mateusalgado/IFSC_ELP2/README.md

# IFSC – Eletrônica de Potência II (EPO II) – 2026-2

Aluno: Mateus Salgado Barboza Costa · Prof. Joabel Moia · Engenharia Eletrônica, IFSC Florianópolis.

| Pasta | Conteúdo | Entrega |
|---|---|---|
| `00_Disciplina/` | enunciados do projeto semestral e da Tarefa Extra (os slides das aulas e o plano de ensino ficam só na cópia local, fora do git) | — |
| `Tarefa_01_Calculo_Termico_Dissipador/` | Buck: perdas, cálculo térmico e escolha de dissipador (PSIM, SMath, Python) | `RELATORIO_MATEUS_SALGADO_TAREFA1.pdf` |
| `Tarefa_02_Projeto_Conversor_Estatico/` | Buck: metodologia da Aula 03, escolha de semicondutores e capacitor, perdas | `RELATORIO_MATEUS_SALGADO_TAREFA2.pdf` |
| `Tarefa_03_Projeto_Indutor_Alta_Frequencia/` | indutor toroidal de alta frequência (SMath, planilha Magnetics) | `RELATORIO_MATEUS_SALGADO_TAREFA3.pdf` |
| `Projeto_Flyback/` | **Projeto semestral (Tema II):** fonte flyback 12 V / 3 A, entrada universal, UC3845 — cálculos, simulação LTspice, esquemático e placa KiCad, BOM, relatório, apresentação, guia de montagem e protótipo (Possibilidade II). Revisão B vigente; revisão A completa em `revisoes/RevA_2026-10-19/` | `06_Relatorio/RELATORIO_MATEUS_SALGADO_PROJETO.pdf`, `07_Apresentacao/APRESENTACAO_MATEUS_SALGADO_PROJETO.pdf` |

Índice detalhado do projeto, resultados e comandos de regeneração: [`Projeto_Flyback/README.md`](Projeto_Flyback/README.md).

Os resultados brutos do LTspice (`.raw`, 11 GB) não ficam no repositório: estão em `C:\Users\mateu\ELP2_sim_runs` e são regenerados por `Projeto_Flyback/03_Simulacao/executa_b.py`.
