mateusalgado/IFSC_ELP2/Projeto_Flyback/06_Relatorio/tabelas/criterios.md

| Critério | Resultado | Situação |
|---|---|---|
| Vo em ±5 % (11,4–12,6 V) para 90–264 VAC e 10–100 % de carga [S] | 12,06 – 12,06 V | atende |
| Ondulação ≤ 120 mV p-p: de chaveamento e excursão total em ciclos da rede [S] | ≤ 4,8 mV / ≤ 8,5 mV | atende |
| Vds máx ≤ 520 V (80 % de 650 V) em regime, 264 VAC [S] | 482 V (Llk 2 %) / 497 V (Llk 3 %); sem grampo 854 V | atende |
| Vds máx em falha (curto) – margem específica: ≤ 600 V (92 % de 650 V, pulso) [S] | 560 V na aplicação, 423 V sustentado | atende |
| Ip ≤ limite do Rsense (2,6–2,9 A) em regime [S] | 2,06 A em 90 VAC | atende |
| Δ teoria × simulação ≤ 10 % nos esforços (critério estrito) [C×S] | 23 de 48 comparações fora de ±10 % — Is,pk: 5 pontos (10/100 % de carga), -24 a +10 %; Is,rms: 12 pontos (10/50/100 % de carga), -16 a -10 %; Vds: 6 pontos (10/50 % de carga), -21 a -11 %. I<sub>p</sub> dentro de 10 % em todos os pontos | atende com ressalva (hipóteses do cálculo: triângulo ideal no vale de Vbulk, grampo a 1,8·Vr) |
| Margem de fase ≥ 45° com pós-filtro LC e polo do opto no modelo [C]; degraus sem oscilação [S] | MF = 88° / 86° / 86° / 90° (fc 0,25–1,35 kHz); degraus: desvio ≤ 116 mV, dentro de ±1 %, retorno a ±0,5 % em ≤ 4,4 ms sem oscilação | atende |
| Partida a frio sem sobretensão [S] | Vo máx 12,06 / 12,06 V; VCC mín 8,30 V > 7,6 V | atende |
| Curto sustentado: desligamento por UVLO (hiccup) [C e S] | VCC mín no curto 7,60 V (C: UVLO em 151 ms a 220 V); I(D1) rms sustentado 13,1 A | atende |
| Rendimento em 220 V: meta 85 % / cálculo 83 % [S] | 85,2 % (90 V: 82,6 %) | atende a meta |
