mateusalgado/IFSC_ELP2/Projeto_Flyback/06_Relatorio/tabelas/perdas.md

| Vac | Vbulk mín C (V) | Vbulk mín S (V) | I in,rms C (A) | I in,rms S (A) | P MOSFET C (W) | P MOSFET S (W) | P diodo C (W) | P diodo S (W) | P snubber C (W) | P snubber S (W) | P ponte C (W) | P ponte S (W) | η C (%) | η S (%) |
|---|---|---|---|---|---|---|---|---|---|---|---|---|---|---|
| 90 | 104,1 | 103,9 | 0,89 | 0,81 | 0,98 | 0,48 | 1,78 | 1,72 | 2,02 | 1,54 | 0,67 | 0,63 | 81,9 | 82,6 |
| 127 | 161,9 | 163,0 | 0,70 | 0,63 | 0,98 | 0,50 | 1,78 | 1,72 | 2,02 | 1,47 | 0,45 | 0,42 | 83,0 | 84,7 |
| 220 | 299,1 | 298,8 | 0,48 | 0,43 | 1,15 | 0,76 | 1,78 | 1,72 | 2,02 | 1,33 | 0,24 | 0,24 | 83,0 | 85,2 |
| 264 | 362,7 | 361,9 | 0,43 | 0,39 | 1,15 | 0,95 | 1,78 | 1,72 | 2,02 | 1,27 | 0,20 | 0,20 | 82,7 | 84,6 |
