mateusalgado/IFSC_ELP2/Projeto_Flyback/06_Relatorio/tabelas/transitorios.md

| Caso (S) | Resultado |
|---|---|
| Partida a frio em 90 VAC, plena carga (C1 e C5 descarregados, fase da rede do cruzamento do UVLO) | pré-carga até 8,4 V em 7,34 s com V<sub>bulk</sub> = 126 V; VCC mínimo após o UVLO 8,30 V; V<sub>o</sub> ≥ 11,4 V em 5,3 ms; V<sub>o</sub> máx 12,06 V; I<sub>p</sub> máx 3,10 A; V<sub>ds</sub> máx 274 V |
| Partida a frio em 264 VAC, plena carga | pré-carga até 8,4 V em 1,05 s com V<sub>bulk</sub> = 371 V; VCC mínimo após o UVLO 8,32 V; V<sub>o</sub> ≥ 11,4 V em 4,3 ms; V<sub>o</sub> máx 12,06 V; I<sub>p</sub> máx 3,47 A; V<sub>ds</sub> máx 515 V |
| Degraus 50 → 100 % (80 ms) e 100 → 50 % (100 ms) em 90 VAC | subida: 12,06 → mín 11,95 V (-114 mV), não sai de ±1 %, volta a ±0,5 % em 4,4 ms; descida: máx 12,16 V (+115 mV), não sai de ±1 %, volta a ±0,5 % em 3,8 ms; V<sub>o</sub> na janela 80–120 ms: 11,95–12,16 V; I<sub>p</sub> máx 2,06 A |
| Degraus 50 → 100 % e 100 → 50 % em 264 VAC | subida: 12,06 → mín 11,95 V (-113 mV), não sai de ±1 %, volta a ±0,5 % em 4,4 ms; descida: máx 12,16 V (+116 mV), não sai de ±1 %, volta a ±0,5 % em 3,9 ms; V<sub>o</sub> na janela 80–120 ms: 11,95–12,16 V; I<sub>p</sub> máx 2,07 A |
| Degraus em 90 VAC com CTR = 0,5 (pior opto) | subida: 12,07 → mín 11,87 V (-199 mV), retorno a ±1 % em 4,1 ms (±0,5 % em 8,0 ms); descida: máx 12,24 V (+202 mV), retorno a ±1 % em 3,5 ms (±0,5 % em 8,0 ms); V<sub>o</sub> na janela 80–120 ms: 11,87–12,24 V; I<sub>p</sub> máx 2,06 A |
| Tolerância do barramento: C1 = 120 µF (−20 %) em 90 VAC/50 Hz, plena carga | V<sub>bulk</sub> mín 99,7 V; V<sub>o</sub> 12,06 V; I<sub>p</sub> máx 2,06 A; η 82,6 % |
| Sem grampo RCD, 264 VAC, plena carga | V<sub>ds</sub> máx 854 V; V<sub>rev</sub> D1 86 V; P snubber 0,00 W; I<sub>p</sub> 2,05 A |
| L<sub>lk</sub> = 3 % de L<sub>p</sub> (projeto 2 %), 264 VAC, plena carga | V<sub>ds</sub> máx 497 V; V<sub>rev</sub> D1 89 V; P snubber 1,64 W; I<sub>p</sub> 2,09 A |
