mateusalgado/IFSC_ELP2/Projeto_Flyback/revisoes/RevA_2026-10-19/06_Relatorio/tabelas/criterios.md

| Critério | Resultado | Situação |
|---|---|---|
| Vo em ±5 % (11,4–12,6 V) para 90–264 VAC e 10–100 % de carga | 12,07 – 12,08 V | atende |
| Ondulação de saída ≤ 120 mV p-p | ≤ 4,0 mV (após o pós-filtro LC) | atende |
| Vds máx ≤ 80 % de 650 V (520 V) em 264 VAC | 482 V (Llk 2 %) / 496 V (Llk 3 %) ; sem snubber 828 V | atende (snubber obrigatório) |
| Ip ≤ limite do Rsense (2,7–3,0 A) | 2,07 A em 90 VAC | atende |
| Δ teoria × simulação < 10 % nos esforços | Ip −3,5 %, Is,pk +5,7 %, Is,rms −10,3 %, Vds −5 a −6 % | atende (Is,rms no limite: forma de onda em MCD com patamar de grampo) |
| Margem de fase ≥ 45° (degrau de carga sem oscilação) | MF = 99° (teoria); degraus 50↔100 % sem oscilação, ΔVo < 15 mV | atende |
| Partida sem sobretensão em 90 e 264 VAC | Vo máx 12,06 / 12,06 V | atende |
| Curto-circuito limitado pelo Rsense | Ip 4,28 A transitório, hiccup; Is,rms 17,5 A no diodo (limitação a documentar) | atende com ressalva |
| Rendimento ≥ 85 % (meta) / 82 % (hipótese de cálculo) | sim.: 83,3 % (90 V) a 85,5 % (220 V); teoria 81,9–83,0 % | atende a hipótese; meta de 85 % só em 127–264 V |
