mateusalgado/IFSC_ELP2/Projeto_Flyback/revisoes/RevA_2026-10-19/06_Relatorio/tabelas/perdas.md

| Vac | Vbulk mín teoria (V) | Vbulk mín sim (V) | I in,rms teoria (A) | I in,rms sim (A) | P MOSFET teoria (W) | P MOSFET sim (W) | P diodo teoria (W) | P diodo sim (W) | P snubber teoria (W) | P snubber sim (W) | P ponte teoria (W) | P ponte sim (W) | η teoria (%) | η sim (%) |
|---|---|---|---|---|---|---|---|---|---|---|---|---|---|---|
| 90 | 94,6 | 95,6 | 0,86 | 0,80 | 1,04 | 0,38 | 1,78 | 1,72 | 2,01 | 1,49 | 0,69 | 0,65 | 81,9 | 83,3 |
| 127 | 155,2 | 158,7 | 0,68 | 0,63 | 1,04 | 0,44 | 1,78 | 1,72 | 2,01 | 1,43 | 0,45 | 0,43 | 82,9 | 85,2 |
| 220 | 295,4 | 296,6 | 0,47 | 0,44 | 1,15 | 0,72 | 1,78 | 1,72 | 2,01 | 1,29 | 0,24 | 0,24 | 83,0 | 85,5 |
| 264 | 359,6 | 360,3 | 0,42 | 0,39 | 1,15 | 0,92 | 1,78 | 1,72 | 2,01 | 1,24 | 0,20 | 0,20 | 82,7 | 84,8 |
