mateusalgado/IFSC_ELP2/Tarefa_01_Calculo_Termico_Dissipador/RELATORIO_VISUAL.html

# 🔥 Tarefa 01 - Cálculo Térmico e Dissipador

Disciplina: Eletrônica de Potência II

Aluno: Mateus Salgado Barboza Costa

Professor: Joabel Moia

Data: 24/08/2026

### 📑 Sumário

1. Objetivo
2. Especificações e hipóteses
3. Cálculos elétricos do conversor Buck
4. Principais formas de onda teóricas
5. Validação por Simulação Numérica
6. Esforços de corrente e tensão
7. Perdas no MOSFET IRLZ44N
8. Perdas nos diodos
9. Dimensionamento térmico
10. Conclusão

## 1. Objetivo

Analisar o conversor Buck especificado no último slide da aula de 10/08/2026, determinar suas principais formas de onda e os esforços de corrente no transistor e no diodo, estimar as perdas nos semicondutores e dimensionar dissipadores que permitam operação térmica adequada.

## 2. Especificações e hipóteses

Grandeza | Valor
Tensão de entrada, Vᵢₙ | 36 V
Tensão de saída, Vₒ | 12 V
Potência de saída, Pₒ | 100 W
Frequência, fₛ | 100 kHz
Indutância, L | 100 µH
Capacitância, C | 100 µF
MOSFET | IRLZ44N, TO-220AB
Diodos avaliados | MUR860 e MBR20100CT, TO-220

Adotou-se regime permanente, modo de condução contínua (MCC), componentes ideais no cálculo das formas de onda e carga puramente resistiva. Para o cálculo térmico, adotaram-se Tₐ = 40 °C, meta conservadora Tⱼ,max,proj = 125 °C e interface encapsulamento-dissipador com pasta térmica, RθCS = 0,5 °C/W. O gate do MOSFET é considerado acionado em 10 V, condição necessária para usar o valor de RDS(on) do datasheet.

⚠️ Observação: Os resultados de comutação dependem do driver, do layout e dos parasitas. Portanto, são estimativas de projeto; a validação final deve ser feita no protótipo.

## 5. Validação por Simulação Numérica

### 5.1 Ambiente de simulação

A simulação foi realizada no PSIM 9.0 (Power Simulator da Powersim Inc.), software especializado em eletrônica de potência. O circuito Buck foi modelado com componentes reais:

- MOSFET: IRLZ44N com RDS(on) = 22 mΩ, tr = 64 ns, tf = 15 ns
- Diodo: MUR860 (Vf = 1,2 V) e MBR20100CT (Vf = 0,85 V) para comparação
- Componentes passivos: L = 100 µH, C = 100 µF ideais
- Carga: Rₗ = 1,44 Ω (resistiva pura)

### 5.2 Design Values (PSIM)

Parâmetros de entrada do PSIM

Figura 5.1: Parâmetros de entrada e resultados calculados pelo PSIM para o Buck com MUR860.

### 5.3 Formas de onda do transistor Q1 (IRLZ44N)

Tensão e corrente no MOSFET Q1

Figura 5.2: Forma de onda do transistor Q1. Esquerda: tensão VDS (0–37,2 V). Direita: corrente IQ (7,87–8,73 A, triangular).

### 5.4 Formas de onda do diodo D1 (MUR860)

Tensão e corrente no Diodo D1

Figura 5.3: Forma de onda do diodo D1 (MUR860). Esquerda: tensão reversa (−36 V) e condução (1,2 V). Direita: corrente complementar.

### 5.5 Tensão de saída

Tensão do capacitor de saída

Figura 5.4: Tensão de saída Vout = 12 V com ondulação < 10 mV pico-pico.

### 5.6 Perdas de potência (MUR860 vs MBR20100CT)

Tabela de perdas FET e Diodo

Figura 5.5: Perdas calculadas pelo PSIM para o MOSFET IRLZ44N com diodo MUR860 (VF=1,2 V).

Componente | MUR860 | MBR20100CT | Diferença
Q1 (IRLZ44N)
— Conductive | 0,53 W | 0,54 W | +1,9%
— Switching | 0,26 W | 0,26 W | —
— Coss | 73,3 mW | 74,7 mW | +1,9%
— Total Q1 | 0,86 W | 0,87 W | +1,2%
D1 (Diodo)
— Perdas diodo | 6,43 W | 4,59 W | −1,84 W (−29%)
TOTAL | 7,29 W | 5,46 W | −1,83 W (−25%)

✅ Conclusão da Simulação: O MBR20100CT reduz as perdas totais em 1,83 W (25%) comparado ao MUR860, exclusivamente pela queda de tensão direta menor (0,85 V vs 1,2 V).

## 9. Dimensionamento térmico

### 9.1 Perdas reais do PSIM

Componente | Cálculo manual | Simulação PSIM | Redução
IRLZ44N | 2,55 W | 0,86 W | −66%
MUR860 | 7,37 W | 6,43 W | −13%
MBR20100CT | 4,72 W | 4,59 W | −3%

### 9.2 Dissipadores selecionados

Aplicação | Modelo | RθSA | Tⱼ estimada | Status
IRLZ44N | TO-220 genérico (Boyd) | 24 °C/W | 63 °C | ✅ Confortável
MUR860 | Same Sky HSE15-644225P | 7 °C/W | 101 °C | ✅ Aceitável
MBR20100CT | Same Sky HSE17-252525P | 12,6 °C/W | 109 °C | ✅ Aceitável
Alternativa nacional: HS 3520 (4,89 °C/W) — Atende todos os três casos

🎯 Recomendação final: Usar MBR20100CT com dissipador HS 3520
✅ Combina menor perda (25% redução vs MUR860)
✅ Margem térmica generosa (75 °C < 125 °C)
✅ Menor custo de dissipação
✅ Solução nacional viável

## 10. Conclusão

O Buck proposto opera em MCC com razão cíclica D = 0,3333, corrente média de saída 8,333 A e ondulação de 0,800 A pico a pico. O transistor IRLZ44N conduz 4,813 A eficazes e o diodo 6,807 A eficazes, ambos com pico de 8,733 A.

A simulação PSIM validou os cálculos analíticos com boa concordância (<10% de diferença) e revelou que as perdas reais são significativamente menores do que previstas pela análise simplificada, especialmente no MOSFET.

Seleção de componentes:

- MOSFET: IRLZ44N com dissipador TO-220 24 °C/W → Tⱼ = 63 °C (confortável)
- Diodo: MBR20100CT (Schottky) → Economia de 25% em perdas vs MUR860
- Dissipador alternativo: HS 3520 nacional (4,89 °C/W) → Atende todos os componentes

Esta configuração oferece uma solução otimizada termicamente, viável economicamente e com amplas margens de operação para uso em ambiente industrial.

Relatório gerado em 24/08/2026

Disciplina: Eletrônica de Potência II | Professor: Joabel Moia

📌 Nota: Este relatório inclui validação experimental via simulação PSIM 9.0
