mateusalgado/IFSC_ELP2/00_Disciplina/Aula_02_Perdas_Dissipadores.pdf

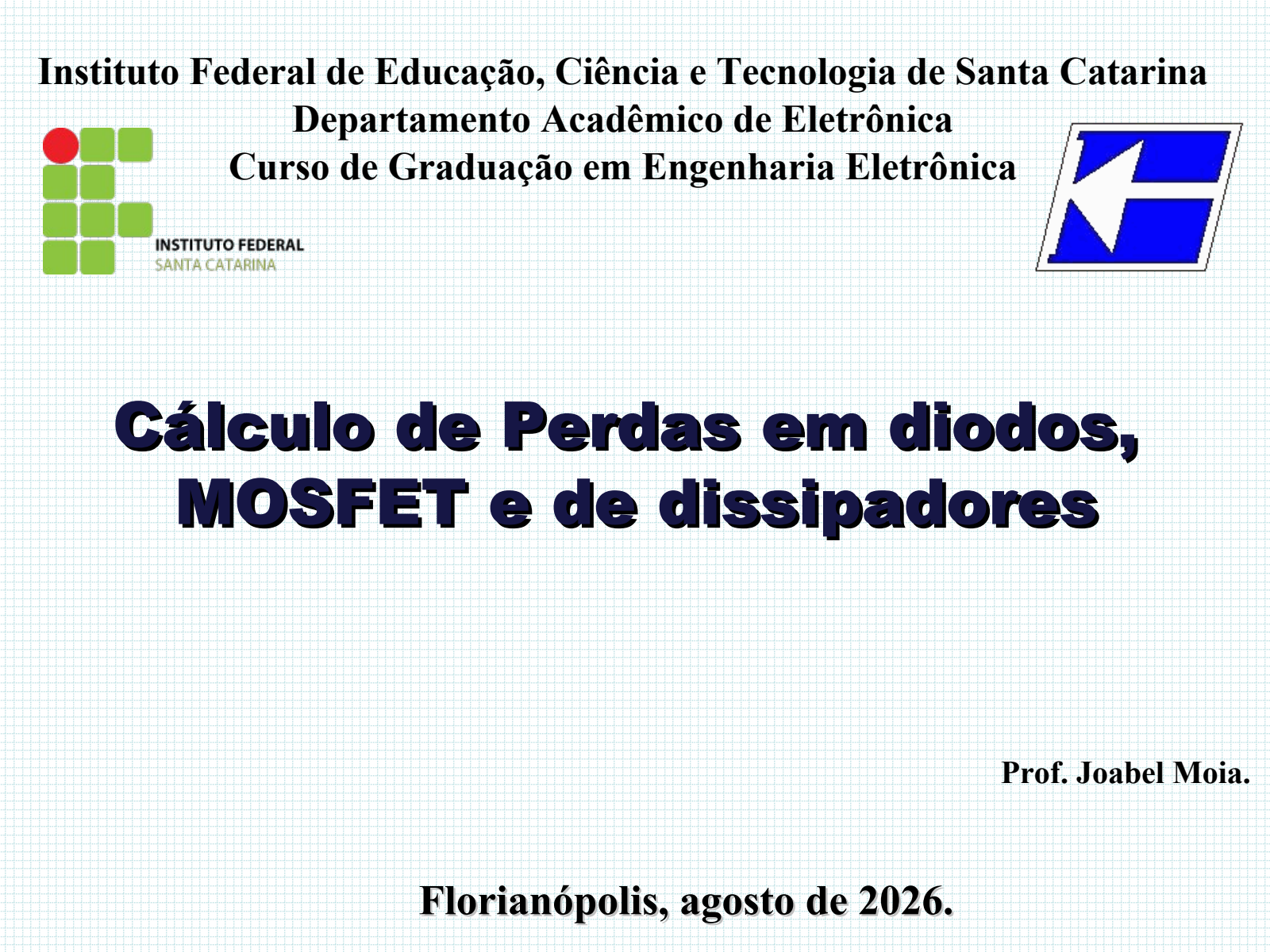
[picture p69: page 1]

Cálculo de Perdas em diodos,

# MOSFET e de dissipadores

### Instituto Federal de Educação, Ciência e Tecnologia de Santa Catarina Departamento Acadêmico de Eletrônica Curso de Graduação em Engenharia Eletrônica

Florianópolis, agosto de 2026.

Prof. Joabel Moia.

## Bibliografia para esta aula

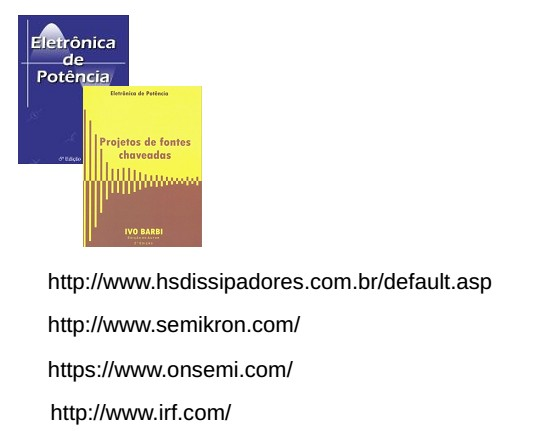
[picture p70: figure]

# Diodo ideal e real

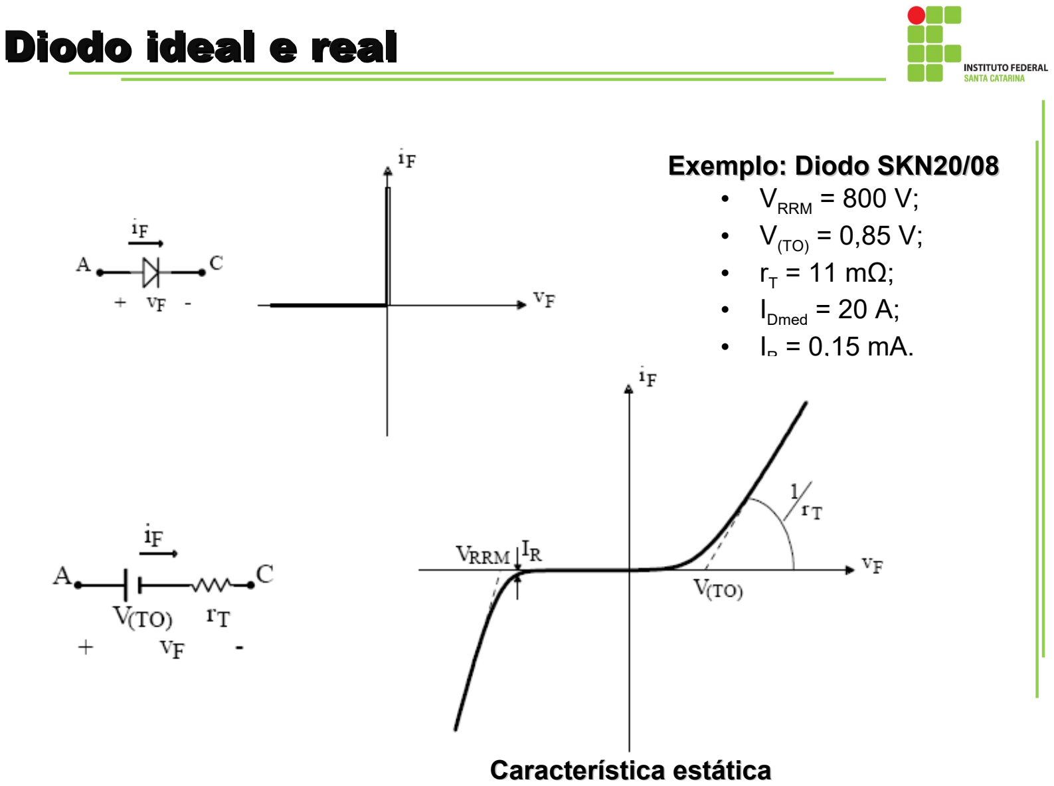
[picture p71: page 3]

Exemplo: Diodo SKN20/08
- VRRM = 800 V;
- V(TO) = 0,85 V;
- rT

= 11 mΩ;
- IDmed = 20 A;
- IR

= 0,15 mA.

Característica estática

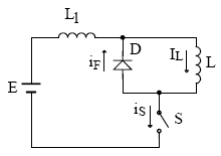
[picture p72: figure]
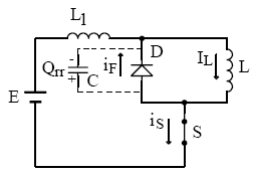
[picture p73: figure]
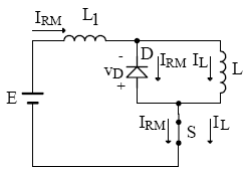
[picture p74: figure]

Primeira etapa de comutação | Segunda etapa de comutação

Circuito para estudo da comutação

Bloqueio

# Diodo real - comutação

Bloqueio

# Diodo real - comutação

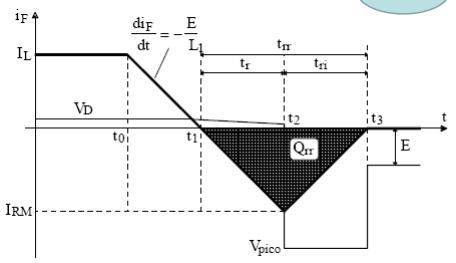
[picture p75: figure]

1

F

di | E
dt | L

= -

No bloqueio do diodo (comutação crítica):

Derivada da corrente depende da indutância

3 rr

rr
F

Q
t
di
dt
æ | | | ö
ç | ÷ ≅
ç | ÷ ç | ÷ è | ø

4
3

F
RM | rr
di I | Q
dt
æ | | ö
≅ ç | ÷ è | ø

Tempo de recuperação reversa

Corrente máxima devido a recuperação reversa

Bloqueio

# Diodo real - comutação

Classificação das perdas:
1.Condução;

2.Comutação:
- Entrada em condução;
- Bloqueio.
2 P V | I | r I = | · | + · ( | ) TO | Dmed | T | Def
P | V | V I t f 1
= | - | · · 0,5( FP | F | o | rf )

### P Q E f 2

= · ·
rr

# Perdas nos diodos

P | V | V I t f 1

# Perdas nos diodos

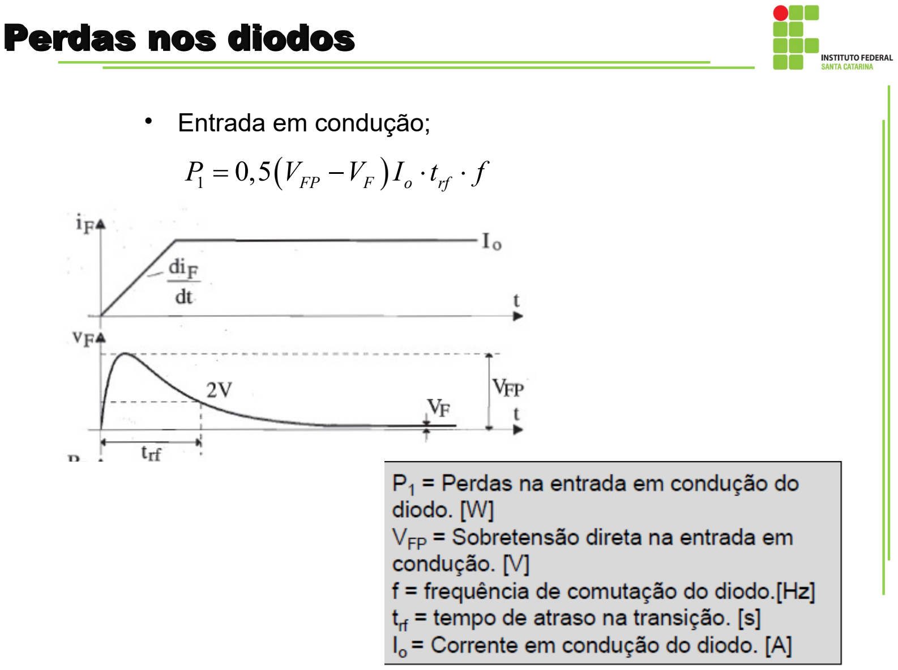
[picture p76: page 8]

- Entrada em condução;
= | - | · · 0,5( FP | F | o | rf )

# Diodo real - comutação

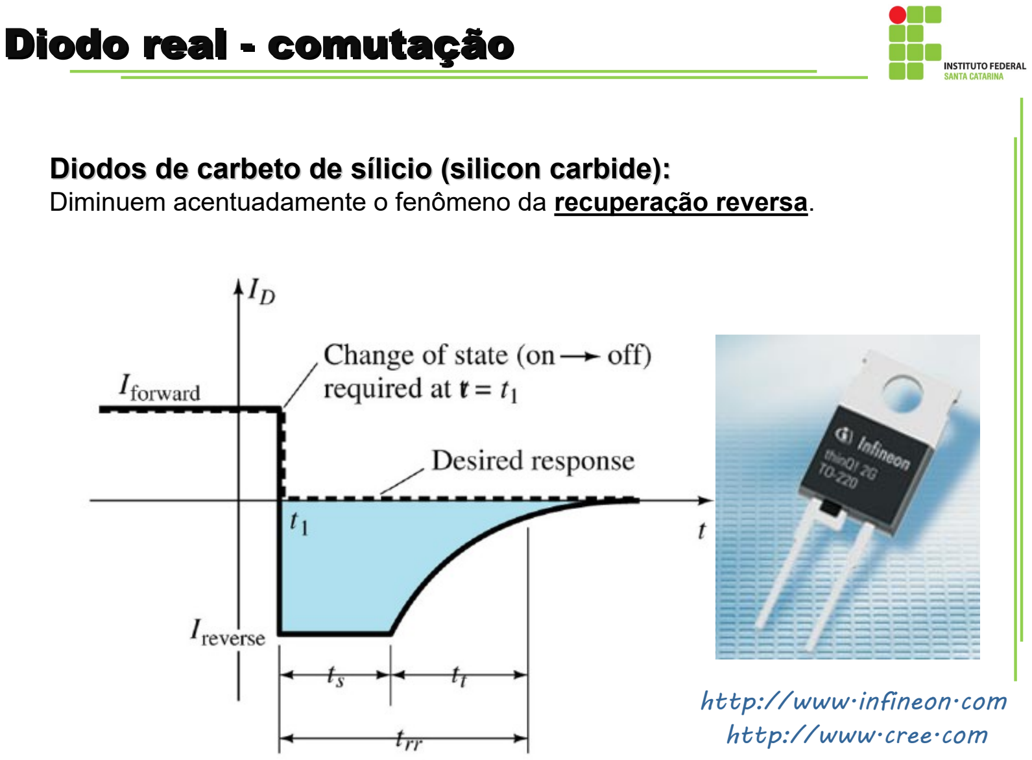
[picture p77: page 9]

Diodos de carbeto de sílicio (silicon carbide):
Diminuem acentuadamente o fenômeno da recuperação reversa.

### http://www.infineon.com http://www.cree.com

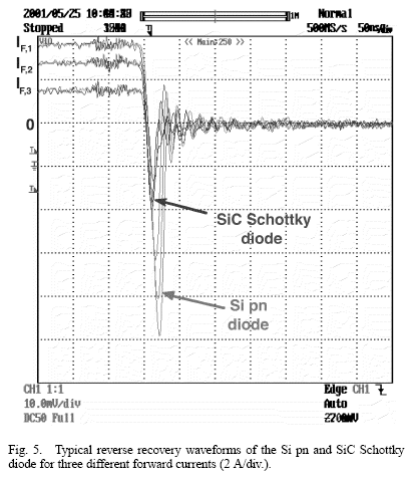
[picture p78: figure]

### http://powerelec.ece.utk.edu/pubs/pels_letters_SiC_june_2003.pdf

# Diodo real - comutação

# Diodo real - comutação

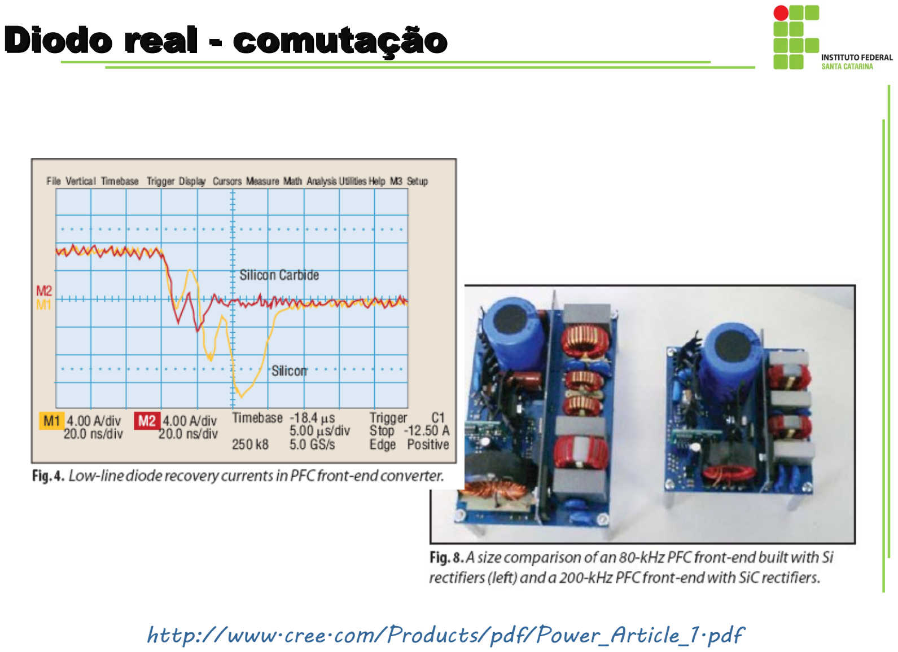
[picture p79: page 11]

### http://www.cree.com/Products/pdf/Power_Article_1.pdf

# Diodo real - comutação

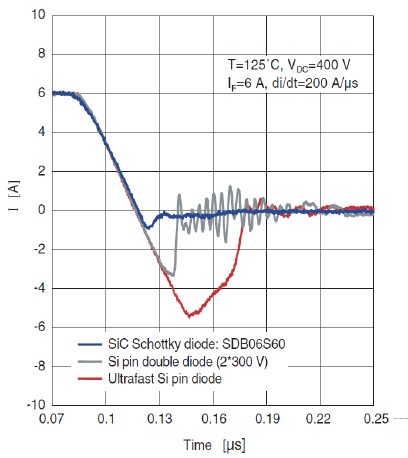
[picture p80: figure]

# Diodos

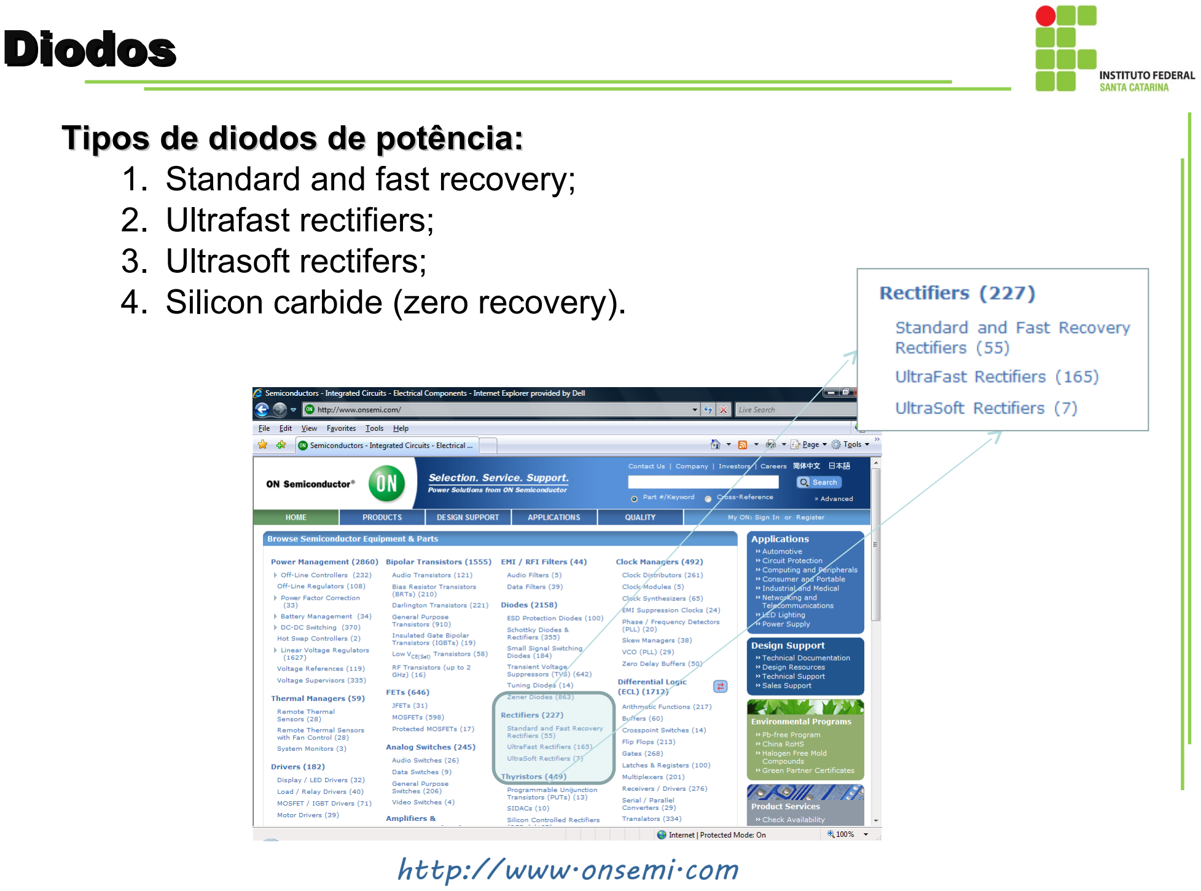
[picture p81: page 13]

Tipos de diodos de potência:
1. Standard and fast recovery;
2. Ultrafast rectifiers;
3. Ultrasoft rectifers;
4. Silicon carbide (zero recovery).

### http://www.onsemi.com

Tipos de diodos de potência:
1. Standard and fast recovery;
2. Ultrafast rectifiers;
3. Ultrasoft rectifers;
4. Silicon carbide (zero recovery).

# Diodos

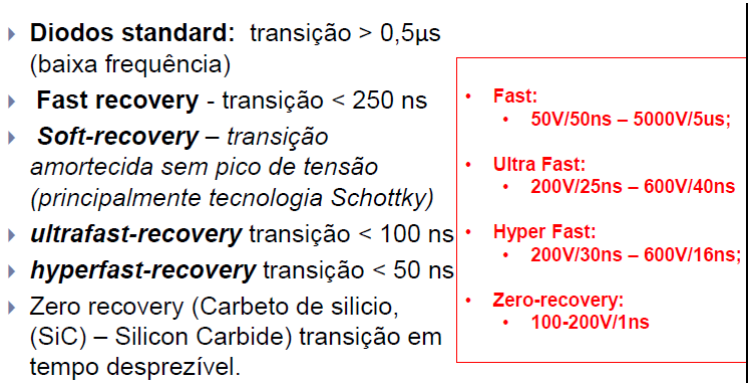
[picture p82: figure]

Perdas Potais do diodo: Perdas por condução + Perda por Comutação:

Devido as perdas na entrada em condução serem muito baixas, são desconsideradas. Assim, tem-se:

Perdas totais do diodo:

### 2 P Q E f 2

= | · ·
rr | P V | I | r I = | · | + · ( | ) TO | Dmed | T | Def

# Perdas nos diodos

+

Alguns diodos por ter baixo tempo de recuperação reversa, são des-consideras as perdas por comutação, caso do diodo Schottky e SiC

# MOSFET de potência

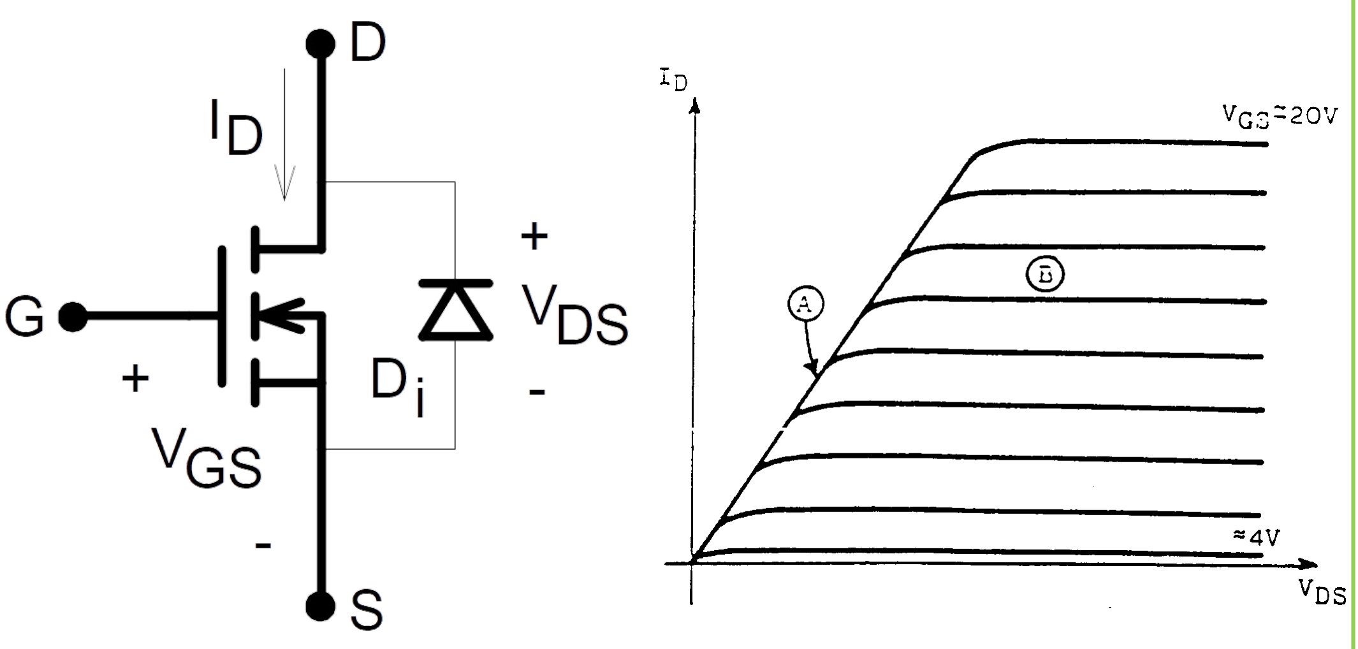
[picture p83: figure]

# MOSFET de potência

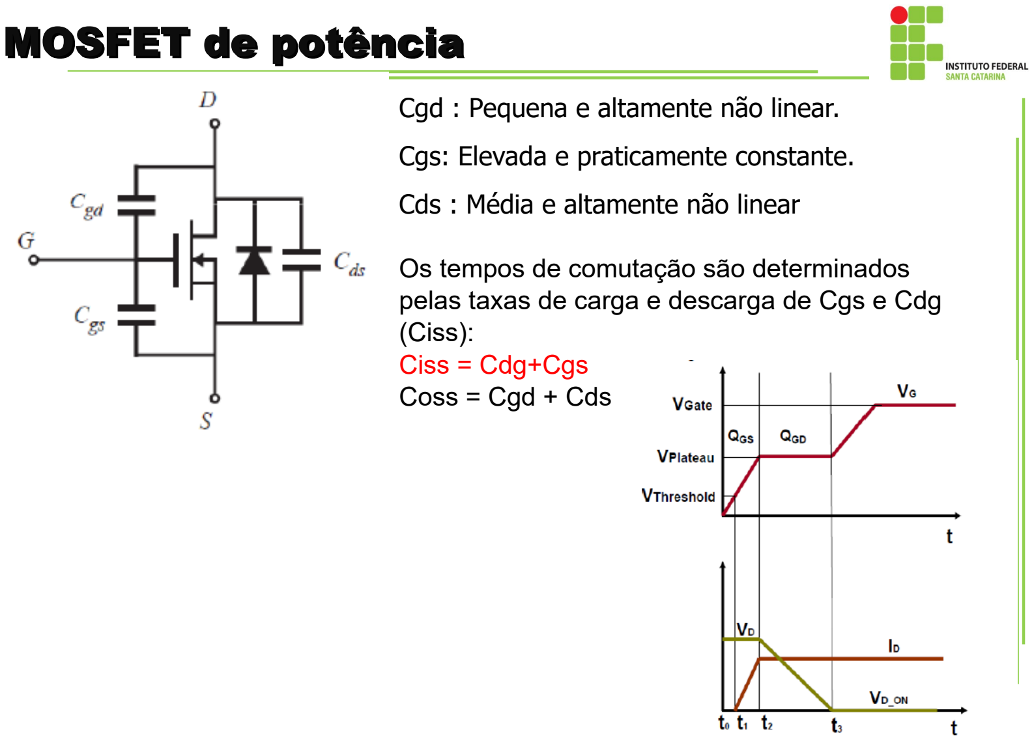
[picture p84: page 17]

Cgd : Pequena e altamente não linear. Cgs: Elevada e praticamente constante.
Cds : Média e altamente não linear

Os tempos de comutação são determinados pelas taxas de carga e descarga de Cgs e Cdg (Ciss):
Ciss = Cdg+Cgs
Coss = Cgd + Cds

Classificação das perdas:
1. Condução;
1. Comutação:
- Entrada em condução e bloqueio;
- Onde:
2 | 2
( ) | ( ) | ( ) | ( ) _

on
cond | ds on | d on | ds on | d on rms

t
P | r | i | r | i
T
= | · | · | = | ·
( | ) ( ) | ( | ) 2
com | r | f | d on | ds off

f
P | t t | i | v = | + | · | ·
f | on
r | off
t | t
t | t

≅
≅

# MOSFET de potência

# MOSFET de potência

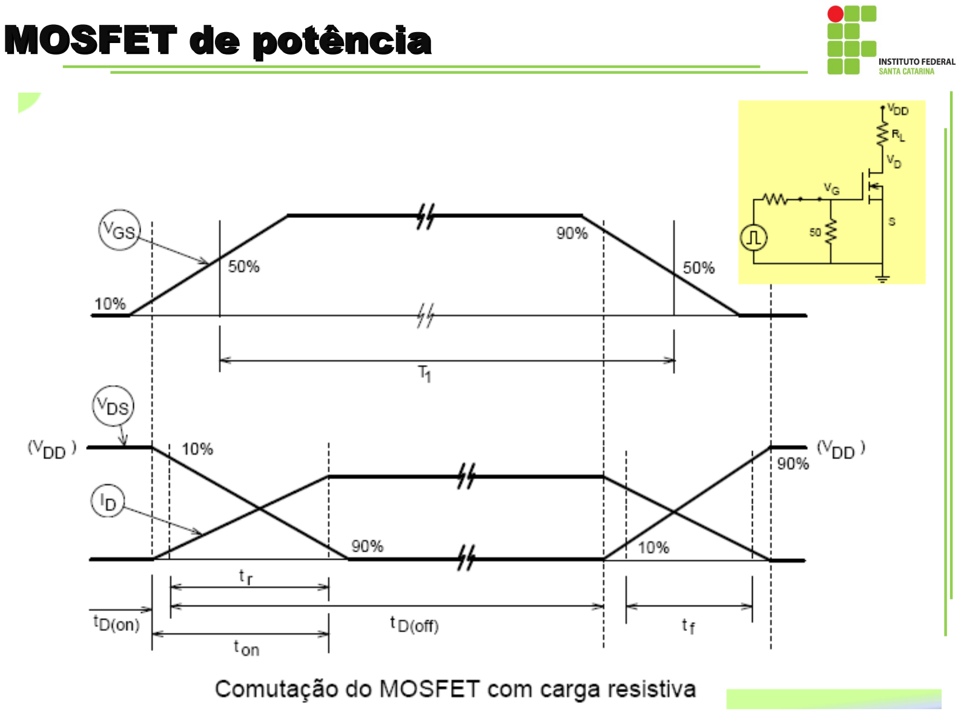
[picture p85: page 19]

## Perdas em MOSFET

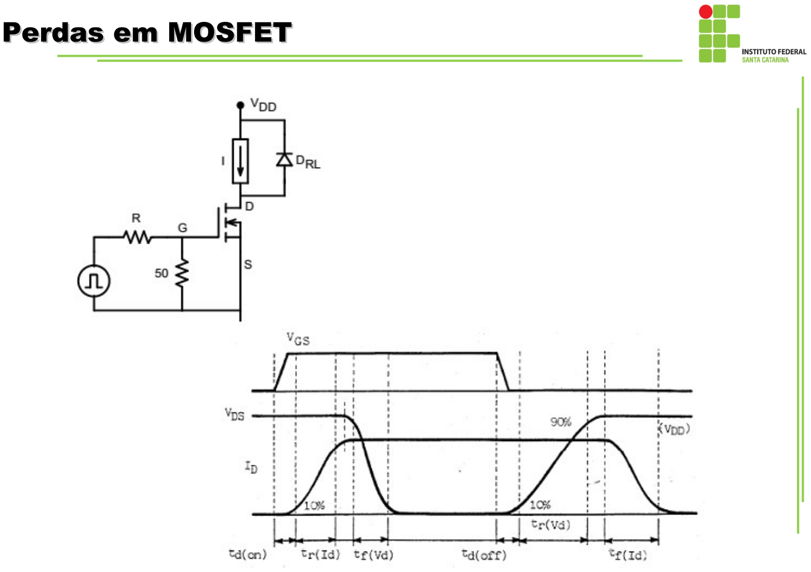
[picture p86: page 20]

## Perdas em MOSFET

## Transistor Mosfet / IGBT – Características dinâmicas Carga indutiva

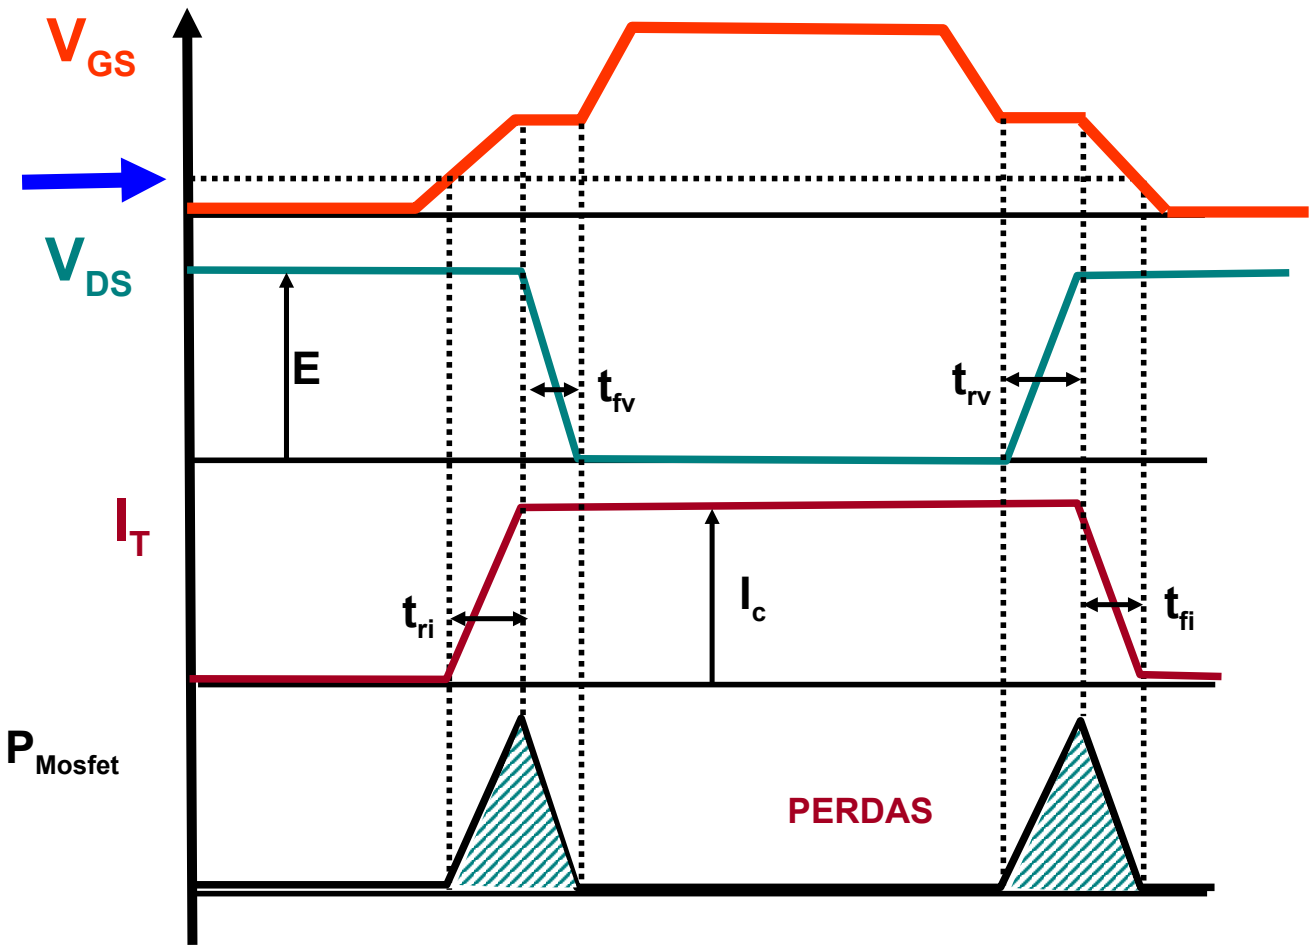
[picture p87: figure]
PERDAS; VDS; VGS; PMosfet; tri

VGS(th)

## Perdas em IGBT – Caso Real

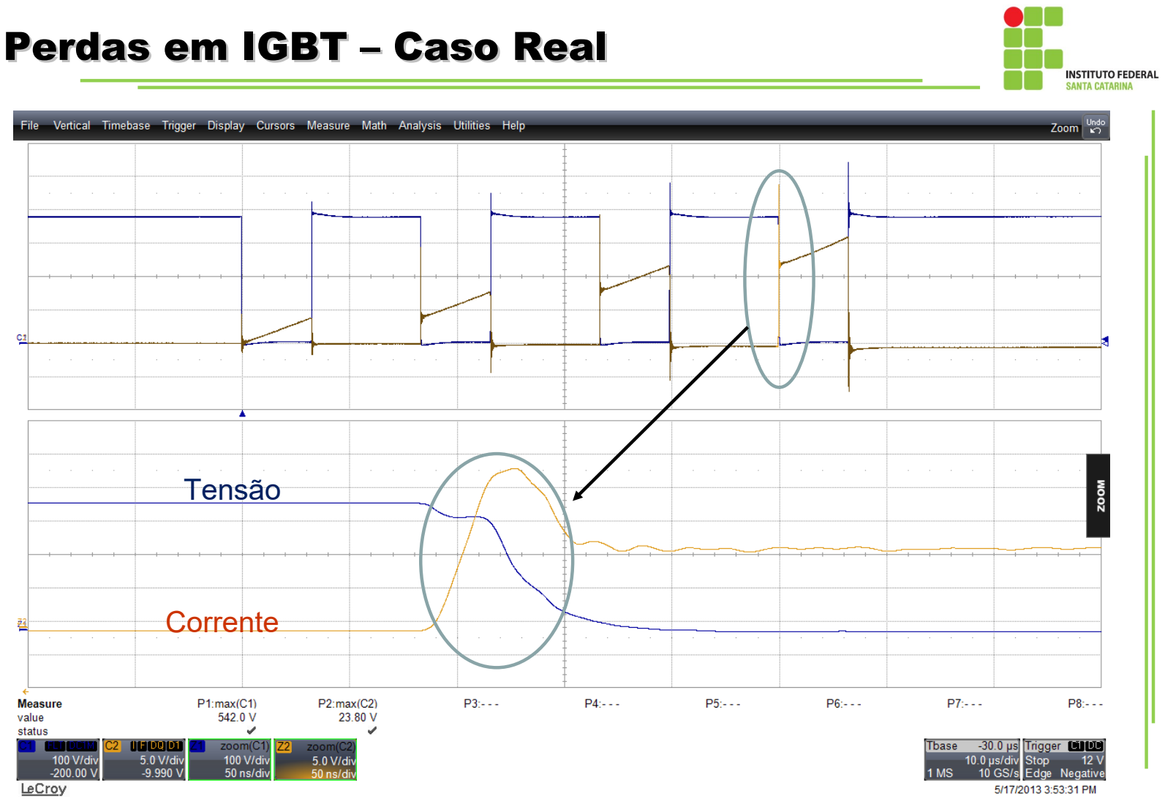
[picture p88: page 22]

Tensão

Corrente

## Perdas em MOSFET

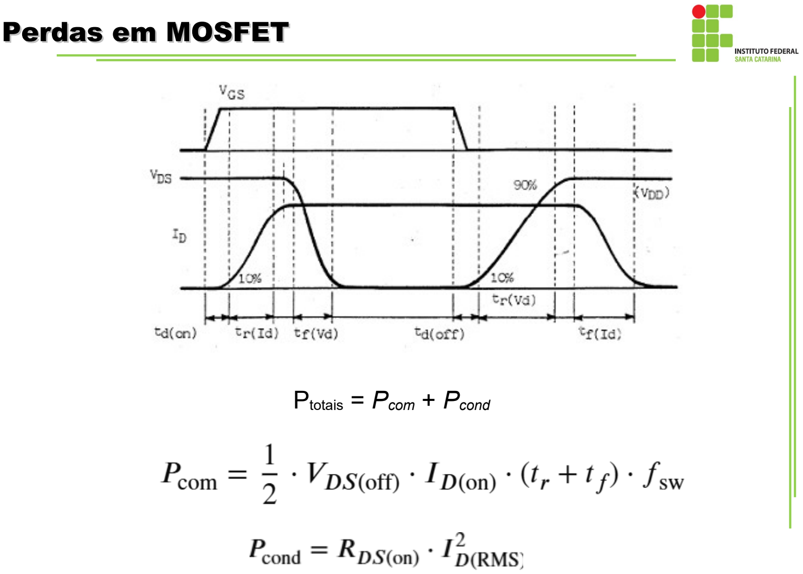
[picture p89: page 23]

Ptotais = Pcom + Pcond

## Perdas em MOSFET

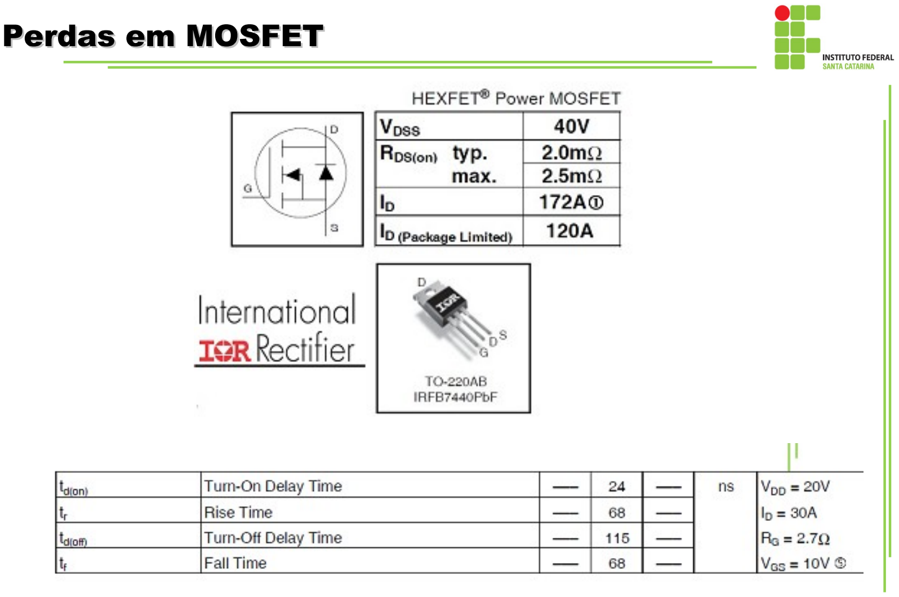
[picture p90: page 24]

## Perdas em MOSFET

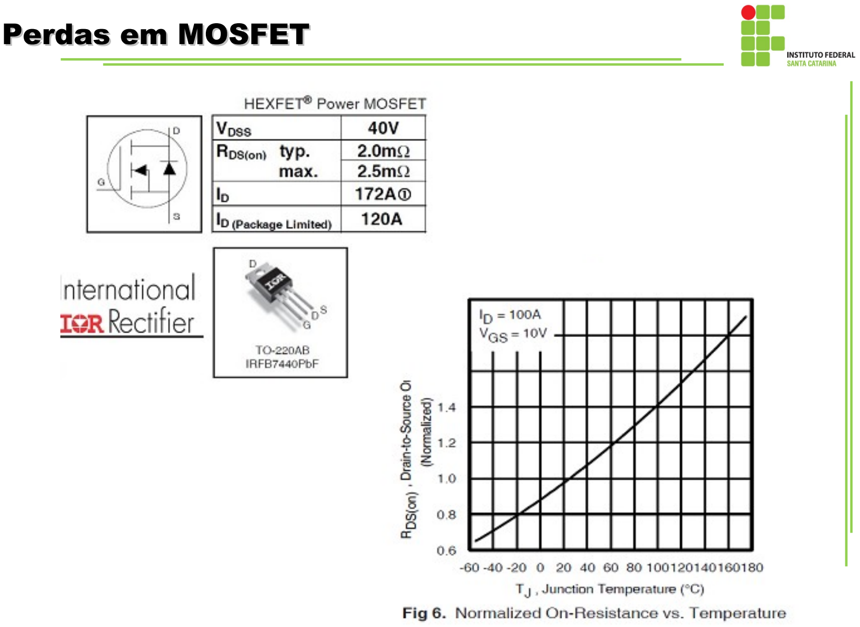
[picture p91: page 25]

## Cálculo Térmico

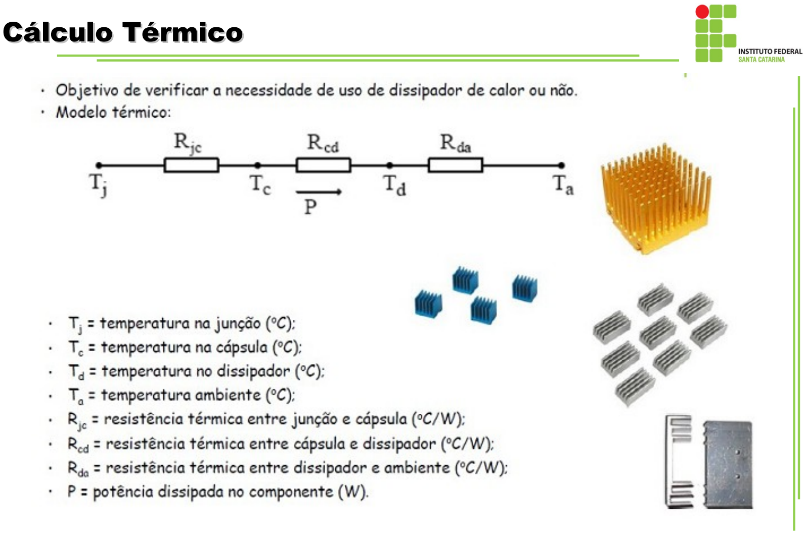
[picture p92: page 26]

## Cálculo Térmico

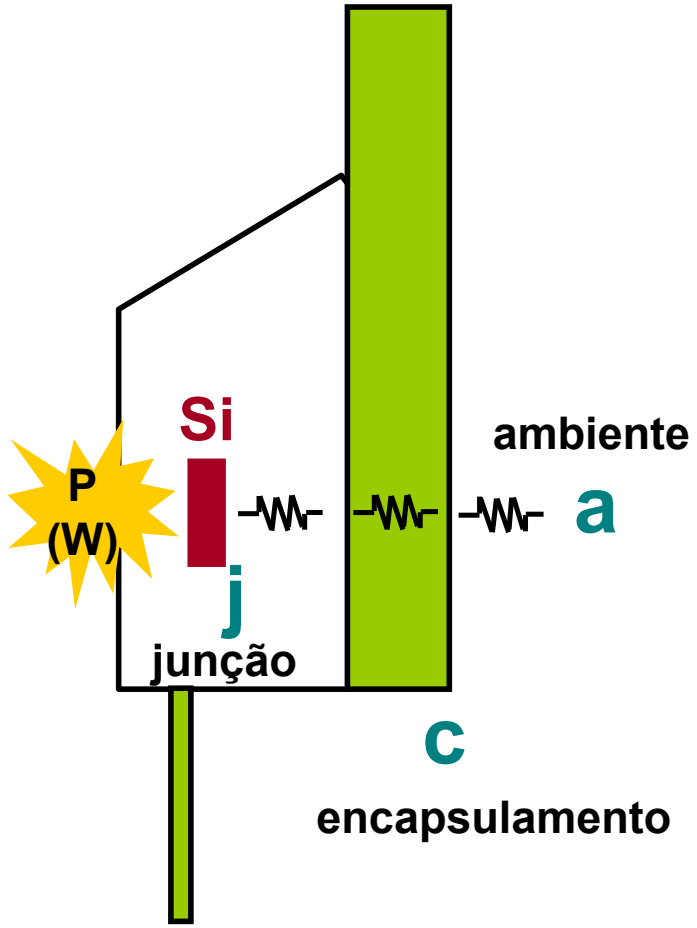
[picture p93: figure]
ambiente; junção; encapsulamento
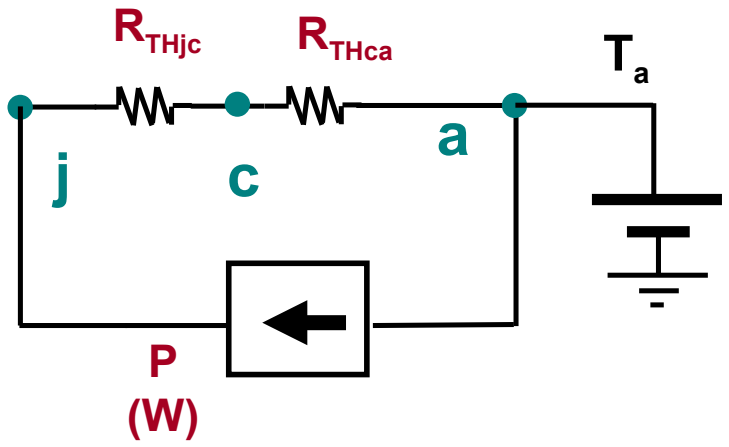
[picture p94: figure]
RTHjc; RTHca

Tensões = Temperaturas
Corrente = Perdas (W)

## Dissipação de calor

Ta

: Temperatura ambiente

## Cálculo Térmico

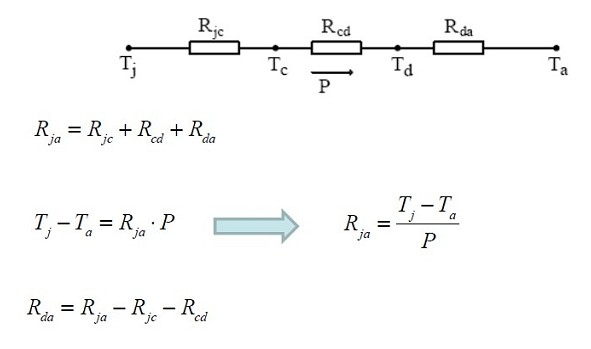
[picture p95: figure]

## Cálculo Térmico

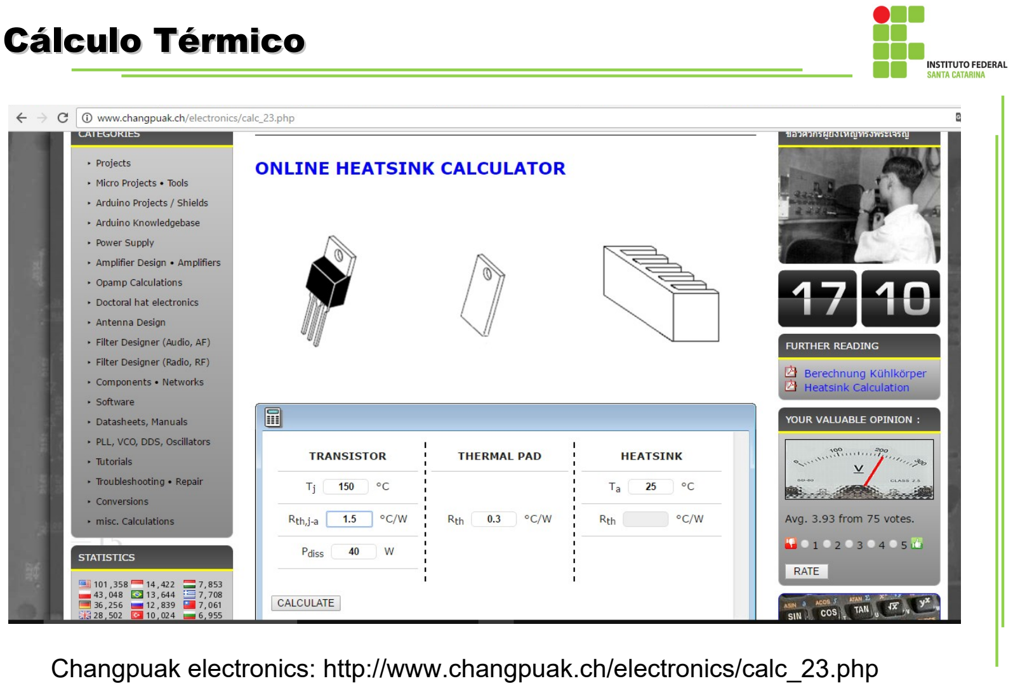
[picture p96: page 29]

Changpuak electronics: http://www.changpuak.ch/electronics/calc_23.php

## Cálculo Térmico

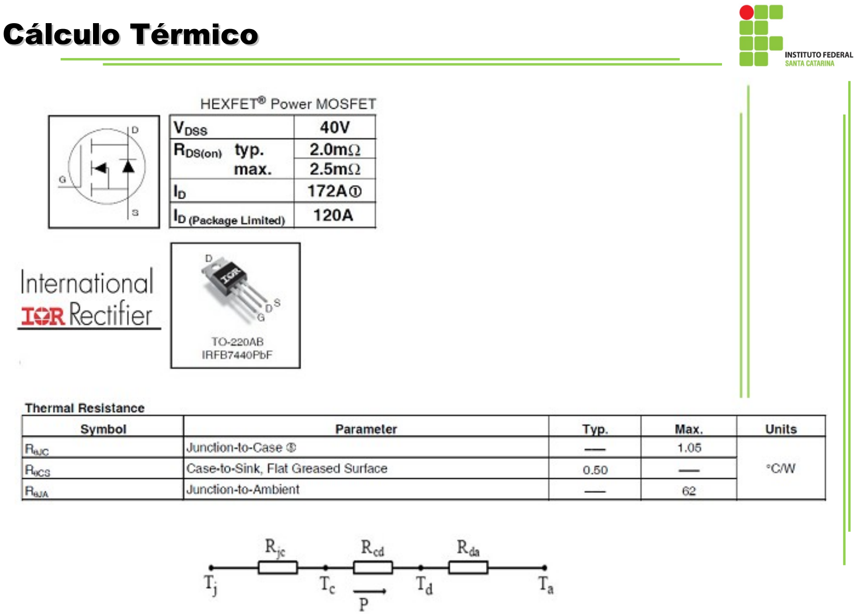
[picture p97: page 30]

## Cálculo Térmico

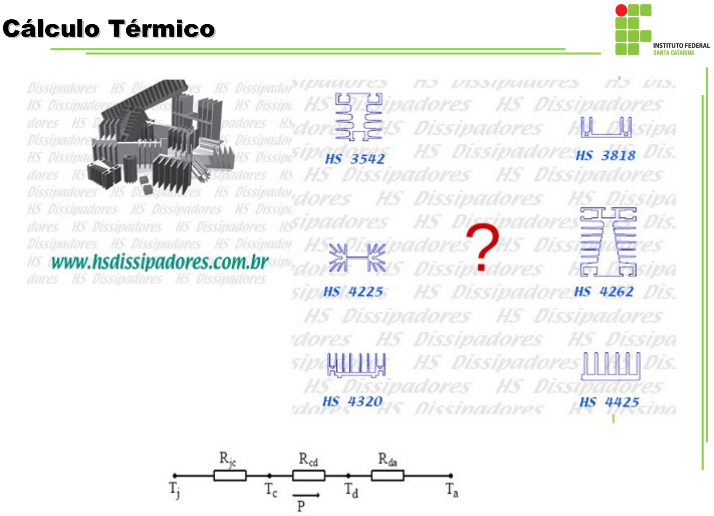
[picture p98: page 31]

## Cálculo Térmico

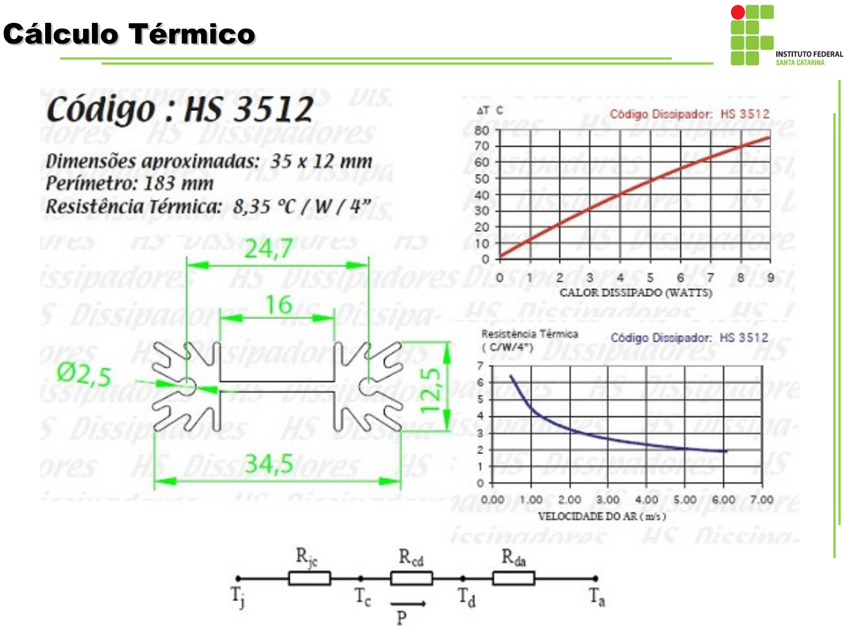
[picture p99: page 32]

## Cálculo Térmico

Para melhorar a capacidade de evacuação de calor é possível utilizar ventilação forçada. Isto permite reduzir a resistência térmica.

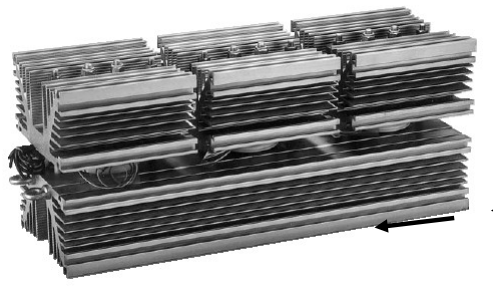
[picture p100: figure]

Atenção a direção do fluxo de ar

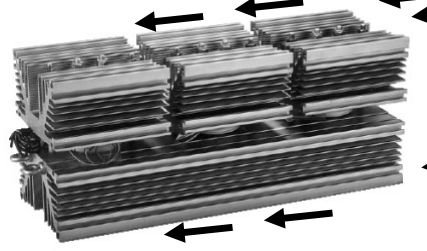
[picture p101: figure]

CORRETO

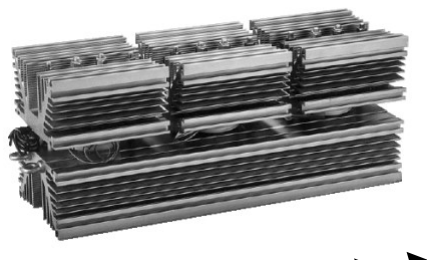
[picture p102: figure]

INCORRECTO

## Fatores que afetam a Rth

## Cálculo Térmico

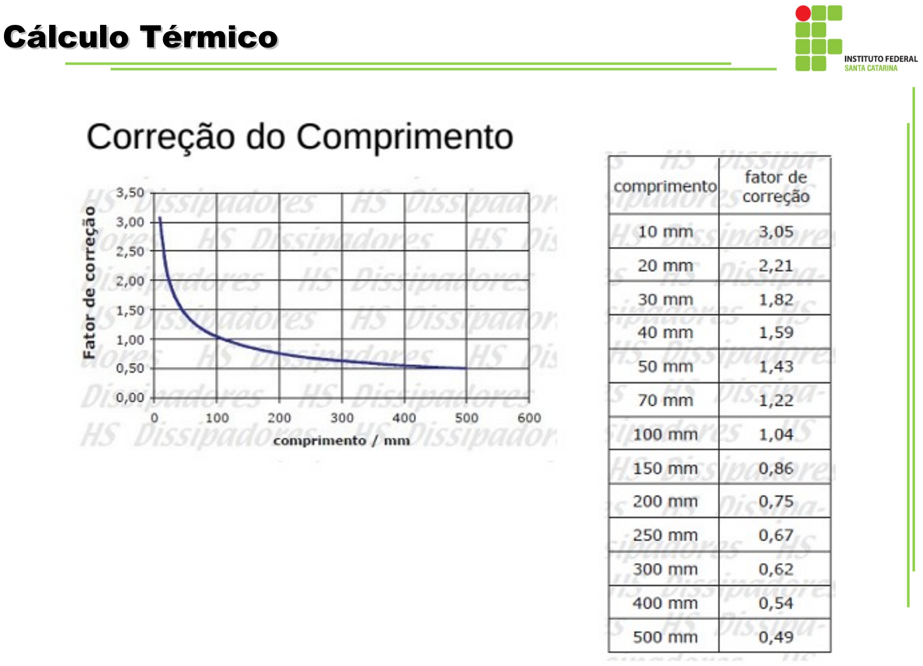
[picture p103: page 34]

## Cálculo Térmico

Nos semicondutores, a parte metálica costuma ser o catodo ou o dreno (coletor) de um transistor MosFet (IGBT).
Se o semicondutor é montado diretamente sobre o radiador, o mesmo se encontra conectado ao mesmo potencial do dispositivo.

400 V

400 V

Isolante elétrico, mas condutor térmico

400 V

## Montagem do dispositivo sobre o radiador

## Cálculo Térmico

Um parafuso metálico é um conexão elétrica e acaba com o isolamento.
Utilizam-se arruelas de plástico para evitar o contato elétrico.

## Montagem do dispositivo sobre o radiador

## Cálculo Térmico

A RTH fornecida pelo fabricante é válida para radiador montado na posição vertical. Na posição horizontal a evacuação do calor fica comprometida. Na posição vertical ocorre o “efeito chaminé” no qual o próprio calor gerado pelo aquecimento do radiador cria uma corrente de ar ascendente que melhora a refrigeração.

## Montagem do radiador

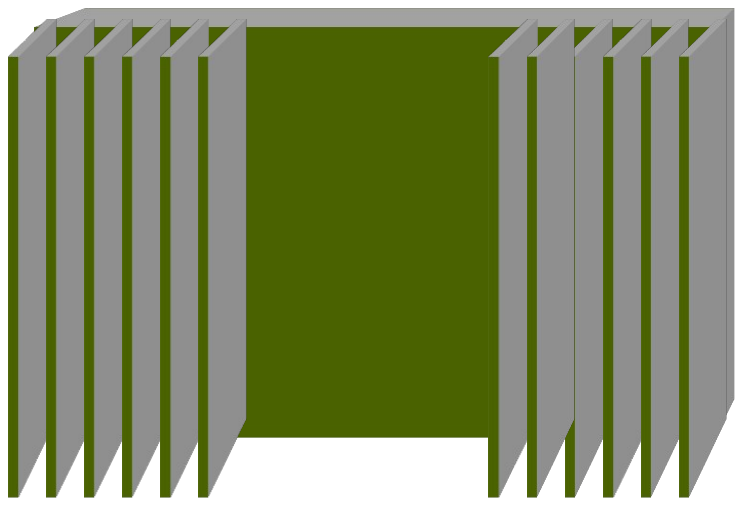
[picture p104: figure]
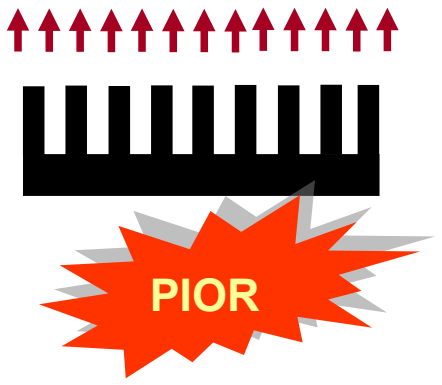
[picture p105: figure]
PIOR

MELHOR

## Cálculo Térmico

## Dimensionamento estático de radiadores

### 1. Podem ser colocados vários dispositivos no mesmo dissipador

2. Centralizar o dispositivo semicondutor no dissipador.

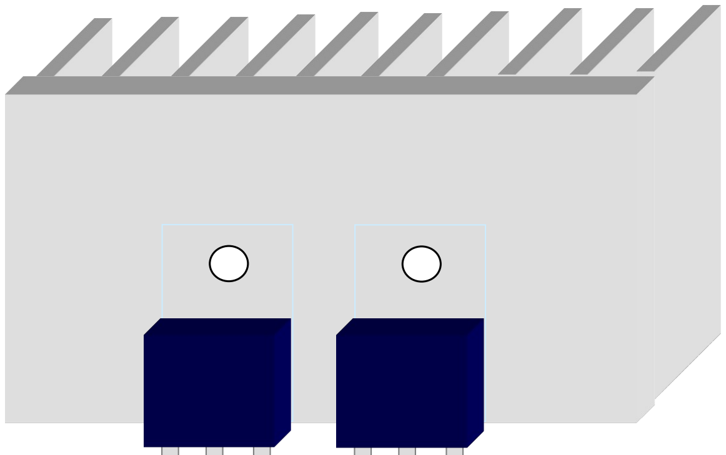
[picture p106: figure]
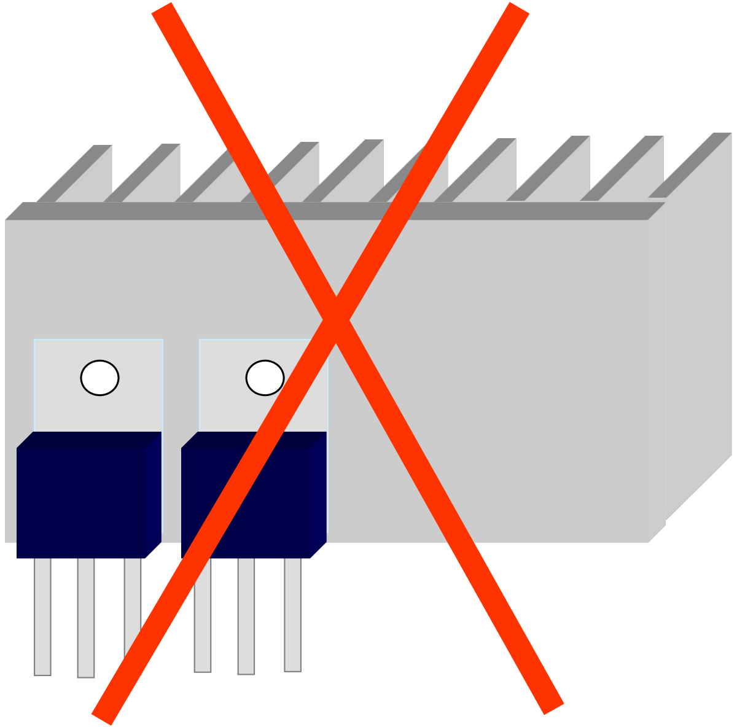
[picture p107: figure]

## Exemplo Dissipação Calor Conversores

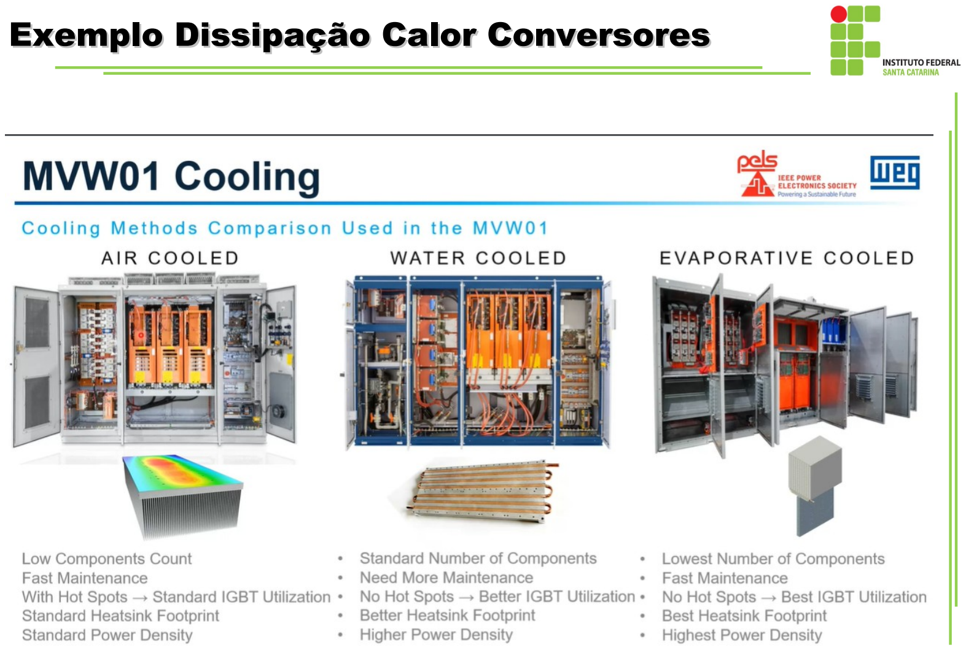
[picture p108: page 39]

## Exemplo Dissipação Calor Conversores

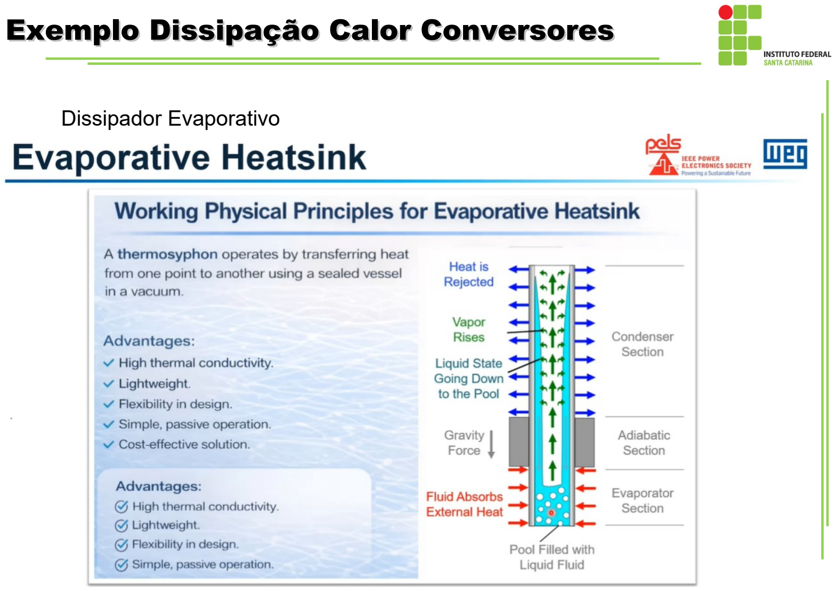
[picture p109: page 40]

Dissipador Evaporativo

## Exemplo Dissipação Calor Conversores

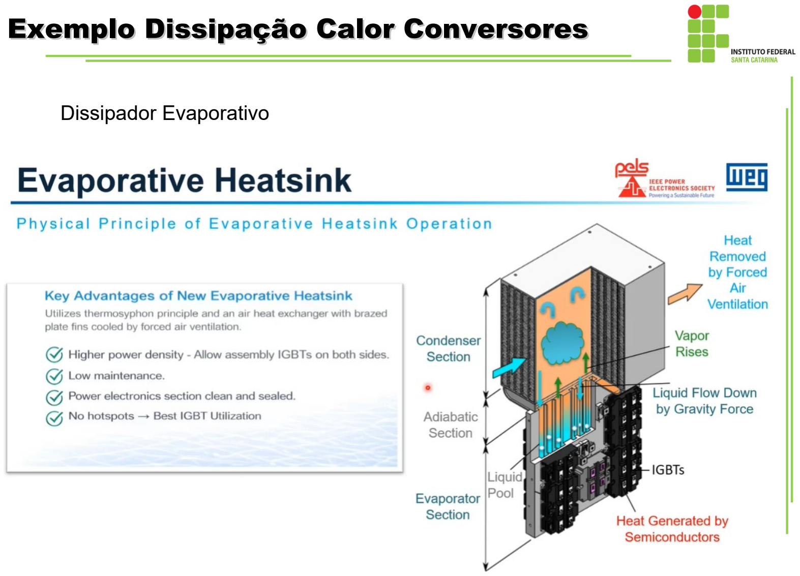
[picture p110: page 41]

Dissipador Evaporativo

## Exemplo Cálculo Térmico

Conversor Boost CC-CC modo de condução Contínua (MCC):

a

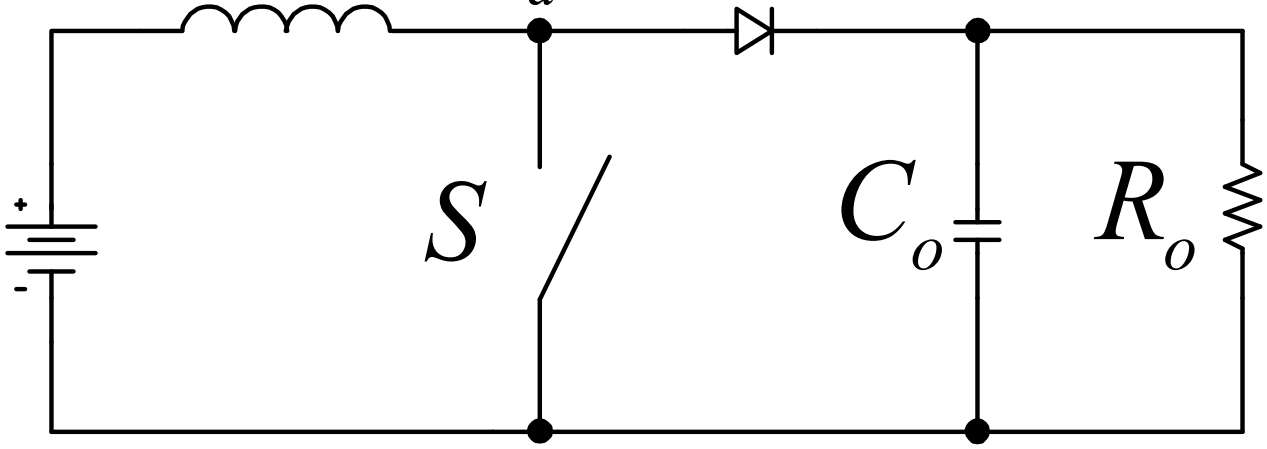
[picture p111: figure]

b

+

Vi

Li

## o Vo

D

Especificação:
- Tensão de Entrada: 25 V;
- Tensão de Saída: 50 V;
- Potência de Saída: 100 W;
- Frequência de Comutação: 20 kHz;
- Indutância de Entrada (Li

): 800 uH;

## Exemplo Cálculo Térmico

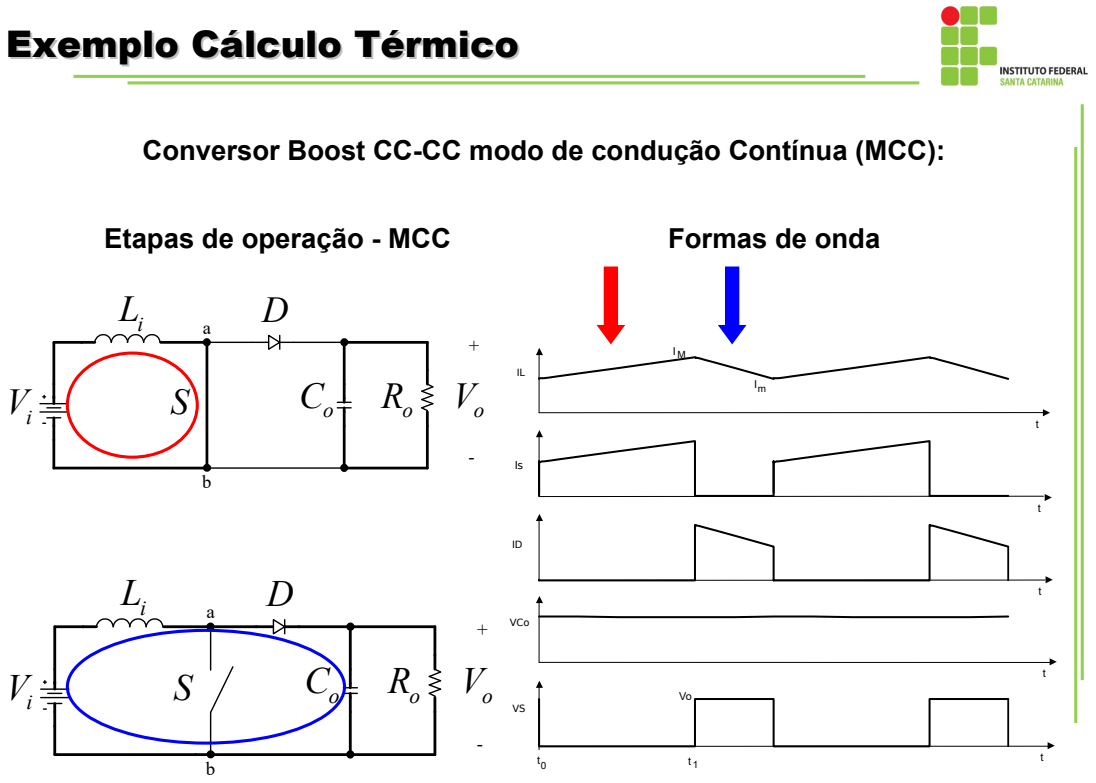
[picture p112: page 43]
Etapas de operação - MCC; Formas de onda; VCo

Conversor Boost CC-CC modo de condução Contínua (MCC):

## Exemplo Cálculo Térmico

Conversor Boost CC-CC modo de condução Contínua (MCC):
Análise das grandezas envolvidas | Tensão média na saída
1 | ( | )
s

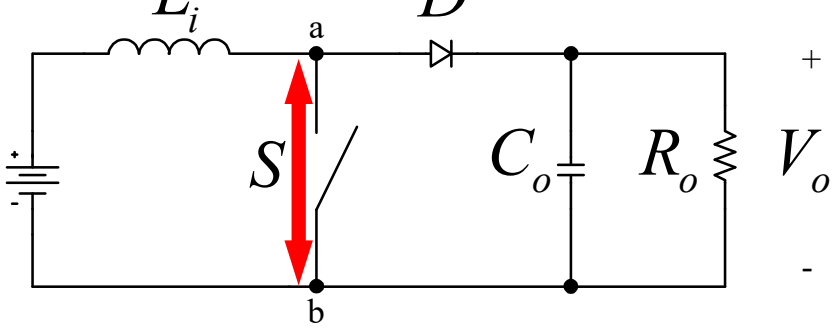
[picture p113: figure]

s

T
s | s
ab | o | o
s | s D T

### T D T

V | | | | | V dt V
T | T ·
- ·
= | · = ò
V | V | D ab | o = | - (1 | )

Vab

Vo

D Ts

- Ts

Vi

Li
D
V | V ab | i =

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
Análise das grandezas envolvidas

Corrente no Indutor

1

in
L

V
i T
L
Δ = | in
L
| V D
i
| L f

·
Δ =
·

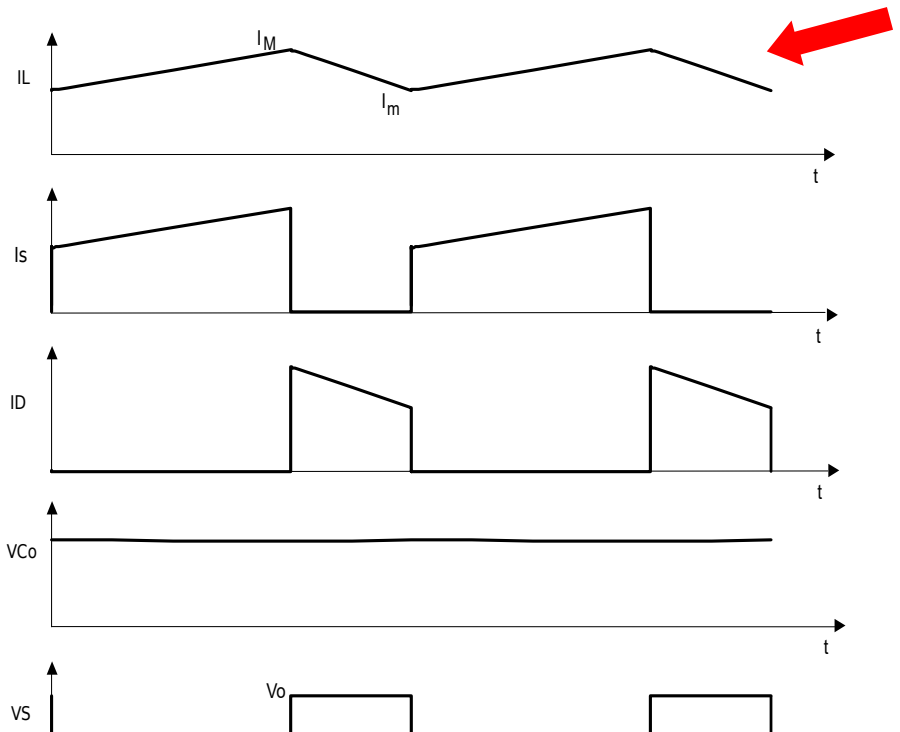
[picture p114: figure]
VCo

t
t | t 0 | 1
( | )
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
R | D
= | ·

## Conversor CC-CC elevador - Boost

Valor Médio da Corrente no Indutor

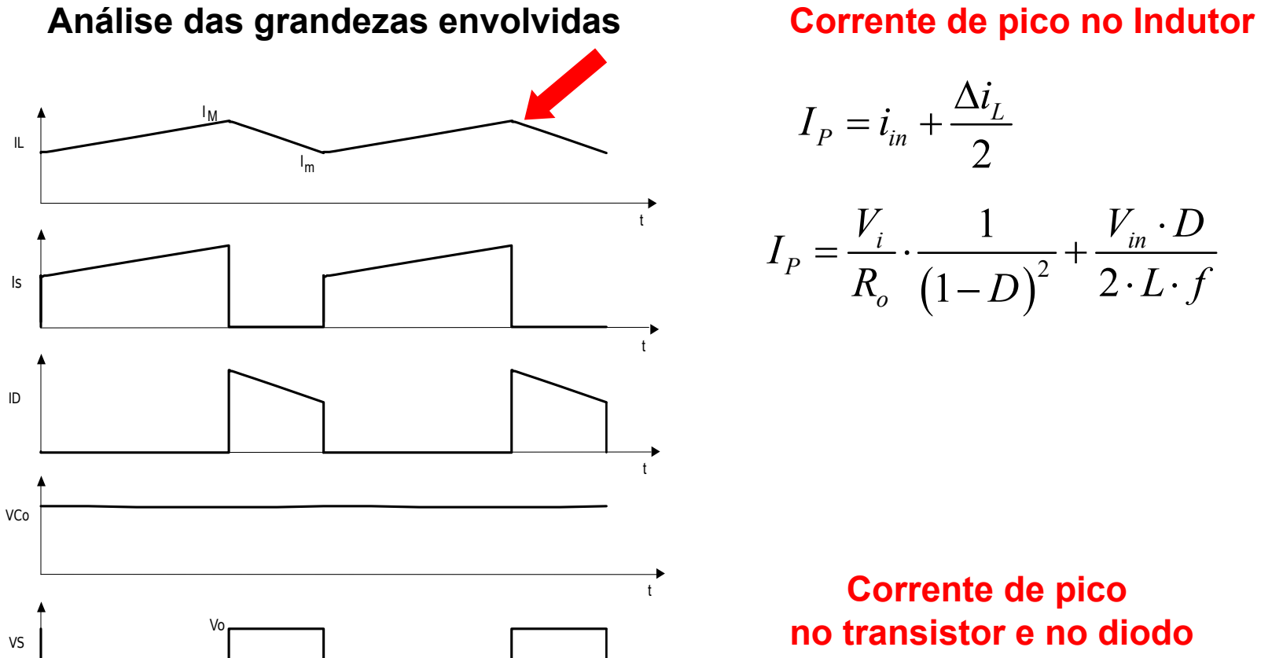
[picture p115: figure]
VCo; Análise das grandezas envolvidas; Corrente de pico no Indutor; Corrente de pico no transistor e no diodo

t
t | t 0 | 1
TP | DP | P

### I = I = I

## Conversor CC-CC elevador - Boost

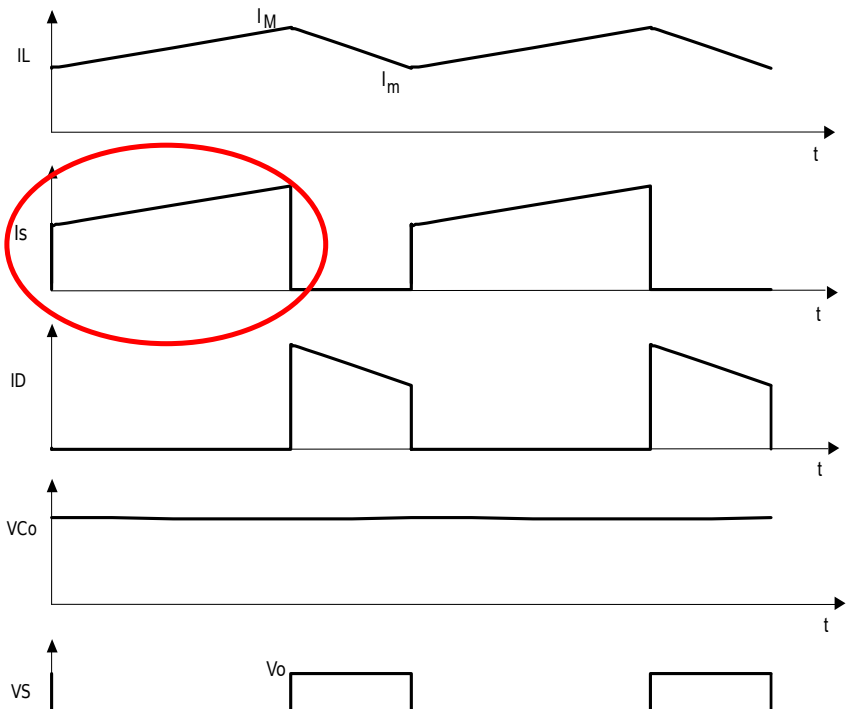
[picture p116: figure]
VCo

t
t | t 0 | 1
Análise das grandezas envolvidas | Correntes no transistor

0

1 D T
Tmd | L I | i dt
T

·
= ò

Corrente média

2
0

1 D T
Tef | L I | i dt
T

·
= ò

Corrente eficaz

Tmd | L I | D I = ·
Tef | L I | D I = | ·

## Conversor CC-CC elevador - Boost

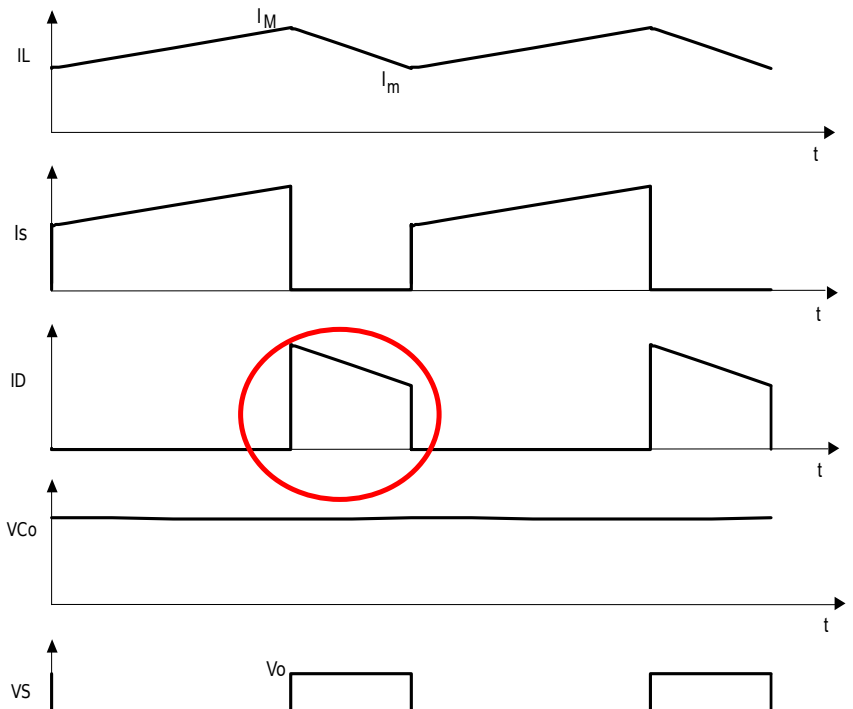
[picture p117: figure]
VCo

t
t | t 0 | 1
Análise das grandezas envolvidas | Correntes no diodo

1 T

Dmd | L D T
I | i dt
T ·

= ò

Corrente média

1 2
T
Def | L D T
I | i dt
T ·

= ò

Corrente eficaz

I | D I Dmd | L = - · (1 | )
1 Def | L I | D I = - ·

## Conversor CC-CC elevador - Boost

Δ = | in

·

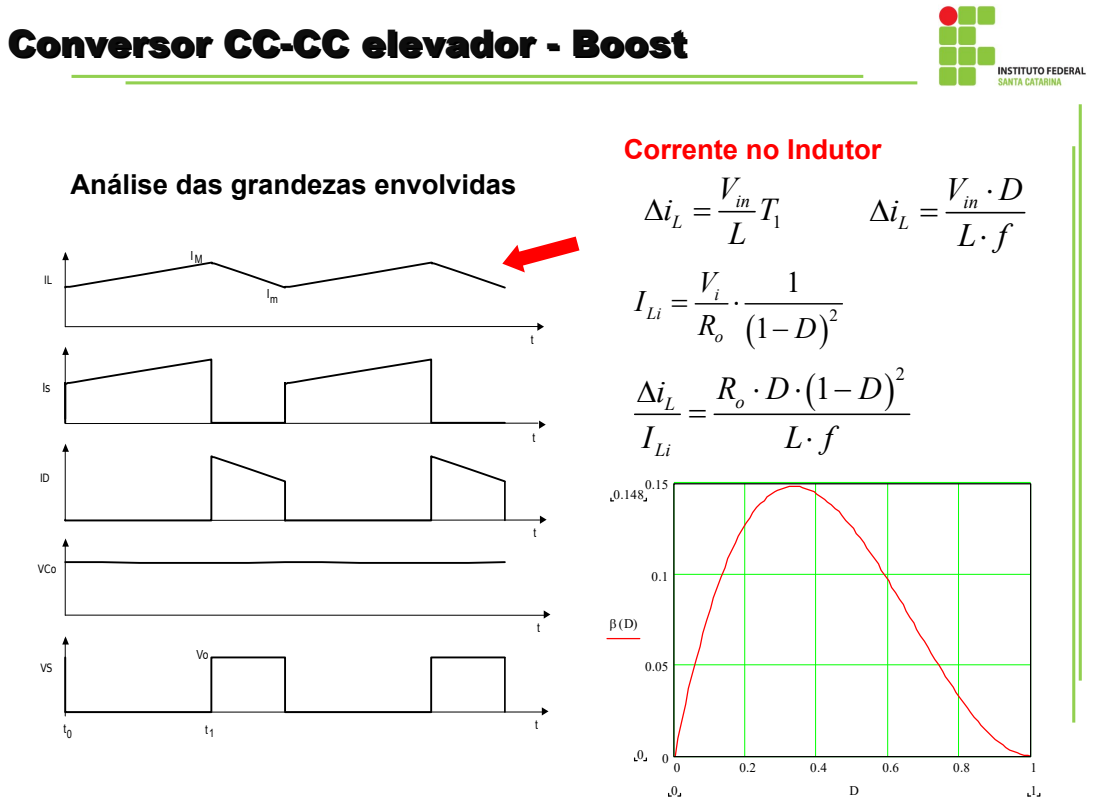
[picture p118: page 49]
Corrente no Indutor; VCo

Conversor CC-CC elevador - Boost

Análise das grandezas envolvidas

Principais formas de onda (circuito simulado):

## Conversor CC-CC elevador - Boost

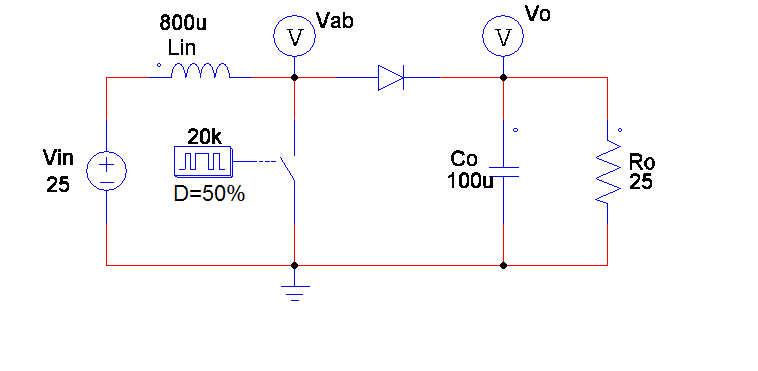
[picture p119: figure]

Principais formas de onda (transitório de partida):

## Conversor CC-CC elevador - Boost

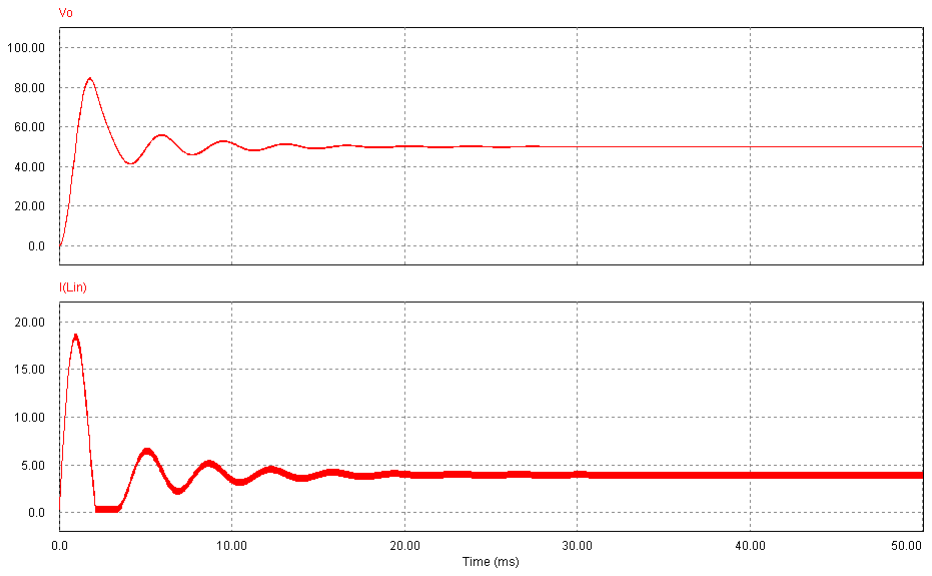
[picture p120: figure]

Principais formas de onda (regime permanente):

## Conversor CC-CC elevador - Boost

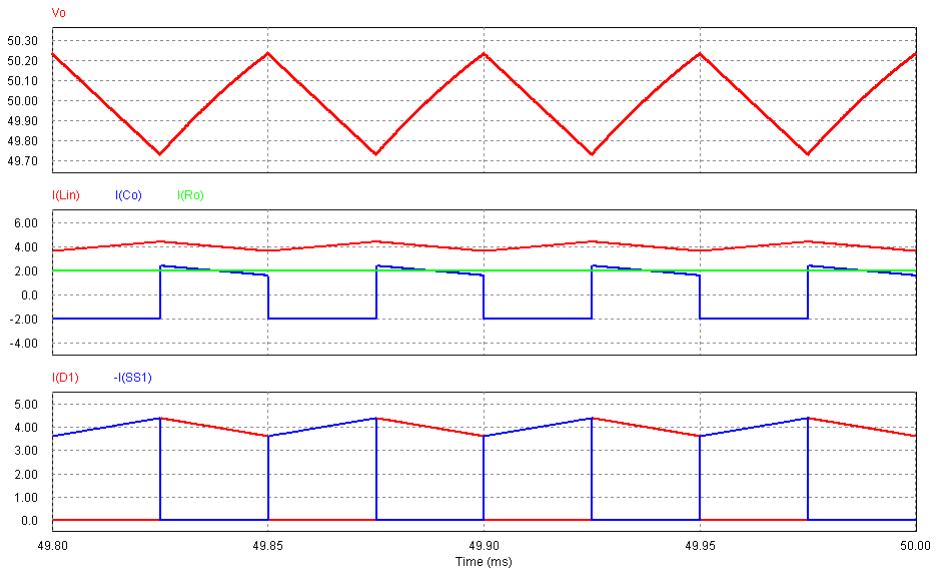
[picture p121: figure]

Razão Cíclica:

## Cálculos Preliminares

25 1 | 1 | 0,5
50

in

o

V
D
V
= - | = - | =

Valor Médio e Eficaz da Corrente do Transistor:

S_med

S_ef

I | I | 0,5 4 2A
I | I | 0,5.4 2,82A
| L

L

D
D
= · = | · =
= | · = | =

Valor Médio da Corrente no Indutor:

L_MED in
in
P 100 I | = I = | = | =4A
V | 25

## Cálculos Preliminares

Tensão no Transistor bloqueado:
V | V 50V DS(OFF) | o = | =

Corrente de Pico no Transistor em Condução:

DS(ON) | L_MAX | L_MED
0,78 I | =I | =I | 4 | 4,39 A
2 | 2
ΔiL + | = + | =

Ondulação da Corrente do Indutor:

6 | 3
25 0,5 | 0,78A
800 10 20 10

in
iL

V D
L f | -
- ·
Δ = | = | =
- | · | · ·

## Escolha do Transistor

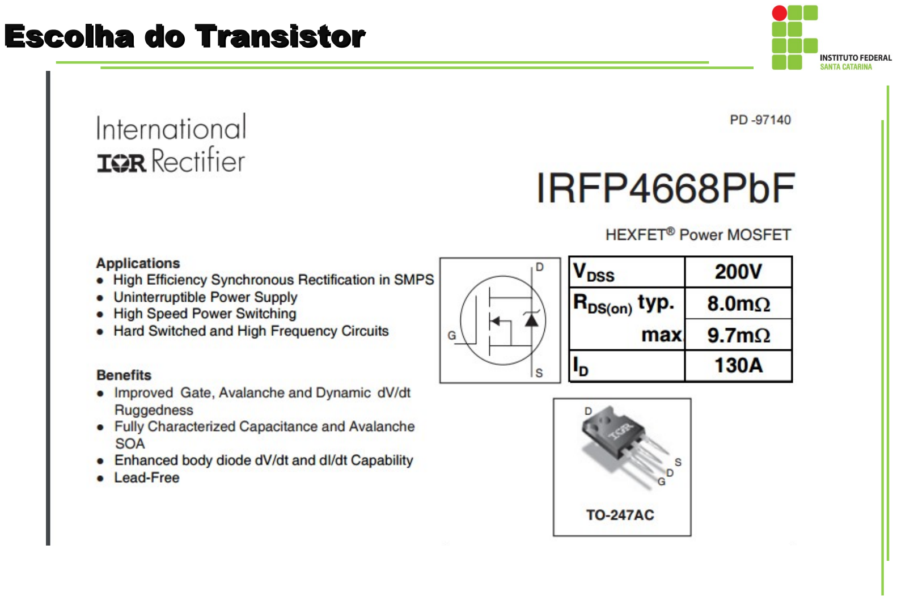
[picture p122: page 55]

## Escolha do Transistor

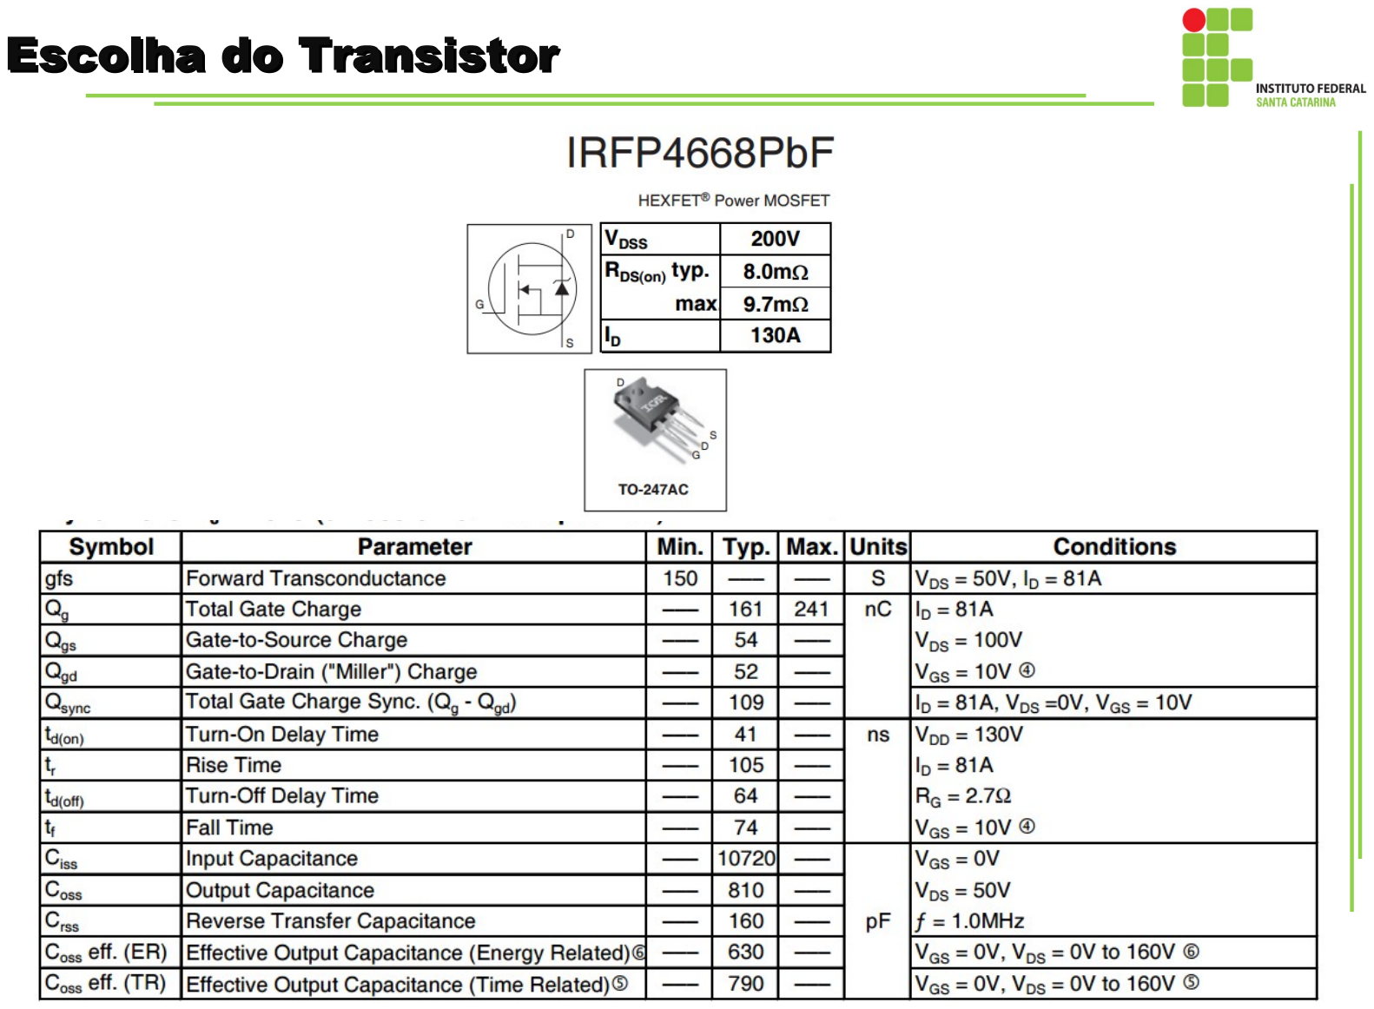
[picture p123: page 56]

## Cálculos de Perdas

DS(ON)

r

f

DS(OFF)

## R 9,7 m (max) t 105ns

t | 74ns
V | 50 V
= | Ω
=
=
=

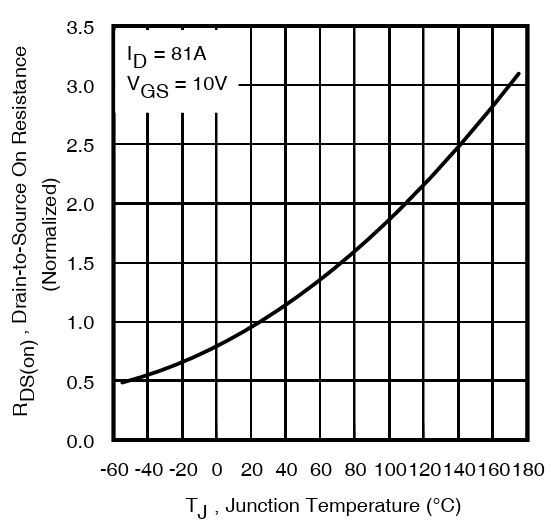
[picture p124: figure]

2 | 2 P | R | I | 2,25 0,0097 2,82 | 0,174W cond | DS(ON) | S_ef = | · | = | · | · | =

## Parâmetros Elétricos do Transistor Escolhido:

25°C

## Perdas por Condução:

## Rds(on) Fator de Multiplicação: 2,25 para 125°C

## Cálculos de Perdas

com | r | f | DS(ON) | DS(OFF) ( | )

3
9 | 9
P | t + t I | V
2
| 20 10 (105 10 | 74 10 ).4,39 50 0,39 W
2

f

= | · | · | =

·
= | · | + · | · =

## Perdas por Comutação:

## Perdas Totais do Transistor:

P = P | P | 0,174 0,39 0,564 W cond | com + | = | + | =

## Cálculo Térmico

P 0,564 W
50

# (max) 125

0,29

0,24

# 40 (sem dissipador)

# ? (dissipador)

o
a
o
j
o
jc

o
cd cs

o
ja

da

T | C
T | C
R | C
W
R | R | C
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
## Cálculo Térmico:

## Cálculo Térmico

R | R | R | R ja | jc | cd | da = | + | +

## Resistência Térmica:

## Resistência Máxima Junção-Ambiente:

125 50 133
P | 0,564
o j | a
ja

T T
R | C
W
= | = | =
40 | (sem dissipador)

o
ja R | C W
=

## Cálculo Térmico

com | r | f | DS(ON) | DS(OFF) ( | )

3
9 | 9
P | t + t I | V
2
| 200 10 (105 10 | 74 10 ).4,39 50 3,92 W
2

f

= | · | · | =

·
= | · | + · | · =

## Perdas por Comutação:

## Perdas Totais do Transistor:

P = P | P | 0,174 3,92 4,094 W cond | com + | = | + | =

Aumento da frequência de Comutação para 200 kHz:

## Cálculo Térmico

R | R | R | R ja | jc | cd | da = | + | +

## Resistência Térmica:

## Resistência Térmica Máxima Junção Ambiente:

125 50 18,3
P | 4,094
o j | a
ja

T T
R | C
W
= | = | =

18,3 0,29 0,24 17,77

da | ja | jc | cd
o
da
R | R | R | R
R | C
W
= | - | -
= | - | - | =

## Cálculo da Resistência Térmica do Dissipador:

## Cálculo Térmico

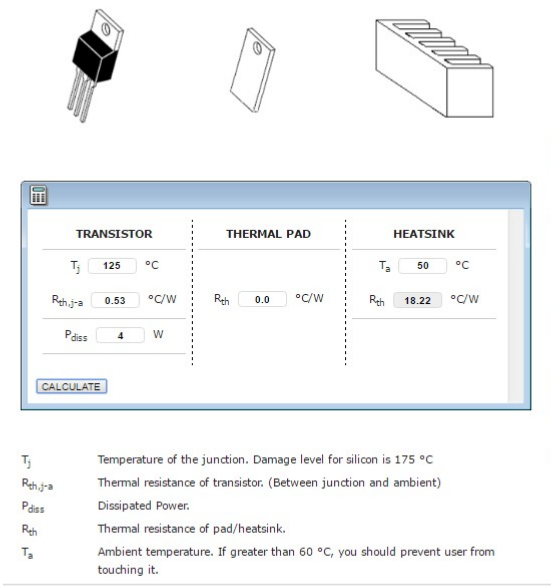
[picture p125: figure]

## Cálculo Térmico

## Cálculo Térmico

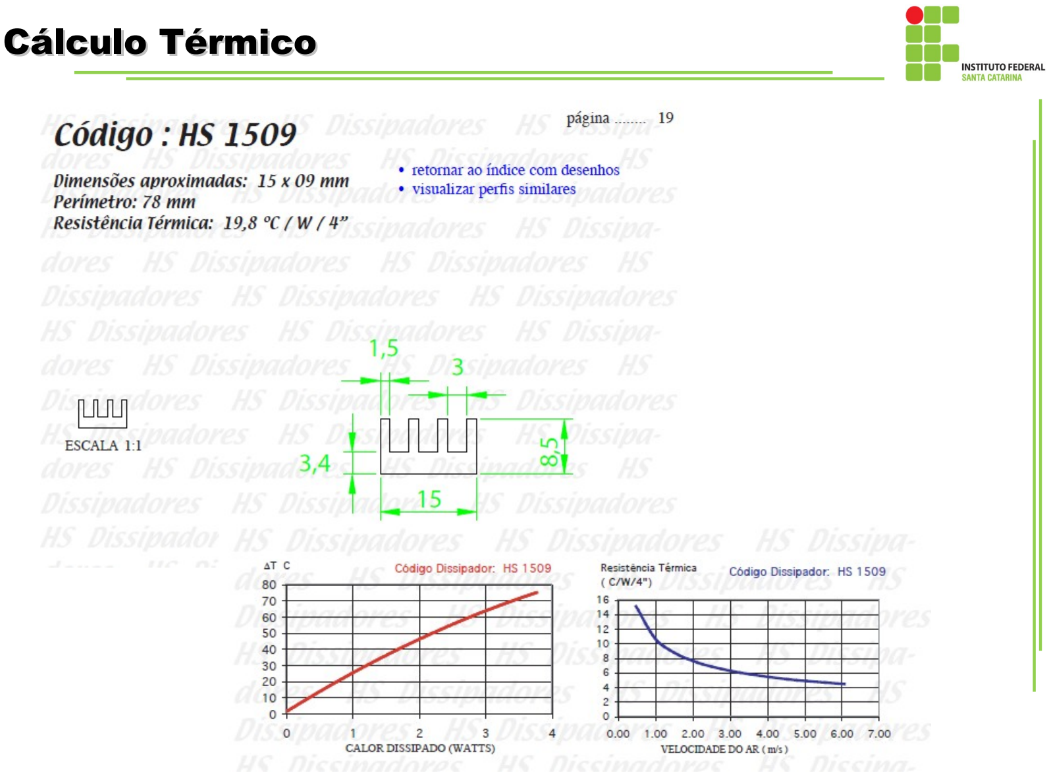
[picture p126: page 65]

## Cálculo Térmico

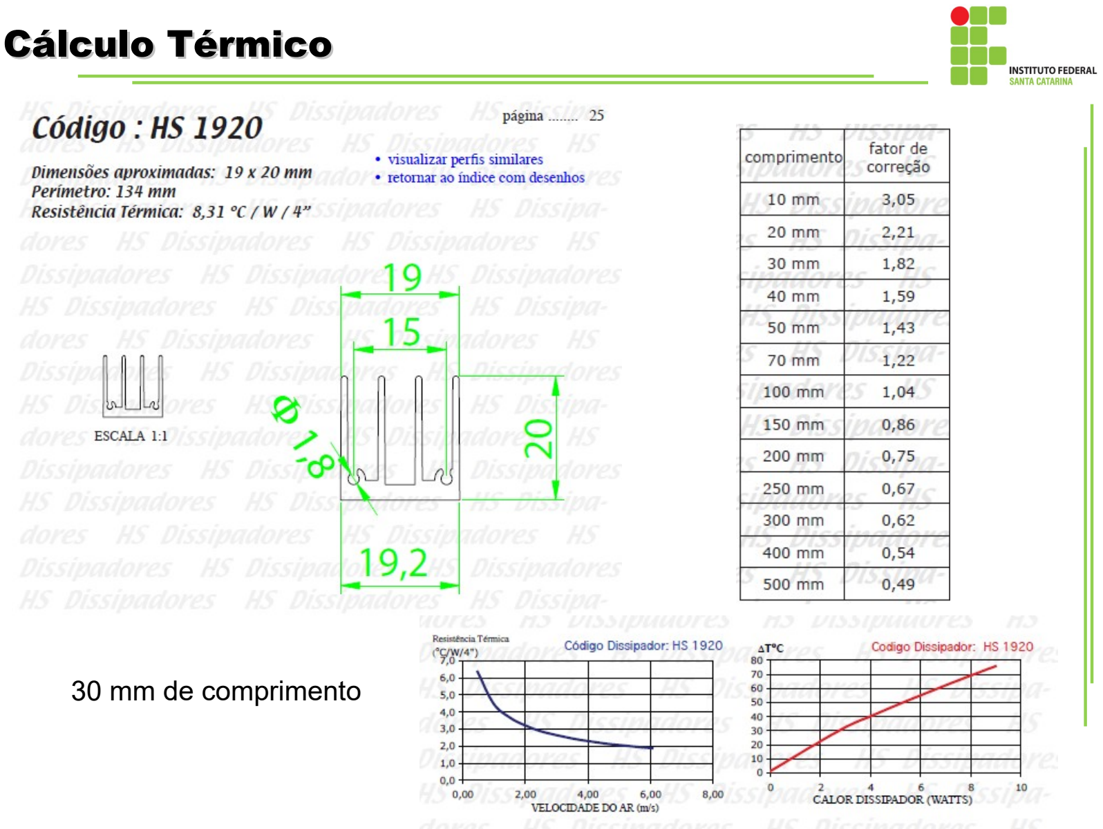
[picture p127: page 66]

30 mm de comprimento

## Dissipadores

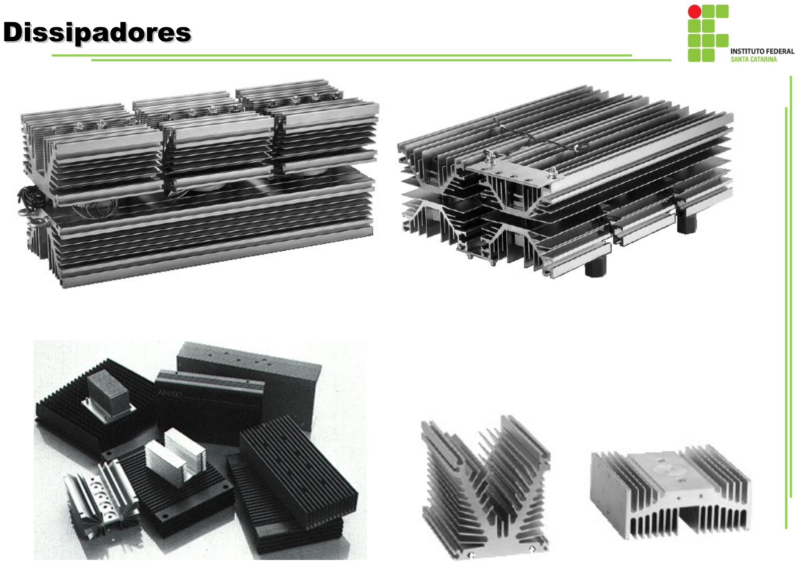
[picture p128: page 67]

## Dissipadores

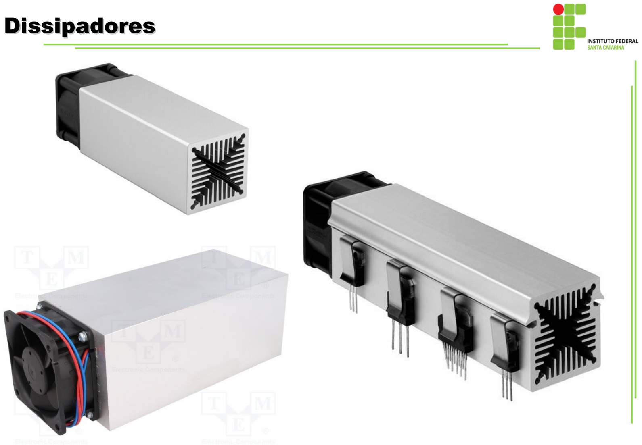
[picture p129: page 68]

## Dissipadores

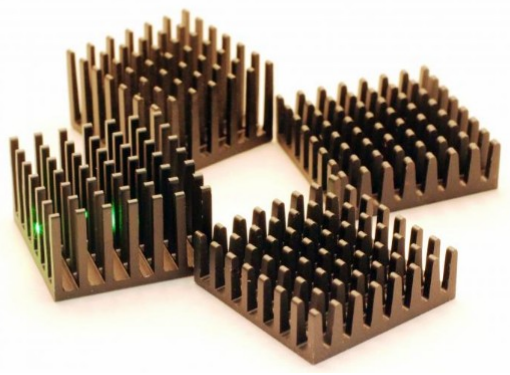
[picture p130: figure]

## Novos Modelos: Pin Fin Heat Sinks Baixa resistência térmica: 2,5 graus/W

## Simulação de Perdas no PSIM

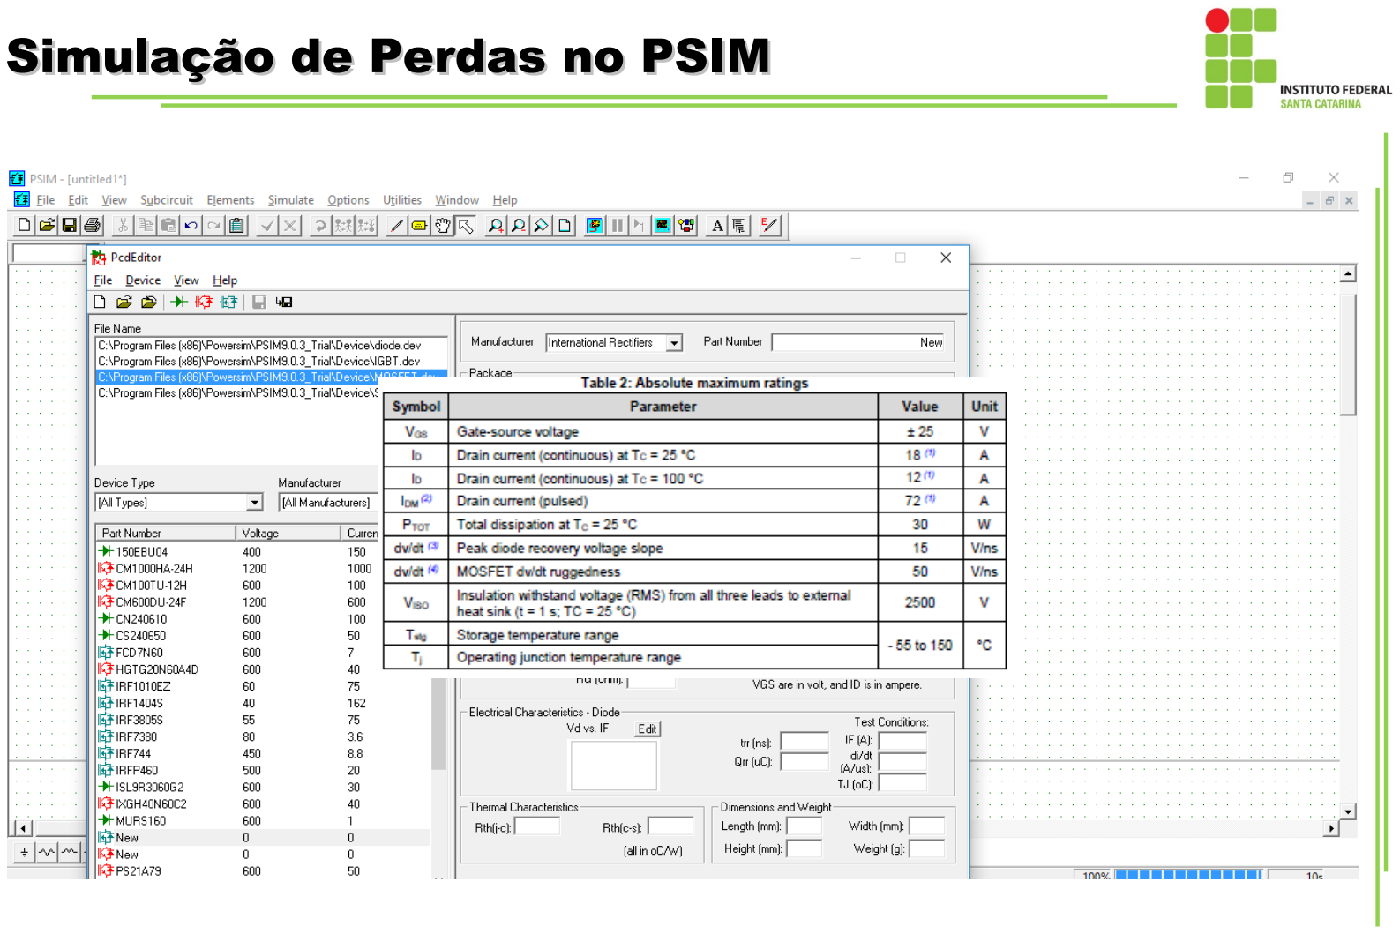
[picture p131: page 70]

## Cálculo Térmico

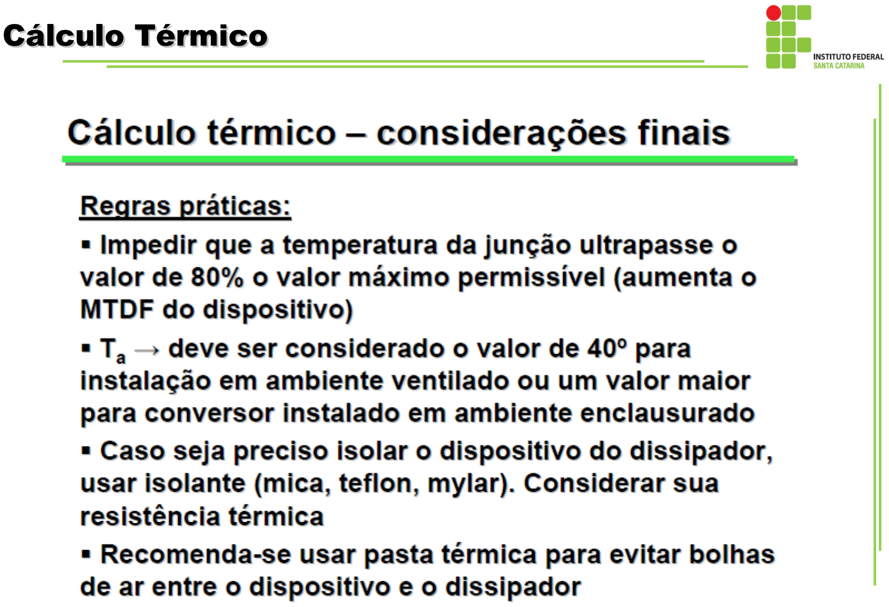
[picture p132: page 71]

## Tarefa 1 para entregar

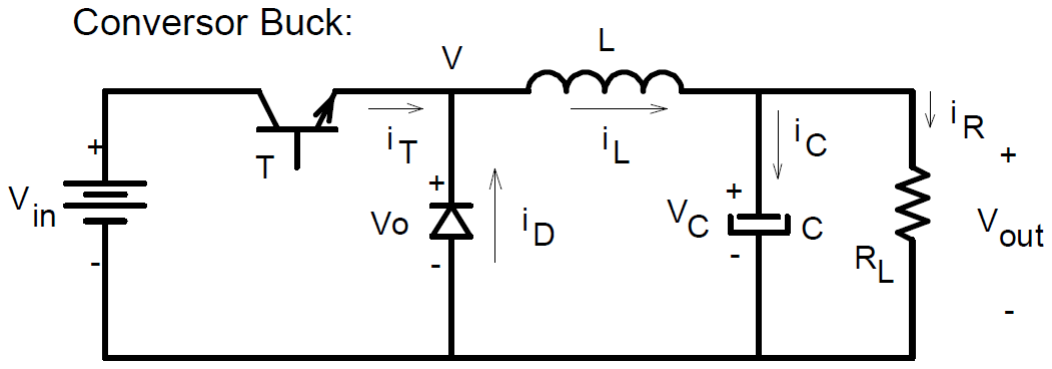
[picture p133: figure]

Especificação:
Tensão de Entrada: 36 V
Tensão de Saída: 12 V
Freq. de comutação: 100 kHz; Indutância L: 100 uH
Capacitância C: 100 uF;
Potência: 100 W;
Transistor: IRLZ44N (TO-220AB) Diodo: MUR860 e MBR20100 (TO-220)

Apresentar:
- Principais Formas de Ondas Teóricas;
- Resultados de Simulação;
- Esforços de Corrente no Transistor
(T) e no Diodo (D);
- Obter o dissipador para que
o transistor e o diodo funcionem de maneira adequada no conversor Buck. Obs: HS Dissipadores e um outro fabricante de dissipadores.
