mateusalgado/IFSC_ELP2/00_Disciplina/Aula_03_Metodologia_Projeto.pdf

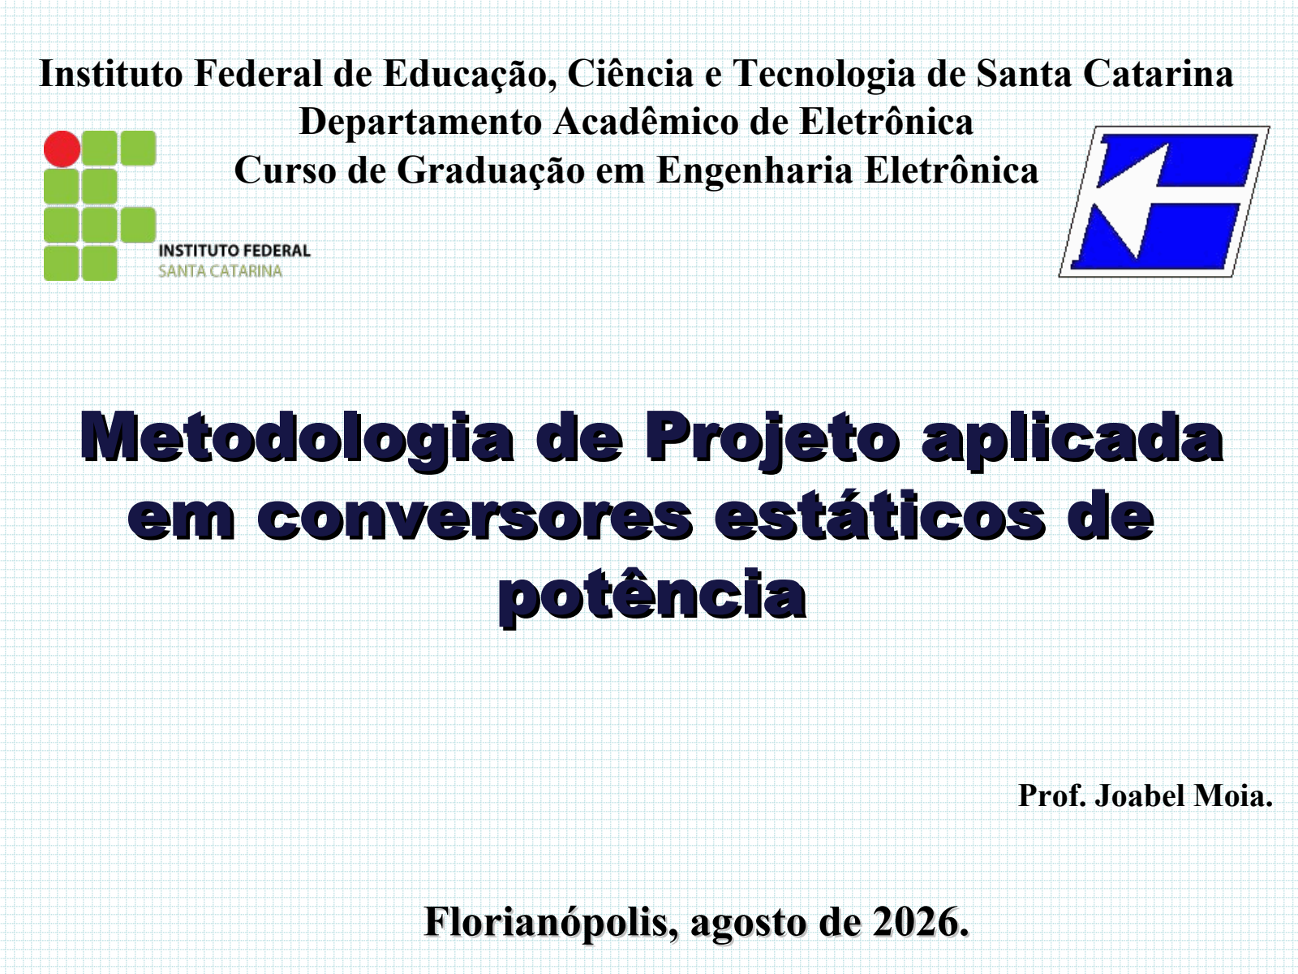
[picture p134: page 1]

Florianópolis, agosto de 2026.

Prof. Joabel Moia.

# Metodologia de Projeto aplicada em conversores estáticos de potência

Instituto Federal de Educação, Ciência e Tecnologia de Santa Catarina Departamento Acadêmico de Eletrônica Curso de Graduação em Engenharia Eletrônica

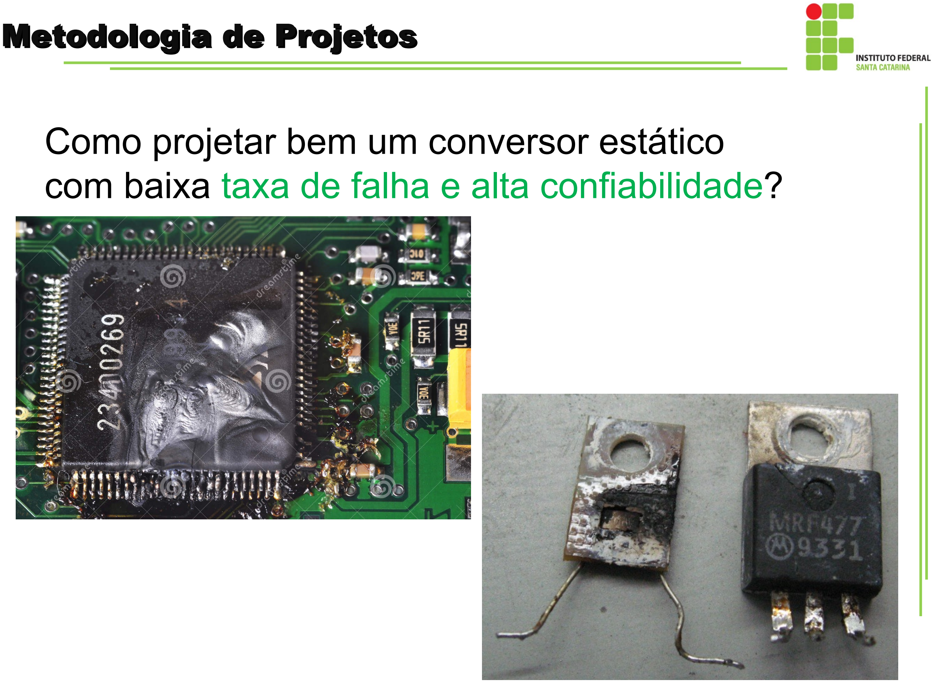
[picture p135: page 2]

Como projetar bem um conversor estático com baixa taxa de falha e alta confiabilidade?

### Metodologia de Projetos

Percentual de Falhas por componentes em conversores de potência

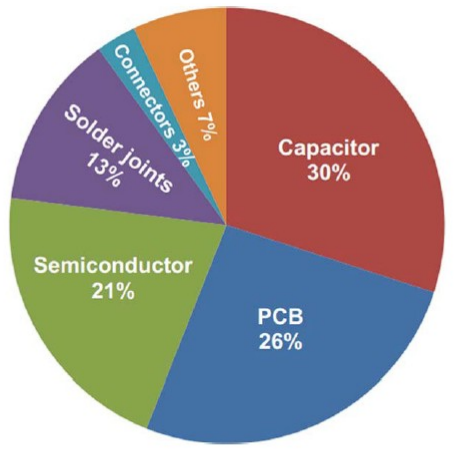
[picture p136: figure]

Fonte: QIAO, W.; LU, D. A survey on wind turbine condition monitoring and fault diagnosis — Part I

Pontos Importantes que devem ser observados no Projeto Conversores Estáticos de Potência:

### Metodologia de Projetos: Conversores Estáticos

- Considerar a Potência Máxima de Saída para o projeto;
- Analisar as condições de entrada:
- Variação de Tensão e de Corrente
- Analisar as questões térmicas e calcular dissipador(es) apropriados:
- Analisar o melhor lugar para deixar o dissipador para não afetar outros componentes do circuito;
- Considerar que o conversor vai estar em um gabinete e em algumas vezes acondicionado em um lugar com temperatura alta;
- Faixa de temperatura de operação;

Pontos Importantes que devem ser observados no Projeto Conversores Estáticos de Potência:

### Metodologia de Projetos: Conversores Estáticos

- Sempre fazer o projeto no pior caso:
- Variação de tensão, frequência, potência e etc;
- Qualidade dos Componentes:
- Adquirir componentes de fabricantes confiáveis;
- Desenhar o layout da Placa de Circuito Impresso de maneira adequada:
- Levar também em consideração a Interferência Eletromagnética (EMI);
- Requisitos de isolamento entre entrada e saída
- Realizar testes adequados para a validação do conversor;

Pré-Escolha dos Semicondutores:

### Metodologia de Projetos: Conversores Estáticos

- A pré-escolha é feita com base no valor médio de corrente, corrente de pico e tensão máxima de bloqueio;
- Em seguida, com um número opções de modelos de semicondutores reduzidos, verifica-se as características Estáticas (RDS_ON, VF

, VCE, RD

, etc);

- Verifica-se também as características dinâmicas do semi-condutor (tr

, tf

) e de recuperação reversa (Qrr, trr), ou energia envolvidas nas comutações (datasheet) ;

- Por fim, realiza-se o cálculo térmico para escolher um dissipador, caso necessário, e analisar a viabilidade técnica do projeto, do ponto de vista de tamanho, peso, volume e etc;

Pré-Escolha dos Semicondutores:

### Metodologia de Projetos: Conversores Estáticos

- O cálculo de perdas podem ser validados por simulação numérica, pois pode apresentar modelos mais completos;
- Se for necessário, podem ser utilizados semicondutores em paralelo ou série, porém deve se tomar cuidado. Normalmente, prefere-se utilizar outras soluções por meio de topologias (circuitos elétricos);
- Alguns fabricantes de semicondutores oferecem a opção de livre de chumbo (Lead Free);
- A escolha do semicondutores (BJT, MOSFET, IGBT, etc) deve ser realizado em função do parâmetros elétricos, custo facilidade de aquisição e etc;

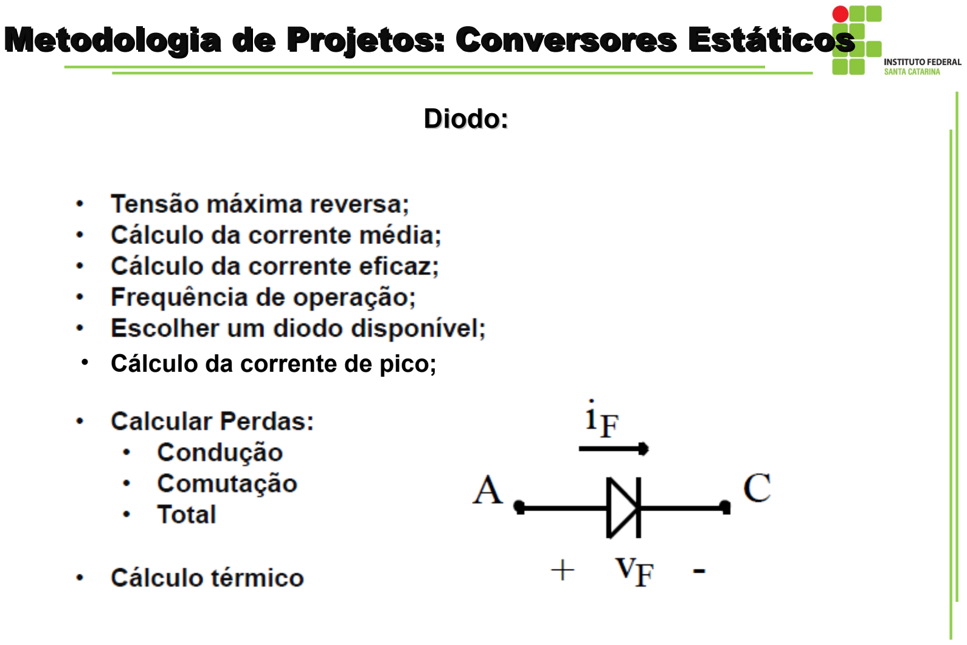
[picture p137: page 8]

Diodo:

### Metodologia de Projetos: Conversores Estáticos

- Cálculo da corrente de pico;

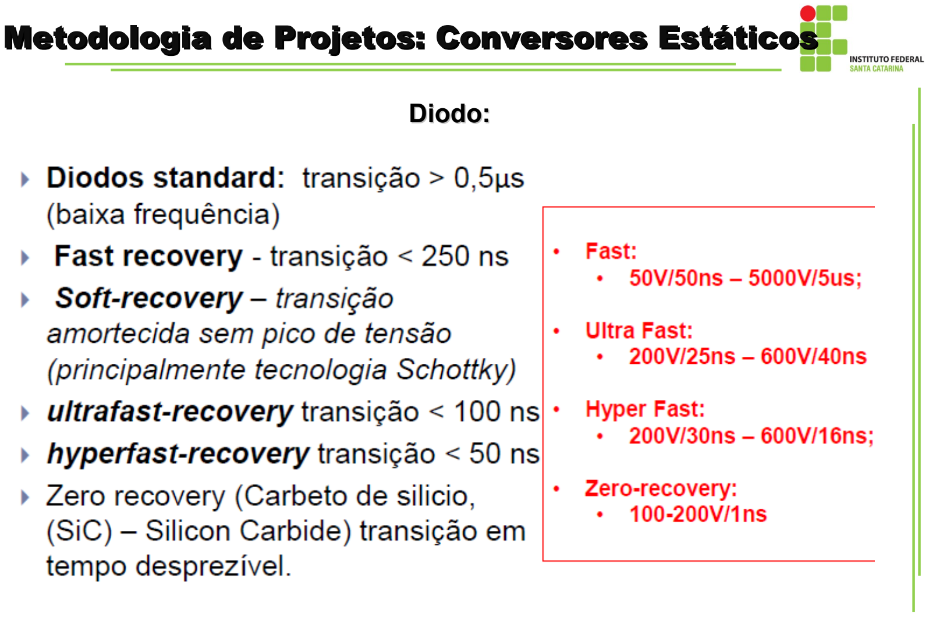
[picture p138: page 9]

Diodo:

### Metodologia de Projetos: Conversores Estáticos

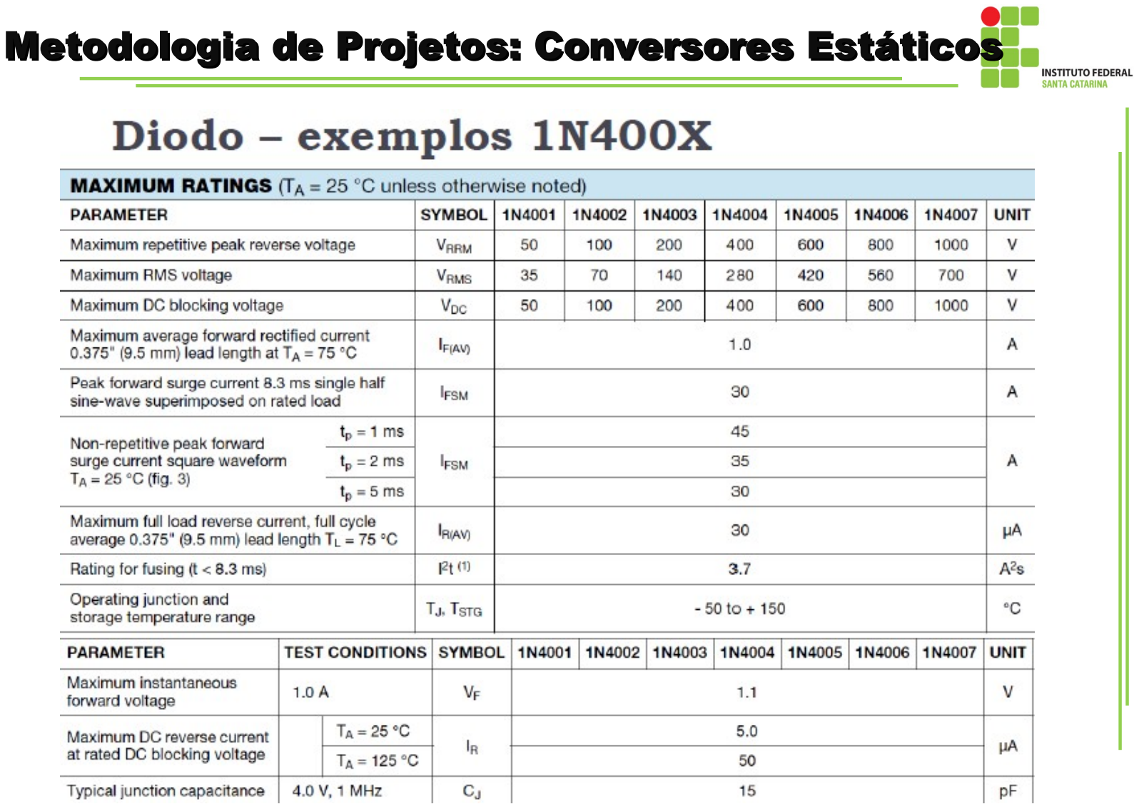
[picture p139: page 10]

### Metodologia de Projetos: Conversores Estáticos

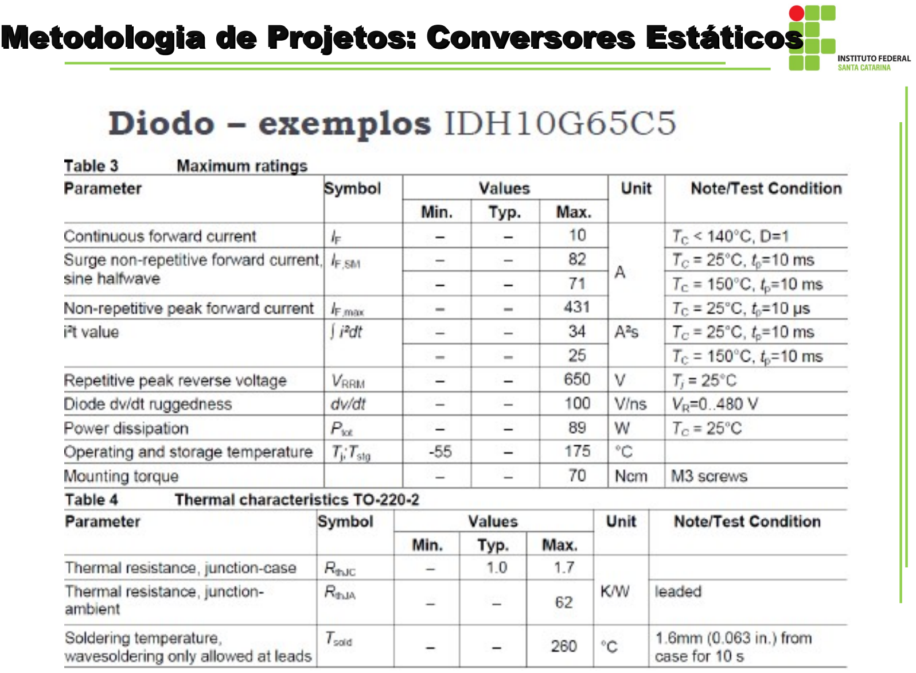
[picture p140: page 11]

### Metodologia de Projetos: Conversores Estáticos

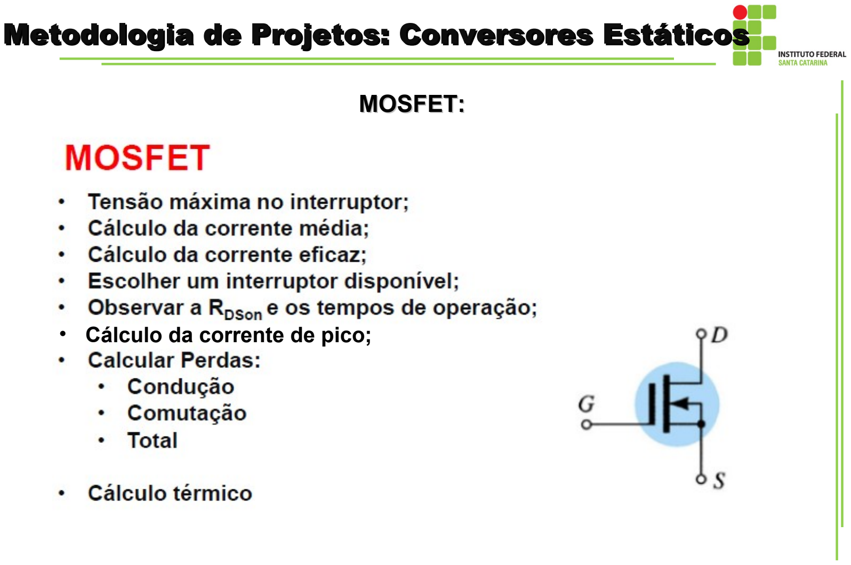
[picture p141: page 12]

MOSFET:

### Metodologia de Projetos: Conversores Estáticos

- Cálculo da corrente de pico;

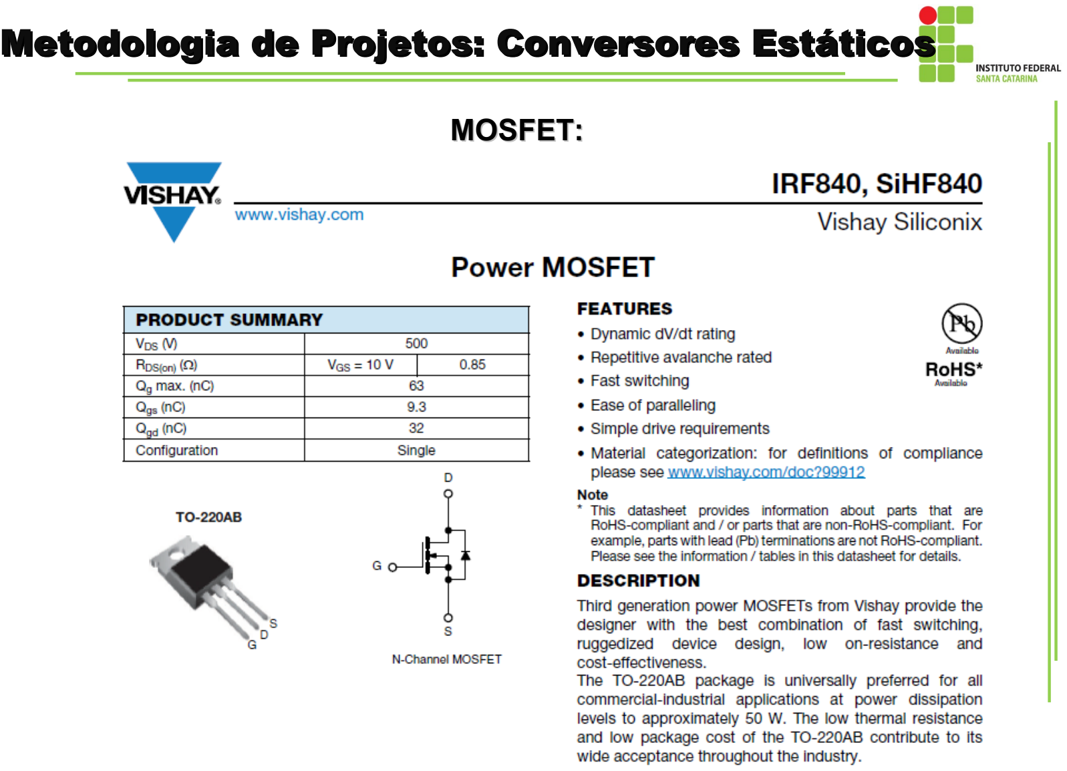
[picture p142: page 13]

MOSFET:

### Metodologia de Projetos: Conversores Estáticos

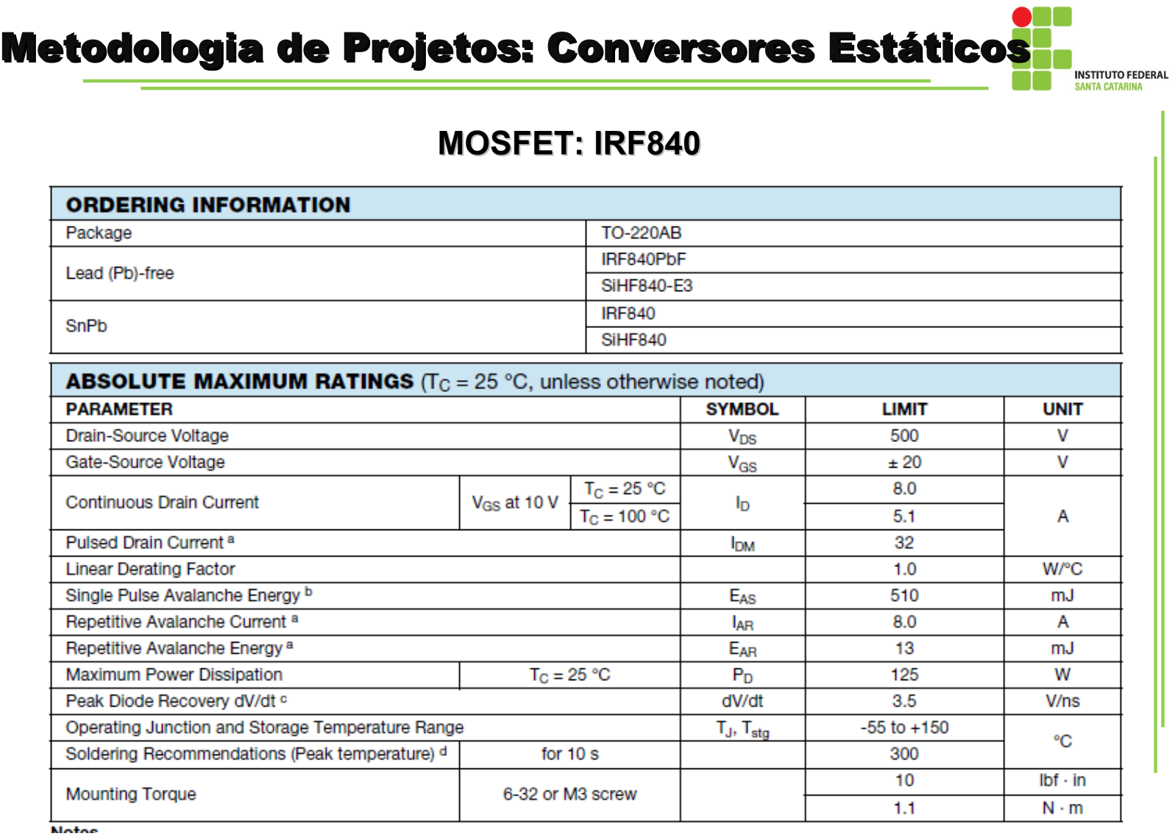
[picture p143: page 14]

MOSFET: IRF840

### Metodologia de Projetos: Conversores Estáticos

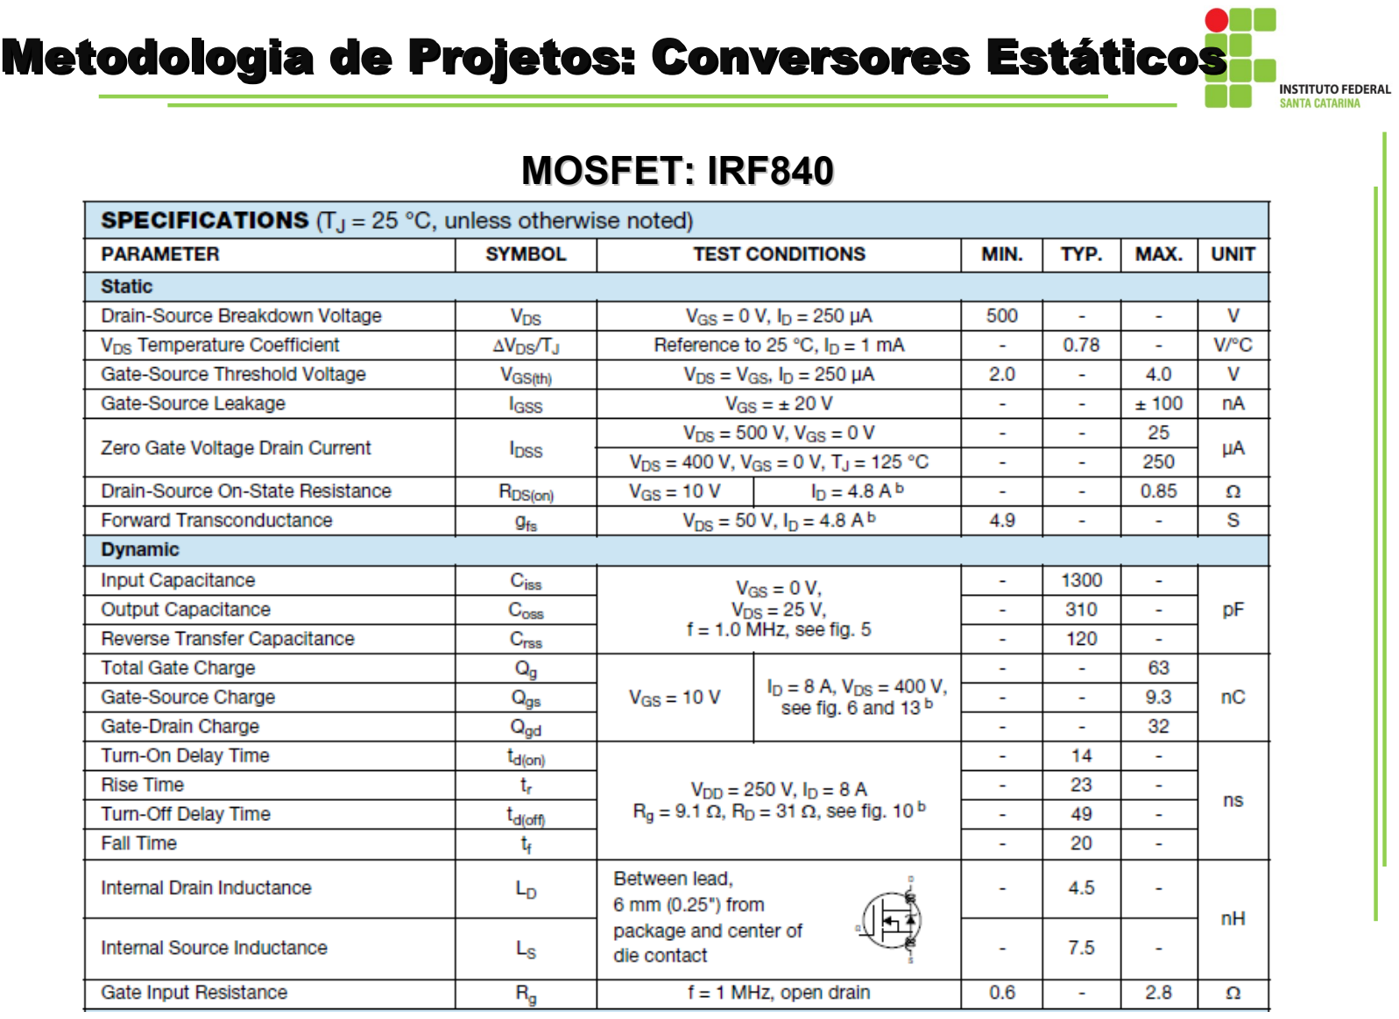
[picture p144: page 15]

MOSFET: IRF840

### Metodologia de Projetos: Conversores Estáticos

MOSFET: IRF840

### Metodologia de Projetos: Conversores Estáticos

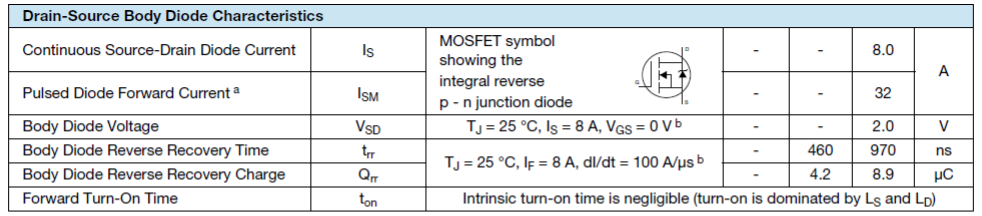
[picture p145: figure]

MOSFET: IRF840

### Metodologia de Projetos: Conversores Estáticos

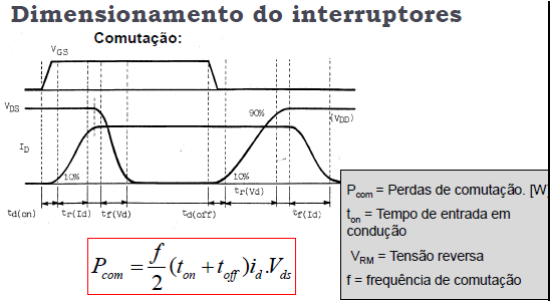
[picture p146: figure]

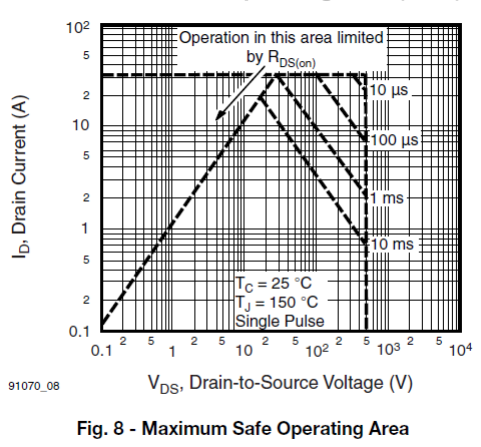
[picture p147: figure]

MOSFET: Safe Operating Area (SOA)

### Metodologia de Projetos: Conversores Estáticos

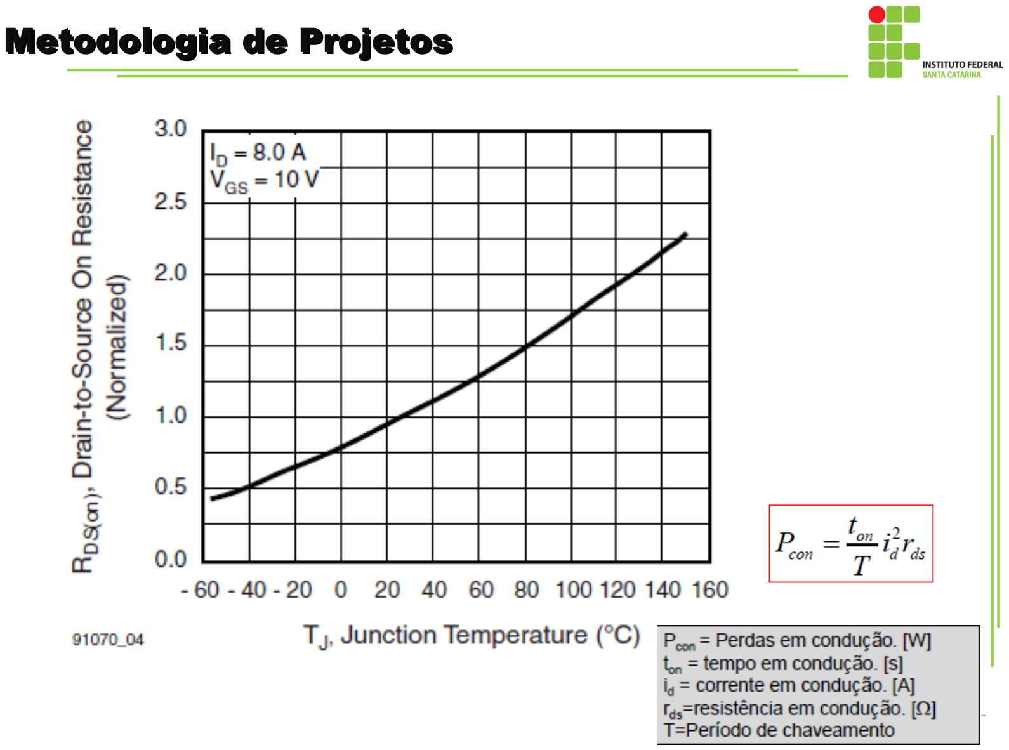
[picture p148: page 19]

MOSFET:

MOSFET:

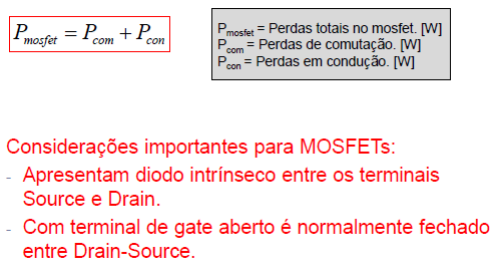
[picture p149: figure]

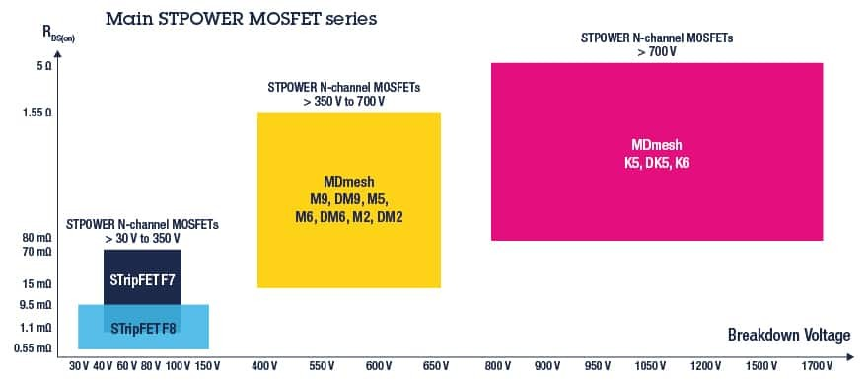
[picture p150: figure]

Fonte: http://www.st.com/content/st_com/en/products/power-transistors/power-mosfets.html

MOSFET:

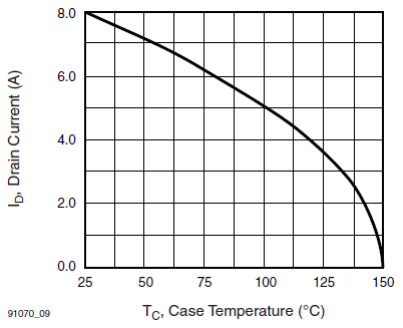
[picture p151: figure]
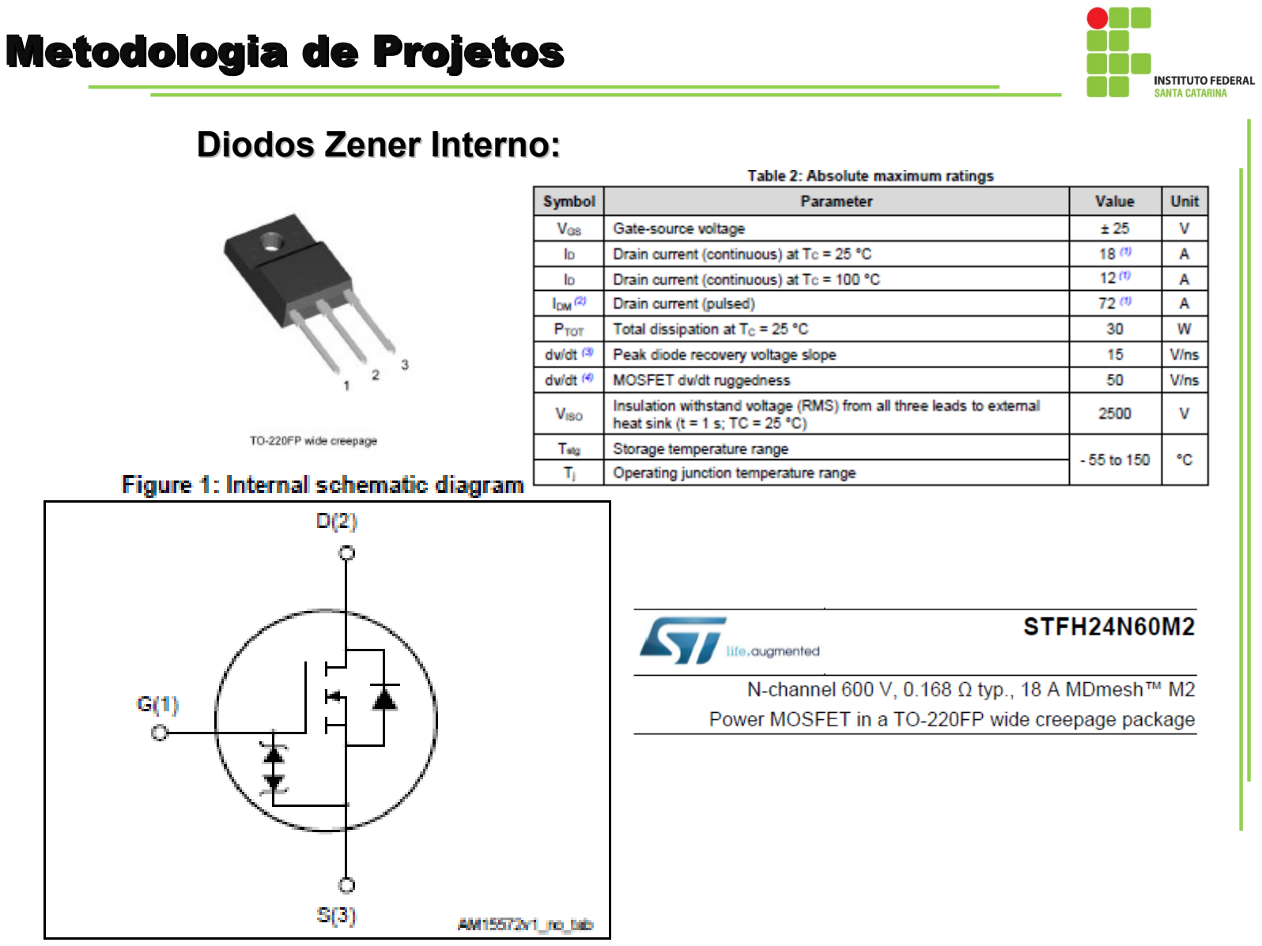
[picture p152: page 23]

Diodos Zener Interno:

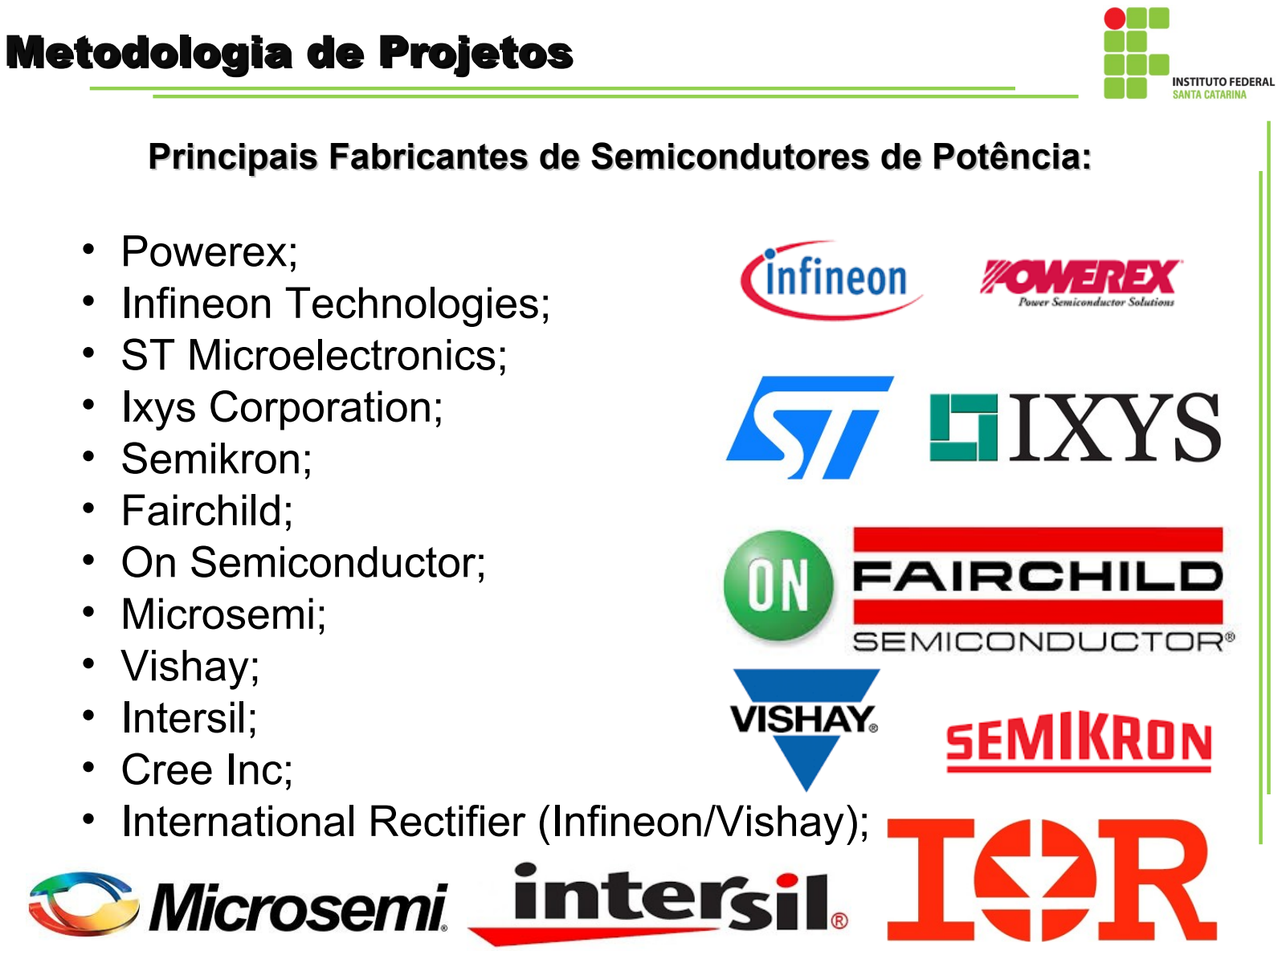
[picture p153: page 24]

Principais Fabricantes de Semicondutores de Potência:

- Powerex;
- Infineon Technologies;
- ST Microelectronics;
- Ixys Corporation;
- Semikron;
- Fairchild;
- On Semiconductor;
- Microsemi;
- Vishay;
- Intersil;
- Cree Inc;
- International Rectifier (Infineon/Vishay);

Principais Fabricantes de Semicondutores no Brasil:
- HT Micron (São Leopoldo/RS):
- Iot Devices;
- Memórias: DRAM, eMCP, eMMC
- Ceitec/MCTI (Porto Alegre/RS):
- Produtos RFID;
- Eletrônica de Potência: SiC;
- Unitec (Ribeirão das Neves/MG):
- IoT devices;
- Smart Parking Systems;
- Wearable Electronics;

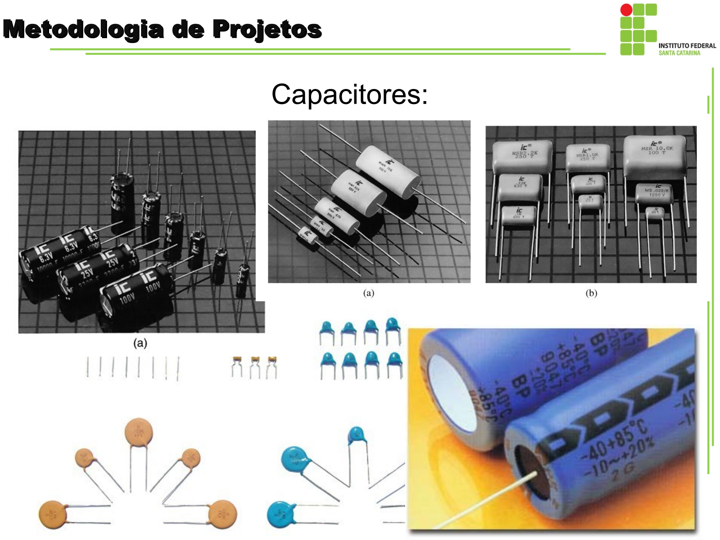
[picture p154: page 26]

Capacitores:

C | RSE | LSE

Modelo equivalente do capacitor

Onde:
- C = Capacitância;
- RSE = Resistência série equivalente;
- LSE = Indutância série equivalente.

2 P RSE I = · ef

Perdas devido à RSE:

Capacitores:

Curva de Impedância do Capacitor: (Z x Frequência):

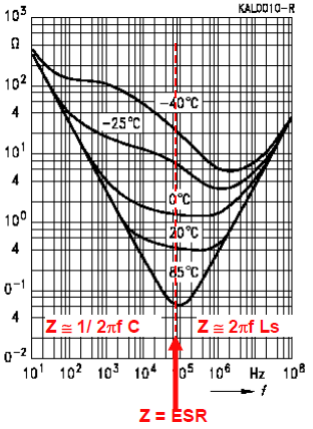
[picture p155: figure]

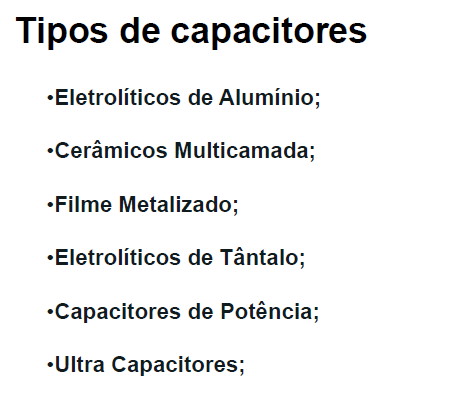
[picture p156: figure]

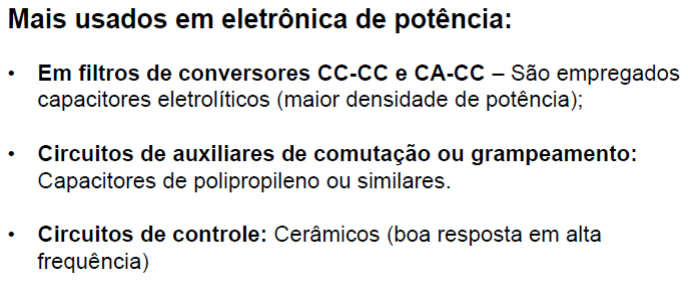
[picture p157: figure]

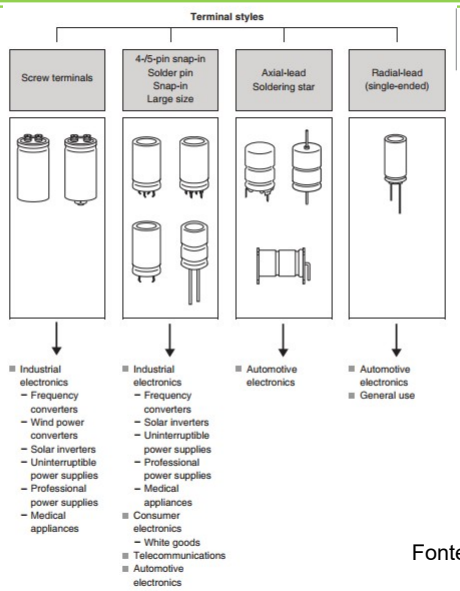
[picture p158: figure]

Fonte: EPCOS

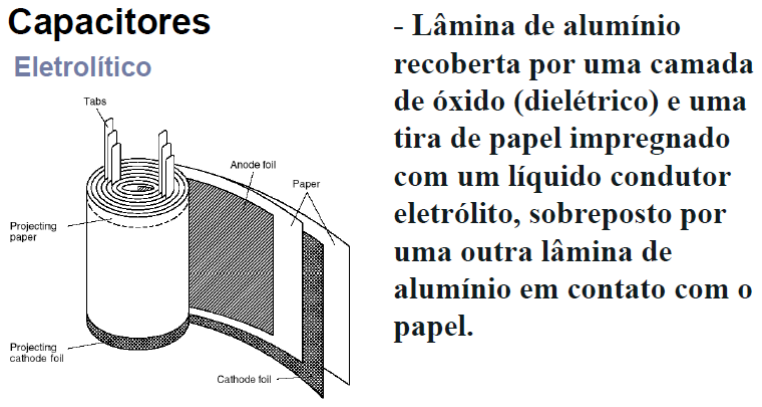
[picture p159: figure]
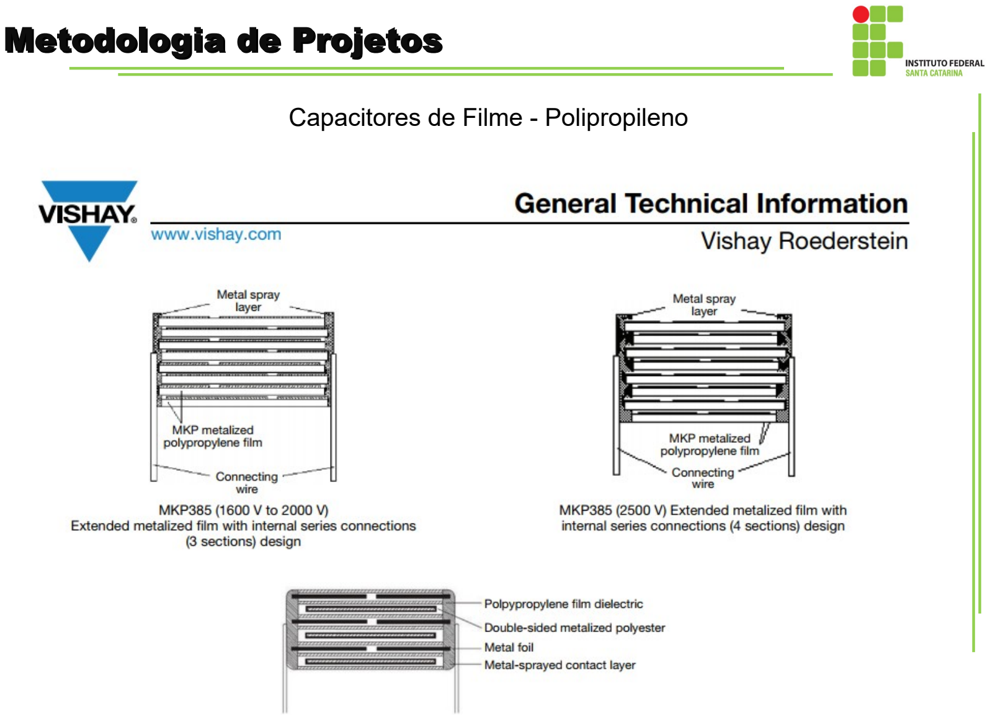
[picture p160: page 33]

Capacitores de Filme - Polipropileno

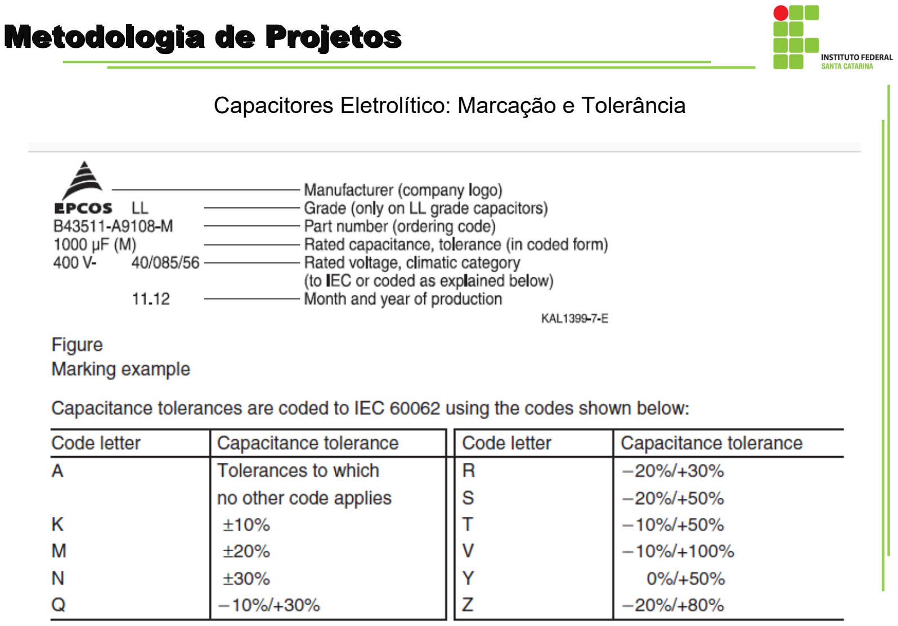
[picture p161: page 34]

Capacitores Eletrolítico: Marcação e Tolerância

Capacitores Eletrolíticos: Variação da RSE com a frequência

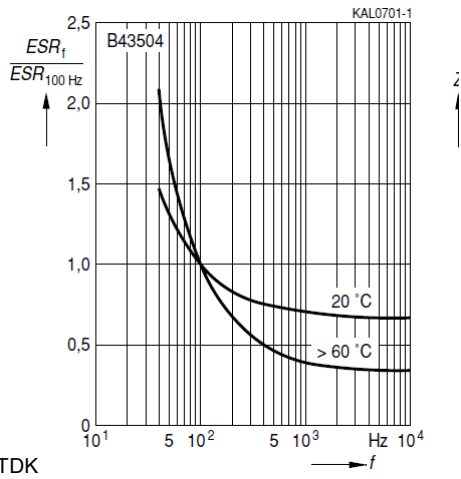
[picture p162: figure]

B34504 EPCOS/TDK

Capacitores Eletrolíticos: Dados

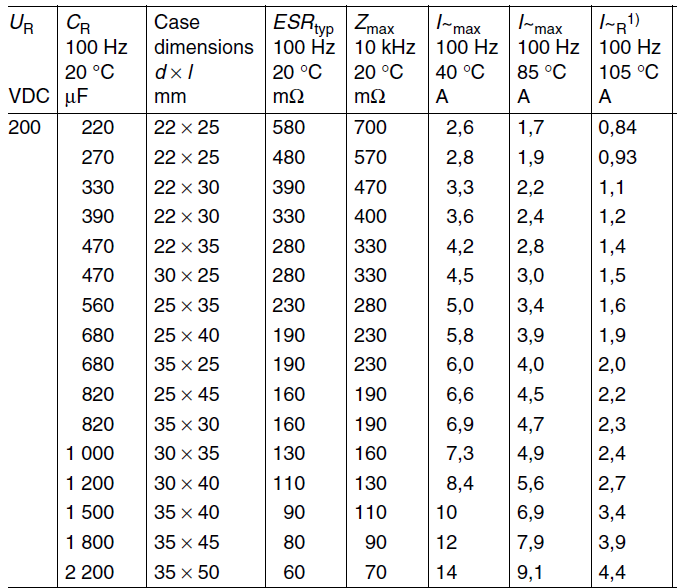
[picture p163: figure]

B34504 EPCOS/TDK

Capacitores Eletrolíticos: Dados

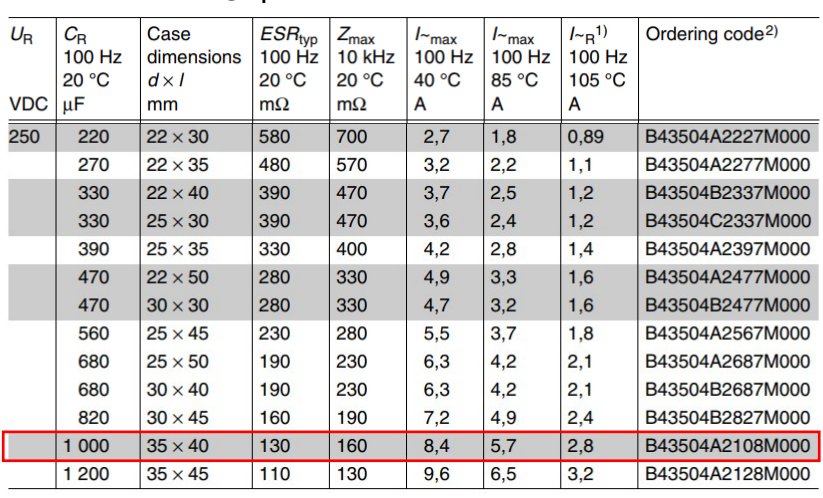
[picture p164: figure]

B34504 EPCOS/TDK

Capacitores Eletrolíticos: Variação da corrente com a frequência

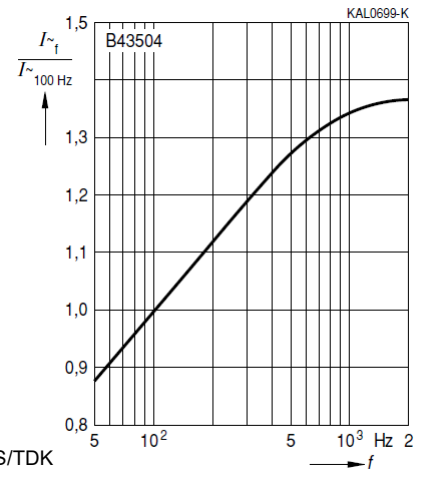
[picture p165: figure]

B34504 EPCOS/TDK

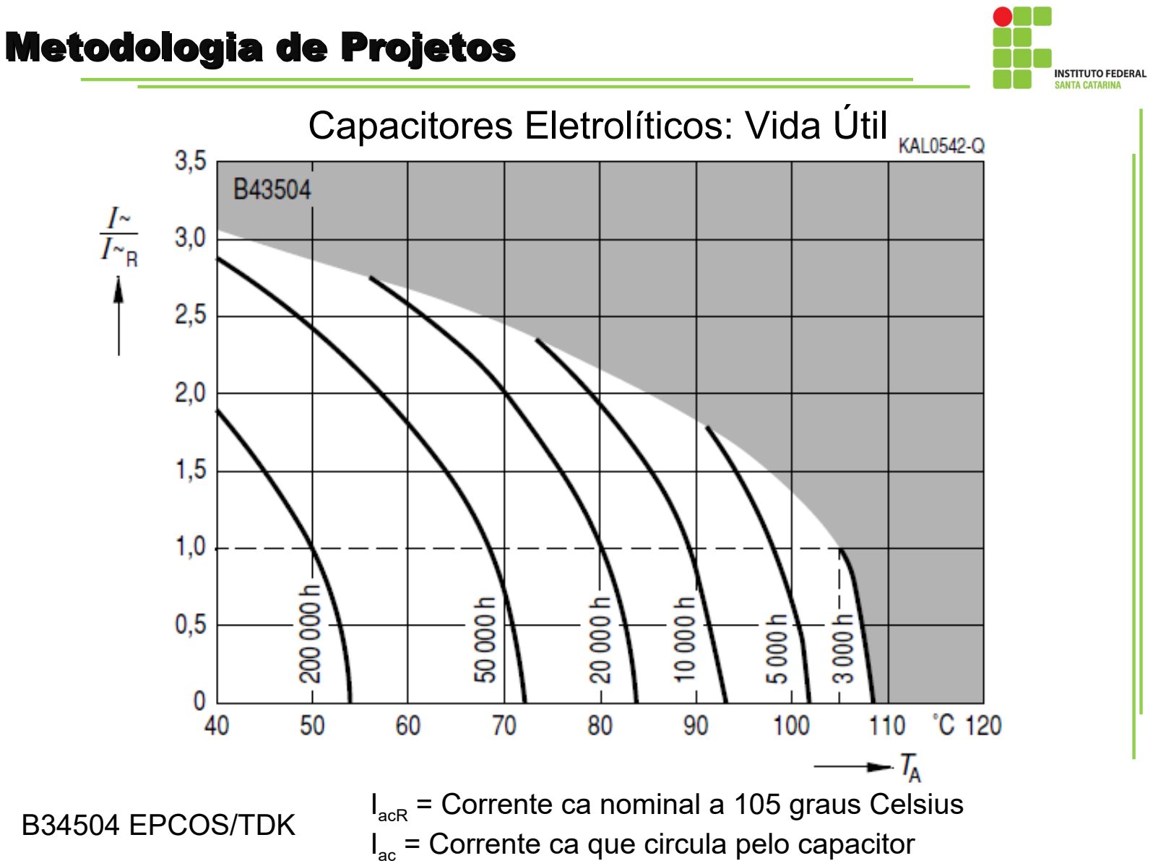
[picture p166: page 39]

Capacitores Eletrolíticos: Vida Útil

B34504 EPCOS/TDK

I

acR = Corrente ca nominal a 105 graus Celsius I

ac = Corrente ca que circula pelo capacitor

Capacitores Eletrolíticos: Vida Útil

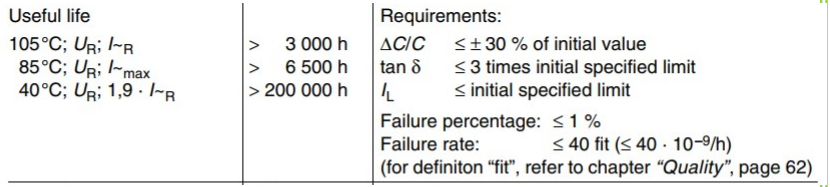
[picture p167: figure]

B34504 EPCOS/TDK

I

acR = Corrente ca nominal a 105 graus Celsius I

ac = Corrente ca que circula pelo capacitor UR

= tensão nominal

Capacitores Eletrolíticos: Vida Útil

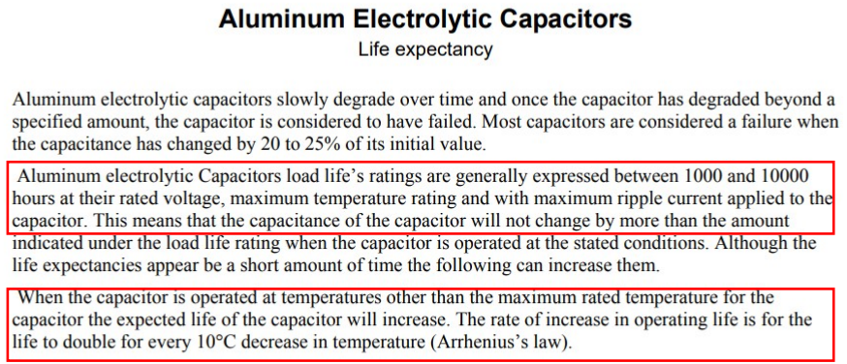
[picture p168: figure]

Fonte: Illinois Capacitor, Inc.

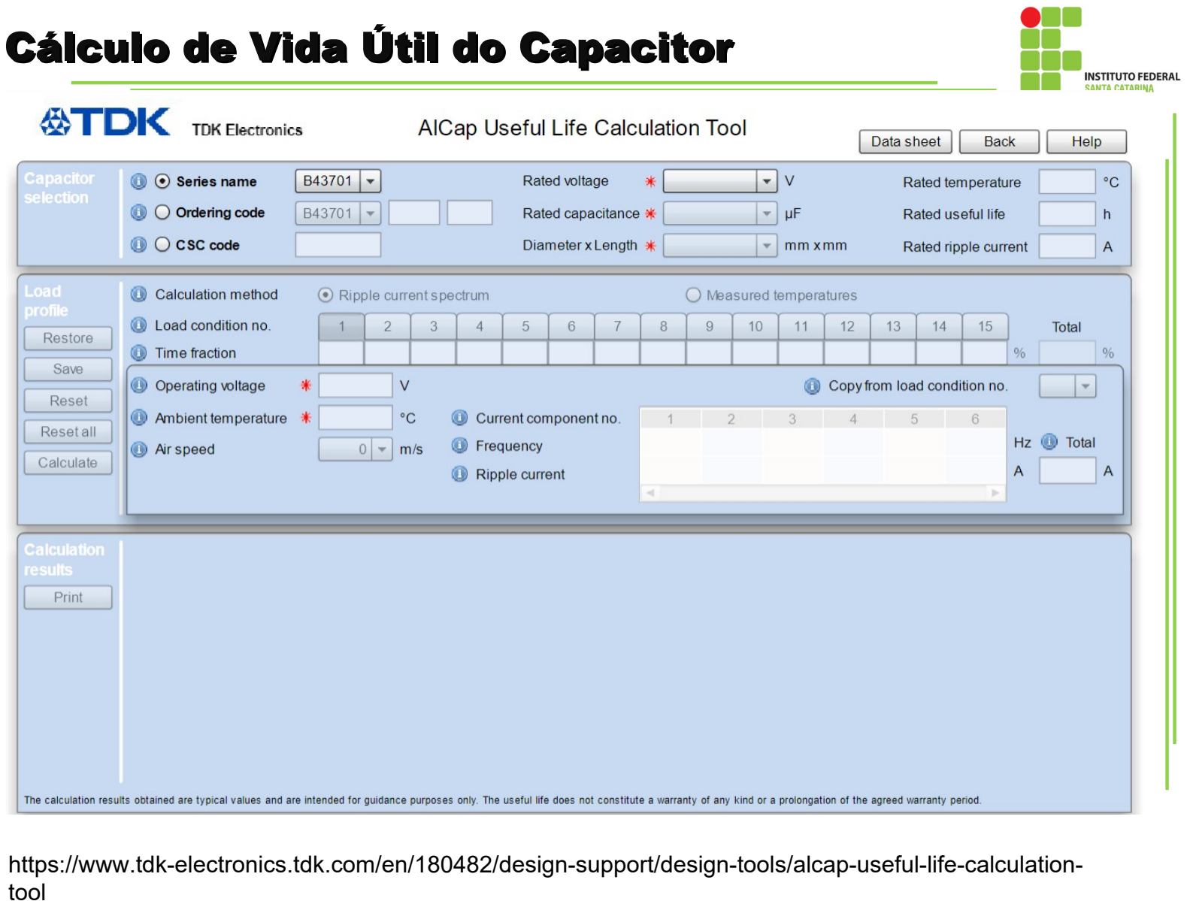
[picture p169: page 42]

### Cálculo de Vida Útil do Capacitor

https://www.tdk-electronics.tdk.com/en/180482/design-support/design-tools/alcap-useful-life-calculation-tool

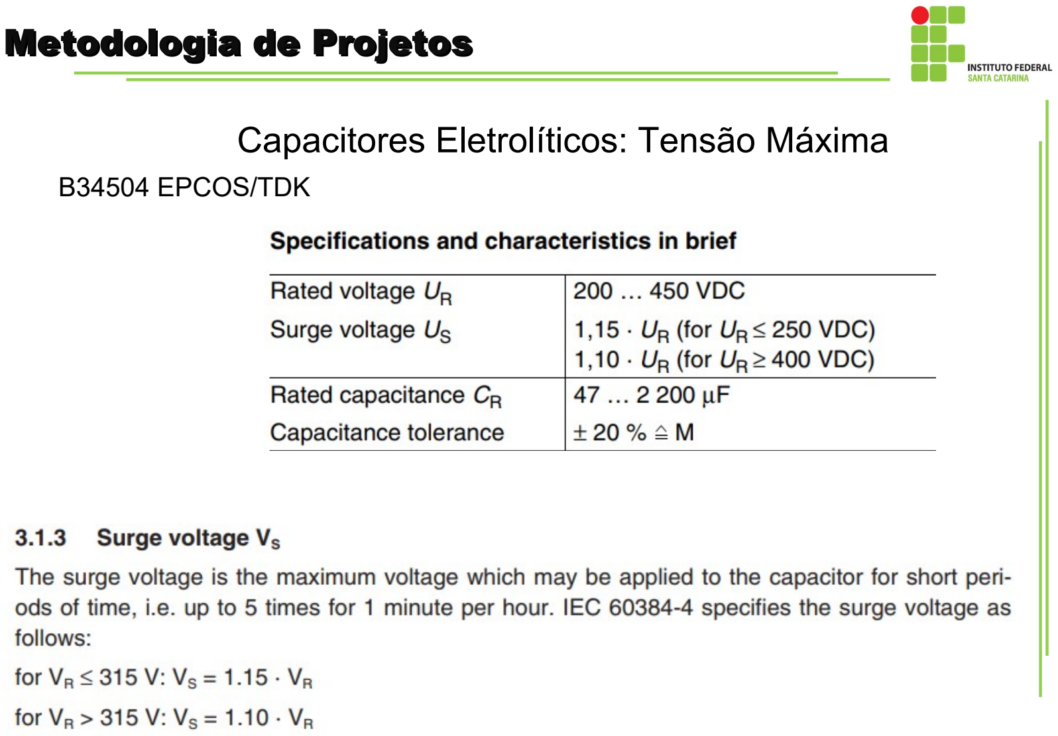
[picture p170: page 43]

Capacitores Eletrolíticos: Tensão Máxima

B34504 EPCOS/TDK

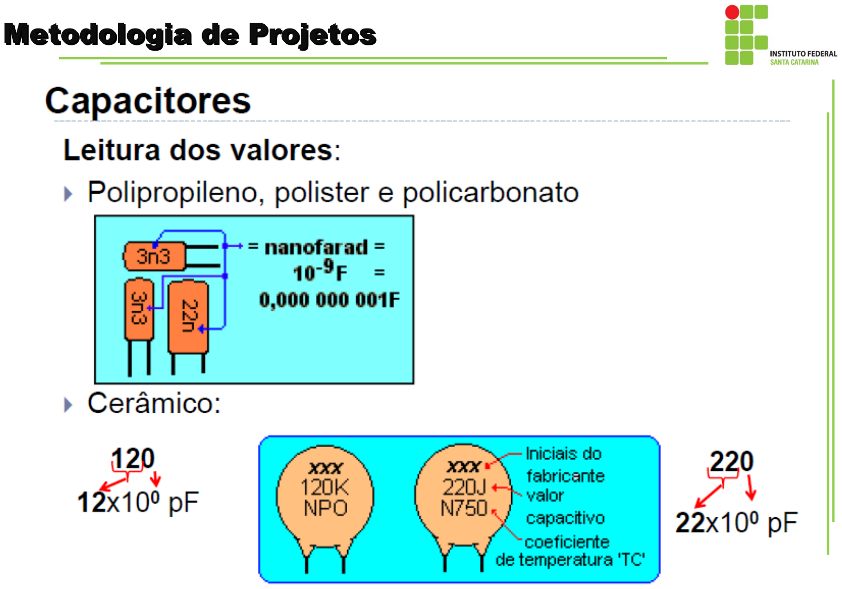
[picture p171: page 44]
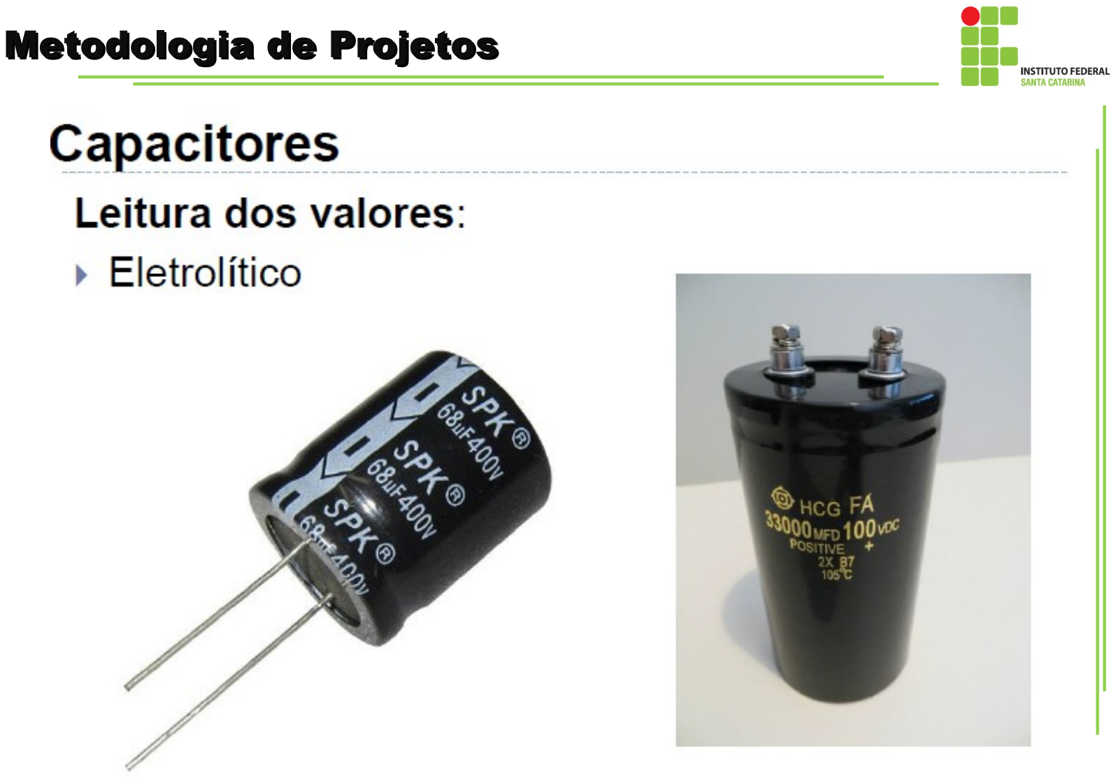
[picture p172: page 45]

Comparativo Capacitor Filme x Eletrolítico:

- Capacitores de Filme apresentam menor resistência série equivalente (Redução de Perdas);
- Capacitores de Filme suportam tensão maiores (até 1.600 Vdc);
- Capacitores de Filme apresentam maior vida útil:
- Capacitores eletrolíticos têm vida útil típica de 6,5 kh com operação nominal
- Capacitores de filme têm vida útil típica de 100 kh com operação nominal
- Capacitores de Filme suportam alta ondulações de corrente;
- Capacitores de Filme apresentam baixa capacitância por unidade;
- Capacitores de Filme apresentam alto volume (farad x volume);
- Capacitores de Filme apresentam custo relativo maior por farad;

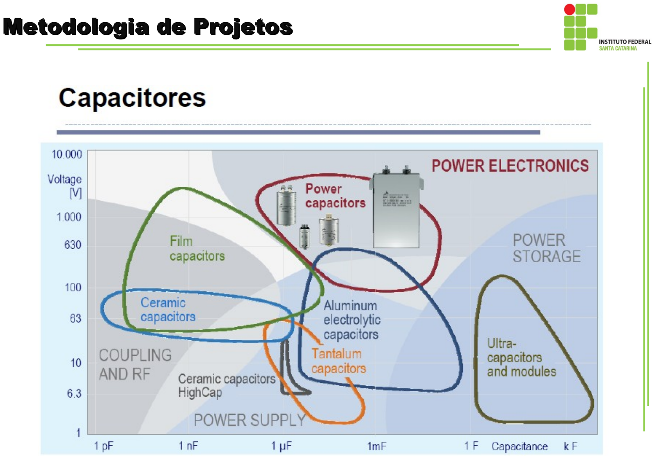
[picture p173: page 47]

Principais Fabricantes:
- EPCOS/TDK;

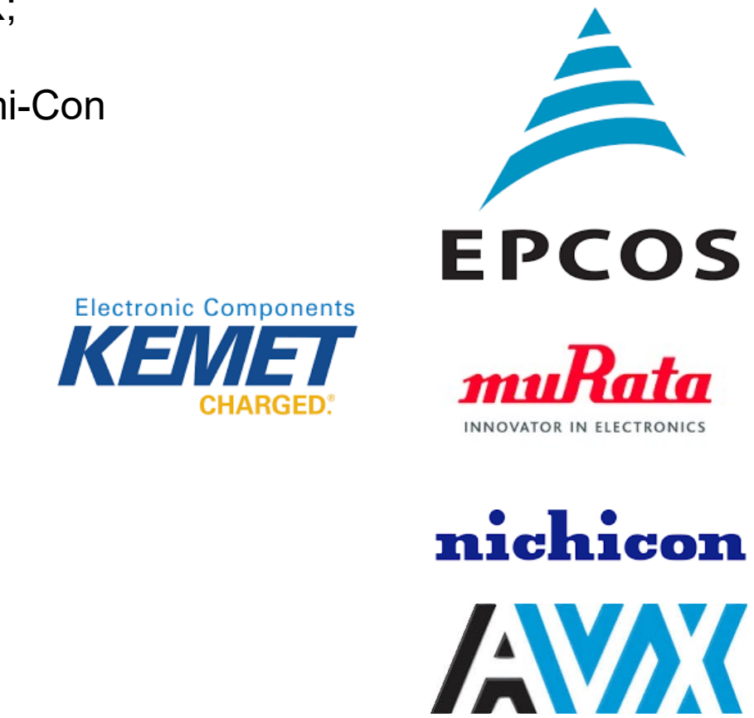
[picture p174: figure]

- United Chemi-Con
- Vishay;
- Nichicon;
- Kemet;
- Avx Corp;
- Murata;
- Panasonic;

Dimensionamento de Capacitor:

- Valor da Capacitância mínima para o projeto (∆Vc

e ∆Ic

);

- Tensão Máxima;
- Corrente Eficaz Máxima;
- Faixa de Temperatura (temperatura máxima);
- Perdas (observar a RSE corrente nas frequência);
- Custo, volume, espaço na PCI;

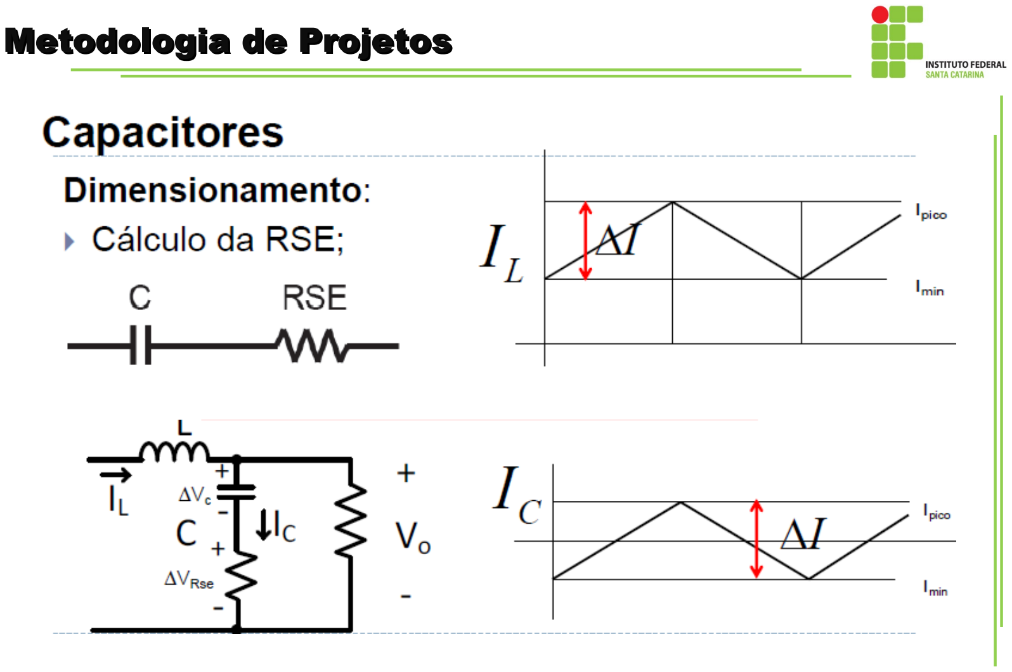
[picture p175: page 50]
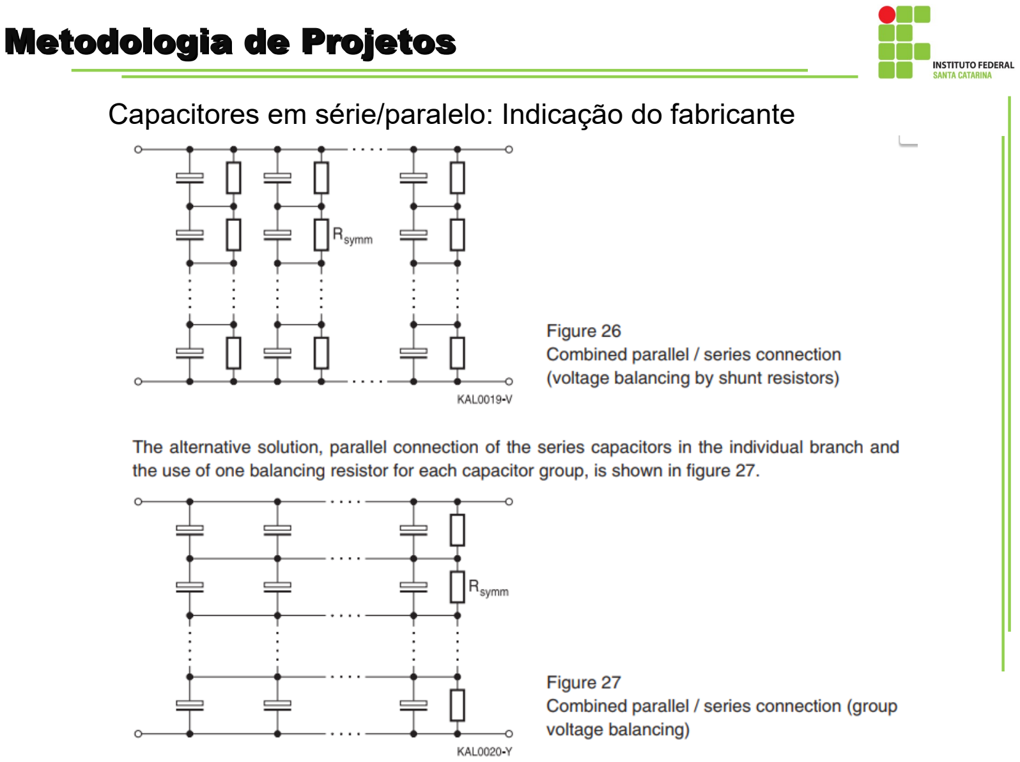
[picture p176: page 51]

Capacitores em série/paralelo: Indicação do fabricante

- Desenvolvimento completo do esquemático;

### - Projeto do Conversor/Produto:

- Escolha dos semicondutores:
- Diodos;
- Transistores;
- Projeto Térmico: Dissipadores, ventiladores e etc;
- Projeto dos Magnéticos;
- Projeto do circuito passivos: resistores, capacitores e etc;
- Projeto dos filtros de EMI;
- Proteções (corrente de in rush, surtos, sobrecorrente, sobretensão e etc);
- Circuitos auxiliares (sensores, driver e etc);
- Circuitos integrados dedicados, microcontrolador, DSP e etc;
- Desenvolvimento do Gabinete e ferramentas;
- Desenvolvimento da PCI:
- Protótipos;
- DFM;
- Inserção (PTH, SMD, misto);
- Montagem;
- Testes de produção
- Testes os protótipos;

### Metodologia de Projetos – Resumo

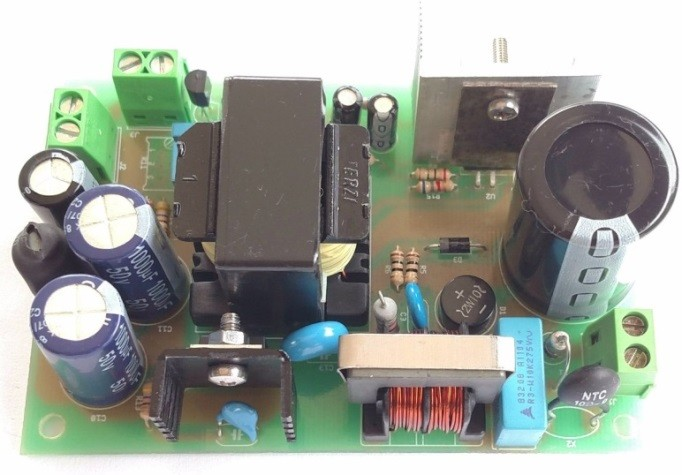
[picture p177: figure]
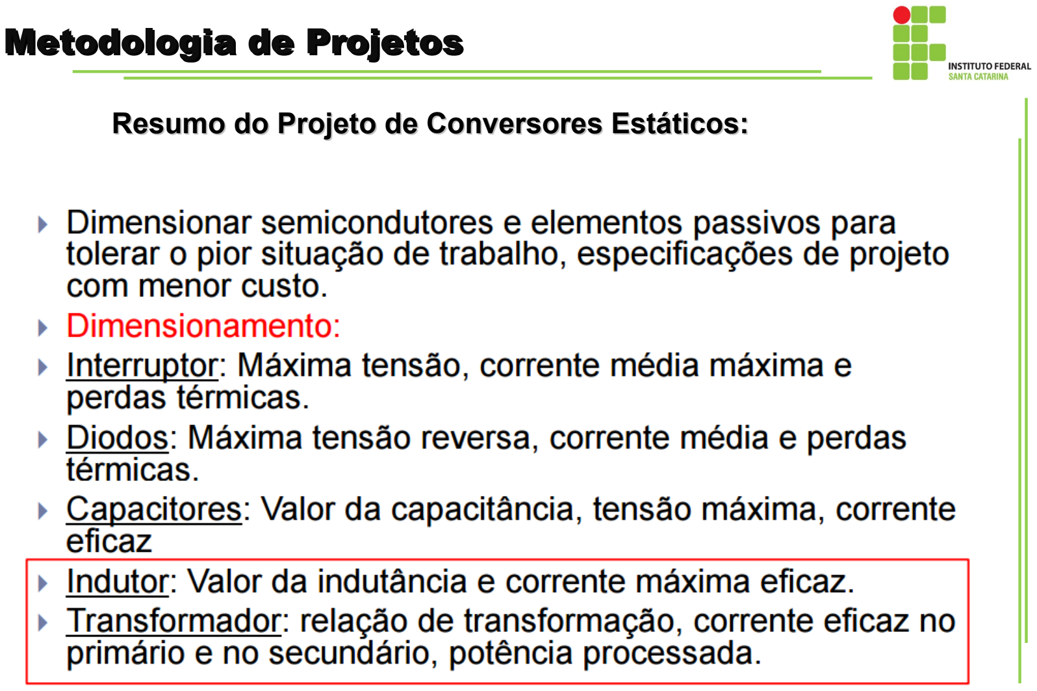
[picture p178: page 53]

Resumo do Projeto de Conversores Estáticos:

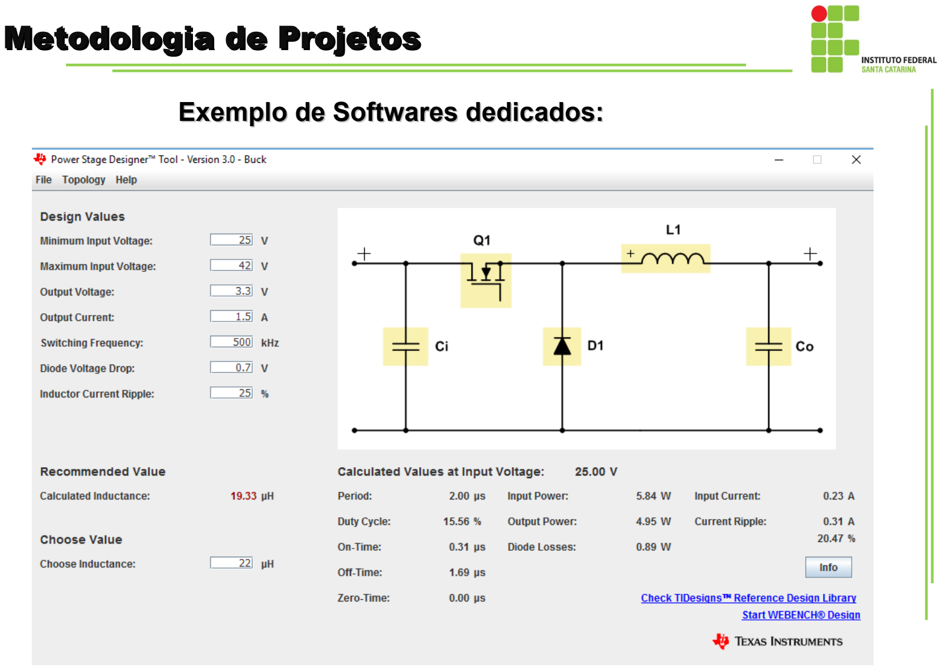
[picture p179: page 54]

Exemplo de Softwares dedicados:

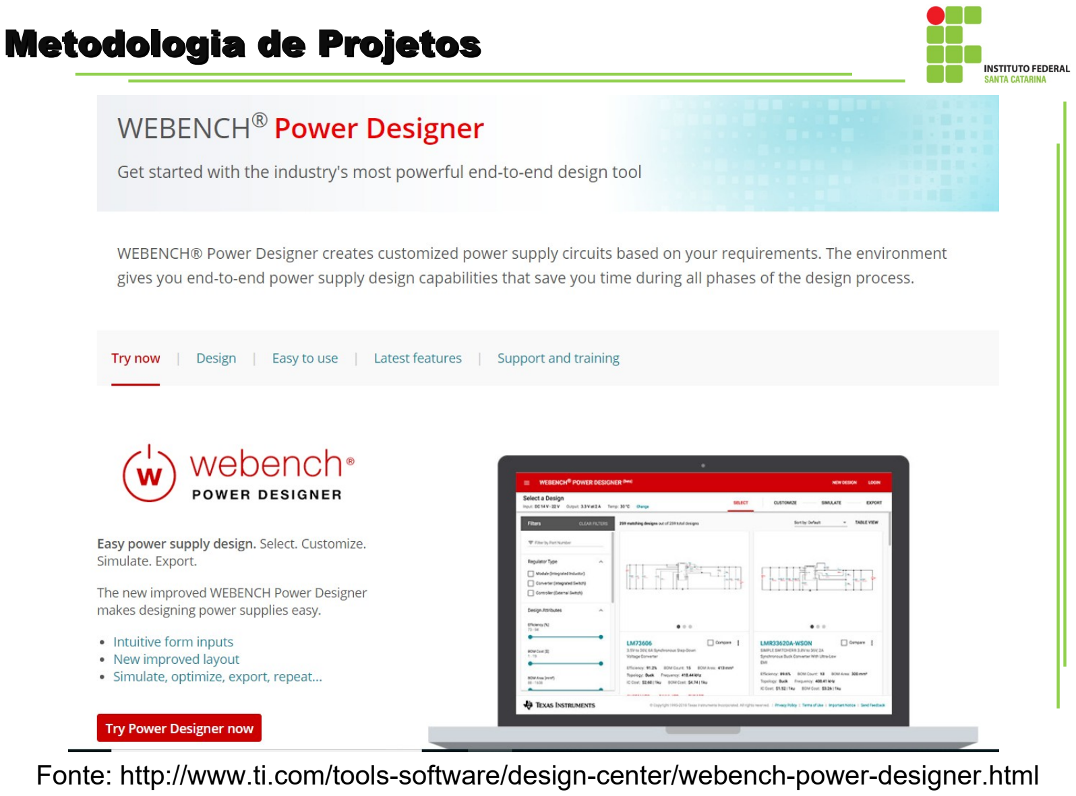
[picture p180: page 55]

Fonte: http://www.ti.com/tools-software/design-center/webench-power-designer.html

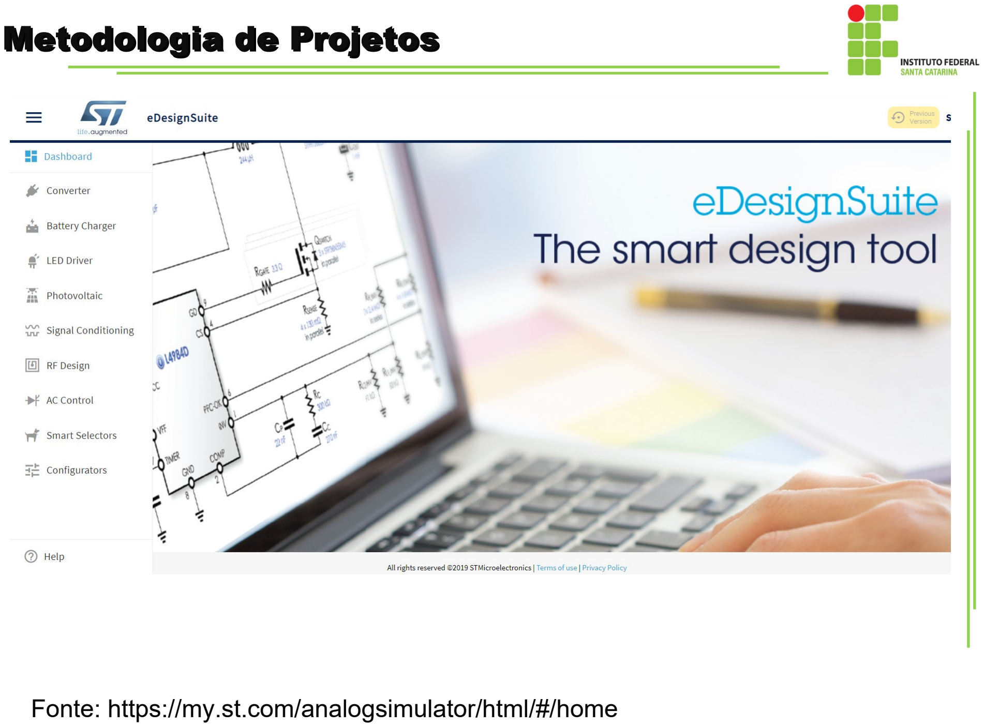
[picture p181: page 56]

Fonte: https://my.st.com/analogsimulator/html/#/home

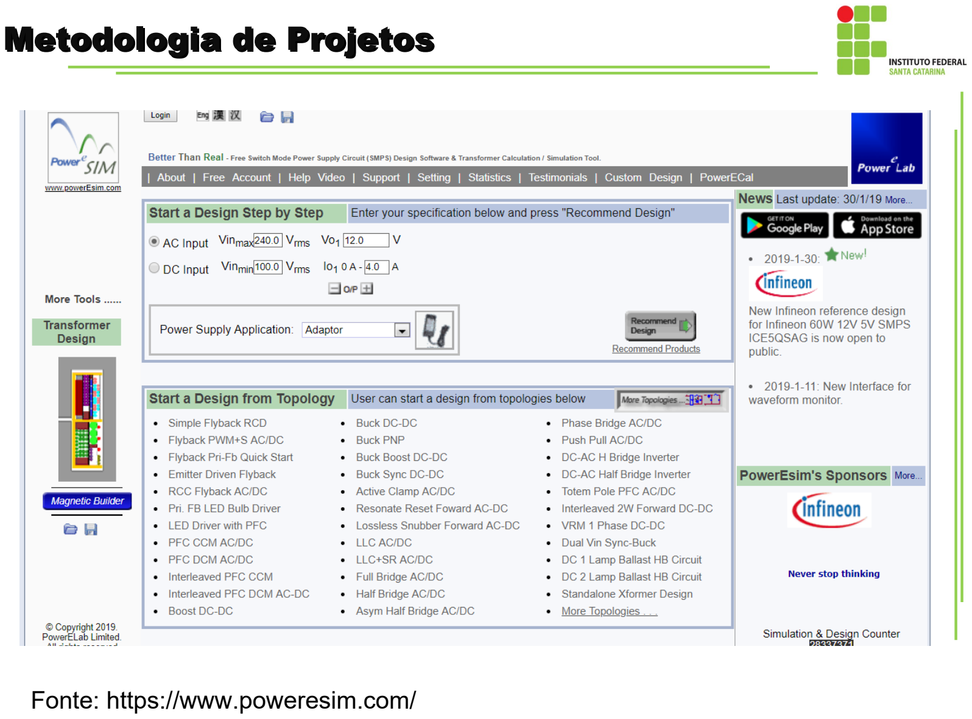
[picture p182: page 57]

Fonte: https://www.poweresim.com/

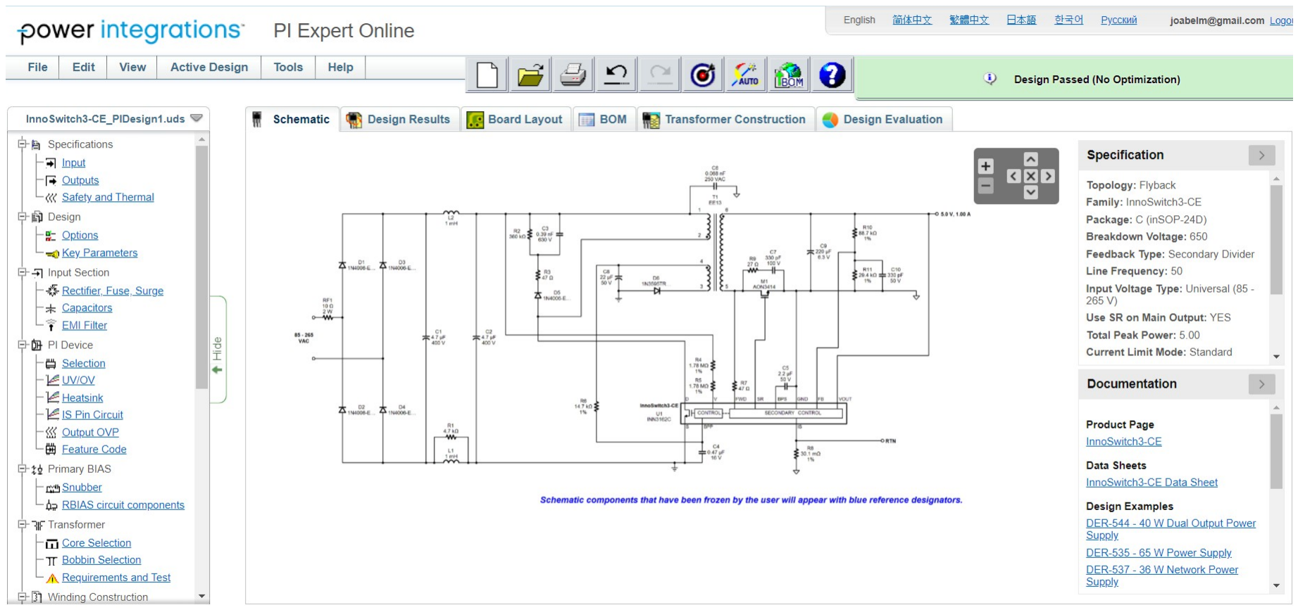
[picture p183: figure]

PI Expert Online – Power Integrations

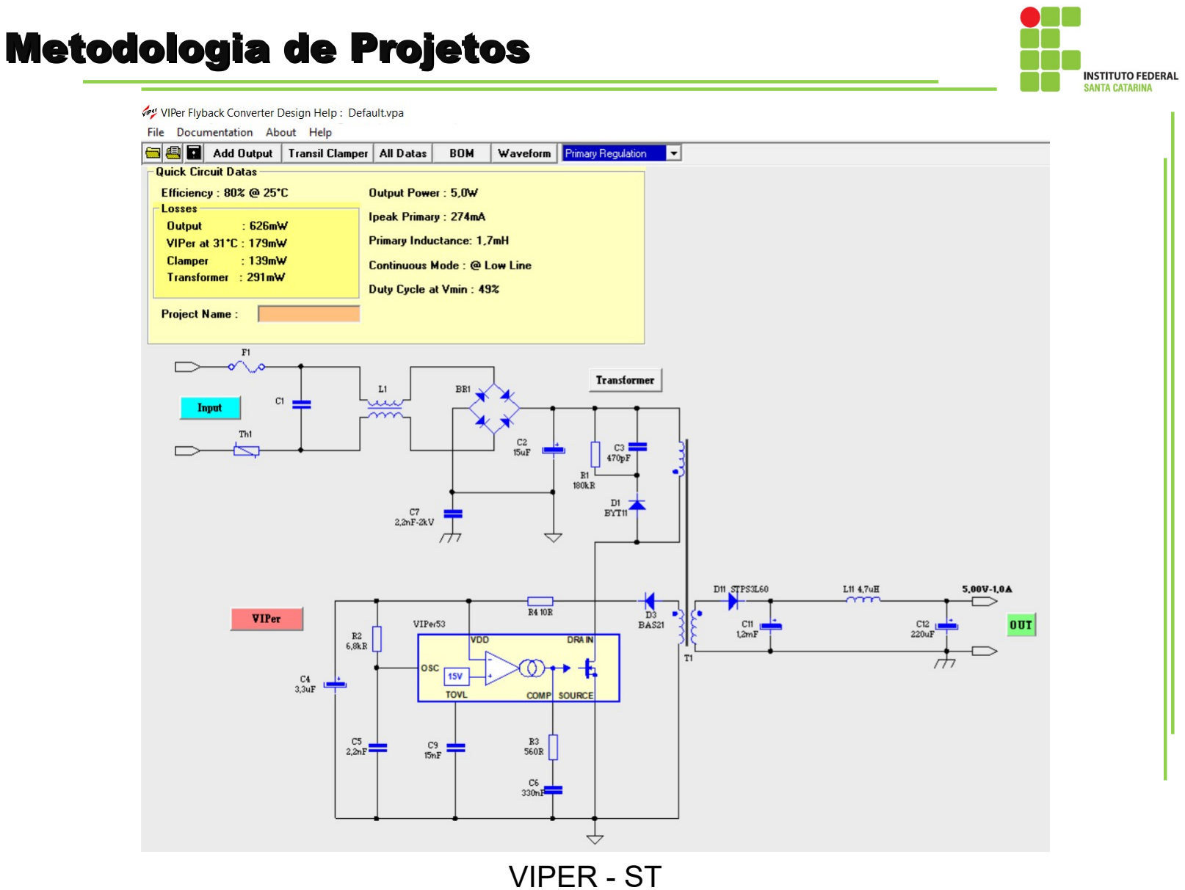
[picture p184: page 59]

VIPER - ST

Application Notes/ Reference Design:

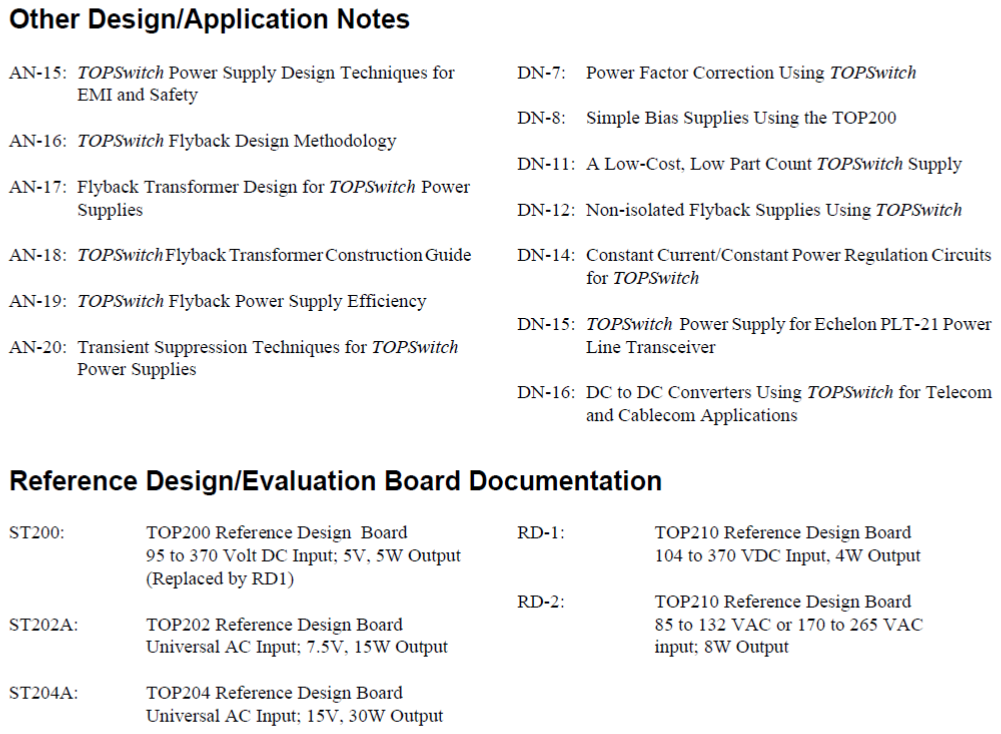
[picture p185: figure]

### Exemplo Projeto

Conversor Boost CC-CC modo de condução Contínua (MCC):

Vi

Li
D

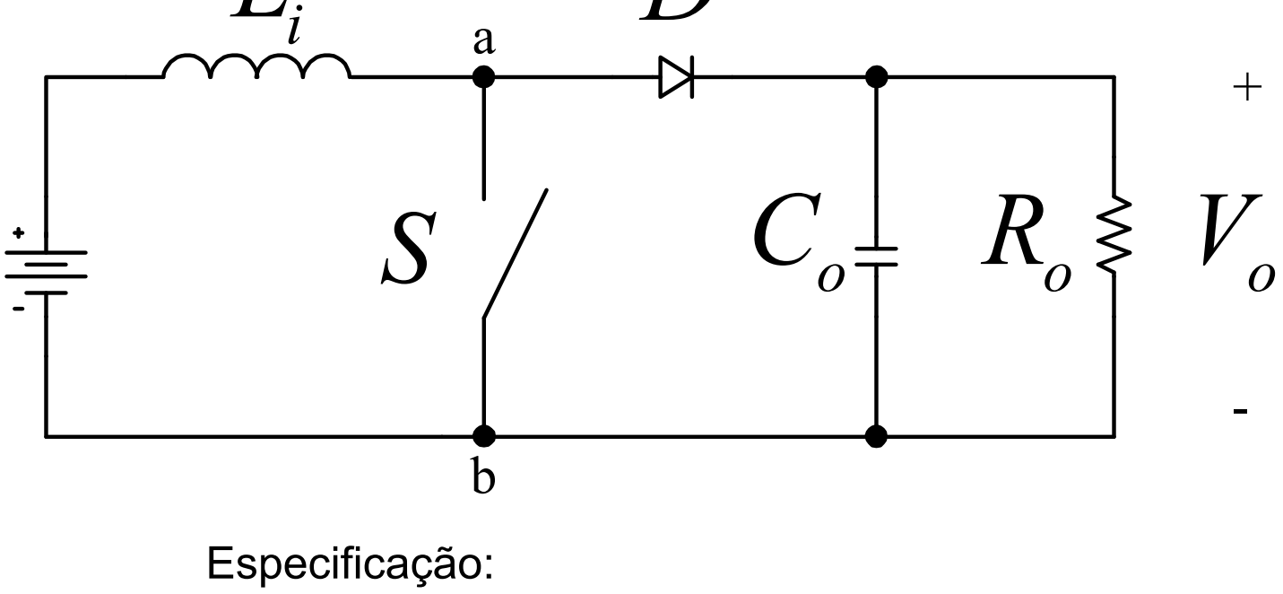
[picture p186: figure]
Especificação:

- Tensão de Entrada: 25 V;
- Tensão de Saída: 50 V;
- Potência de Saída: 100 W;
- Frequência de Comutação: 20 kHz;
- Indutância de Entrada (Li

): 800 uH;

Razão Cíclica:

### Cálculos Preliminares

25 1 | 1 | 0,5
50

in

o

V
D
V
= - | = - | =

Valor Médio e Eficaz da Corrente do Transistor:

S_med

S_ef

I | I | 0,5 4 2A
I | I | 0,5.4 2,82A
| L

L

D
D
= · = | · =
= | · = | =

Valor Médio da Corrente no Indutor:

L_MED in
in
P 100 I | = I = | = | =4A
V | 25

### Cálculos Preliminares

Tensão no Transistor bloqueado:
V | V 50V DS(OFF) | o = | =

Corrente de Pico no Transistor em Condução:

DS(ON) | L_MAX | L_MED
0,78 I | =I | =I | 4 | 4,39 A
2 | 2
ΔiL + | = + | =

Ondulação da Corrente do Indutor:

6 | 3
25 0,5 | 0,78A
800 10 20 10

in
iL

V D
L f | -
- ·
Δ = | = | =
- | · | · ·

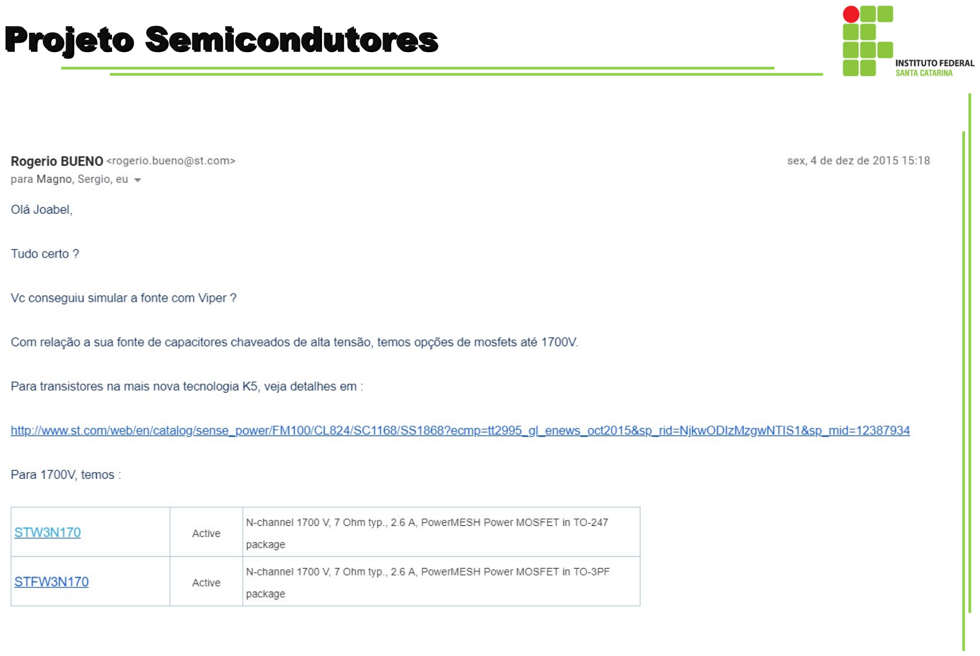
[picture p187: page 64]

### Projeto Semicondutores

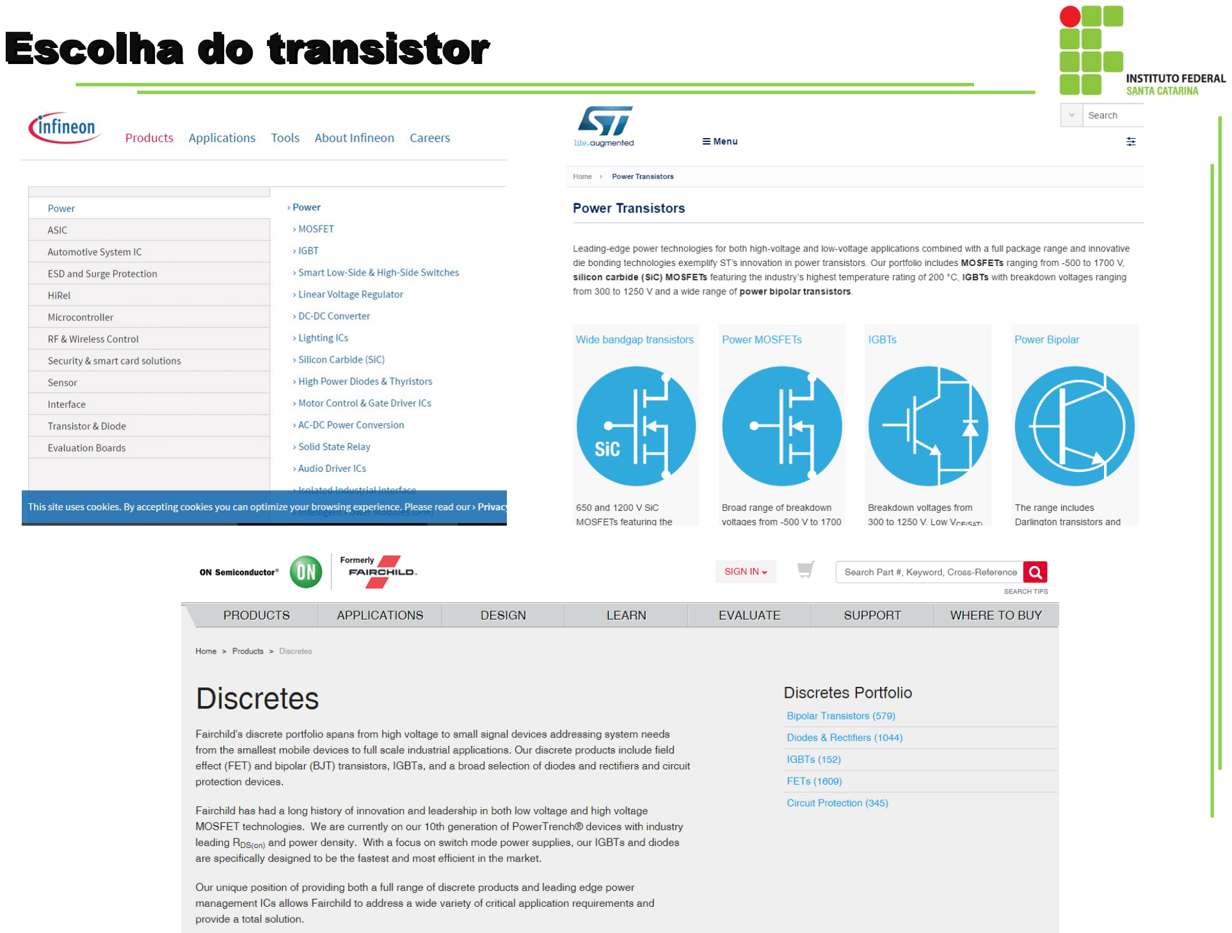
[picture p188: page 65]

### Escolha do transistor

Análise das grandezas envolvidas | Tensão no capacitor
C | out i | I ≅

Co
out

V
I Co
t

Δ
= ·
Δ

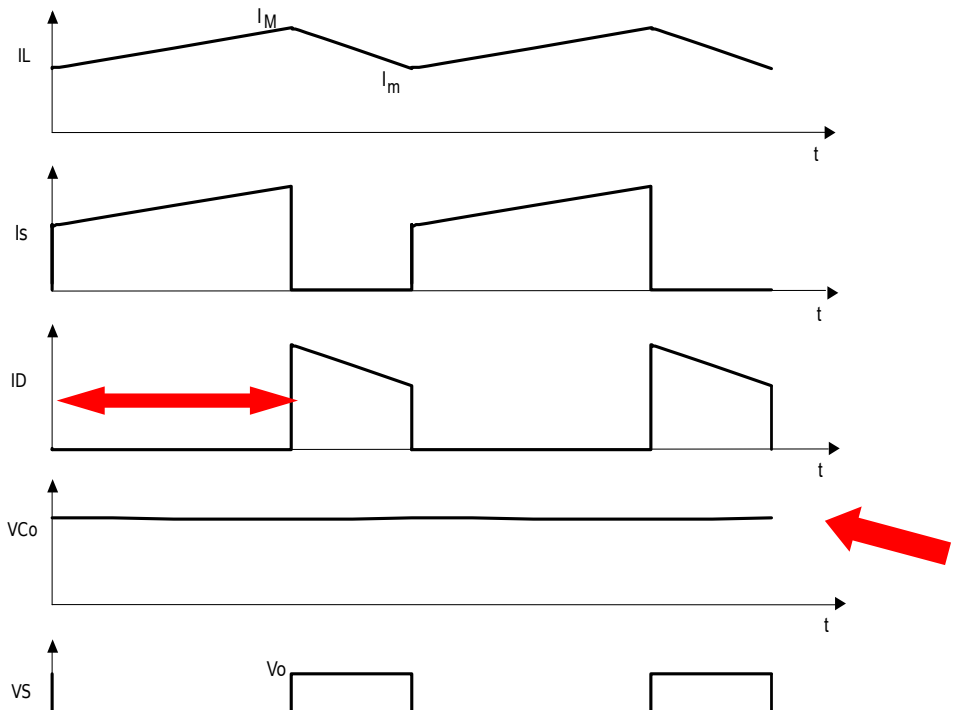
[picture p189: figure]
VCo

t
t | t 0 | 1

p/ primeira etapa

out | out
Co
I | t I | D V
Co | Co f
- Δ | · Δ | = | =
·

### Conversor CC-CC elevador - Boost

o | o | i
Co
o | o
I | V V V
C f | V
Δ | = | ·
·

Análise das grandezas envolvidas | Tensão no capacitor Efeito da RSE
RSE | D | Co CA
V | RSE i | RSE i = | · | = | ·
2 | 2
RSE | D | Co CAef
P | RSE i | RSE i = | · | = | ·

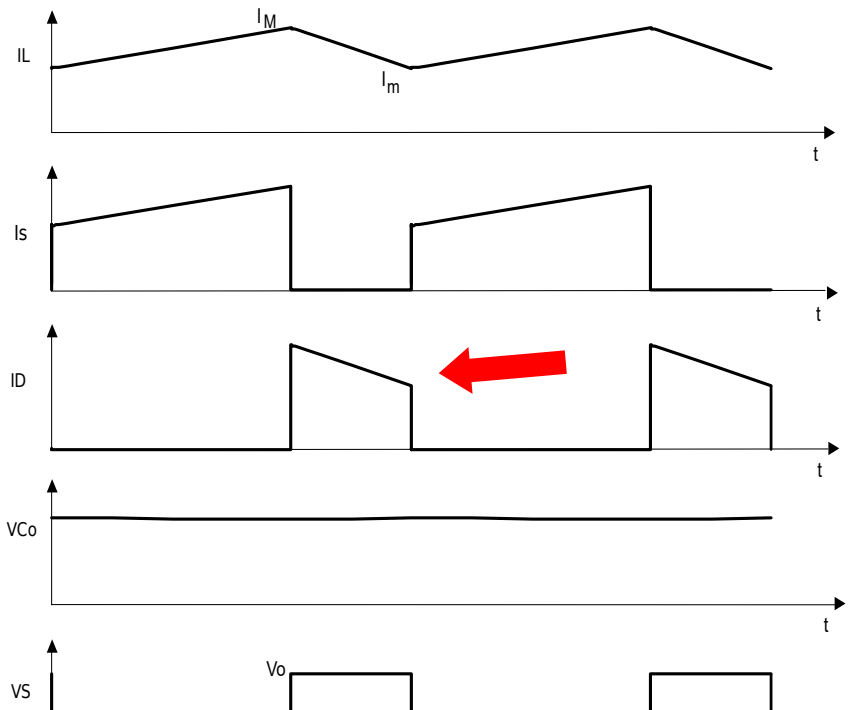
[picture p190: figure]
VCo

t
t | t 0 | 1

### Conversor CC-CC elevador - Boost

### Cálculos Preliminares

Cálculo do capacitor mínimo:

2 | 50 25 20
2,5 20 | 50
o | o | i
o
Co | o
I | V V C | F
V f | V | k

µ

= | · | = | · | =
Δ | · | · | ·
ΔV | 0,05 V 0,05 50 2,5 V Co | o
= | · = | · =
o | o | i
Co
o | o
I | V V V
C f | V
Δ | = | ·
·
o | o | i
o
Co | o
I | V V C
V f | V -
= | ·
Δ ·
V | V 50V Co | o
= | =
0,5 2 | 2A
1 | 1 0,5 Co | o

D
I I
D
= · | = · | =

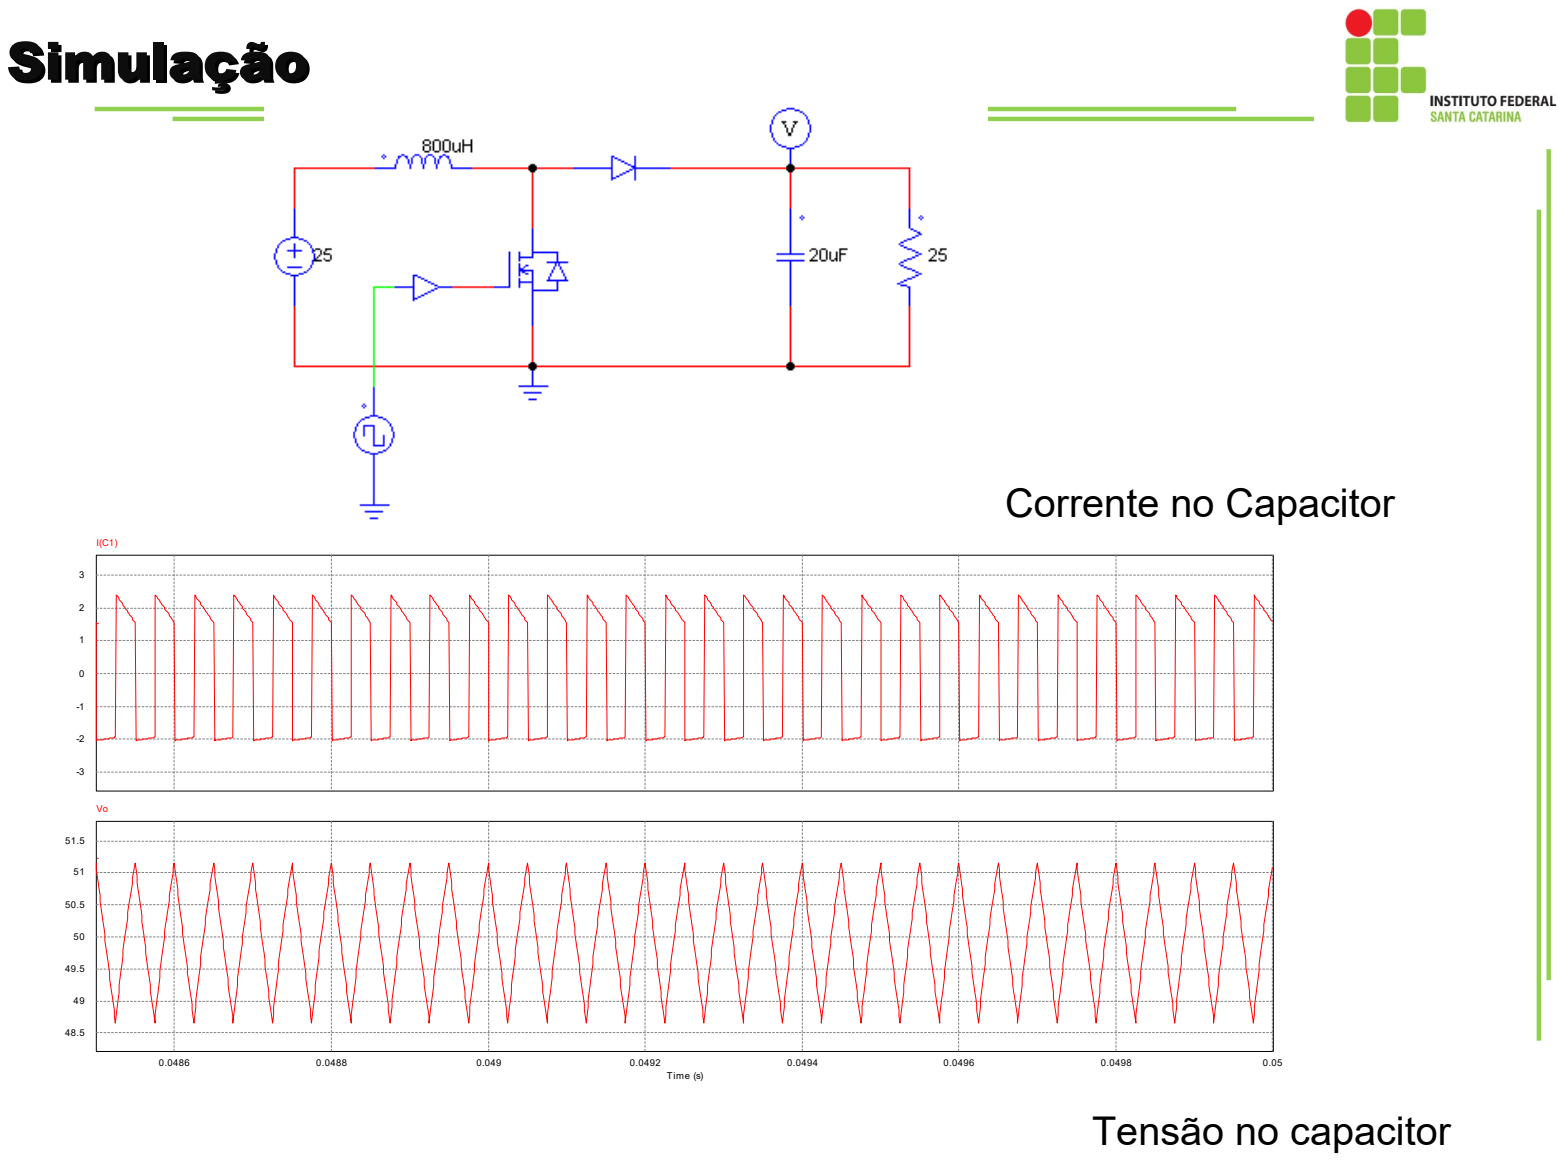
[picture p191: page 69]
Simulação; Time (s)

Corrente no Capacitor

Tensão no capacitor

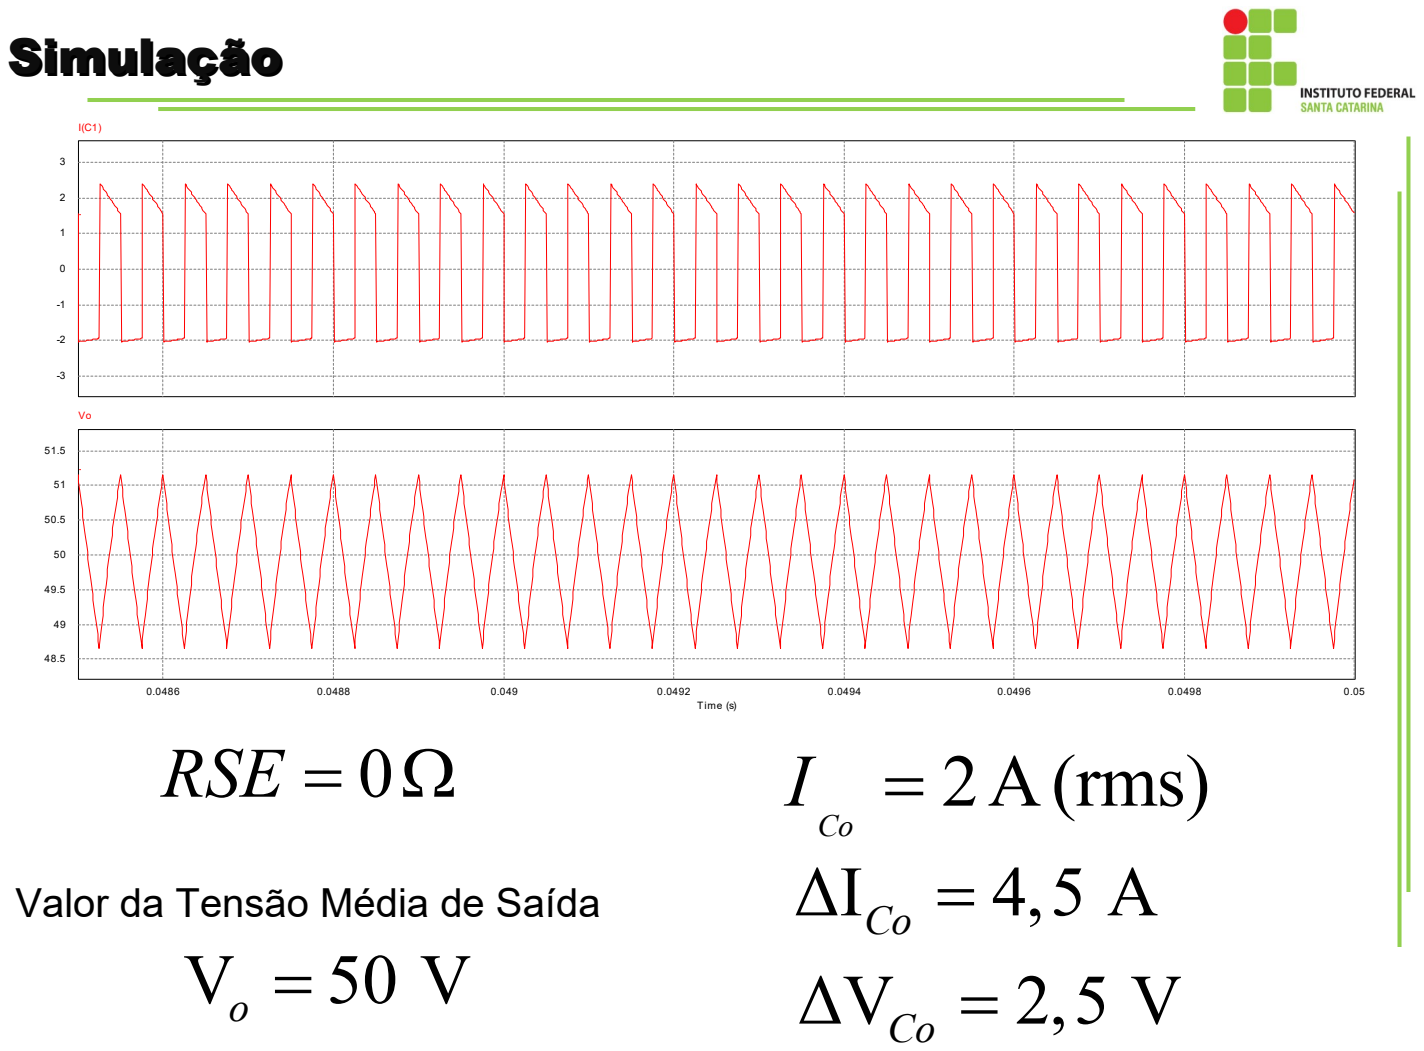
[picture p192: page 70]
Simulação; 2A (rms); Time (s); RSE = Ω0

Valor da Tensão Média de Saída

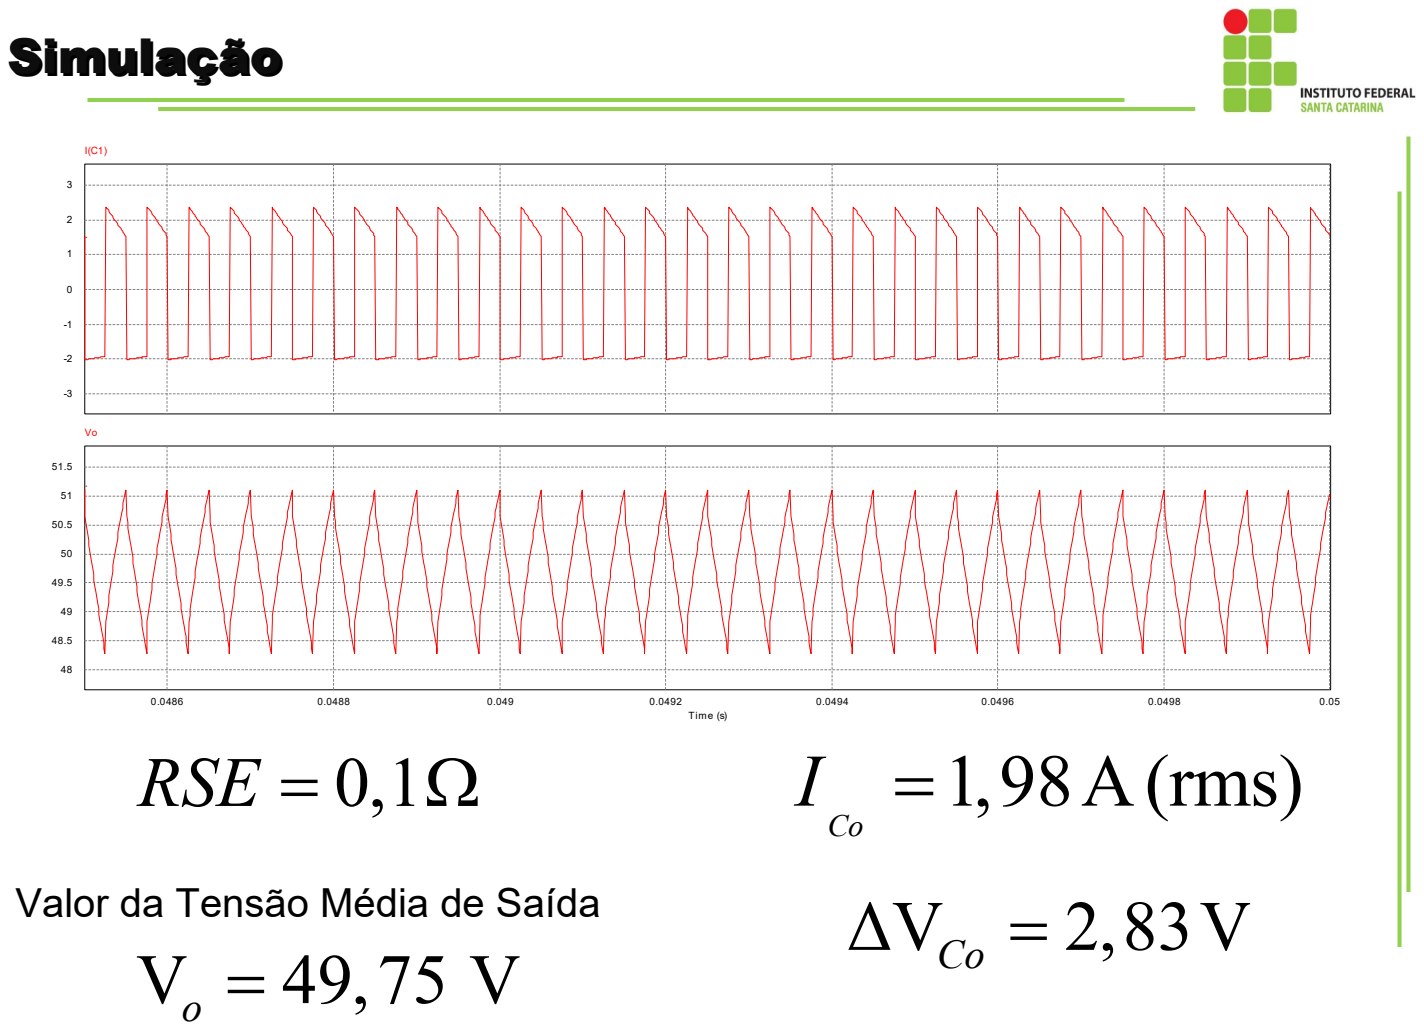
[picture p193: page 71]
Simulação; 1,98A (rms); RSE =; Time (s)

Valor da Tensão Média de Saída

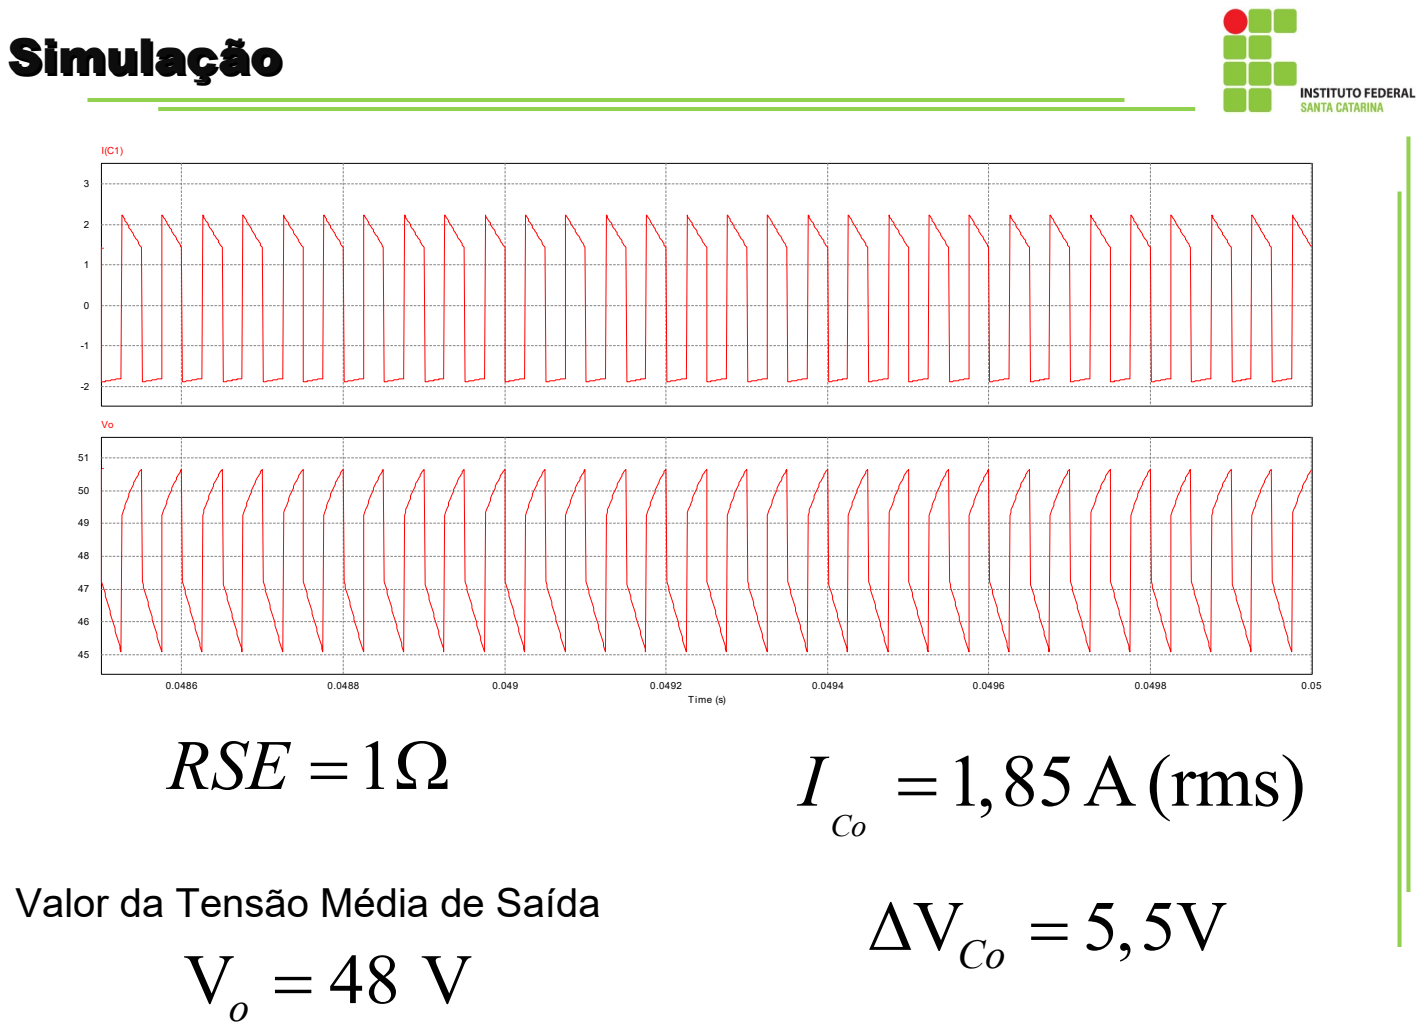
[picture p194: page 72]
Simulação; 1,85A (rms); RSE = Ω1; Time (s)

Valor da Tensão Média de Saída

### Escolha do Capacitor

## 2A (rms)

Co

I = | 20 C | F o
= µ V | 50V Co
= | f | kHz = 20
ΔV | Δ RSE | Co
= | · RSE I

max

0,2 ΔV | 0,50 0,125
Δ | 4

Co

Co

RSE
I

·
= | = | = | Ω

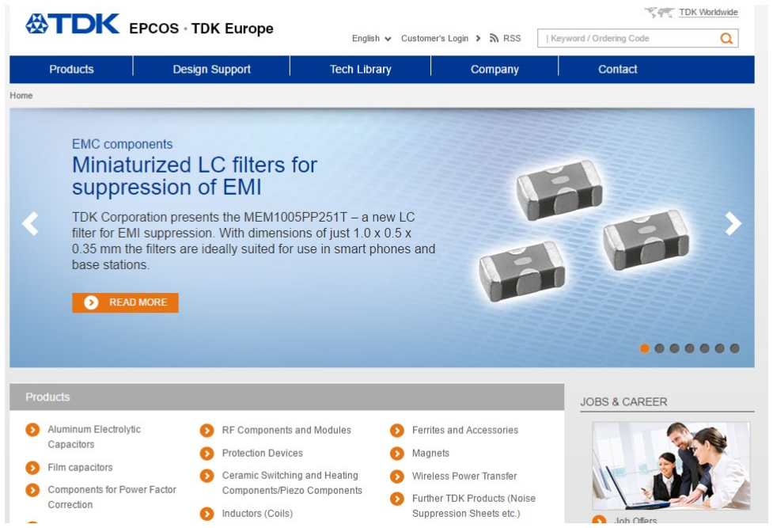
[picture p195: figure]
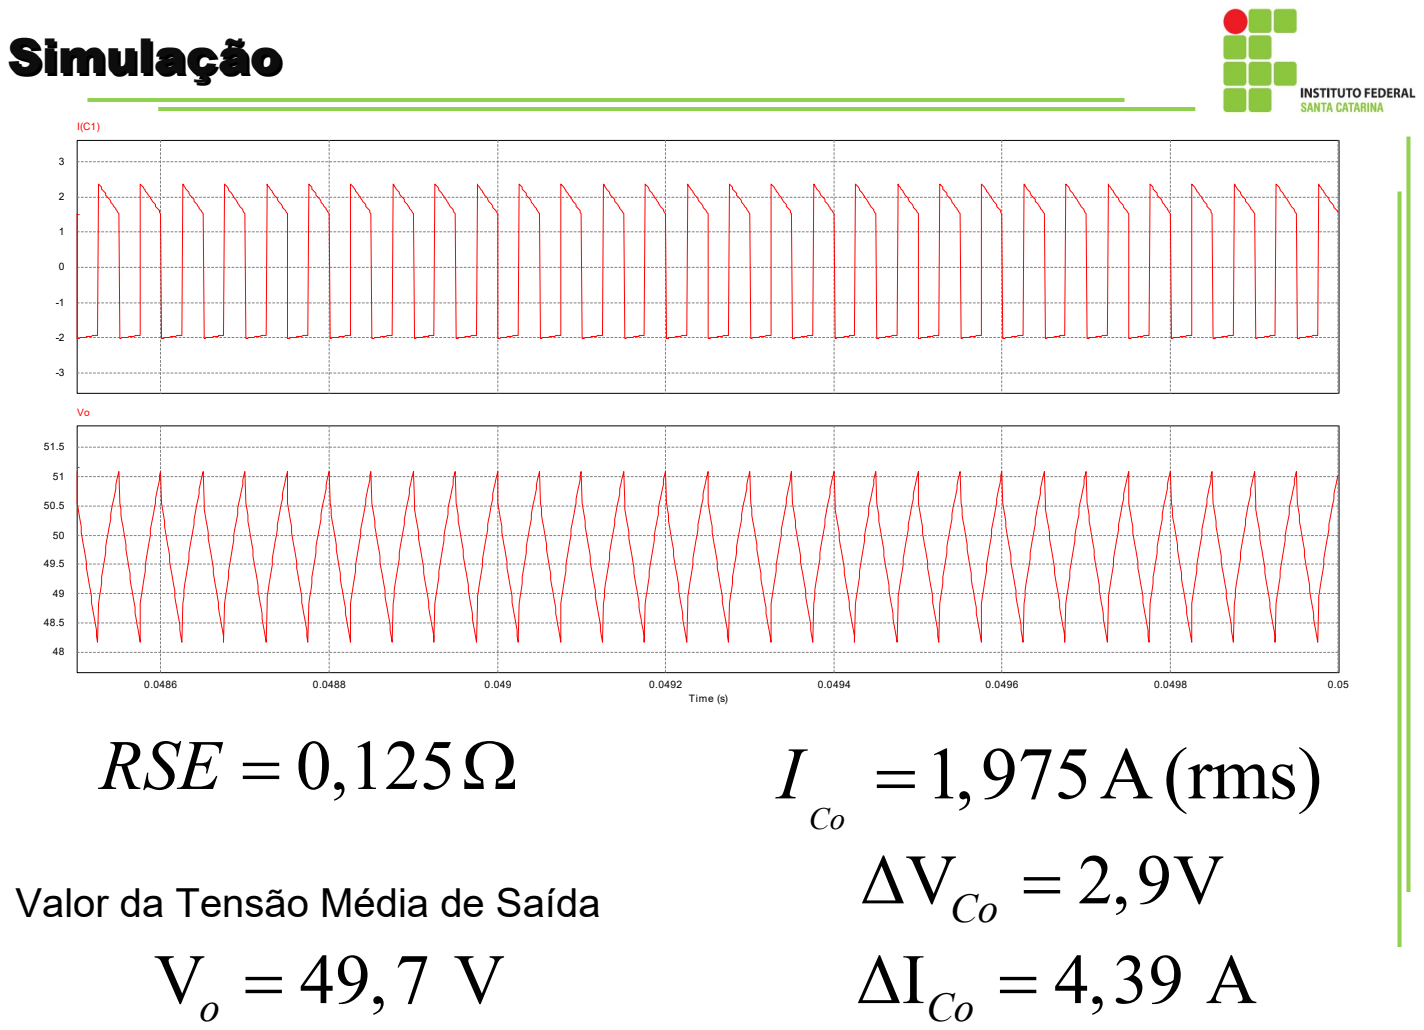
[picture p196: page 74]
Simulação; 1,975A (rms); RSE =; Time (s)

Valor da Tensão Média de Saída

### Tarefa 2


Especificação:
Tensão de Entrada: 36 V
Tensão de Saída: 12 V
Frequência de comutação: 50 kHz; Indutância L: 100 uH
Potência: 100 W;

Especificar:
- Diodo, transistor e capacitor
- Calcular Perdas no transistor
- Especificar os dissipadores, se necessário
