mateusalgado/IFSC_ELP2/00_Disciplina/Aula_04B_Projeto_Indutores_HF.pdf

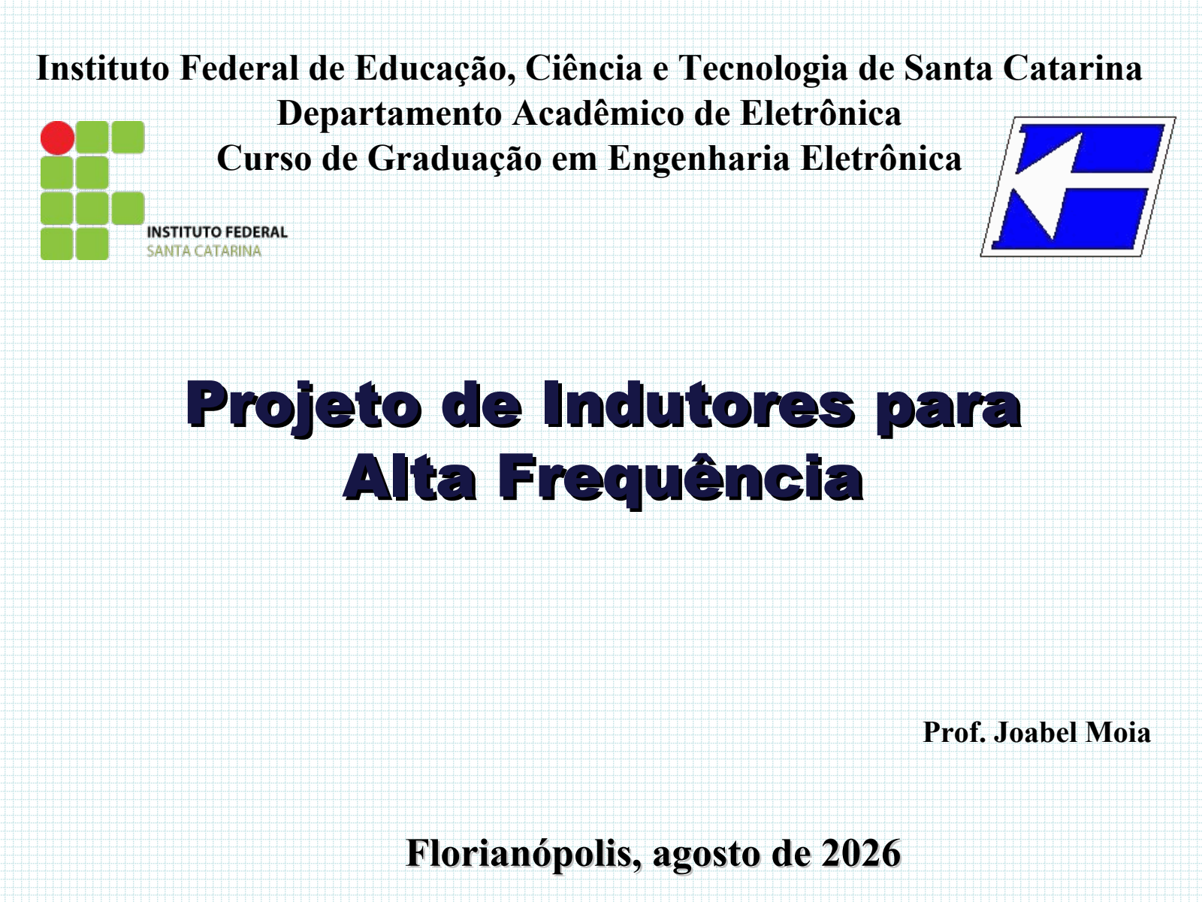
[picture p197: page 1]

# Projeto de Indutores para Alta Frequência

### Instituto Federal de Educação, Ciência e Tecnologia de Santa Catarina Departamento Acadêmico de Eletrônica Curso de Graduação em Engenharia Eletrônica

## Florianópolis, agosto de 2026

Prof. Joabel Moia

## Bibliografia para esta aula

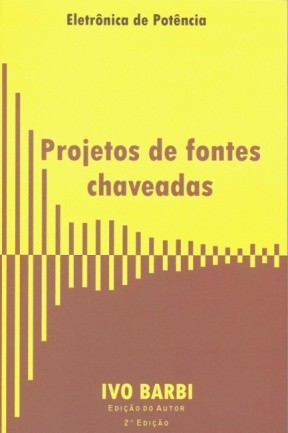
[picture p198: figure]

Introdução comparativa:
1. Conversor Buck;
2. Projeto de indutor com núcleo de ferrite.

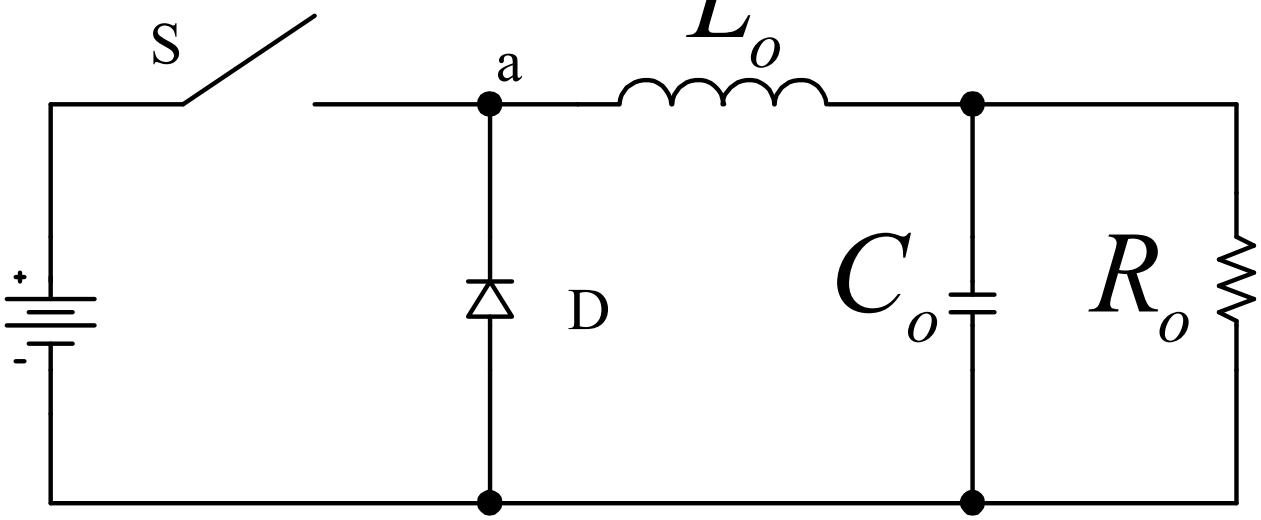
[picture p199: figure]

b

+

Vi

L

## o Vo

## Conversor Buck

Primeira etapa de funcionamento:
- Interruptor conduzindo;
- Diodo bloqueado;
- Energia sendo armazenada no indutor.

+

Vi

L

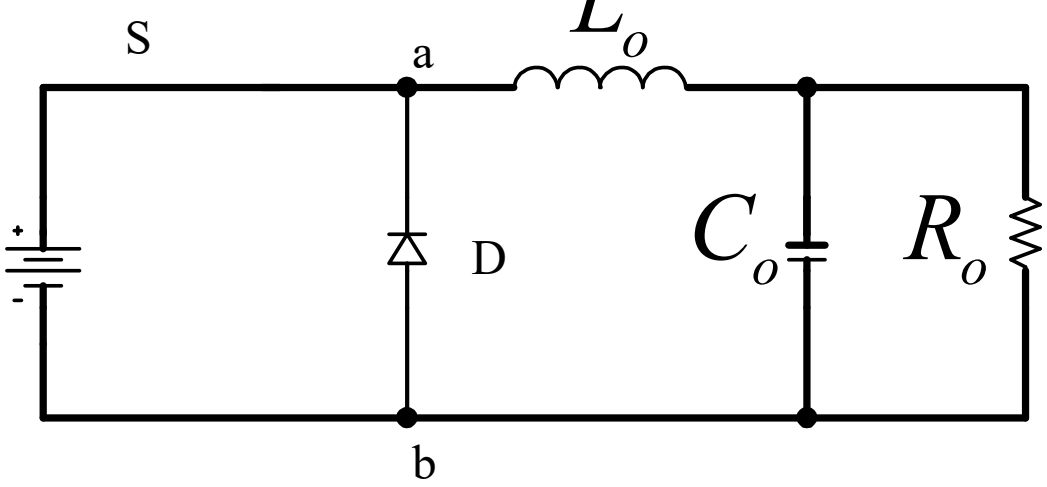
[picture p200: figure]

### o Vo

## Conversor Buck

Segunda etapa de funcionamento:
- Interruptor bloqueado;
- Diodo conduzindo;
- Energia armazenada no indutor sendo transferida para saída.

+

Vi

L

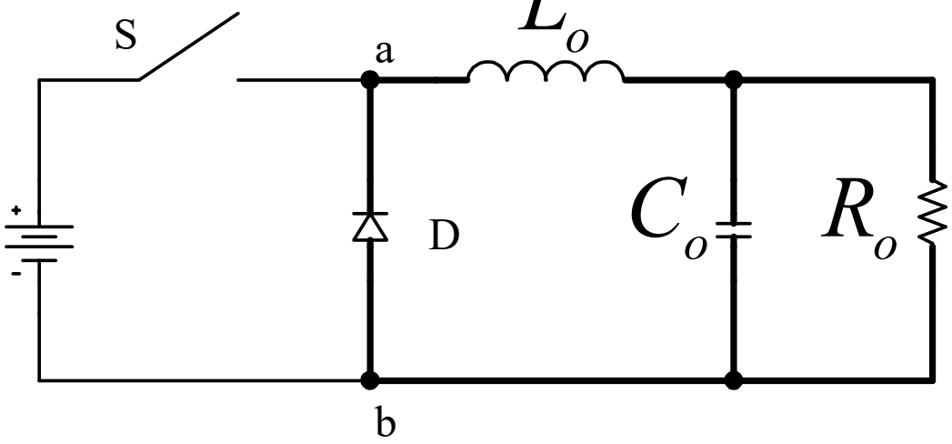
[picture p201: figure]

### o Vo

## Conversor Buck

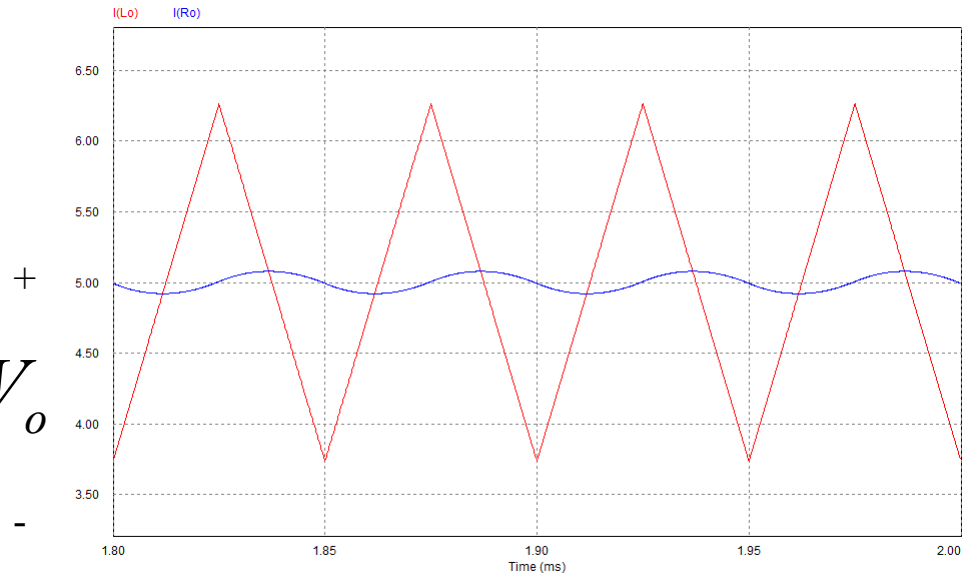
[picture p202: figure]

Ondulação de corrente em Lo

:

Vi

L

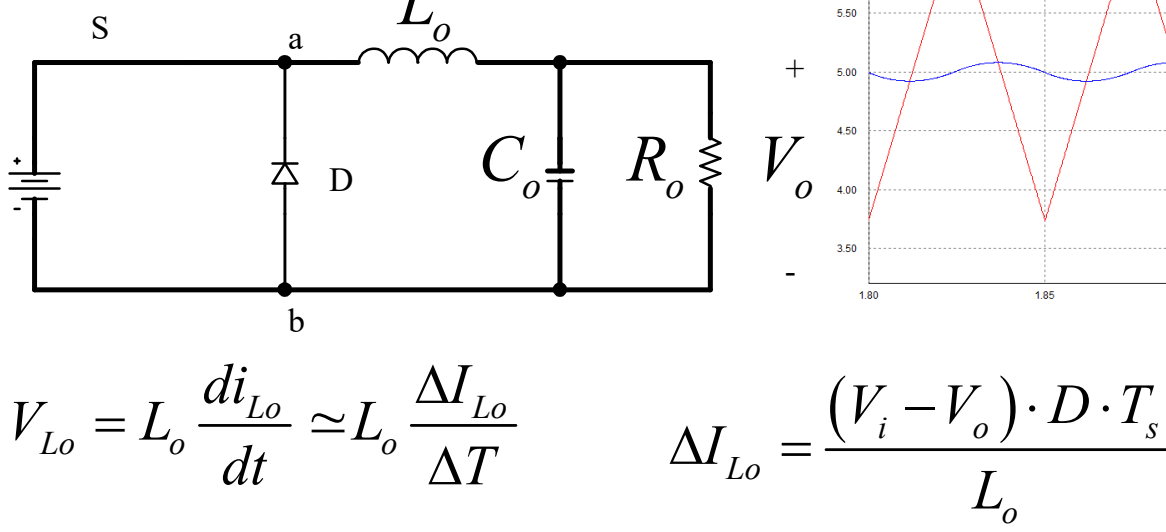
[picture p203: figure]

Lo
Lo
o

### V T I

L

- Δ Δ =
( | )
(1 | )
i | i | i
Lo
o | s | o | s
V D V D | V
I | D | D
L F | L F
- · ·
Δ = | = | · -
| · ·
_ max | 4

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
## Conversor Buck

## Projeto de indutores

O projeto de um indutor depende:
- Da frequência de operação;
- Da corrente no mesmo;
- Do regime de trabalho;
- Do material utilizado para o núcleo;
- Entre outros....

## Projeto de indutores com núcleo de ferrite

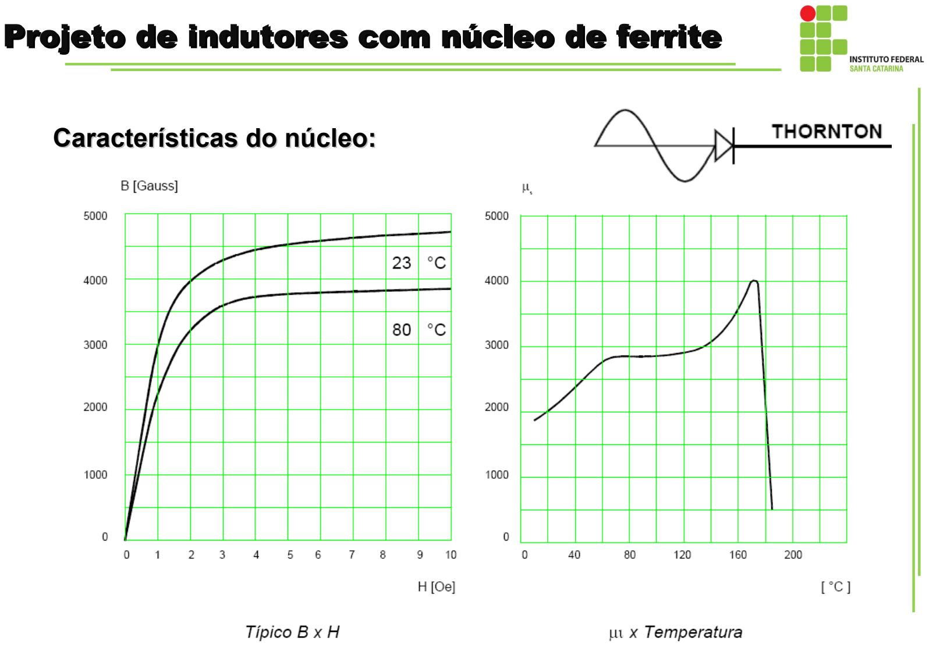
[picture p204: page 8]

Características do núcleo:

Montagem do núcleo (com entreferro):

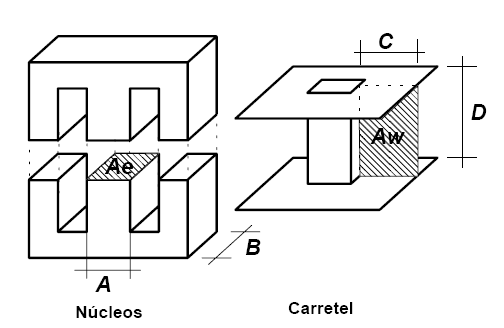
[picture p205: figure]

1) Exemplo: Dados de entrada:

Loef

Lo

2

100 | Indutância do indutor;
20 | Freqüência de operação;
10 | Corrente de pico;
I =6 | Corrente eficaz;

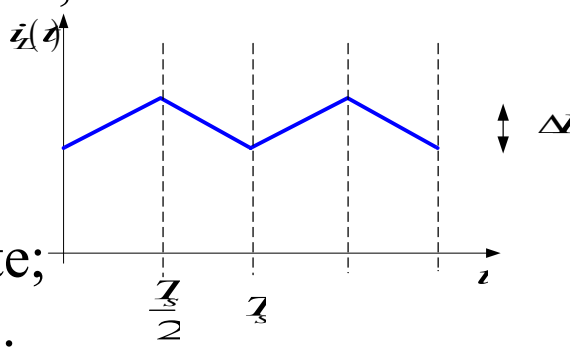
[picture p206: figure]

I =1 | Ondulação de corrente;
k=0,7 | Fator de enrolamento;
J=450 / | Densidade de corrente;
B=0

o

s

Lop

L | H
F | kHz
I | A
| A
| A
| A cm

=
=
=

Δ

µ

7
o
,35 | | Densidade de fluxo máximo;
=4 10 | / / | Permeabilidade no vácuo.

T

## Wb A m -

µ π ·

2) Escolha do núcleo:
1
0,35 0,035
10

Lo

Lop

I
B B | T
I

Δ
Δ = | = | =
4 | 6 | 4
4
10 | 100 10 10 6 10 | 0,544
| 0,7 0,35 450
L I | I o | Lop | Loef AeAw | cm

## k B J

- | · | · | · | · · ·
= | = | =
- · | · | ·
Núcleo | Ae (cm² ) | Aw (cm² ) | le (cm) | lt (cm) | ve(cm³ ) | AeAw (cm⁴ )
E-20 | 0,312 | 0,26 | 4,28 | 3,8 | 1,34 | 0,08
E-30/7 | 0,60 | 0,80 | 6,7 | 5,6 | 4,00 | 0,48
E-30/14 | 1,20 | 0,85 | 6,7 | 6,7 | 8,00 | 1,02
E-42/15 | 1,81 | 1,57 | 9,7 | 8,7 | 17,10 | 2,84
E-42/20 | 2,40 | 1,57 | 9,7 | 10,5 | 23,30 | 3,77
E-55 | 3,54 | 2,50 | 1,2 | 11,6 | 42,50 | 8,85

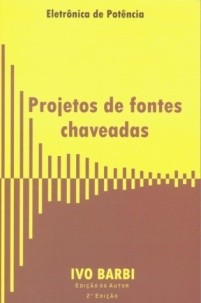
[picture p207: figure]

3) Cálculo do número de espiras:
4 | 6 | 4 10 | 100 10 10 10 | 24espiras
0,35 1,20

o Lop

e

L I
N
B A

- | · | · | · ·
= | = | =
- ·
4) Cálculo do entreferro:
2 | 2 | 2 | 7 | 2

6

10 | 24 4 10 1,20 10 | 0,087
| 100 10
o | e

o

N | A lg | cm
L
µ | π

- · · | · · | · | ·
= | = | =
·

5) Perdas no núcleo:

5

10

4 10
4 10

H

E

K
K

= ·
= ·
( | )
2,4 | 2 P | B | K F K F | V nucleo | H | s | E | s | e = Δ | · | · + | · | ·
( | )
2,4 | 5 | 10 | 2 0,035 | 4 10 20000 4 10 | 20000 8 Pnucleo
- | - = | · · | · | + · | · | ·
2,46 P | mW nucleo =

6) Profundidade de penetração:
7,5 | 7,5 | 0,053
20000 s

cm
F
Δ = | = | =
2 | 2 0,053 0,106 Dfio | cm max
= · Δ = · | =

Não poderá ser utilizado condutor com diâmetro maior que 0,106 cm. Portanto, podem ser utilizados condutores mais finos que o fio 18 AWG. Escolheu-se o condutor 22 AWG.

2
22 | 0,003255 A | cm cu

=

22 ρ = | Ω 0,000530 / cm

7) Escolha da seção dos condutores:
6 | 2
0,013
450

Loef I
S | cm
J
= | = | =

22

0,013 | 4 | 5

## 0,003255 fios

cu

S
N | fios | fios
A
= | = | = | → Maior que a área do fio 22 AWG.
8) Cálculo da resistência do fio:
22 | 0,000530 24 | 6,7 0,017
5

fio
fios
R | N | lt
N

ρ
= · | · = · | · | = | Ω

9) Perdas no cobre:
2 | 2 0,017 6 | 0,614 P | R I | W cobre | fio | Loef = | · | = | · =
10) Perdas totais:
2,46 | 0,614 0,616 P | P | P | m | W totais | nucleo | cobre = | + | = | + | =
11) Elevação de temperatura:
( | ) | ( )
0,37 | 0,37 23 | 23 1,02 | 22,832 / o Rt | AeAw | C W - | -
= · | = · | =
22,832 0,616 14,066 o Δ = · | = | · | = T Rt P | C total

12) Cálculo do fator de ocupação:
22 | 24 5 0,004013 | 2
0,688
0,7 | 0,7

fios
neces
N N | S
Aw | cm
- | · | · ·
= | = | =

0,688 0,809
0,85

neces
ocup

## Aw K

Aw

= | = | =

## Projeto de indutores

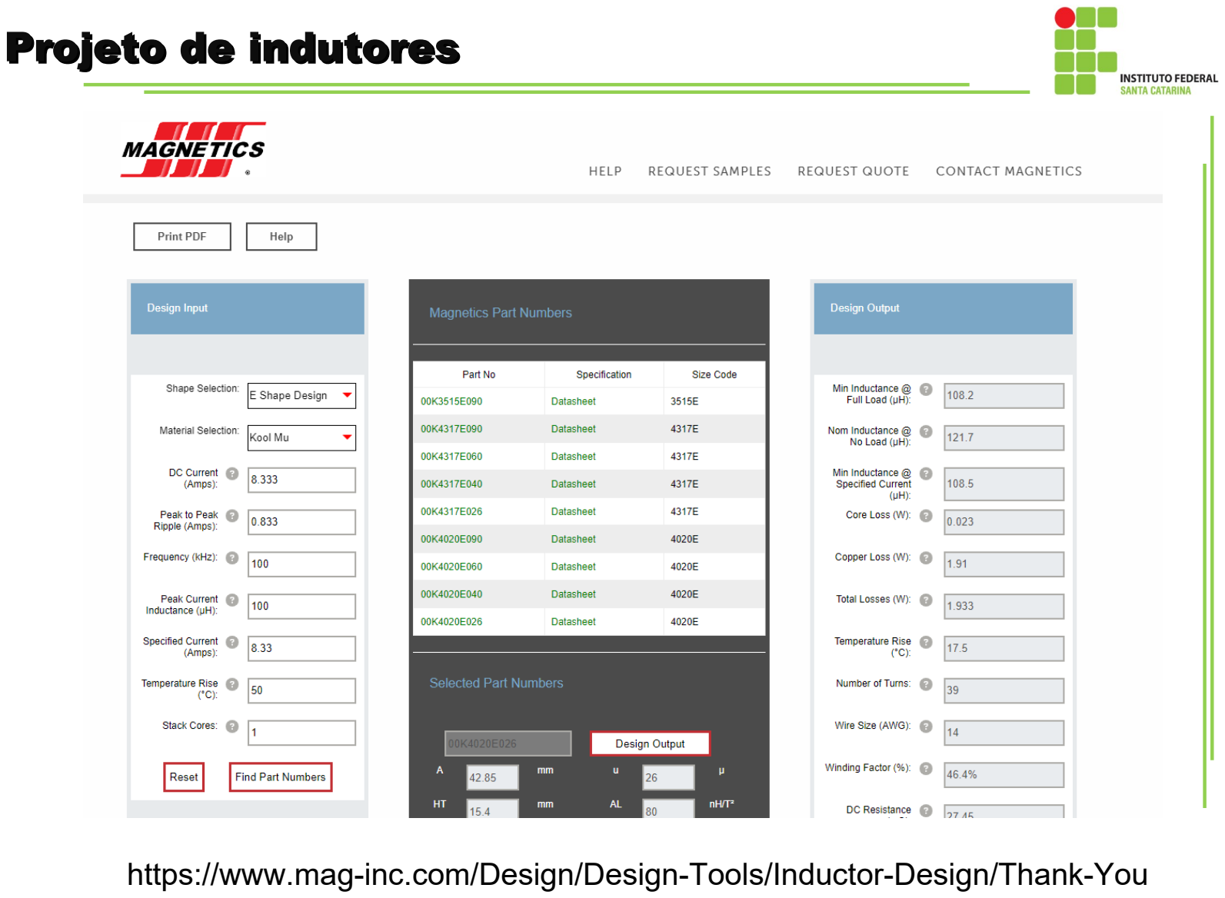
[picture p208: page 18]

https://www.mag-inc.com/Design/Design-Tools/Inductor-Design/Thank-You

## Projeto de indutores

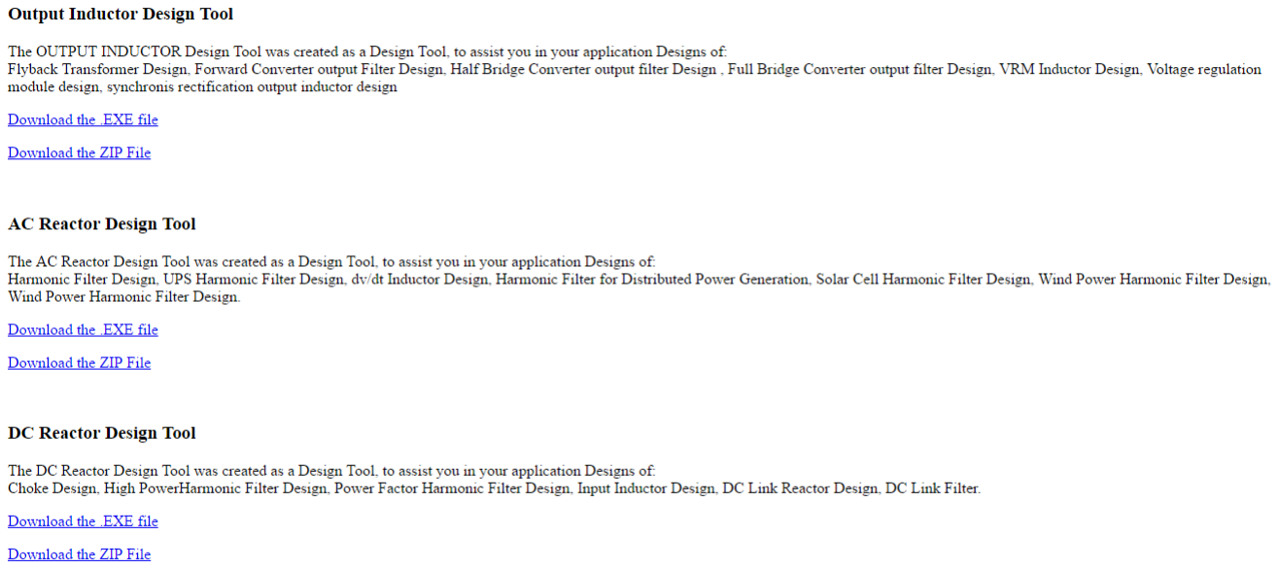
[picture p209: figure]

http://hitachimetals.metglas.com/

## Projeto de indutores

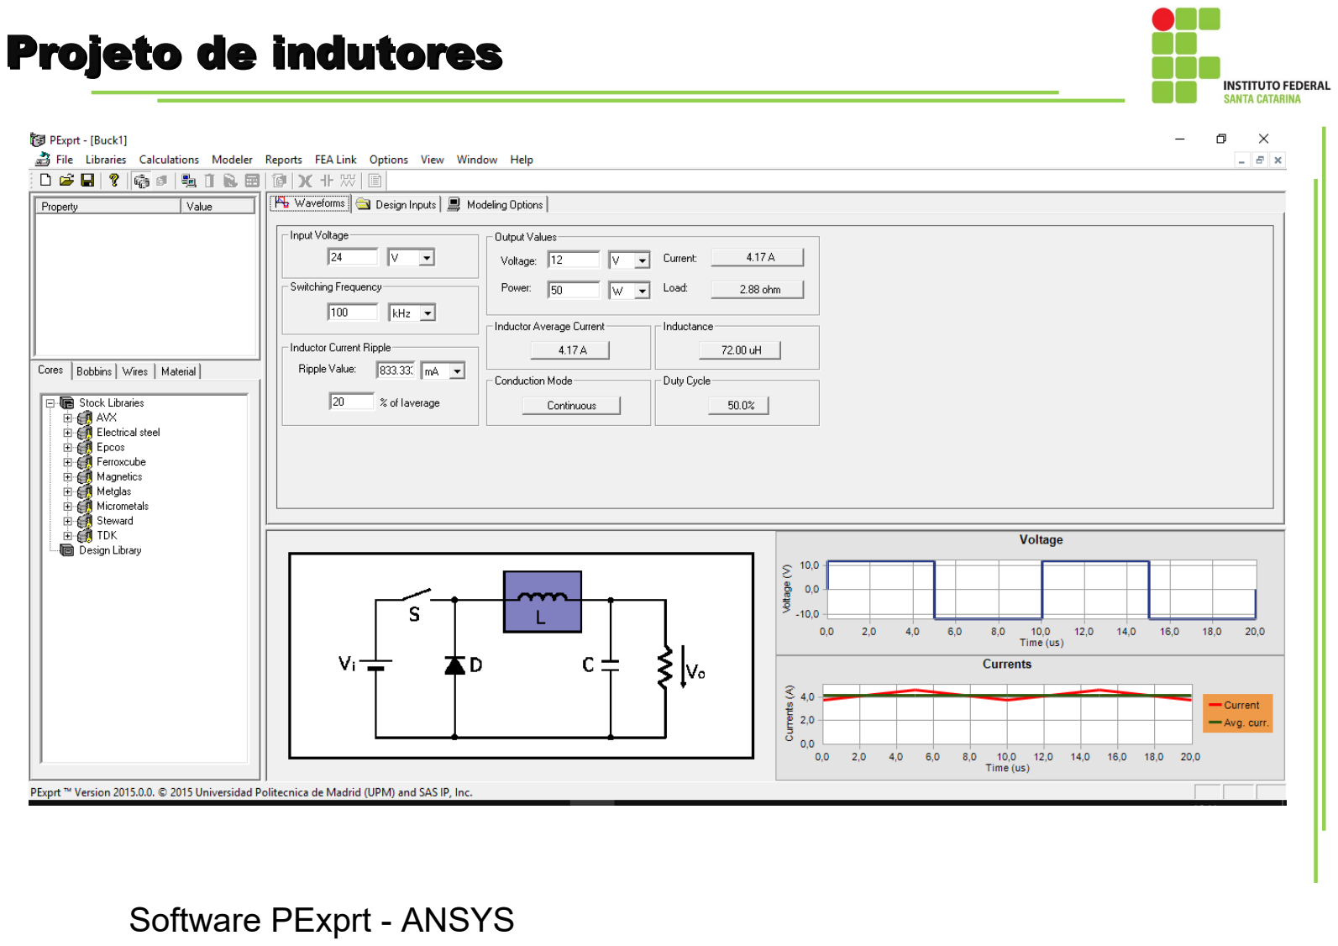
[picture p210: page 20]

Software PExprt - ANSYS

## Projetos de Elementos Magnéticos:

21

Especificações

- Indutância
- Corrente média
- Frequência de operação
- Máxima elevação de
temperatura
- Temperatura ambiente
- Fator de utilização da janela

Seleção do núcleo

- Material do núcleo
- Máxima densidade de campo magnético
- Produto de área do núcleo Enrolamentos
- Número de voltas
- Densidade de corrente
- Seleção dos condutores

Perdas

- Perdas no cobre
- Perdas nos enrolamentos se necessário

## Passos para projetar elementos magnéticos em alta frequência:

- Calcular os esforços de corrente e tensão em tal elemento;
- Calcular a variação do fluxo magnético;
- Definir qual material e fabricante será empregado;

## - Calcular o tamanho do núcleo mínimo:

- Definir um núcleo comercial;
- Calcular o número de espiras;

## - Calcular a área de seção transversal (bitola) do fio: - Calcular a quantidade de fio em paralelo, devido

ao efeito pelicular;
- Calcular a possibilidade de execução;
- Calcular as perdas magnéticas e do fio;
- Calcular a elevação de temperatura;

## Projetos de Elementos Magnéticos:

## Tarefa 3

## Conversor Buck:

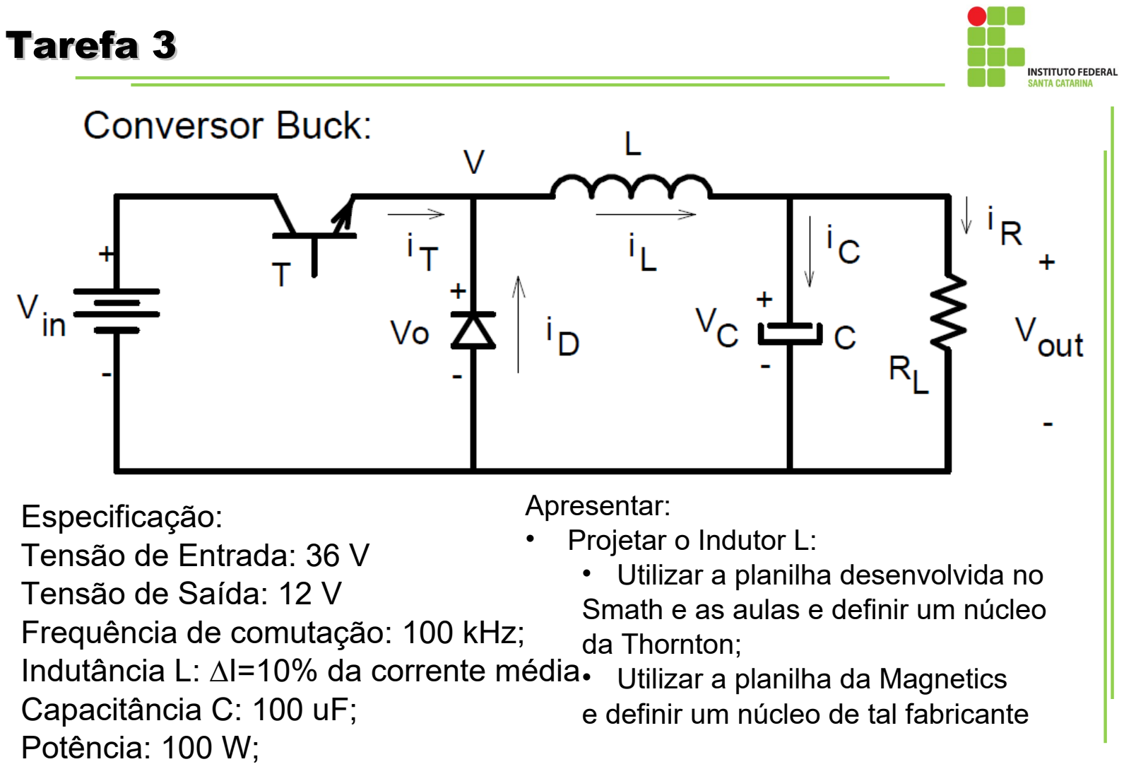
[picture p211: page 23]

Especificação:
Tensão de Entrada: 36 V
Tensão de Saída: 12 V
Frequência de comutação: 100 kHz; Indutância L: ∆I=10% da corrente média Capacitância C: 100 uF;
Potência: 100 W;

Apresentar:
- Projetar o Indutor L:
- Utilizar a planilha desenvolvida no Smath e as aulas e definir um núcleo da Thornton;
- Utilizar a planilha da Magnetics
e definir um núcleo de tal fabricante
