mateusalgado/IFSC_ELP2/Projeto_Flyback/revisoes/RevA_2026-10-19/07_Apresentacao/slides.pdf

# Fonte chaveada flyback 12 V / 3 A com entrada universal e controle por UC3845

Projeto Semestral – Tema II · Eletrônica de Potência II (2026-2)
Mateus Salgado Barboza Costa · Prof. Joabel Moia · IFSC – Engenharia Eletrônica Apresentação: 21/12/2026

## 1. Produto, requisitos e aplicações

Fonte de mesa CA-CC de 36 W (12 V / 3 A): roteadores, CFTV, fitas de LED, automação
Entrada universal 90–264 VAC, 50/60 Hz (validação em 127 e 220 V)
Saída 12 V ± 5 %, ondulação ≤ 120 mV, η meta 85 % (hipótese de cálculo 82 %)
Exigências do Tema II: ponte + filtro capacitivo, flyback com UC3845, proteções de surto, filtro de EMI, snubber, malha fechada
Entregas: teoria, simulação, esquemático, projeto físico, BOM/custo, layout, guia de montagem (Possibilidade I, pronta para a II)
Bloco | Escolha
Proteções | Fusível T2A, NTC 10 Ω, varistor S14K275
EMI | X2 220 nF + choke MC 10 mH + X2 100 nF, Y1 2,2 nF
Retificador | GBU4J + 100 µF/400 V
Flyback | STP13N65M2, E-30/7 (42:7:9), 65 kHz, MCD
Snubber | RCD 9,1 kΩ / 22 nF / UF4007
Saída | STPS20H100CT, 3 × 1000 µF ZLH + LC 3,3 µH/470 µF
Controle | UC3845 modo corrente de pico, TL431 + PC817
Fonte flyback 12 V / 3 A – UC3845 | 2 / 14

## 2. Metodologia (Aulas 02 a 08)

Entrada: simulação numérica do retificador com capacitor → Vbulk,mín = 94,6 V (90 V), I

in,rms = 0,86 A, FP 0,6 (Aula 06) Flyback em MCD na pior condição (Aula 04C, Barbi): Ip = 2Po

/(ηVb,mínDmáx

) = 2,16 A, Lp = 290 µH, Vr = 71 V → n = 6 Transformador: AeAw ≥ 0,45 cm⁴ → E-30/7 Thornton; lg

, Np

, Ns

, fios por efeito pelicular, perdas, ΔT, Kocup Capacitores: seis critérios da Aula 03 (Cmín

, RSE, Irms

, tensão, temperatura, custo) Semicondutores: pré-escolha por tensão/corrente (Aula 03), perdas e dissipadores (Aula 02, mesmo método das Tarefas 1 e 2) UC3845: RT/CT, Rsense, partida, auxiliar, driver, compensador tipo 2 com TL431 (Aula 05); snubber e proteções (Aula 07) Simulação LTspice em lote (20 casos) → comparação com a teoria → ajustes → esquemático e layout KiCad 10 (Aula 08, IPC-2221)
Tudo por scripts (Python, kicad-cli, pcbnew): qualquer parâmetro propaga até a placa

## 3. Transformador e esforços

Núcleo | AeAw | lg | Np
/Ns/Naux | P (W) | ΔT | Kocup
E-30/7 | 0,48 | 0,45 mm | 42 / 7 / 9 | 0,96 | 29 °C 0,46
E-30/14 1,02 | 0,23 mm | 21 / 3 / 4 | 1,42 | 32 °C 0,22
E-42/15 2,84 | 0,15 mm | 14 / 2 / 3 | 2,79 | 44 °C 0,08

Lp = 294 µH, B = 0,25 T, fio 1×23 AWG (prim.), 5×23 AWG (sec.)
Ip = 2,14 A; Is,pk = 12,9 A; Is,rms = 5,45 A; Ic,rms = 4,54 A Vds máx = 507 V (264 V, grampo 1,8·Vr

) → MOSFET 650 V (78
%)
Vrev diodo = 74 V → Schottky 100 V

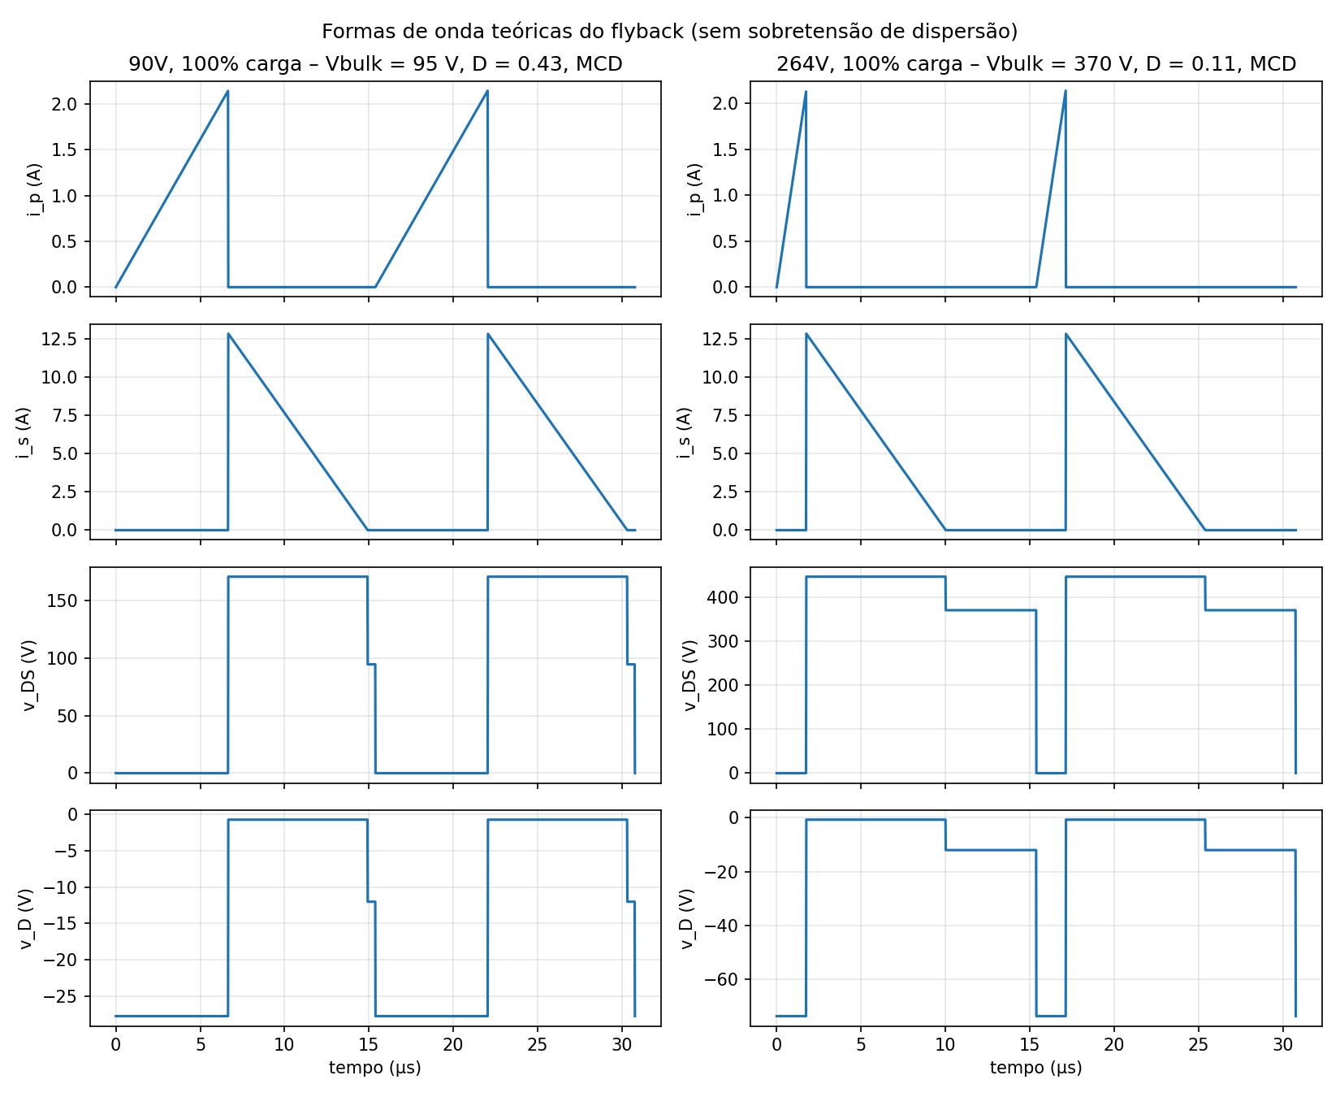
[picture p223: figure]

Formas de onda teóricas em 90 e 264 VAC, plena carga

## 4. Semicondutores, perdas e dissipadores

MOSFET 650 V | P 90 V | P 264 V | RθJC | Tj
IPA65R400CE | 1,14 W | 1,38 W | 4,0 | 79 °C
STP13N65M2 | 1,04 W | 1,15 W | 1,14 | 69 °C
FCPF190N65S3 | 0,83 W | 1,40 W | 3,5 | 79 °C

Diodo de saída STPS20H100CT (2 × 10 A em paralelo): 1,78 W, Tj ≈ 84 °C com clip de 24 °C/W
Ponte GBU4J 0,69 W sem dissipador (Tj 54 °C)
Driver = saída totem-pole do UC3845 (±1 A), Rg 10 Ω + 1N4148 + 10 kΩ
Orçamento: 7,4–8,0 W → η = 81,9–83,0 % (hipótese 82 % ✔)

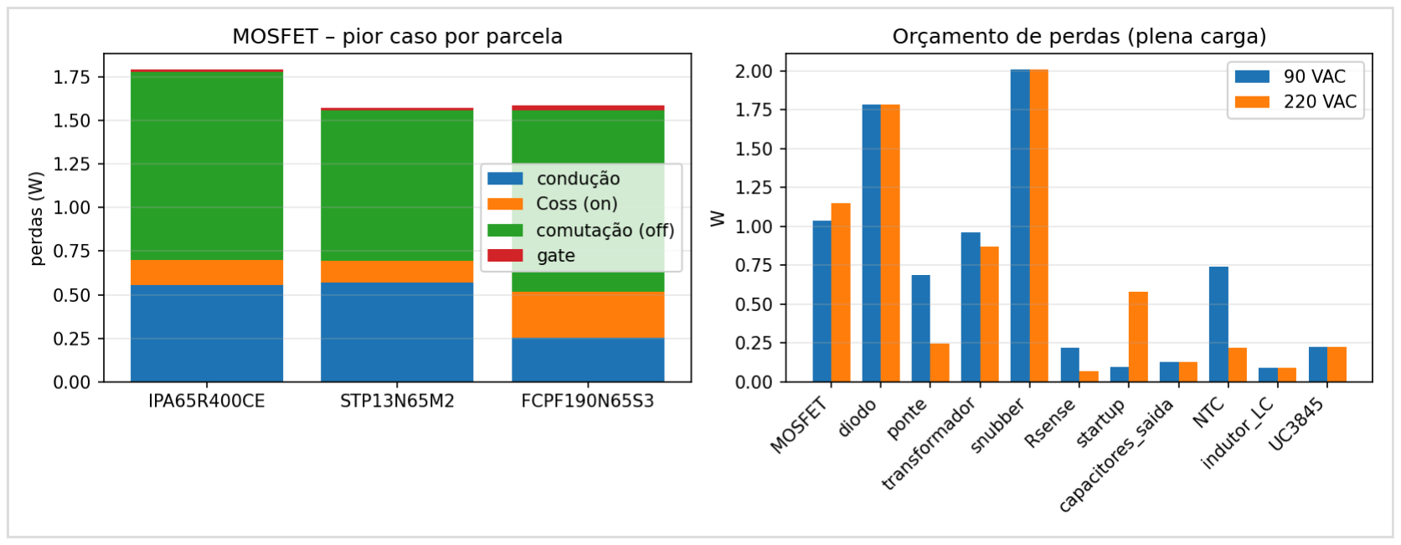
[picture p224: figure]

Distribuição de perdas em plena carga

## 5. Componentes do UC3845 e malha de controle

RT = 6,04 kΩ, CT = 2,2 nF → fsw = 64,7 kHz (D ≤ 50 %)
Rsense = 0,33 Ω (2 × 0,68 Ω/1 W): limite 2,7–3,0 A; filtro 1
kΩ/220 pF
Partida 2 × 82 kΩ/1 W, CVCC 220 µF; auxiliar 15 V (9 esp., UF4004)
Realimentação: TL431 (Ra 9,53 k / Rb 2,49 k), PC817, pull-up 4,7 kΩ no COMP
Compensador tipo 2: Rz = 47,5 kΩ, Cz = 150 nF → fc = 1,5 kHz, MF = 99° (≥ 91° em 10 % de carga; CTR 0,5–1,6) Snubber RCD: 9,1 kΩ (2 × 18,2 kΩ/2 W), 22 nF/630 V, UF4007; P = 2,0 W (Llk 2 %)
EMI: fDM 43 kHz (51 dB em 150 kHz), fCM 24 kHz (26 dB)

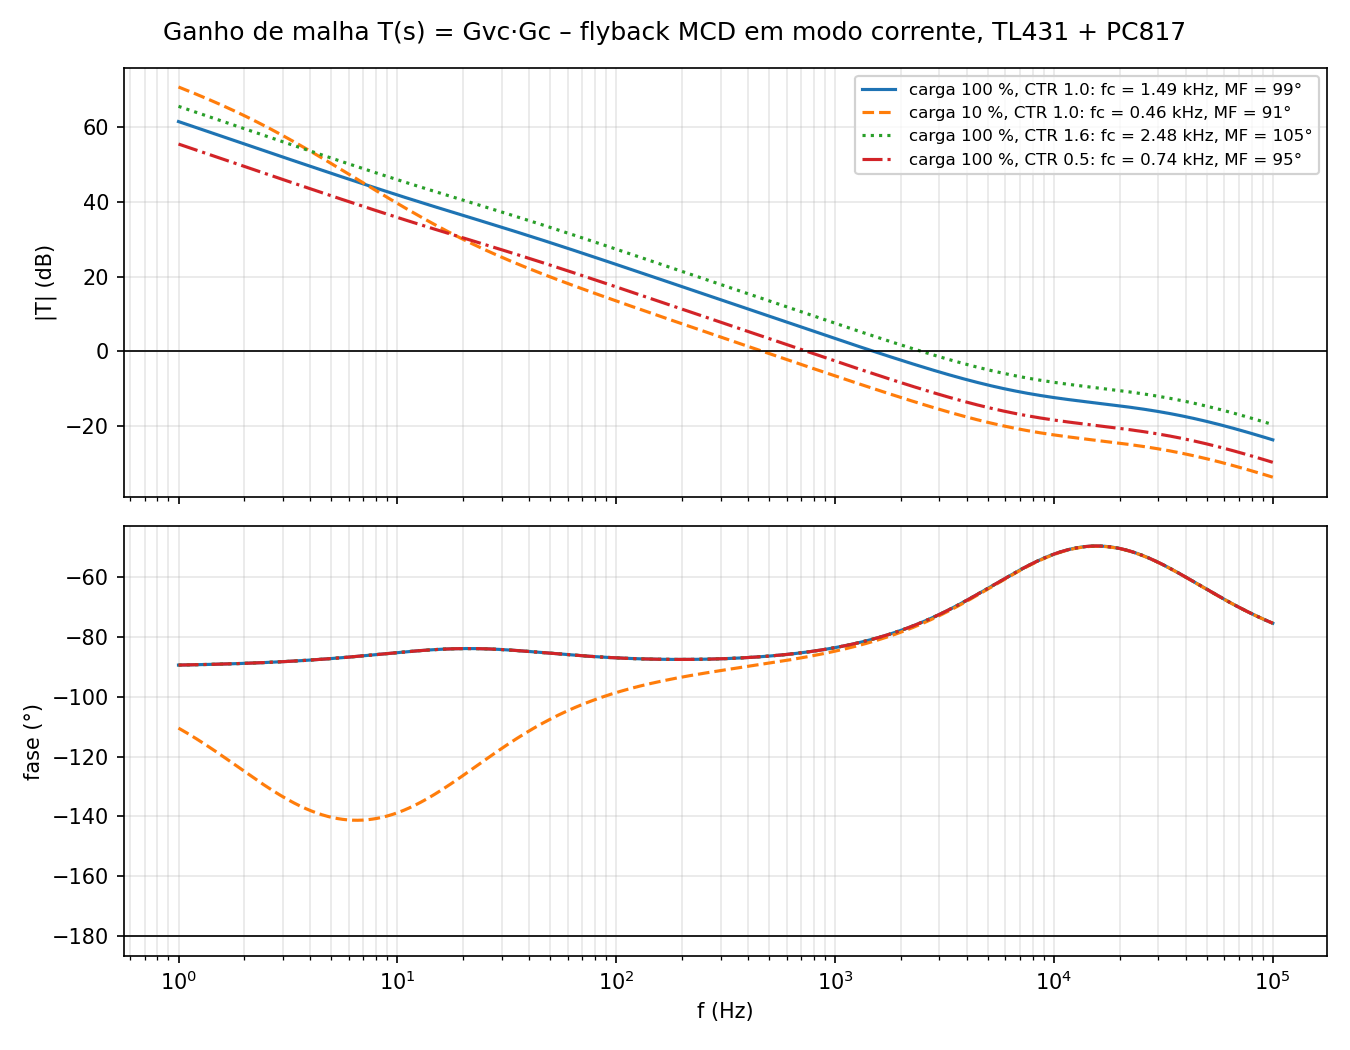
[picture p225: figure]

Bode da malha aberta

## 6. Simulação LTspice – regime permanente

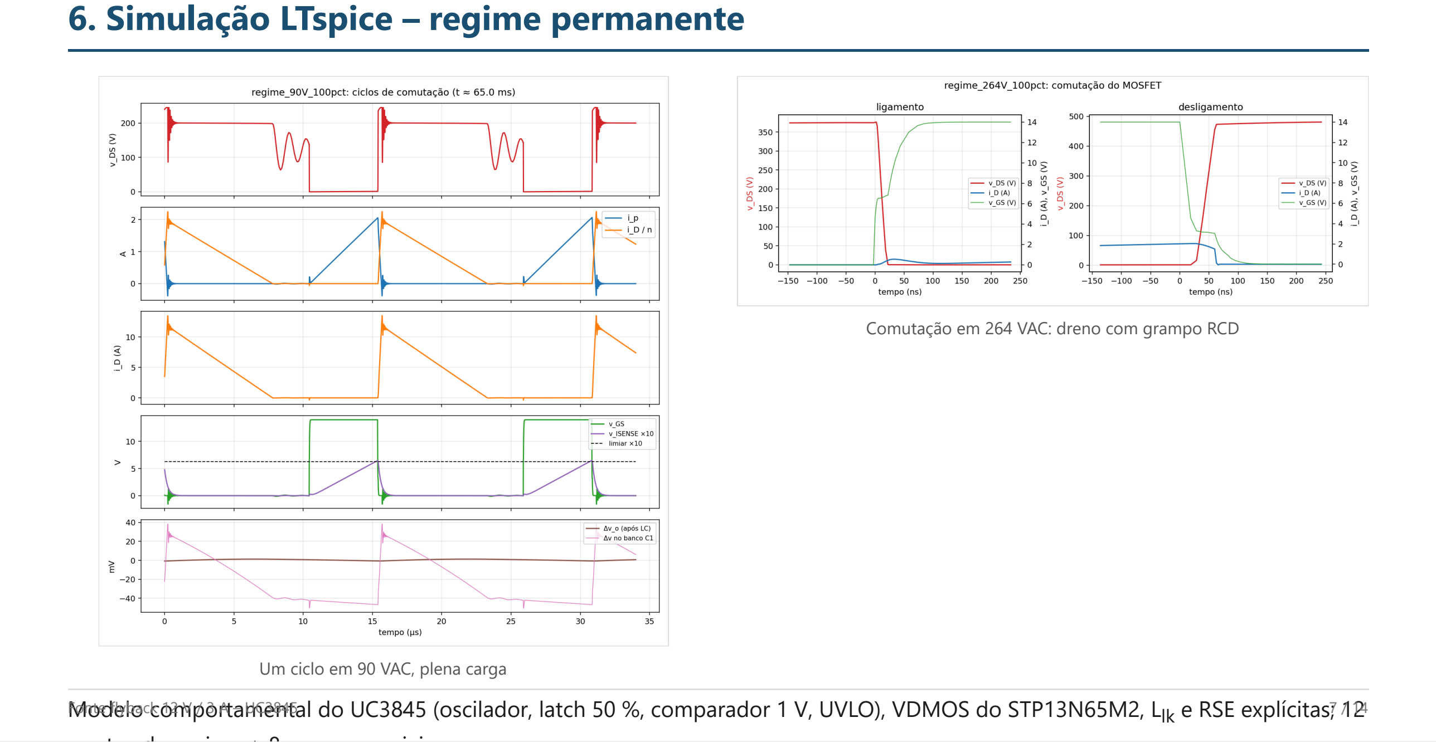
[picture p226: page 7]

Um ciclo em 90 VAC, plena carga

Comutação em 264 VAC: dreno com grampo RCD

Modelo comportamental do UC3845 (oscilador, latch 50 %, comparador 1 V, UVLO), VDMOS do STP13N65M2, Llk e RSE explícitas; 12
t d | i | + 8 | i i

## 7. Teoria × simulação

Vac

(100 %) Vo

(V) Ip
| | teo / sim (A) | Is,pk
| | | teo / sim (A) | Is,rms
| | | | teo / sim (A) | Vds
| | | | | teo / sim (V) | η teo / sim (%)
90 | 12,07 | 2,14 / 2,07 (−3,6 %) | 12,9 / 13,6 (+5,7 %) | 5,45 / 4,89 (−10 %) | 261 / 246 (−6 %) | 81,9 / 83,3
127 | 12,08 | 2,14 / 2,07 | 12,9 / 13,5 | 5,45 / 4,88 | 314 / 296 | 82,9 / 85,2
220 | 12,08 | 2,14 / 2,07 | 12,9 / 13,4 | 5,45 / 4,88 | 445 / 422 | 83,0 / 85,5
264 | 12,08 | 2,14 / 2,07 | 12,9 / 13,3 | 5,45 / 4,88 | 507 / 482 (−5 %) | 82,7 / 84,8
Regulação de linha e carga < 0,1 %; ondulação 1–4 mV após o pós-filtro LC (meta 120 mV)
Esforços dentro de 10 % (Is,rms no limite: teoria no vale de Vbulk

); Vds 5 % abaixo (grampo real 1,6–1,7·Vr

)
Ajustes feitos no ciclo: Dmáx 0,45 → 0,43; grampo 1,5 → 1,8·Vr

; η 0,85 → 0,82; Ns equilibrando margens de 650 V e 100 V; modelo do MOSFET com Cgd

| | /Coss

reais

## 8. Casos especiais: partida, degrau, snubber, curto

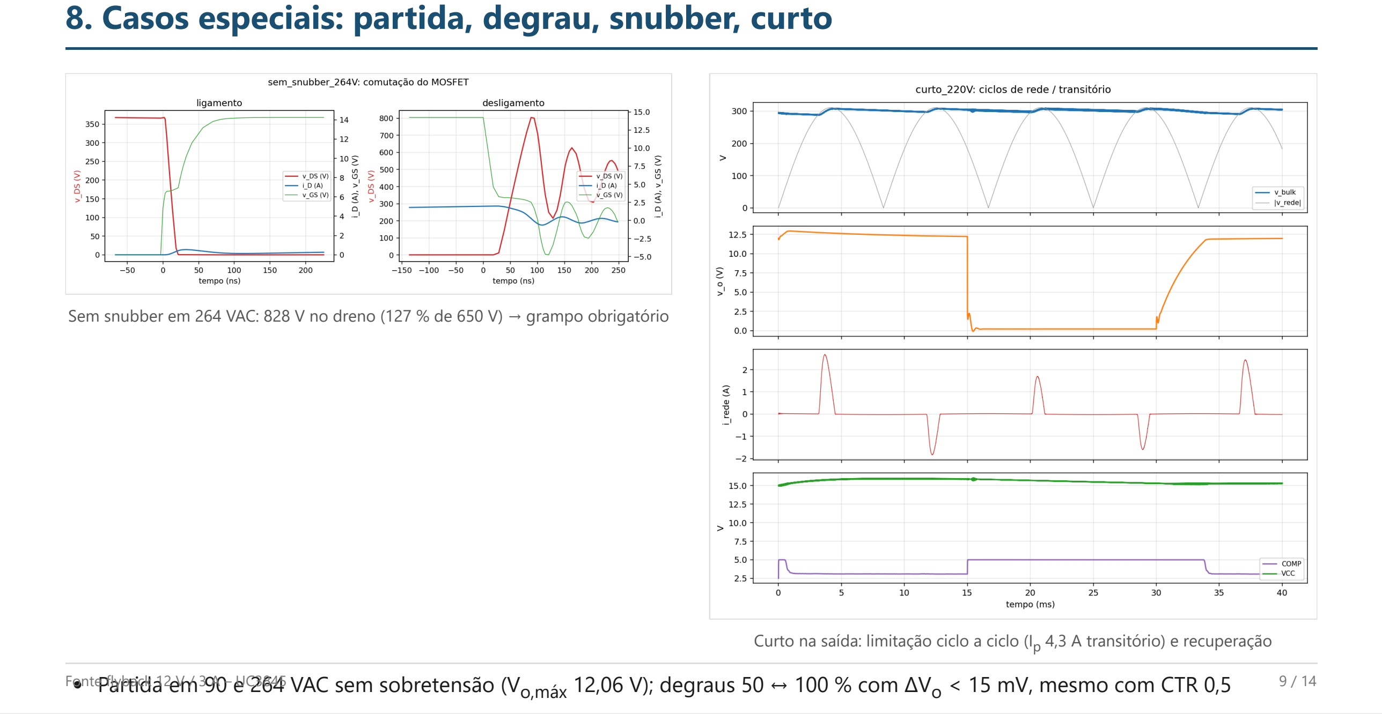
[picture p227: page 9]

Sem snubber em 264 VAC: 828 V no dreno (127 % de 650 V) → grampo obrigatório

Curto na saída: limitação ciclo a ciclo (Ip 4,3 A transitório) e recuperação
Partida em 90 e 264 VAC sem sobretensão (Vo,máx 12,06 V); degraus 50 ↔ 100 % com ΔVo < 15 mV, mesmo com CTR 0,5

## 9. Esquemático (KiCad 10, ERC 0 erros)

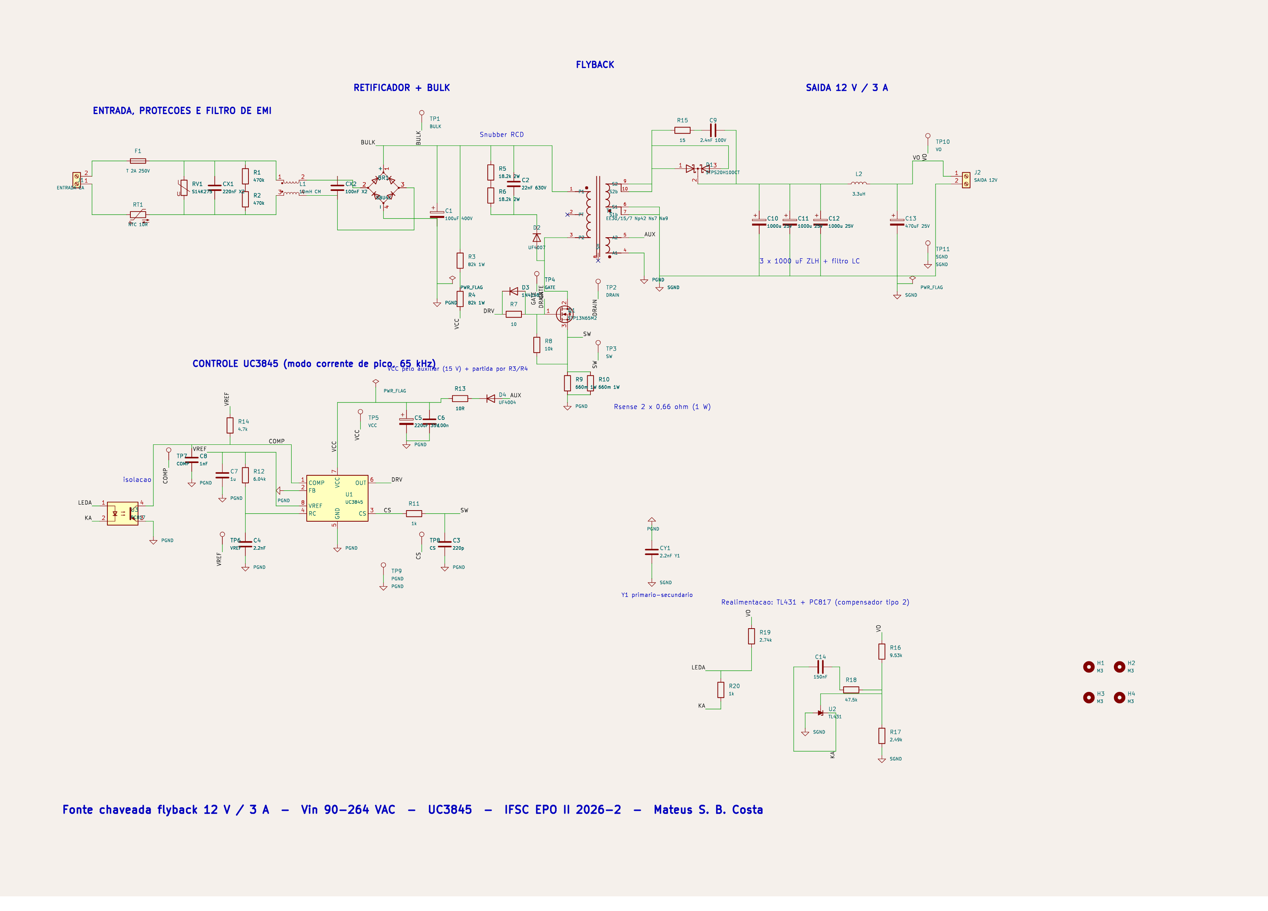
[picture p228: figure]

## 10. Layout da PCI – regras da Aula 08 e IPC-2221

140 × 90 mm, 2 camadas, FR-4 1,6 mm, todos PTH; fluxo
linear rede → saída
Classes HV / SEC / SEC_PWR: isolamento ≥ 1,0 mm (HV), ≥ 6 mm primário–secundário + fendas sob T1 e opto; trilhas 1,0 / 1,5 / 2,0 mm por corrente
Sem cantos de 90°: 222 chanfros a 45° gerados pelo roteador
Terra de potência e ilha de terra de sinal (UC3845) unidos num único ponto no Rsense

; 100 nF a 4,3 mm do VCC
Plano de terra nas duas regiões; 11 pontos de teste;
dissipadores clip; furos M3
DRC: 0 erros, 0 não conectados, paridade com o

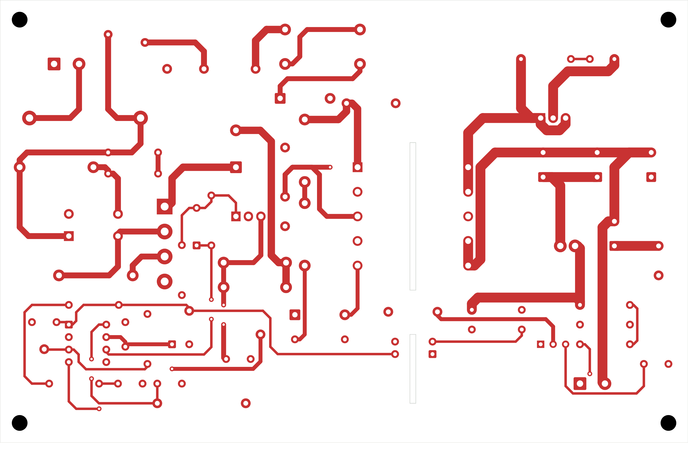
[picture p229: figure]

esquemático OK; Gerbers + furação prontos | Face superior

## 11. Placa – render 3D

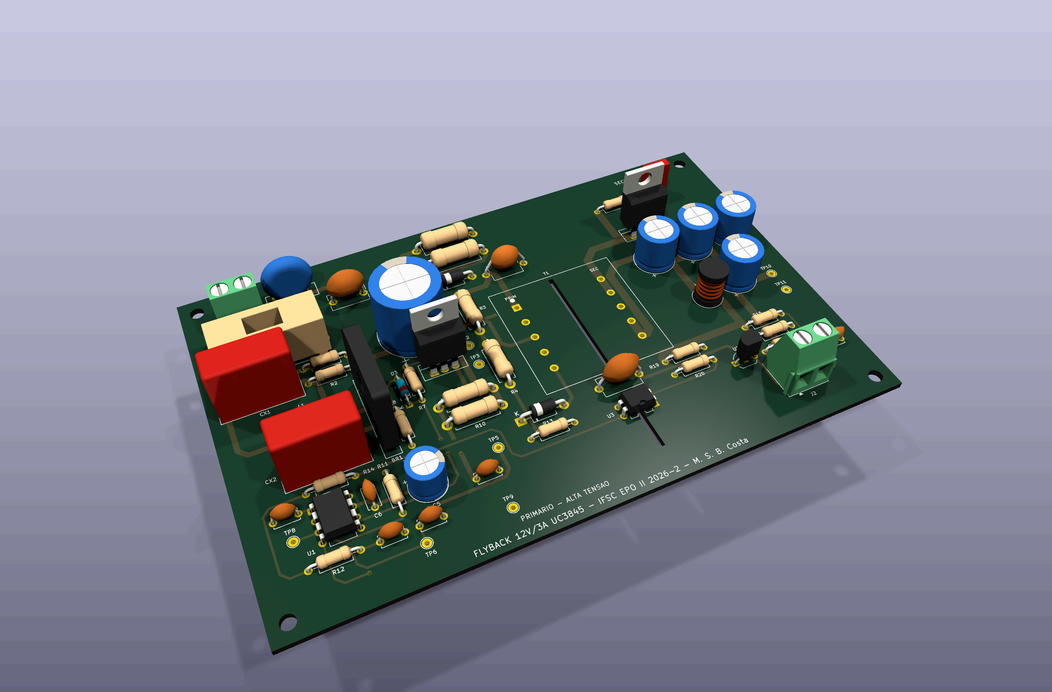
[picture p230: figure]

## 12. Lista de materiais e custo

Bloco

US$ (1
un.)

US$ (100
un.)

%

PCI (lote de 5 / 100) | 9,60 | 1,90 | 24
Secundário | 5,05 | 3,14 | 13
Filtro EMI | 4,51 | 2,97 | 11
Transformador | 4,50 | 3,00 | 11
Potência primária | 3,30 | 2,21 | 8
Demais (entrada, bulk, controle, realim., snubber, mecânica) | 12,82 | 7,41 | 32
Total por fonte | 39,78 (R$ 219) | 20,63 (R$ 113) | 100

57 itens com part number, fabricante e código Mouser/Digi-Key (BOM.xlsx)
Preços de referência out/2026; câmbio R$ 5,50
STP13N65M2 em falta em alguns distribuidores → substitutos STF13N65M2 / IPA65R400CE listados Alternativas nacionais (Thornton, lojas BR) no guia de montagem
Guia de montagem: enrolamento do trafo, montagem por blocos, ensaios com critério de aceite

## 13. Conclusões

Projeto completo do Tema II: teoria → simulação → ajustes → esquemático → layout verificado → BOM/custo → guia de montagem
Simulação confirma a teoria (esforços dentro de 10 %), Vo = 12,07–12,08 V, ondulação de mV, Vds ≤ 76 % de 650 V, partida e degraus estáveis, η = 83–85,5 %
Snubber indispensável (828 V sem grampo); limitação do UC3845 em curto documentada
Layout segue a Aula 08: 45°, terras separados com ponto único, isolação 6 mm, IPC-2221, DFM, pontos de teste; DRC zero erros Custo US$ 39,78 (1 un.) / US$ 20,63 (100 un.), PCI incluída
Próximos passos: OCP no secundário, modo burst em carga leve, medir Llk do trafo real, montar o protótipo com o roteiro

Obrigado. Arquivos: PROJETO/ (scripts, LTspice, KiCad, Gerbers, BOM, relatório)
