mateusalgado/IFSC_ELP2/00_Disciplina/Aula_04C_Projeto_Transformadores_HF.pdf

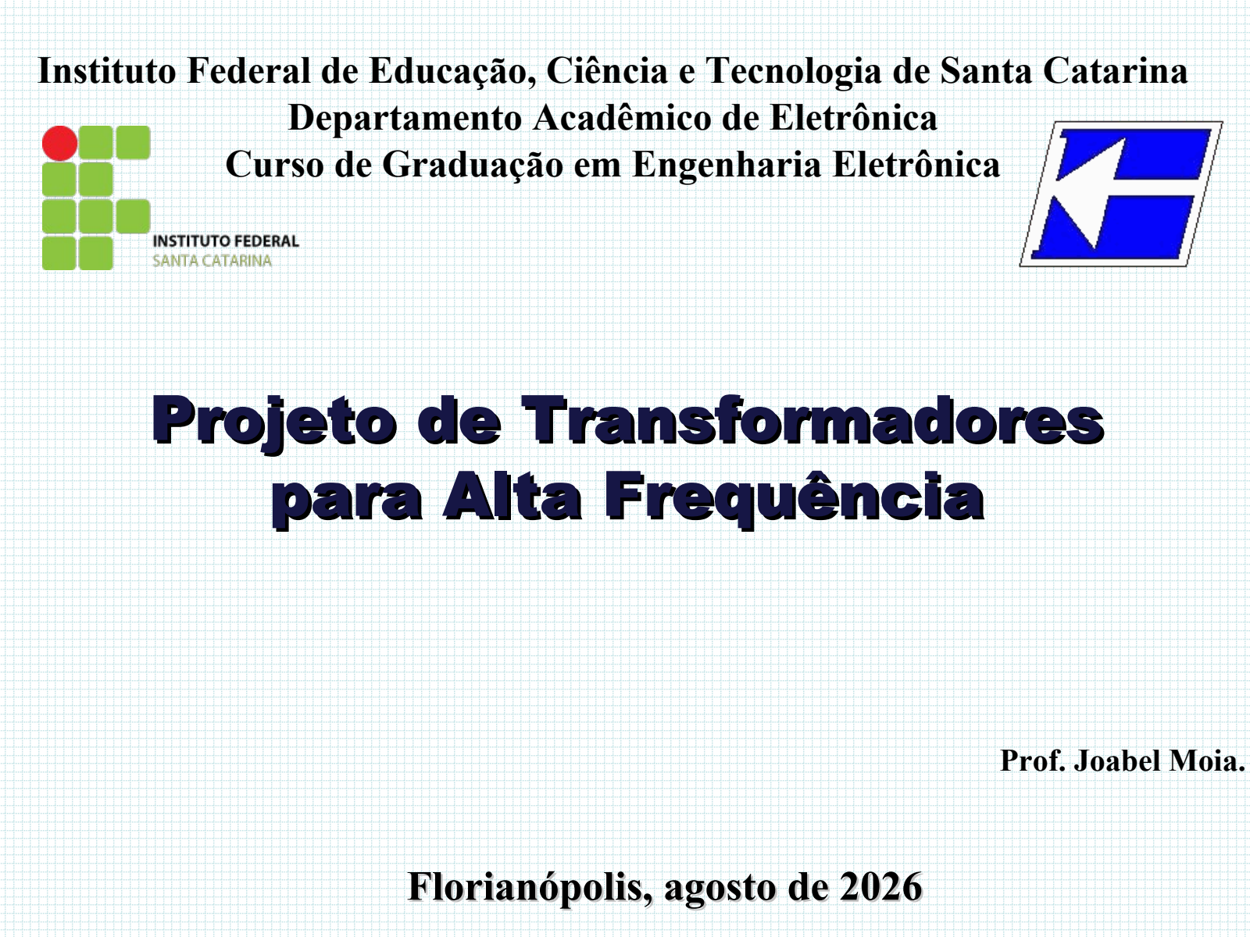
[picture p231: page 1]

# Projeto de Transformadores para Alta Frequência

Instituto Federal de Educação, Ciência e Tecnologia de Santa Catarina Departamento Acadêmico de Eletrônica Curso de Graduação em Engenharia Eletrônica

Florianópolis, agosto de 2026

Prof. Joabel Moia.

### Bibliografia para esta aula


Introdução comparativa
1. Conversor Forward;
2. Projeto do transformador do conversor Forward;
3. Conversor Flyback;
4. Projeto do transformador do conversor Flyback.

### Conversor Forward

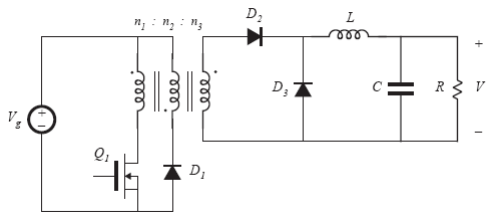
[picture p232: figure]

### Conversor Duplo Forward

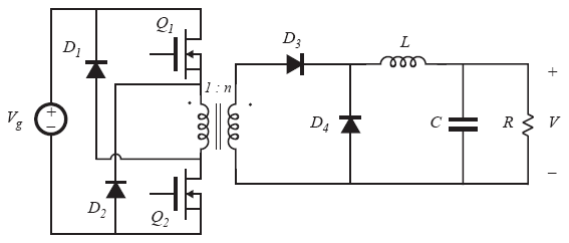
[picture p233: figure]

Montagem do núcleo (com entreferro):

### Projeto do transformador – Conversor Forward


1) Dados de entrada:

min
2
20 | Freqüência de operação;
120 | Potência na saída;
12 | Tensão na saída;
311 20% | Tensão na entrada;
249 | Tensão mínima na entrada;
J=450 / | Densidade de corrente;

s

out

out

in

in

F | kHz
P | W
V | V
V | V
V | V
| A cm

=
=
=
= ±
=

### Projeto do transformador – Conversor Forward

F

max

o

B=0,3 | | Densidade de fluxo máximo;
kp=0,5 | | Fator de ocupação do primário;
kw=0,4 | Fator de ocupação do secudário;
=75% | Rendimento da estrutura;
V =1 | | Queda de tensão dos diodos;
D | 0,4 | Razão cíclica máxima;
=4

T

V

η

µ π

=

7

10 | / / | Permeabilidade no vácuo. Wb A m -
·
1) Dados de entrada:

### Projeto do transformador – Conversor Forward

2) Escolha do núcleo:
4 | 4 2 | 10 | 2 120 10 | 4
5,9
0,4 0,5 450 20 0,3 0,75

out

w | p | s

P
AeAw | cm
k k J F | B | k
- | · | · | ·
= | = | =
- · · · Δ · | · | · | · | · | · η
Núcleo | Ae (cm² ) | Aw (cm² ) | le (cm) | lt (cm) | ve(cm³ ) | AeAw (cm⁴ )
E-20 | 0,312 | 0,26 | 4,28 | 3,8 | 1,34 | 0,08
E-30/7 | 0,60 | 0,80 | 6,7 | 5,6 | 4,00 | 0,48
E-30/14 | 1,20 | 0,85 | 6,7 | 6,7 | 8,00 | 1,02
E-42/15 | 1,81 | 1,57 | 9,7 | 8,7 | 17,10 | 2,84
E-42/20 | 2,40 | 1,57 | 9,7 | 10,5 | 23,30 | 3,77
E-55 | 3,54 | 2,50 | 1,2 | 11,6 | 42,50 | 8,85

### Projeto do transformador – Conversor Forward


3) Cálculo do número de espiras:

min
4
249 | 59espiras
2 | 2 3,54 10 0,3 20

in

e | s

V
Np
A | B F | k -
= | = | =
- · Δ · | · | · | · | ·

max

min | max
12 1 0,4 1,1 | 1,1 | 0,137
249 0,4

out F

in

Ns | V | V D
n
Np | V | D
+ · | + ·
= = · | = · | =
- ·
Ns n Np = · | = | · = 0,137 59 8espiras
Nt Np = | = 59espiras

### Projeto do transformador – Conversor Forward

4) Perdas no núcleo:

5

10

4 10
4 10

H

E

K
K

= ·
= ·
( | )
2,4 | 2 P | B | K F K F | V nucleo | H | s | E | s | e = Δ | · | · + | · | ·
( | )
2,4 | 5 | 10 | 2 0,3 | 4 10 20000 4 10 | 20000 42,5 Pnucleo
- | - = | · · | · | + · | · | ·
2,26 P | W nucleo =

### Projeto do transformador – Conversor Forward

5) Profundidade de penetração:
7,5 | 7,5 | 0,053
20000 s

cm
F
Δ = | = | =
2 | 2 0,053 0,106 Dfio | cm max
= · Δ = · | =

Não poderá ser utilizado condutor com diâmetro maior que 0,106 cm. Portanto, podem ser utilizados condutores mais finos que o fio 18 AWG. Escolheu-se o condutor 22 AWG.

2
22 | 0,003255 A | cm cu

=

22 ρ = | Ω 0,000530 / cm

2

22 S | cm = 0,004013

### Projeto do transformador – Conversor Forward

7) Escolha da seção dos condutores (secundário):
7,1 | 2
0,016
450

sef
s

I
S | cm
J
= | = | =

_
22

0,016 5fios
0,003255

s
fios s
cu

S
N
A
= | = | =

Maior que a área do fio 22 AWG.

10 7,1
2 2

out
sef

I
I | A = | = | =

### Projeto do transformador – Conversor Forward

7) Escolha da seção dos condutores (primário):
1,93 | 2
0,0043
450

pef
p

I
S | cm
J
= | = | =

_
22

0,0043 2fios
0,003255

p
fios p
cu

S
N
A
= | = | =

Maior que a área do fio 22 AWG.

min

4 | 4 120 1,93
| 249

out
pef
i

P
I | A
V
- ·
= | = | =

### Projeto do transformador – Conversor Forward

7) Escolha da seção dos condutores (terciário):
0,4 | 2
0,00086
450

tef
t

I
S | cm
J
= | = | =

_
22

0,00086 0,26 1fio
0,003255

t
fios t
cu

S
N
A
= | = | = | = Menor que a área do fio 22 AWG.
0,2 | 0,2 1,93 0,4 tef | pef I | I | A = | · | = | · | =

### Projeto do transformador – Conversor Forward

8) Cálculo da resistência do fio:

22

_

0,000530 59 | 11,6 0,18
2

fiop
fios p
R | Np | lt
N
= | · | · = · | · | = | Ω ρ

22

_

0,000530 8 | 11,6 0,0098
5

fios
fios s
R | Ns | lt
N
= | · | · = · | · | = | Ω ρ

22

_

0,000530 59 | 11,6 0,36
1

fiot
fios t
R | Nt | lt
N
= · | · = · | · | = | Ω ρ

### Projeto do transformador – Conversor Forward

9) Perdas no cobre:
2 | 2 | 2 P | R | I | R | I | R | I cobre | fiop | pef | fios | sef | fiot | tef = | · | + | · | + | ·
2 | 2 | 2 0,18 1,93 0,0098 7,1 0,36 0,38 1,22 P | W cobre = | · | + | · | + | · | =
10) Perdas totais:
2,26 1,22 3,48 P | P | P | W totais | nucleo | cobre = | + | = | + | =
11) Elevação de temperatura:
( | ) | ( )
0,37 | 0,37 23 | 23 8,85 | 10,26 | / o Rt | AeAw | C W - | -
= · | = · | =
10,26 3,48 35,7 o Δ = · | = | · | = T Rt P | C total

### Projeto do transformador – Conversor Forward

12) Cálculo do fator de ocupação:
( | _ | _ | _ | 22 )

0,7

fios s | fios s | fios t
neces
Np N | Ns N | Nt N | S
Aw
- | + | · | + · | ·
=

1,244 0,5
2,5

neces
ocup

Aw K
Aw
= | = | =
(59 2 8 5 59 1 0,004013 ) | 2
1,244
| | 0,7
Aw | cm neces
- + · + · ·
= | =

### Projeto do transformador – Conversor Forward

### Conversor Flyback

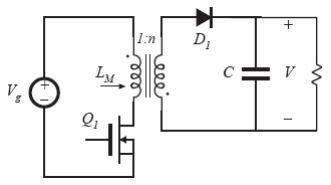
[picture p234: figure]

### Projeto do transformador – Conversor Flyback

1) Dados de entrada:

min
2
20 | Freqüência de operação;
120 | Potência na saída;
12 | Tensão na saída;
311 20% | Tensão na entrada;
249 | Tensão mínima na entrada;
J=450 / | Densidade de corrente;

s

out

out

in

in

F | kHz
P | W
V | V
V | V
V | V
| A cm

=
=
=
= ±
=

1) Dados de entrada:
2) Cálculo da corrente de pico no primário:
min | max
2 | 2 120 | 3,213
| 0,75 249 0,4

out
p
in

P
I | A
V | D
- ·
= | = | =
η · | · | · | ·

F

max

o

B=0,3 | | Densidade de fluxo máximo;
kp=0,3 | | Fator de ocupação do primário;
kw=0,4 | Fator de ocupação do primário;
=75% | Rendimento da estrutura;
V =1 | | Queda de tensão dos diodos;
D | 0,4 | Razão cíclica máxima;
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
10 | / / | Permeabilidade no vácuo. Wb A m -

### Projeto do transformador – Conversor Flyback

3) Escolha do núcleo:
4 | 4 1,1 | 10 | 1,1 120 10 | 4
4,0
0,4 0,3 450 20 0,3

out

w | p | s

P
AeAw | cm
k k J F | B | k
- | · | · | ·
= | = | =
- · · · Δ | · | · | · | ·
Núcleo | Ae (cm² ) | Aw (cm² ) | le (cm) | lt (cm) | ve(cm³ ) | AeAw (cm⁴ )
E-20 | 0,312 | 0,26 | 4,28 | 3,8 | 1,34 | 0,08
E-30/7 | 0,60 | 0,80 | 6,7 | 5,6 | 4,00 | 0,48
E-30/14 | 1,20 | 0,85 | 6,7 | 6,7 | 8,00 | 1,02
E-42/15 | 1,81 | 1,57 | 9,7 | 8,7 | 17,10 | 2,84
E-42/20 | 2,40 | 1,57 | 9,7 | 10,5 | 23,30 | 3,77
E-55 | 3,54 | 2,50 | 1,2 | 11,6 | 42,50 | 8,85

### Projeto do transformador – Conversor Flyback

4) Cálculo do entreferro:

7

2 | 2 | 4
2 | 2 4 10 8 | 0,631
| 0,3 3,54 10

o

e

W | m
mm
B A

- · Δ | · · | ·
= | = | =
Δ · | · | ·
µ | π
δ
| 120 | 8
| 0,75 20

out

s

P
W | mJ
F | k
Δ = | = | =
η · | ·
0,631 lg | 0,316
2 | 1

mm
= = | = | mm

δ

### Projeto do transformador – Conversor Flyback

5) Cálculo do número de espiras:

3

7

0,3 0,631 10 | 47espiras
4 10 3,213 o | p

B
Np
I

Δ · | · | ·
= | = | =
- | · | ·

δ
µ π

max

min | max
1 | 12 1 1 0,4 0,078
249 | 0,4
out | D

in

Ns | V | V | D
n
Np | V | D
+ | - | + | -
= = | · | = | · | =
Ns n Np = · | = | · ≅ 0,078 47 4espiras

### Projeto do transformador – Conversor Flyback

6) Perdas no núcleo:

5

10

4 10
4 10

H

E

K
K

= ·
= ·
( | )
2,4 | 2 P | B | K F K F | V nucleo | H | s | E | s | e = Δ | · | · + | · | ·
( | )
2,4 | 5 | 10 | 2 0,3 | 4 10 20000 4 10 | 20000 42,5 Pnucleo
- | - = | · · | · | + · | · | ·
2,26 P | W nucleo =

### Projeto do transformador – Conversor Flyback

7) Profundidade de penetração:
7,5 | 7,5 | 0,053
20000 s

cm
F
Δ = | = | =
2 | 2 0,053 0,106 Dfio | cm max
= · Δ = · | =

Não poderá ser utilizado condutor com diâmetro maior que 0,106 cm. Portanto, podem ser utilizados condutores mais finos que o fio 18 AWG. Escolheu-se o condutor 22 AWG.

2
22 | 0,003255 A | cm cu

=

22 ρ = | Ω 0,000530 / cm

### Projeto do transformador – Conversor Flyback

8) Escolha da seção dos condutores (primário):
1,173 | 2
0,0026
450

pef
p

I
S | cm
J
= | = | = | Pode ser usado o fio 23 AWG.
max | max 3,213 | 1,173
3 | 3 pef | p
D | D I | I | A = · | = | · | =

### Projeto do transformador – Conversor Flyback

9) Escolha da seção dos condutores (secundário):
16,9 | 2
0,037
450

sef
s

I
S | cm
J
= | = | =

_
22

0,037 12fios
0,003255

s
fios s
cu

S
N
A
= | = | =

Maior que a área do fio 22 AWG.

max 1 | 1 0,4 37.75 | 16,9
3 | 3 sef | s

D

I | I | A - | -
= · | = | · | =

2

47 3,213 37,75
4

p
s p

N
I I | A
N
= · | = | · | =

### Projeto do transformador – Conversor Flyback

10) Cálculo da resistência do fio:

23

_

0,000668 47 | 11,6 0,36
1

fiop
fios p
R | Np | lt
N
= | · | · = · | · | = | Ω ρ

22

_

0,000530 4 | 11,6 0,00205

12 fios
fios s
R | Ns | lt
N
= | · | · = · | · | = | Ω ρ

### Projeto do transformador – Conversor Flyback

11) Perdas no cobre:
2 | 2 P | R | I | R | I cobre | fiop | pef | fios | sef = | · | + | ·
2 | 2 0,36 1,173 0,00205 16,9 1,08 P | W cobre = | · | + | · | =
12) Perdas totais:
2,26 1,08 3,34 P | P | P | W totais | nucleo | cobre = | + | = | + | =
13) Elevação de temperatura:
( | ) | ( )
0,37 | 0,37 23 | 23 8,85 | 10,26 | / o Rt | AeAw | C W - | -
= · | = · | =
10,26 3,34 34,28 o Δ = · | = | · | = T Rt P | C total

### Projeto do transformador – Conversor Flyback

14) Cálculo do fator de ocupação:
_ | 23 | _ | 22
0,7
fios s | fios s
neces
Np N | S | Ns N | S
Aw
- | · | + | · | ·
=

0,49 0,2
2,5

neces
ocup

Aw K
Aw
= | = | =
47 1 0,003221 4 12 0,004013 | 2
0,49
0,7
Aw | cm neces
- · | + · ·
= | =

### Projeto do transformador – Conversor Flyback

### Transformador Planar

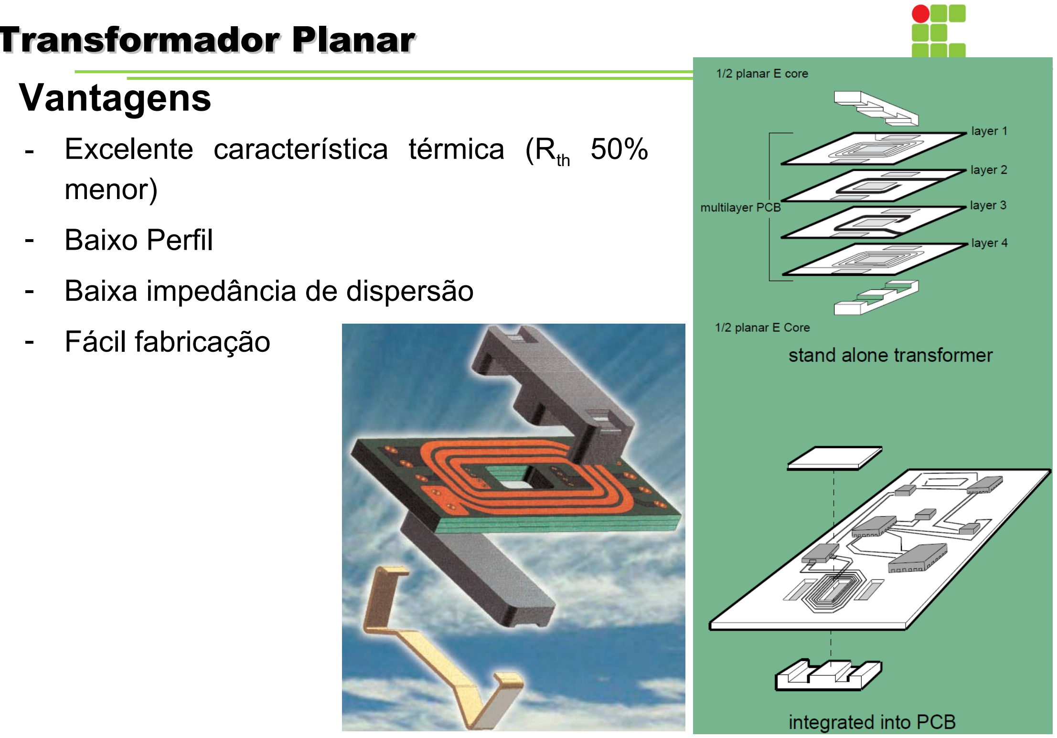
[picture p235: page 31]

Vantagens
- Excelente característica térmica (Rth 50% menor)
- Baixo Perfil
- Baixa impedância de dispersão
- Fácil fabricação

### Transformador Planar

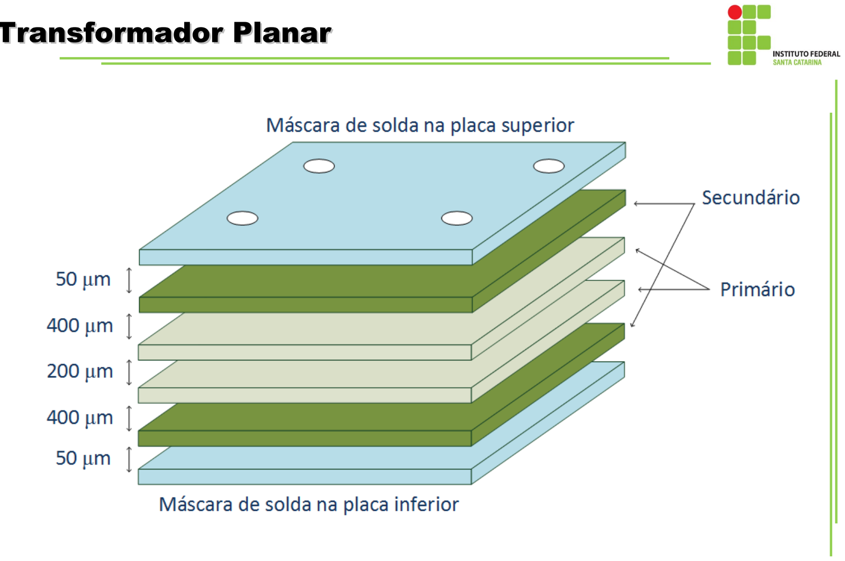
[picture p236: page 32]

### Transformador Planar

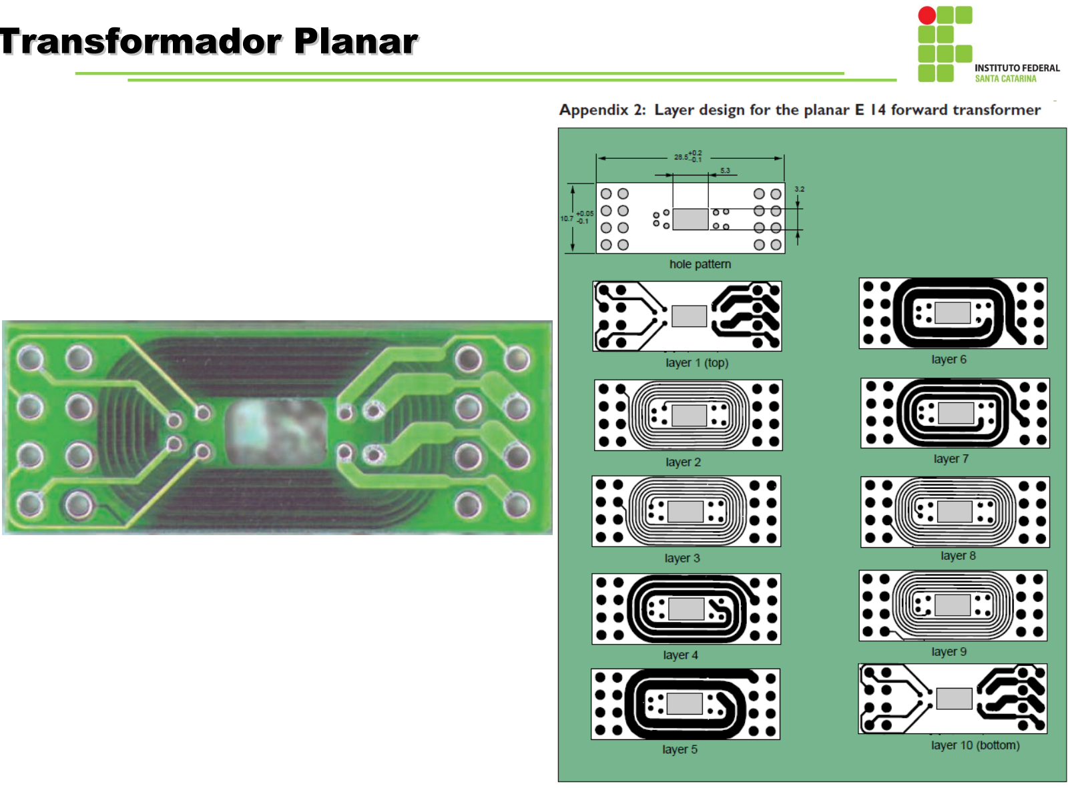
[picture p237: page 33]

### Transformador Planar

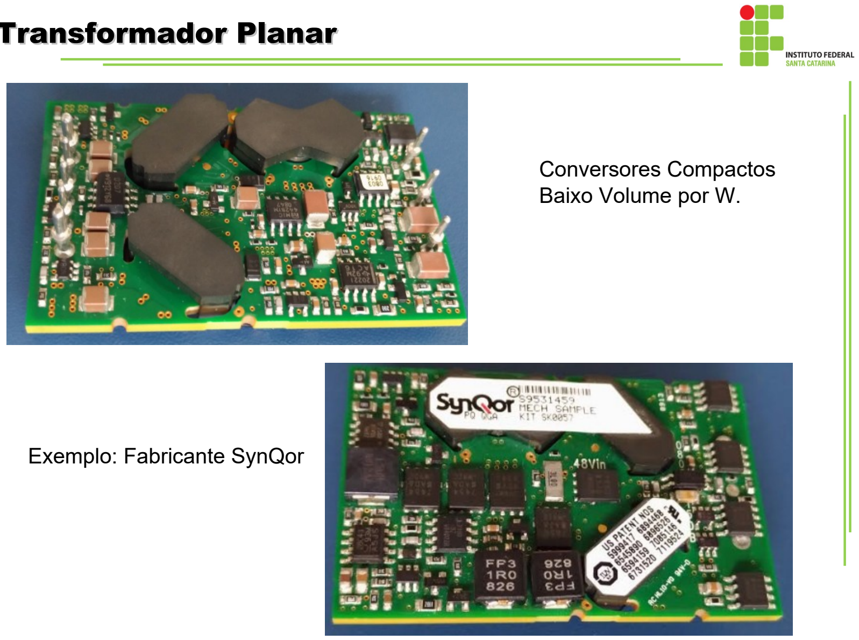
[picture p238: page 34]

Conversores Compactos
Baixo Volume por W.

Exemplo: Fabricante SynQor

### Transformador Planar

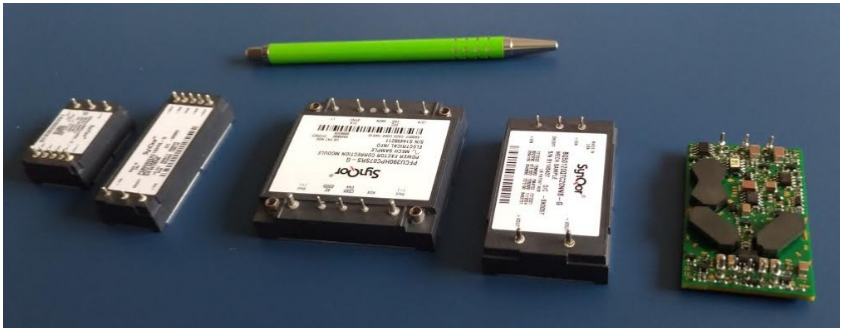
[picture p239: figure]

Conversores Compactos
Baixo Volume por W.

Exemplo: Conversores Fabricante SynQor

### Transformador Planar

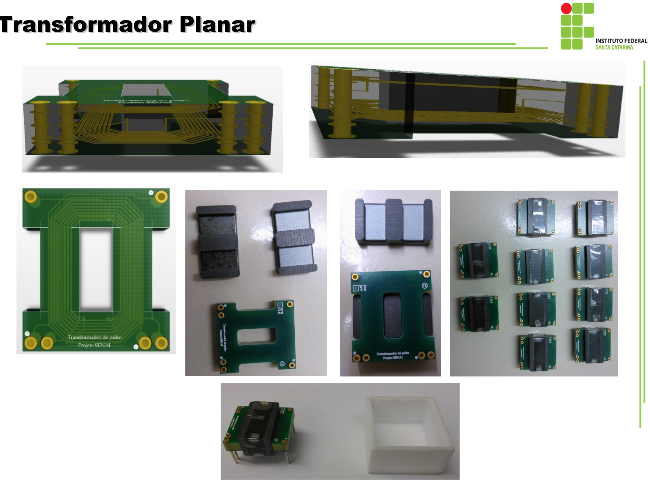
[picture p240: page 36]

### Transformador com Isolação

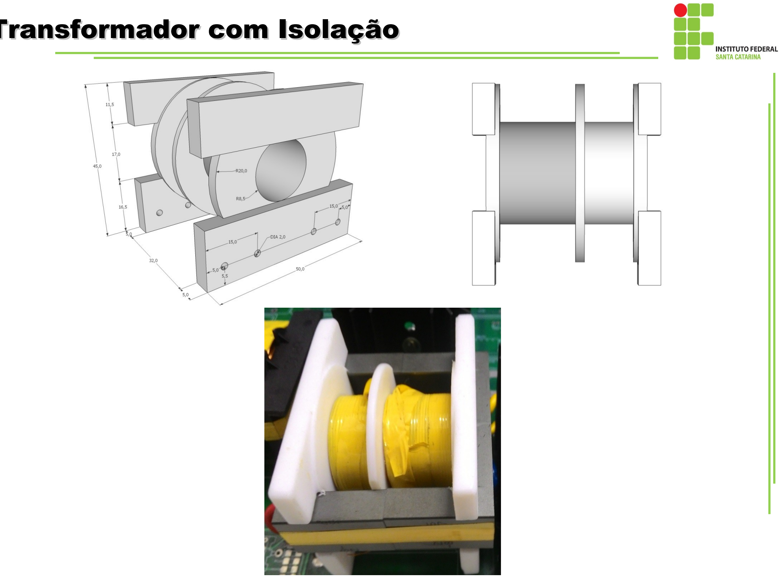
[picture p241: page 37]

### Transformador com Isolação

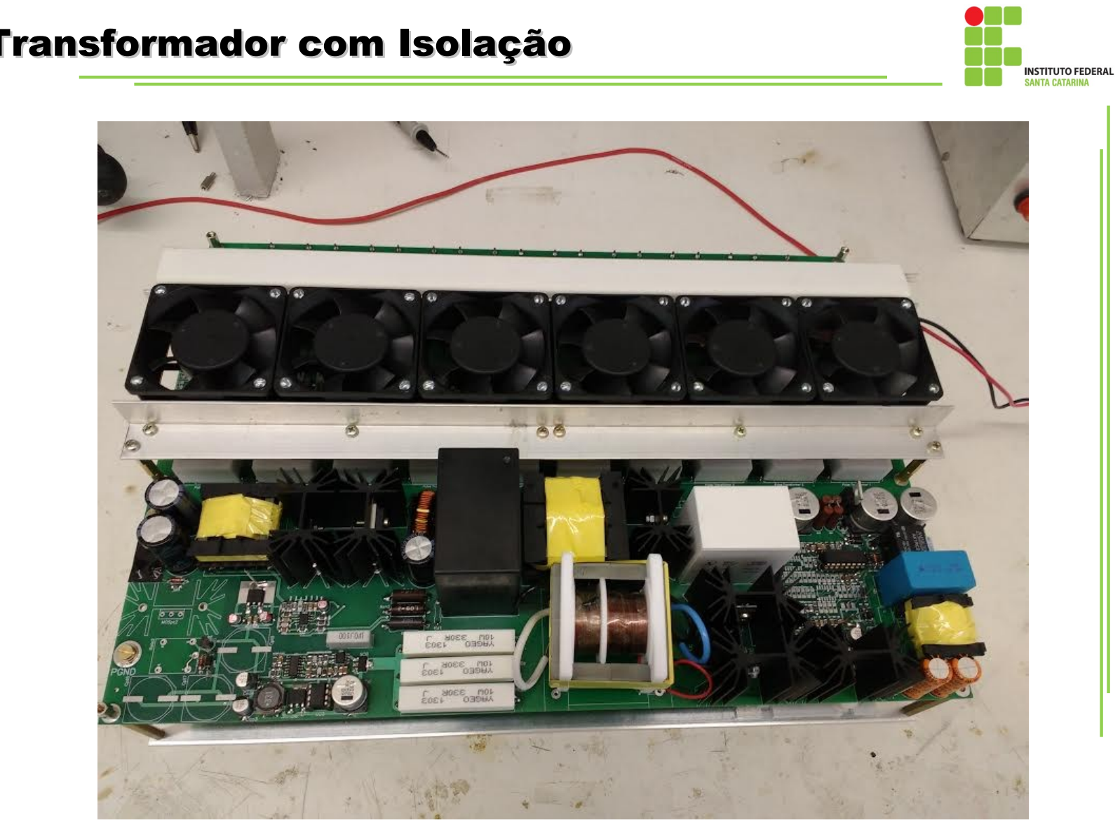
[picture p242: page 38]

### Tarefa 3


Conversor Buck:

Especificação:
Tensão de Entrada: 36 V
Tensão de Saída: 12 V
Frequência de comutação: 100 kHz; Indutância L: ∆I=10% da corrente média Capacitância C: 100 uF;
Potência: 100 W;

Apresentar:
- Projetar o Indutor L:
- Utilizar a planilha desenvolvida no Smath e as aulas e definir um núcleo da Thornton;
- Utilizar a planilha da Magnetics
e definir um núcleo de tal fabricante
