mateusalgado/IFSC_ELP2/Projeto_Flyback/03_Simulacao/analise/bulk_min_90V_rede.png

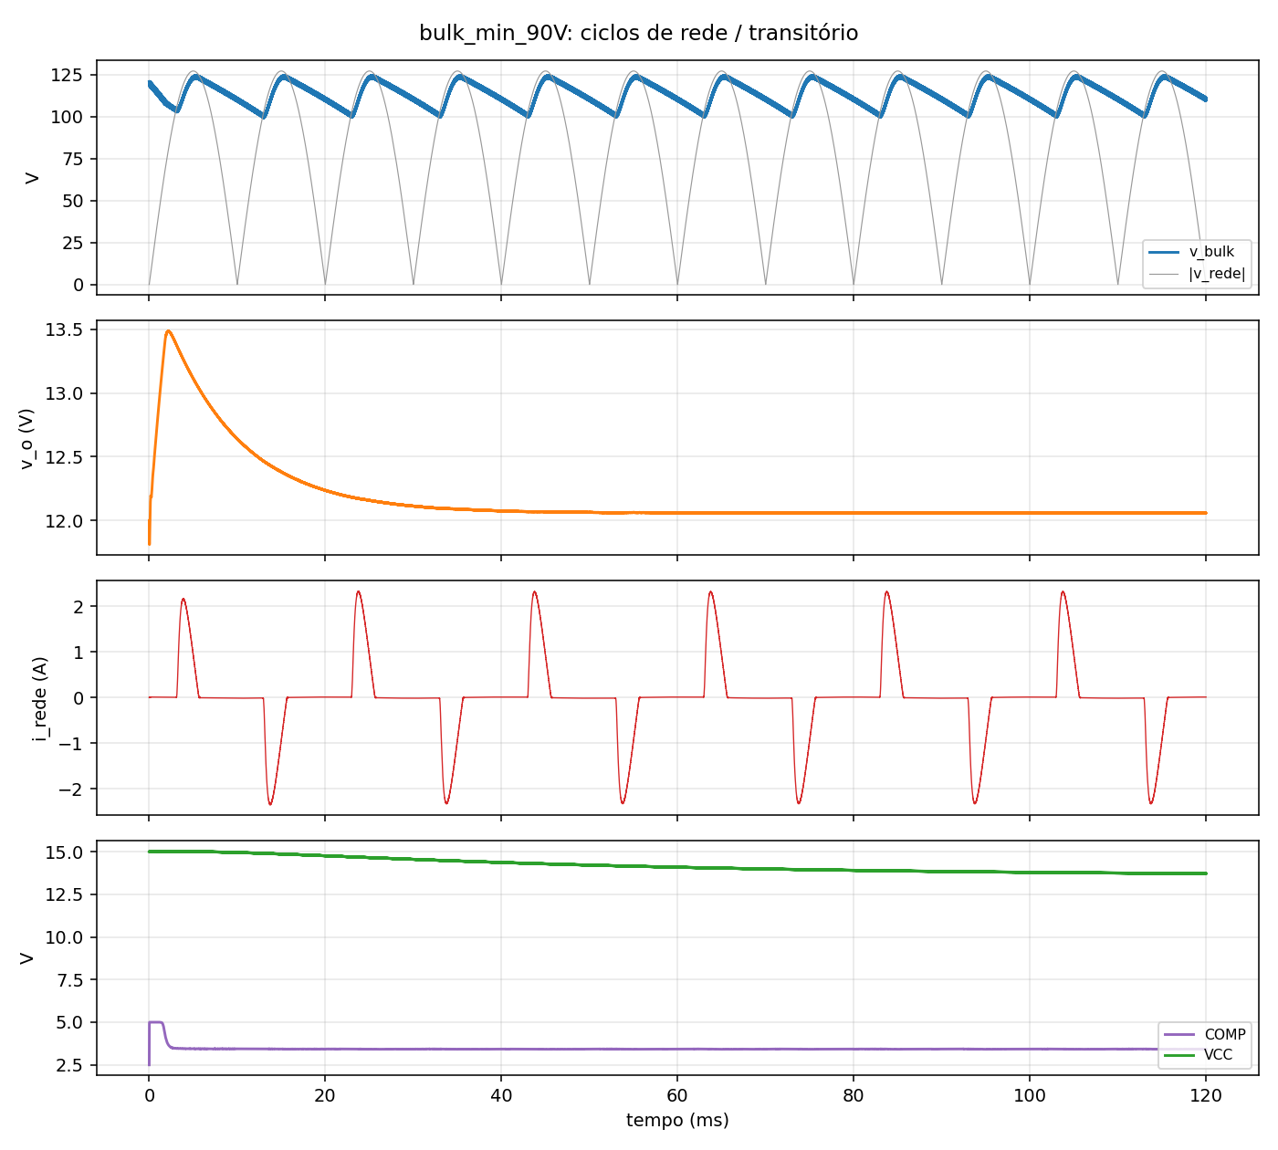
Projeto_Flyback/03_Simulacao/analise/bulk_min_90V_rede.png
