mateusalgado/IFSC_ELP2/Projeto_Flyback/03_Simulacao/analise/ctr05_90V_ciclo.png

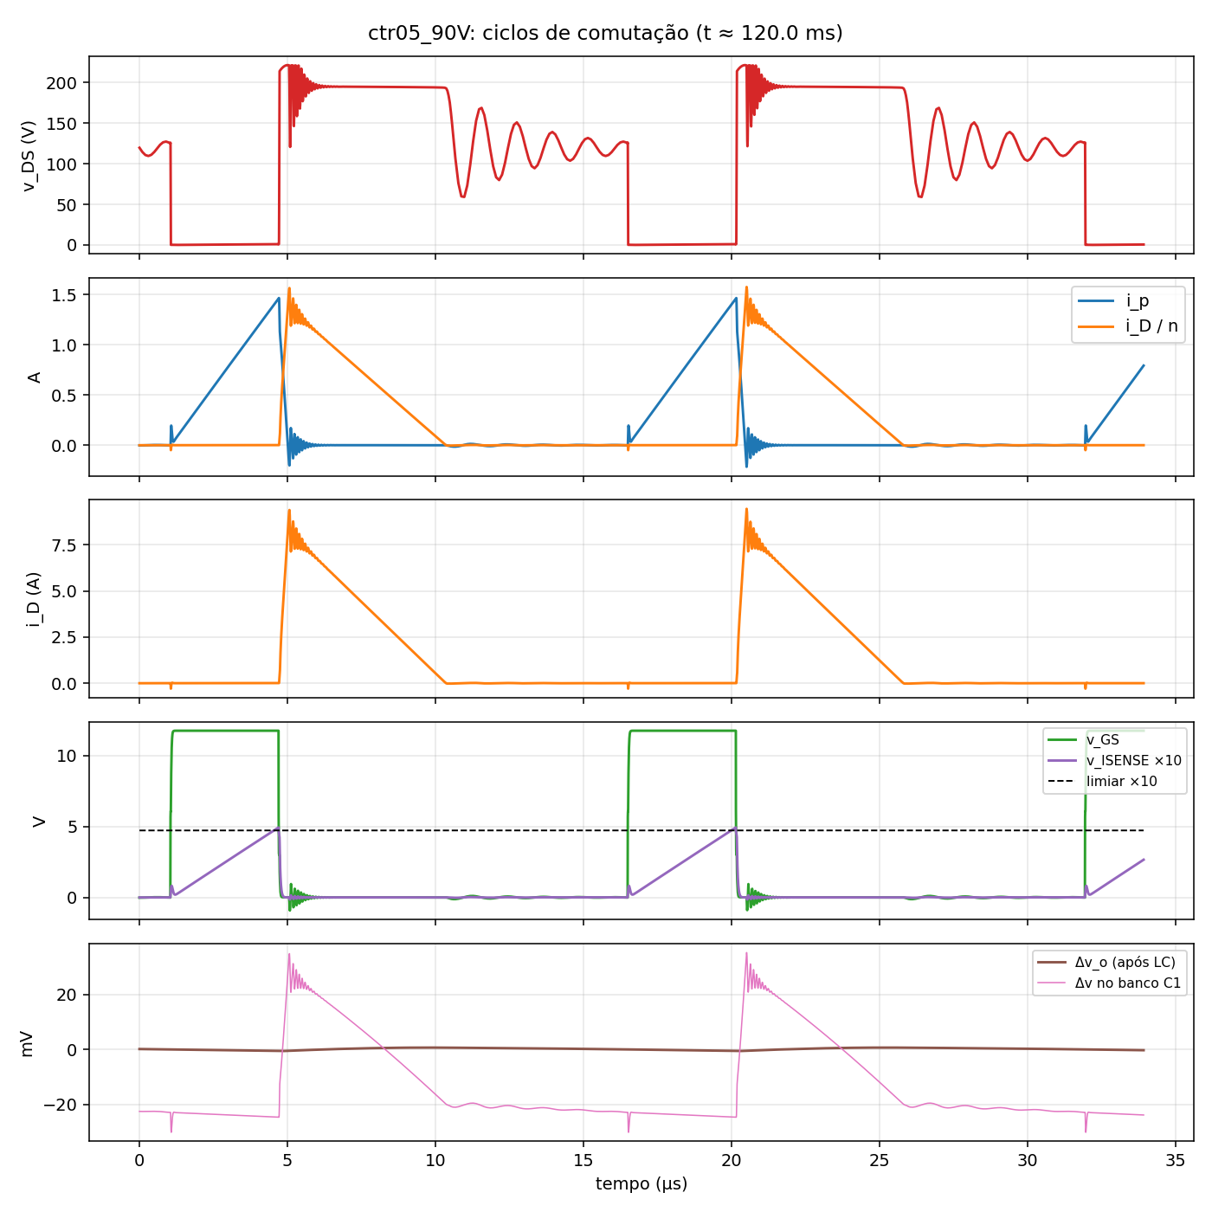
Projeto_Flyback/03_Simulacao/analise/ctr05_90V_ciclo.png
