mateusalgado/IFSC_ELP2/Projeto_Flyback/03_Simulacao/analise/curto_220V_B0_janelas.png

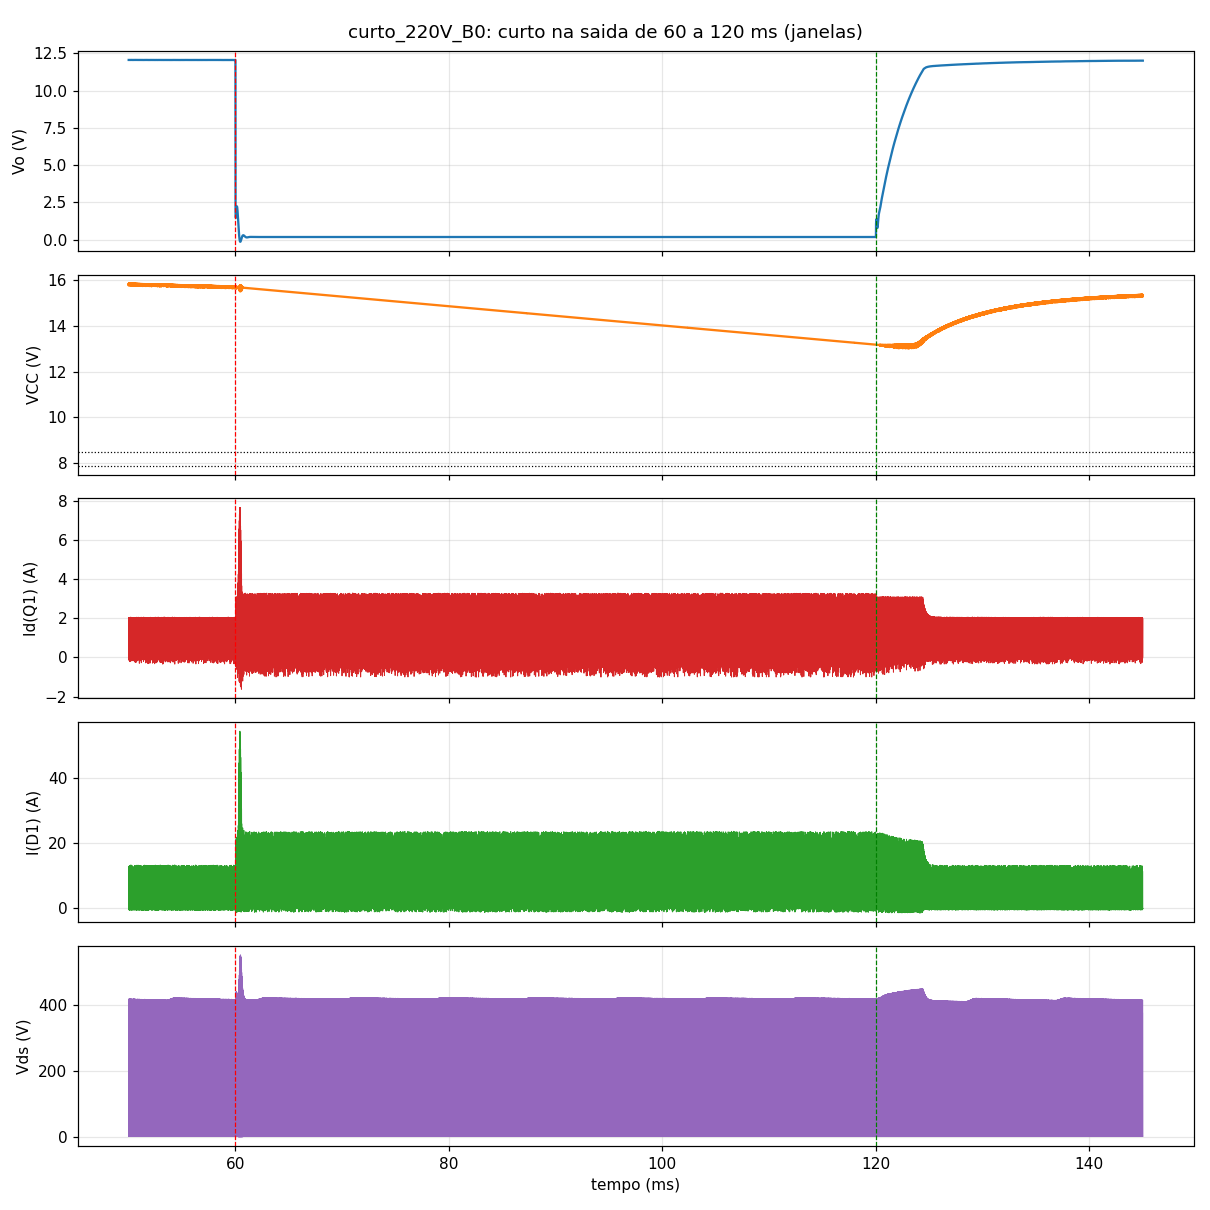
Projeto_Flyback/03_Simulacao/analise/curto_220V_B0_janelas.png
