mateusalgado/IFSC_ELP2/Projeto_Flyback/03_Simulacao/analise/degrau_264V_rede.png

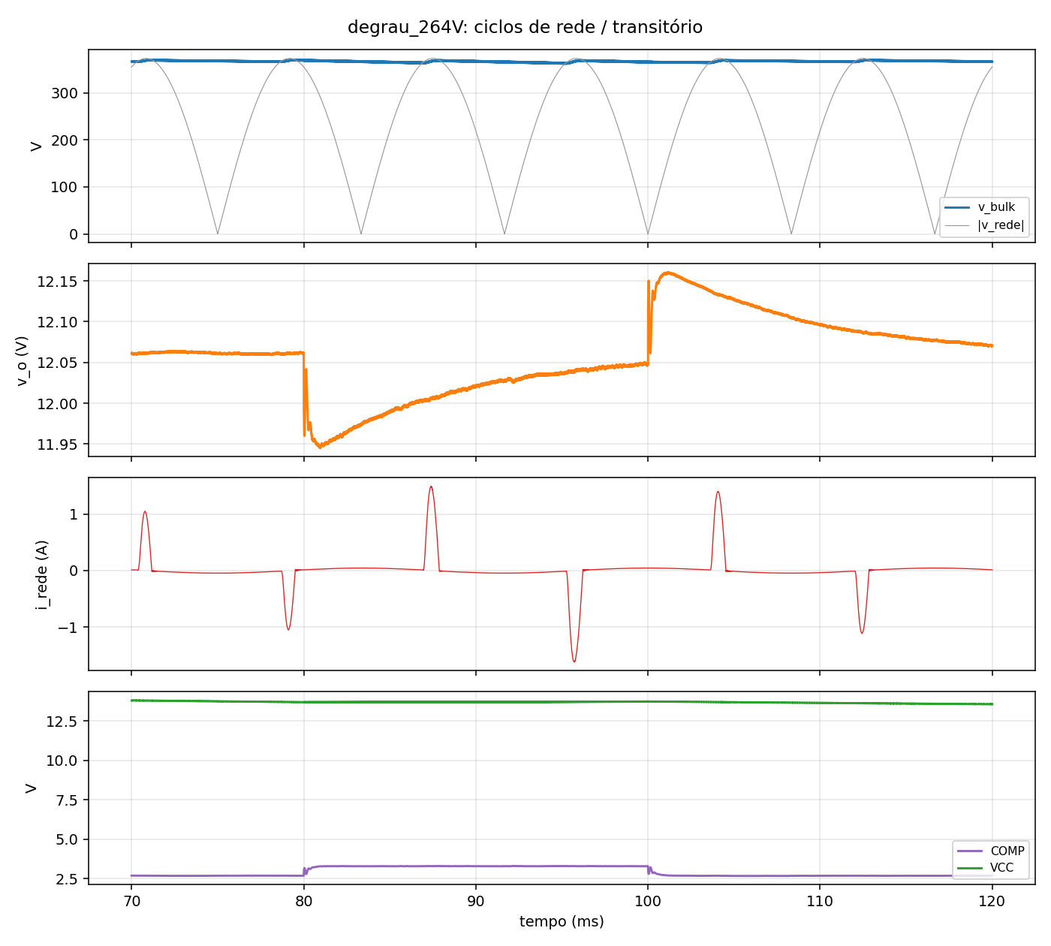
Projeto_Flyback/03_Simulacao/analise/degrau_264V_rede.png
