mateusalgado/IFSC_ELP2/Projeto_Flyback/03_Simulacao/analise/llk3pct_264V_rede.png

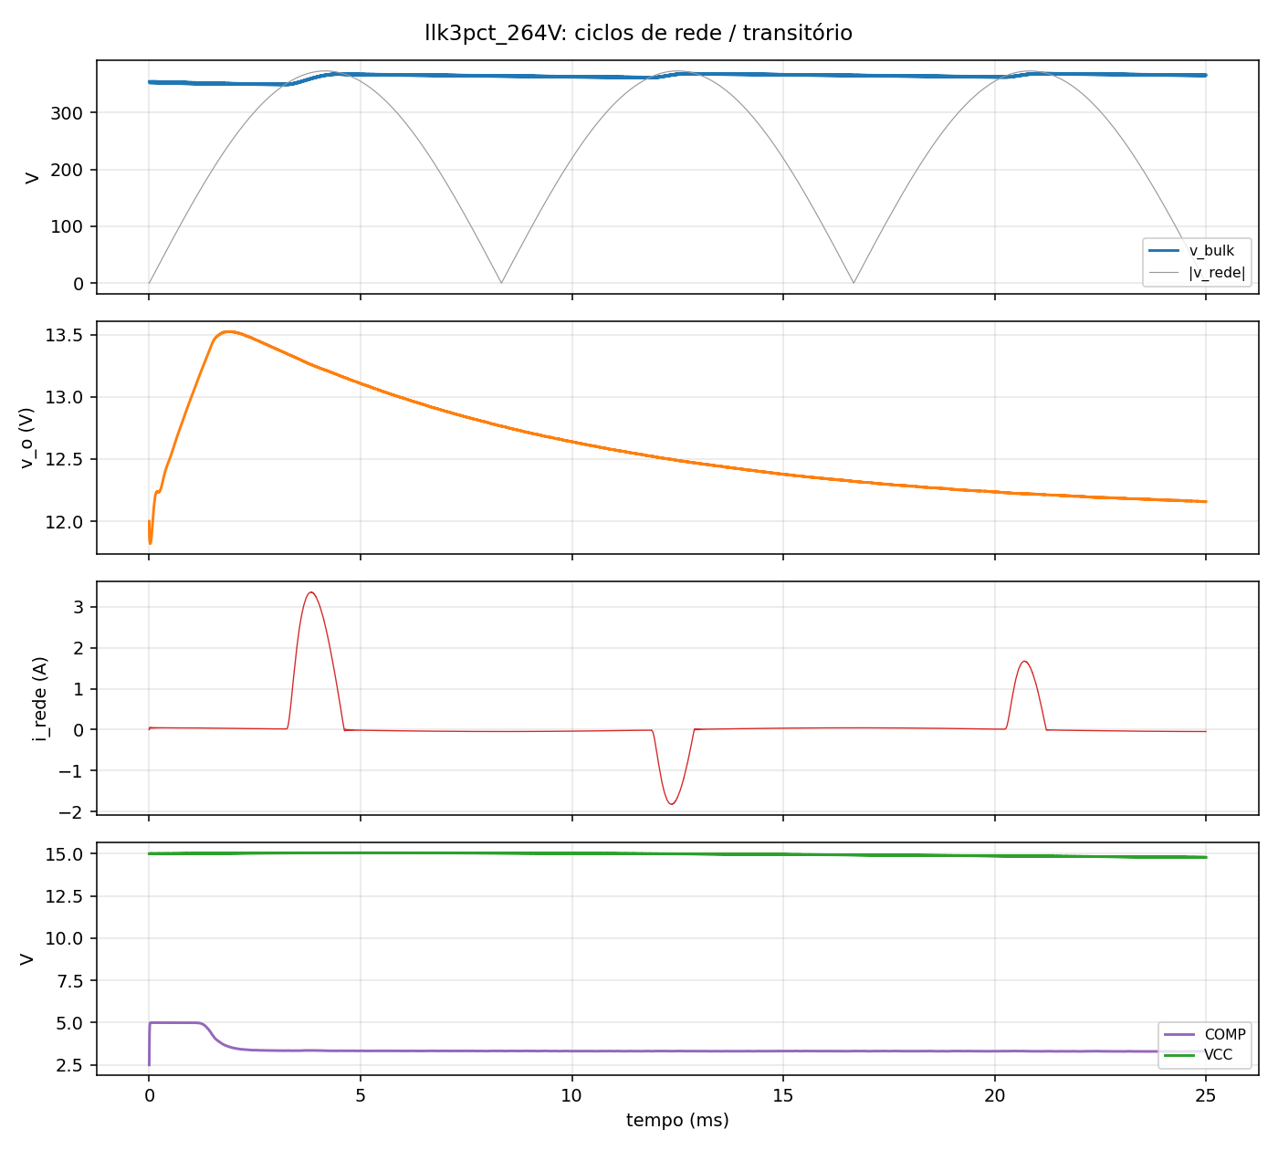
Projeto_Flyback/03_Simulacao/analise/llk3pct_264V_rede.png
