mateusalgado/IFSC_ELP2/Projeto_Flyback/03_Simulacao/analise/partida_90V_comut.png

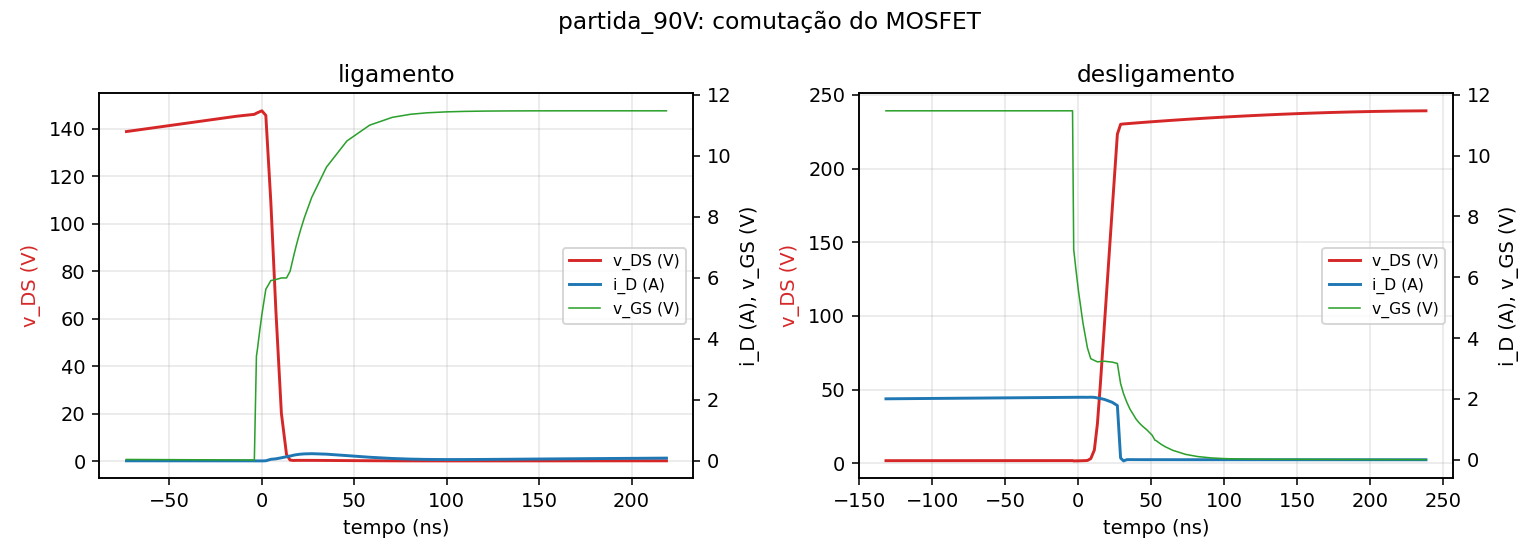
Projeto_Flyback/03_Simulacao/analise/partida_90V_comut.png
