mateusalgado/IFSC_ELP2/Projeto_Flyback/03_Simulacao/analise/partida_264V_ciclo.png

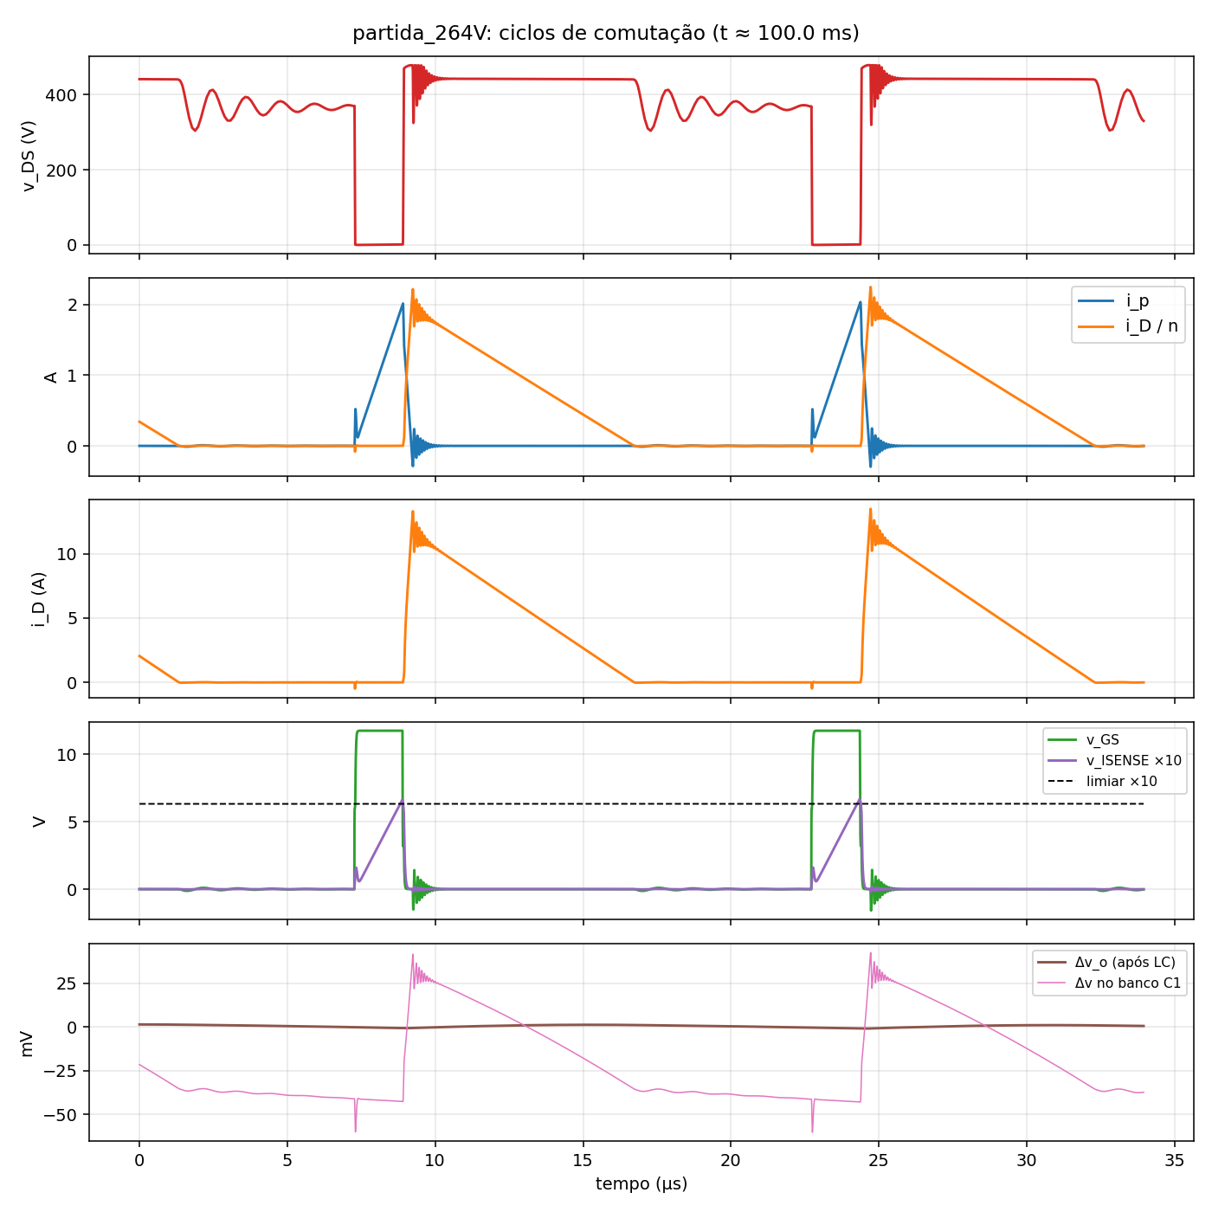
Projeto_Flyback/03_Simulacao/analise/partida_264V_ciclo.png
