mateusalgado/IFSC_ELP2/Projeto_Flyback/03_Simulacao/analise/regime_264V_10pct_ciclo.png

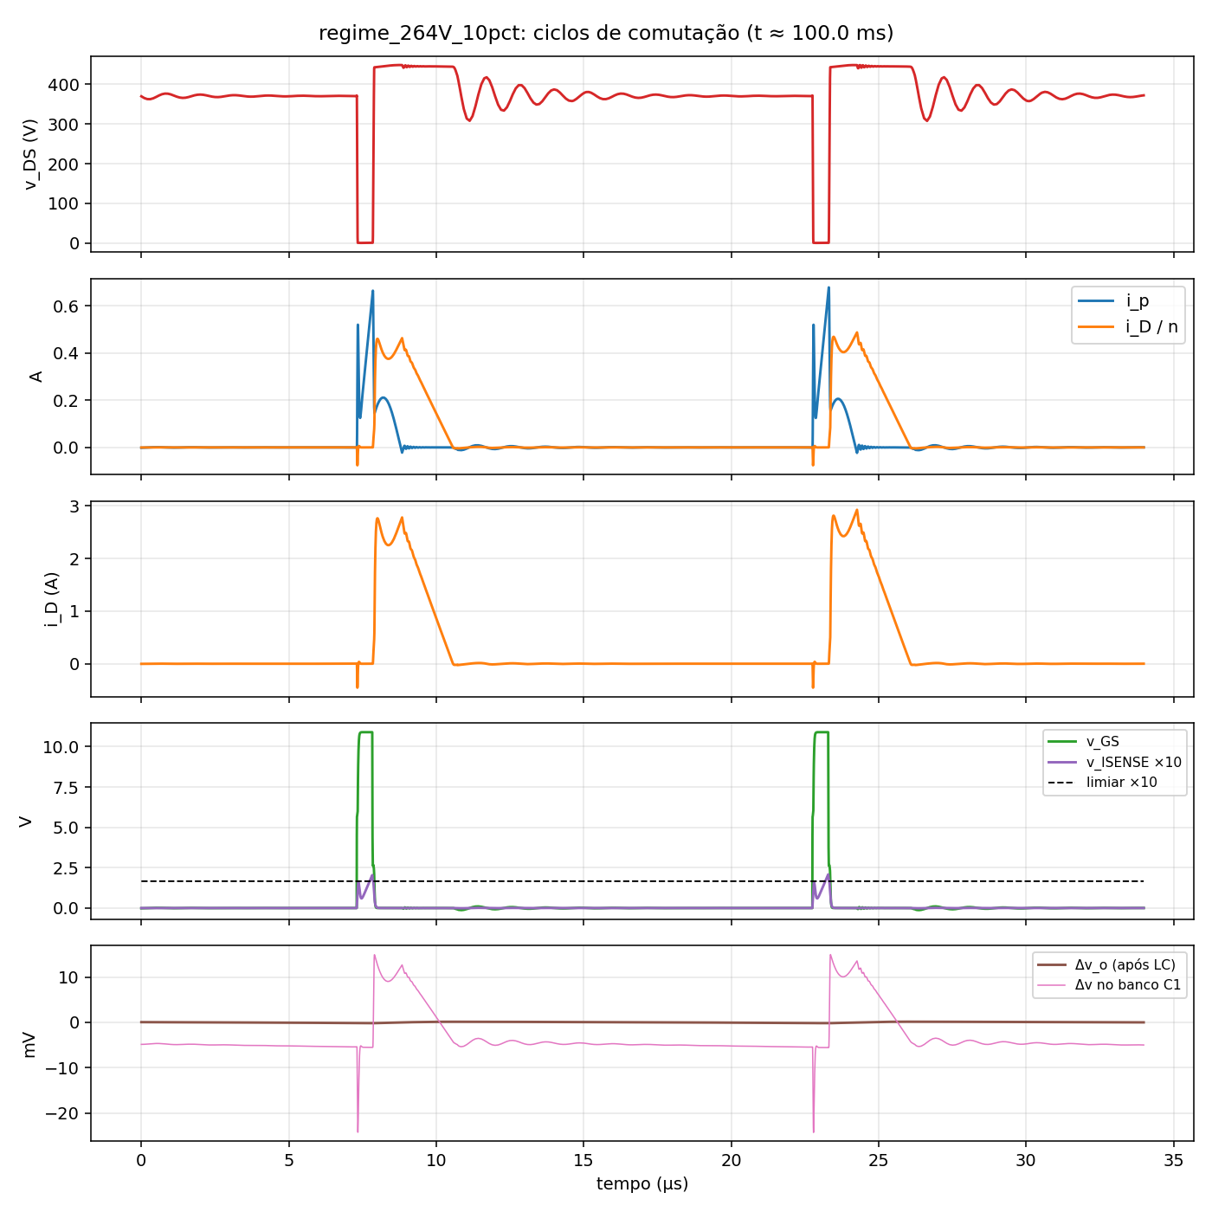
Projeto_Flyback/03_Simulacao/analise/regime_264V_10pct_ciclo.png
