mateusalgado/IFSC_ELP2/Projeto_Flyback/03_Simulacao/analise/regime_264V_50pct_comut.png

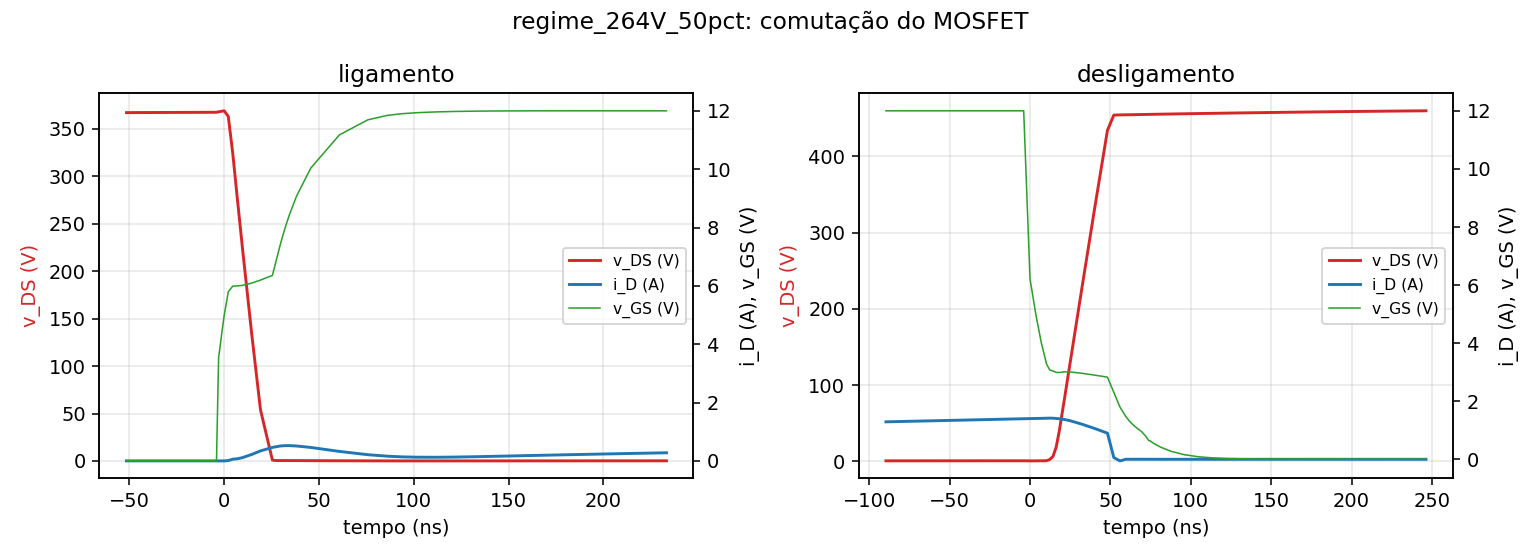
Projeto_Flyback/03_Simulacao/analise/regime_264V_50pct_comut.png
