mateusalgado/IFSC_ELP2/Projeto_Flyback/03_Simulacao/analise/regime_264V_100pct_rede.png

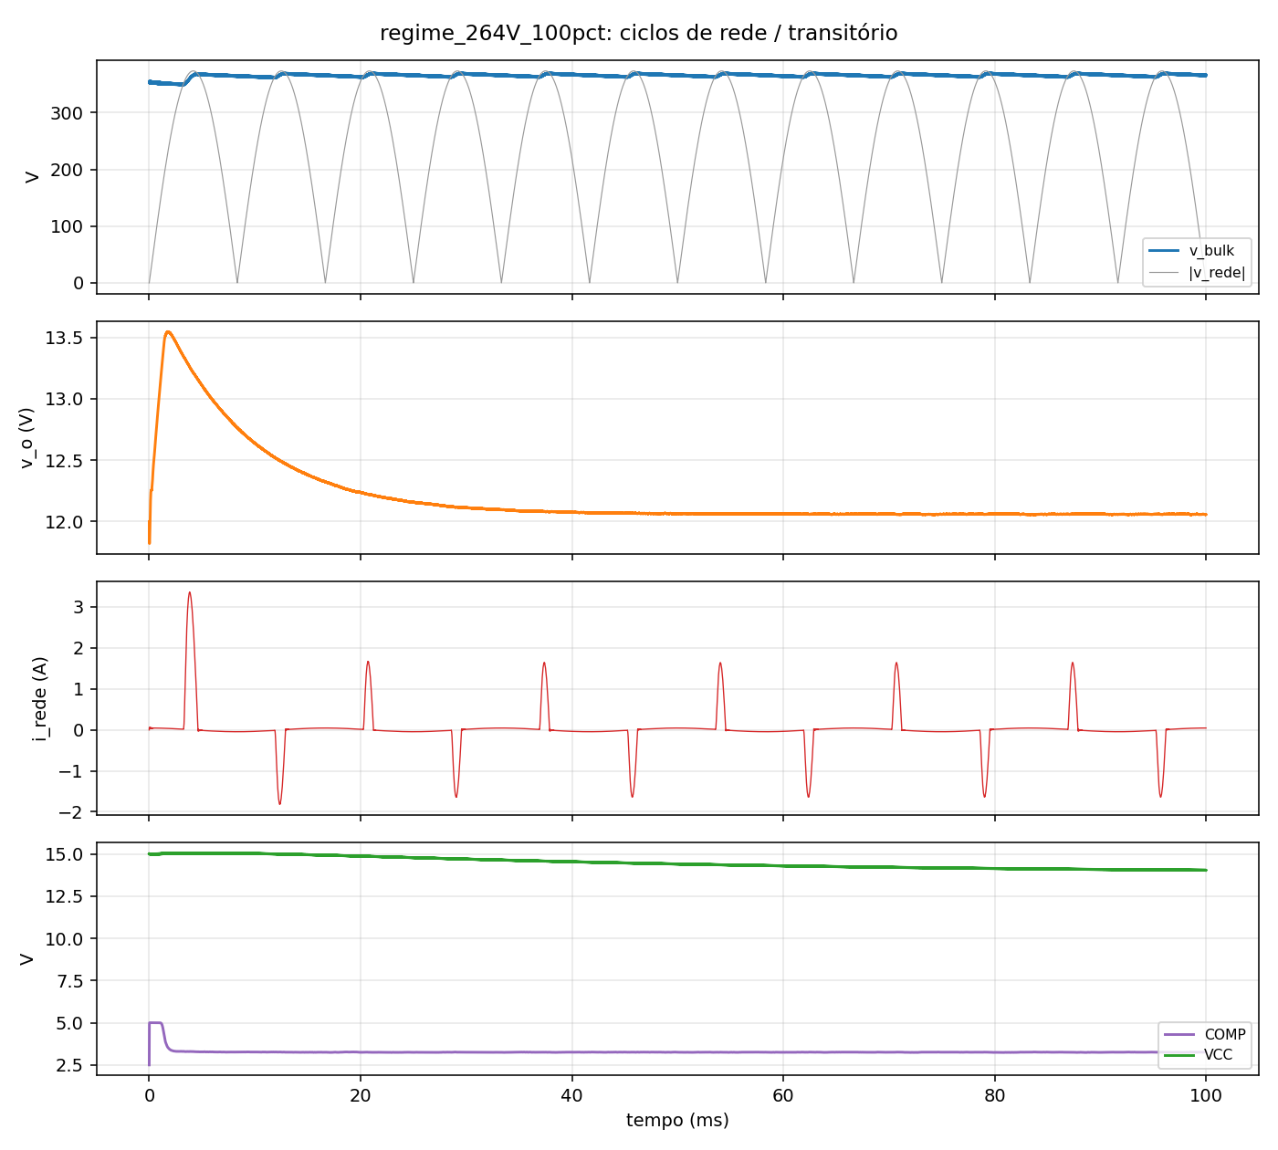
Projeto_Flyback/03_Simulacao/analise/regime_264V_100pct_rede.png
