mateusalgado/IFSC_ELP2/Projeto_Flyback/04_KiCad/3d/pcb_3d_fundo.png

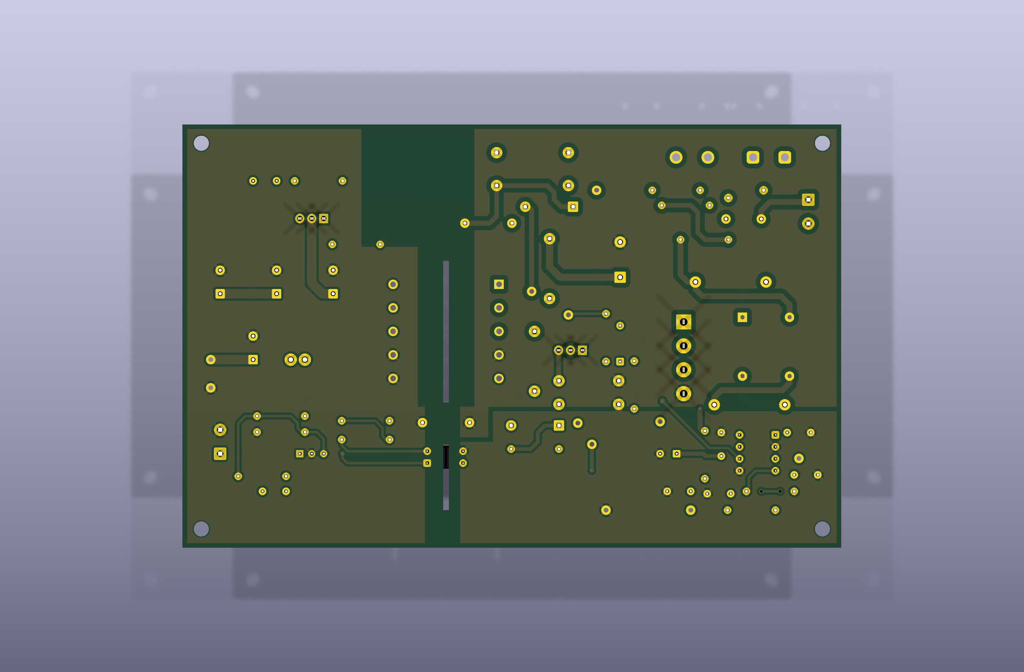
Projeto_Flyback/04_KiCad/3d/pcb_3d_fundo.png
