mateusalgado/IFSC_ELP2/Projeto_Flyback/04_KiCad/3d/pcb_3d_topo.png

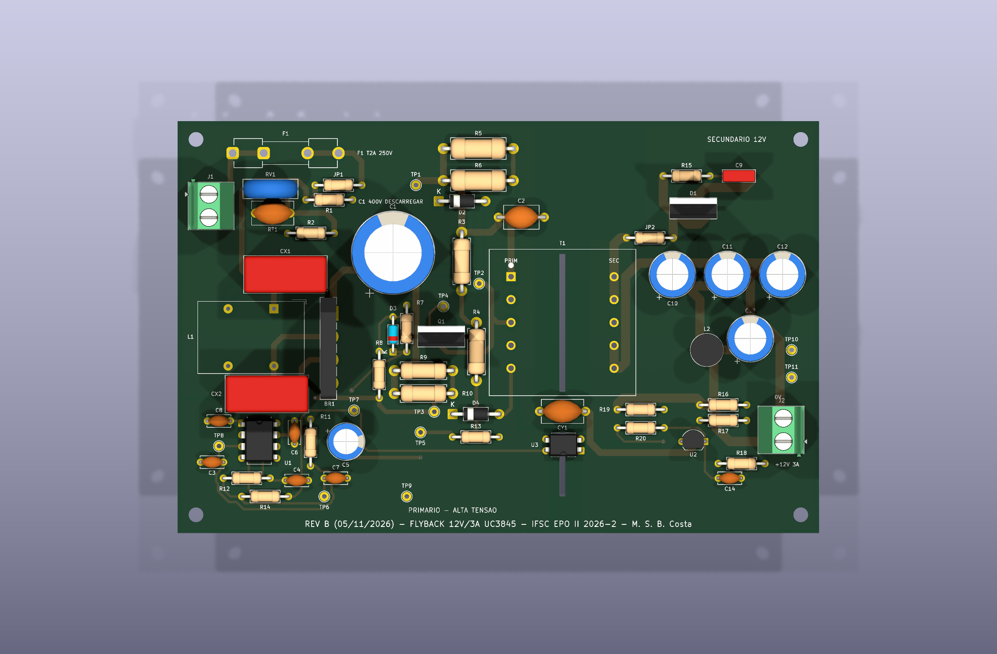
Projeto_Flyback/04_KiCad/3d/pcb_3d_topo.png
