mateusalgado/IFSC_ELP2/Projeto_Flyback/04_KiCad/imagens/pcb_completa.png

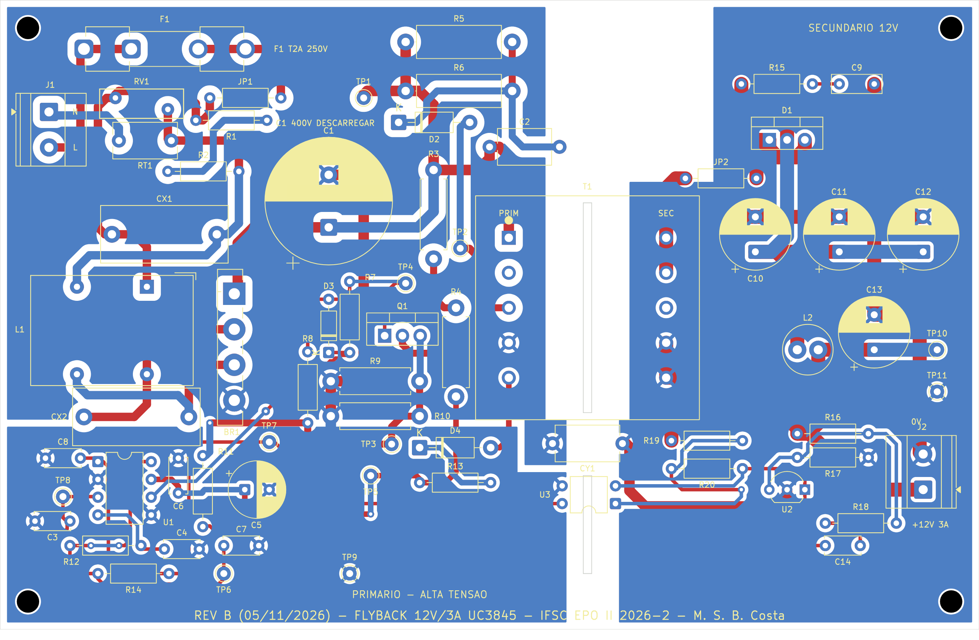
Projeto_Flyback/04_KiCad/imagens/pcb_completa.png
