mateusalgado/IFSC_ELP2/Projeto_Flyback/04_KiCad/imagens/pcb_silk.png

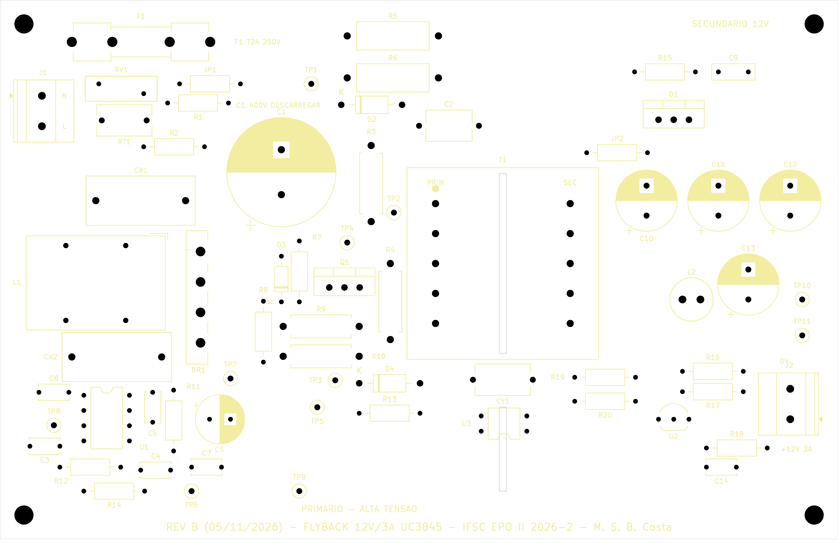
Projeto_Flyback/04_KiCad/imagens/pcb_silk.png
