mateusalgado/IFSC_ELP2/Projeto_Flyback/revisoes/RevA_2026-10-19/03_Simulacao/analise/ctr05_90V_ciclo.png

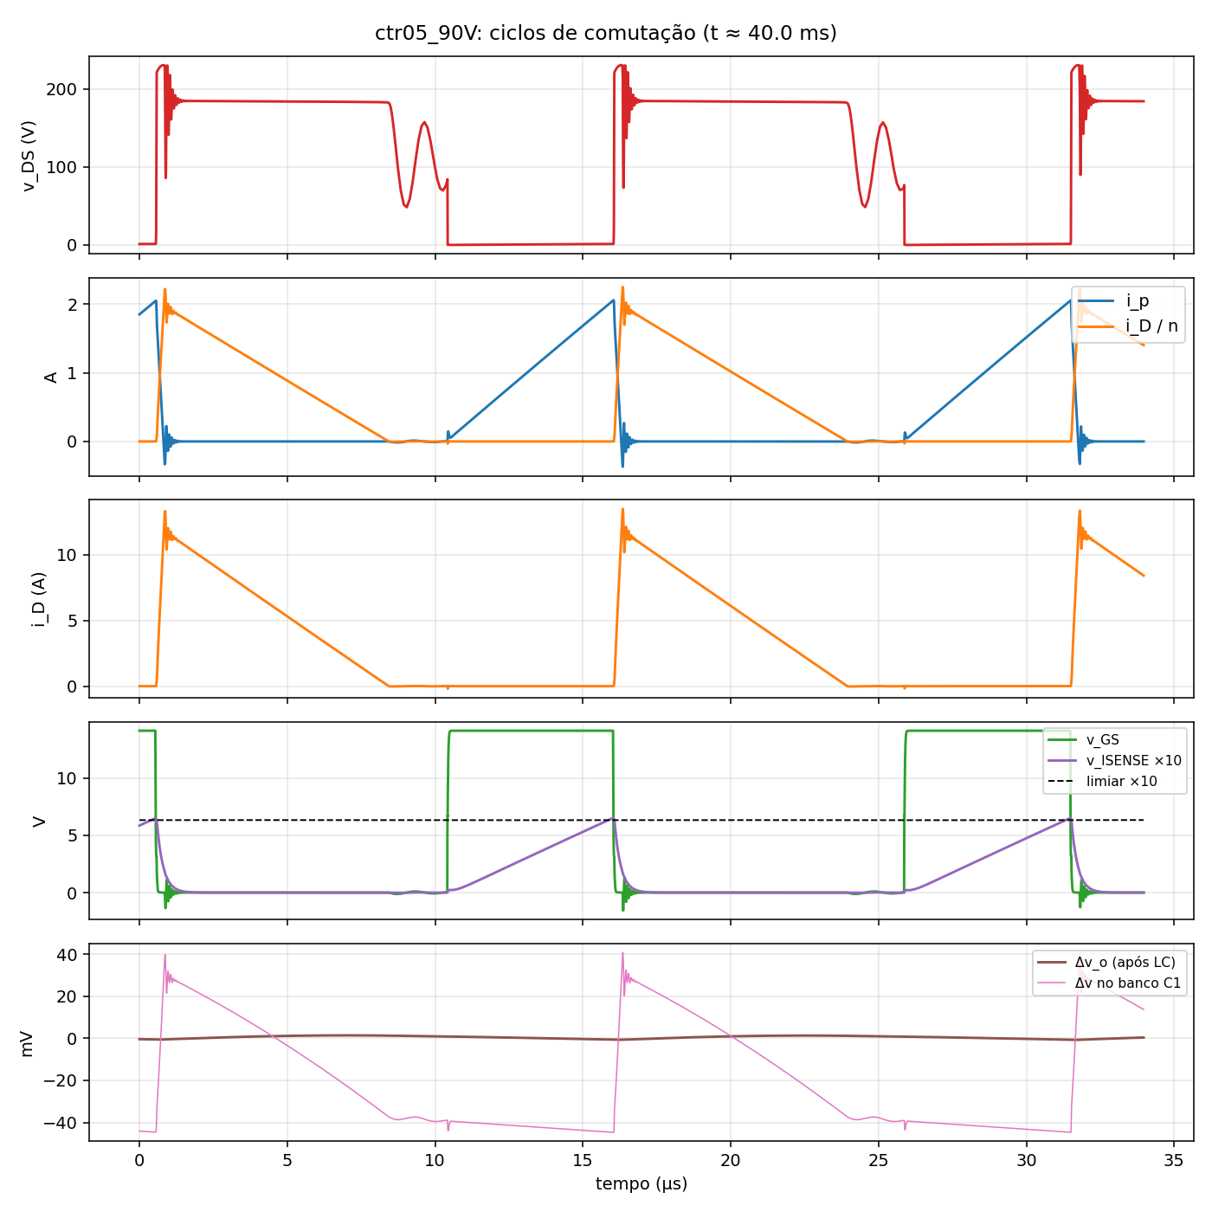
Projeto_Flyback/revisoes/RevA_2026-10-19/03_Simulacao/analise/ctr05_90V_ciclo.png
