mateusalgado/IFSC_ELP2/Projeto_Flyback/revisoes/RevA_2026-10-19/03_Simulacao/analise/llk3pct_264V_rede.png

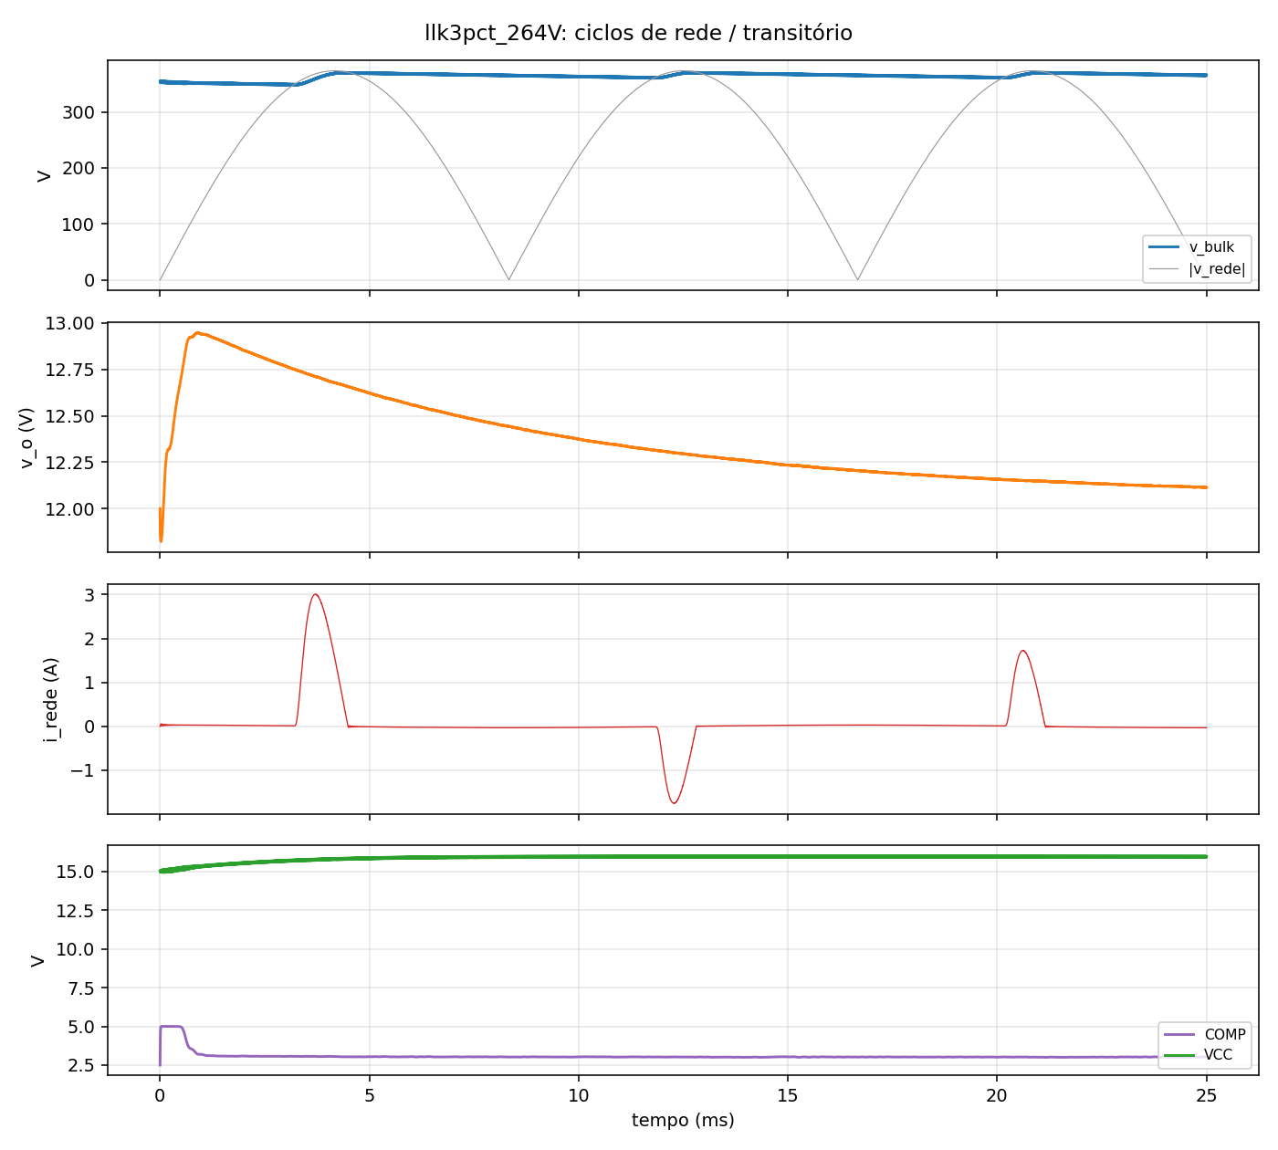
Projeto_Flyback/revisoes/RevA_2026-10-19/03_Simulacao/analise/llk3pct_264V_rede.png
