mateusalgado/IFSC_ELP2/Projeto_Flyback/revisoes/RevA_2026-10-19/03_Simulacao/analise/regime_90V_10pct_ciclo.png

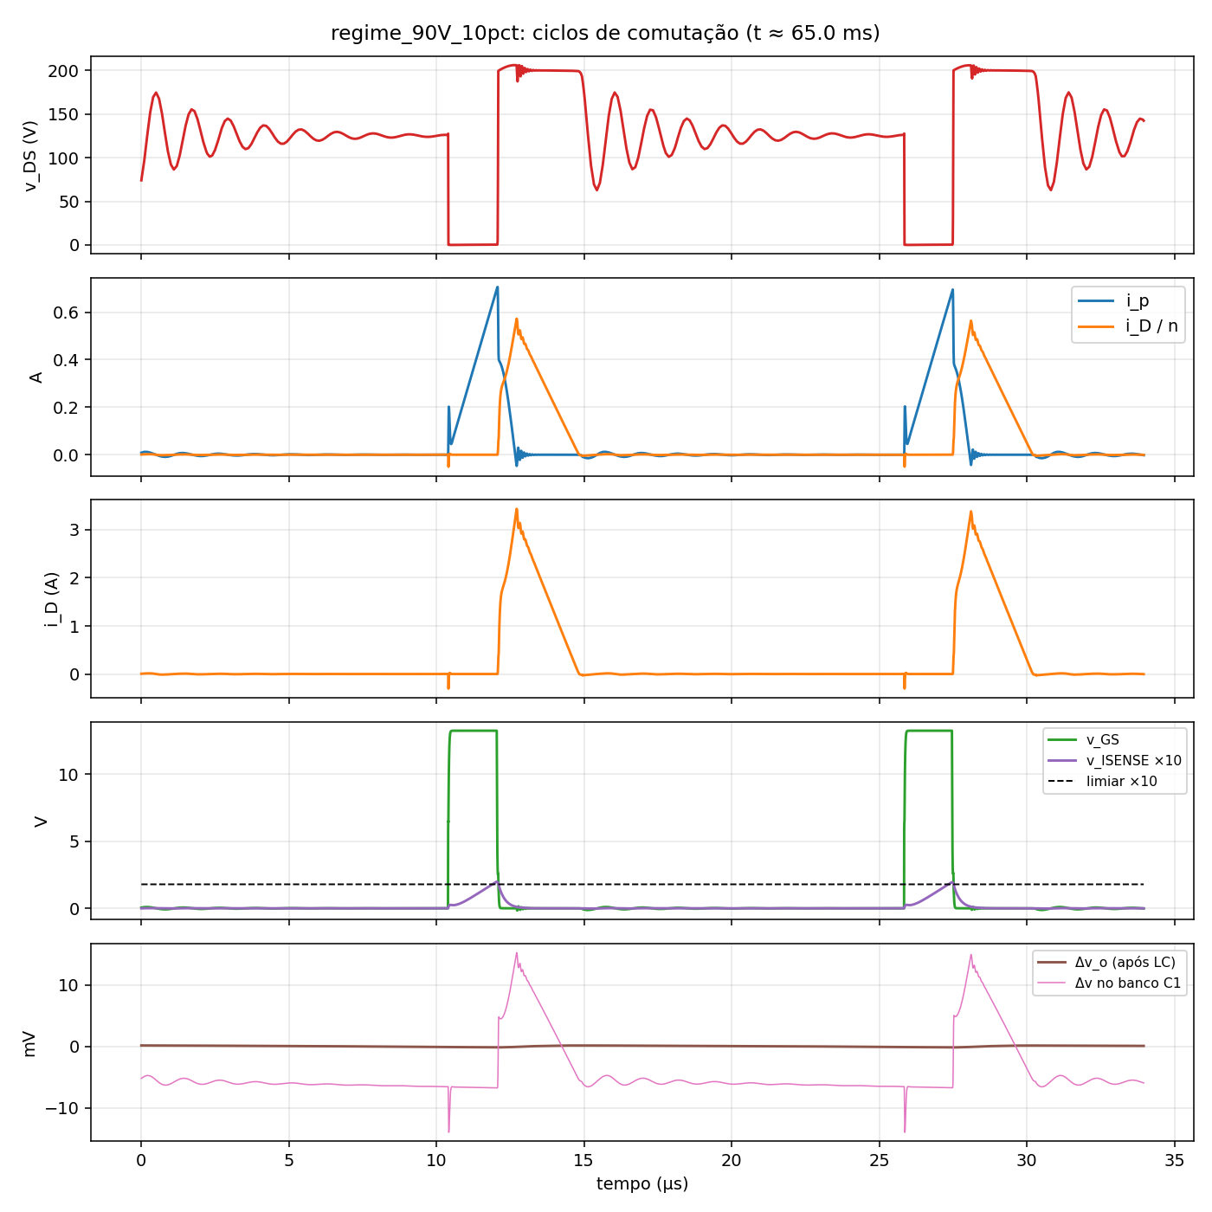
Projeto_Flyback/revisoes/RevA_2026-10-19/03_Simulacao/analise/regime_90V_10pct_ciclo.png
