mateusalgado/IFSC_ELP2/Projeto_Flyback/revisoes/RevA_2026-10-19/03_Simulacao/analise/regime_264V_50pct_rede.png

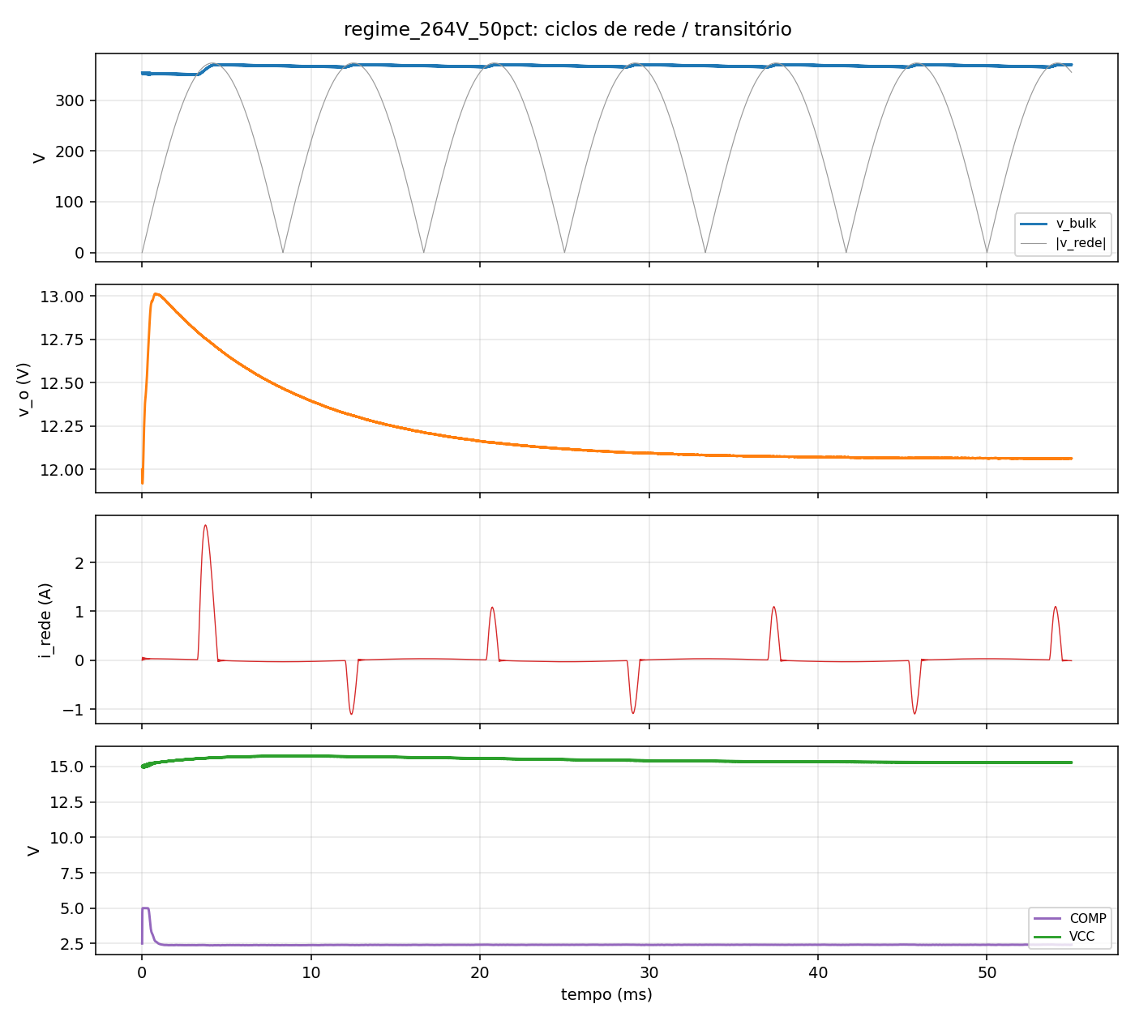
Projeto_Flyback/revisoes/RevA_2026-10-19/03_Simulacao/analise/regime_264V_50pct_rede.png
