mateusalgado/IFSC_ELP2/Projeto_Flyback/revisoes/RevA_2026-10-19/04_KiCad/3d/pcb_3d_fundo.png

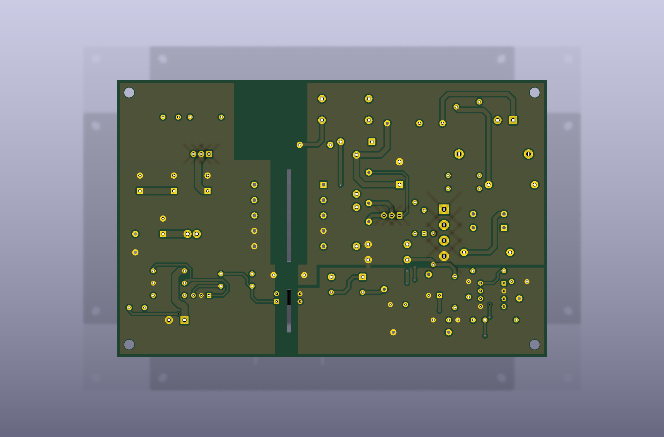
Projeto_Flyback/revisoes/RevA_2026-10-19/04_KiCad/3d/pcb_3d_fundo.png
