mateusalgado/IFSC_ELP2/Projeto_Flyback/revisoes/RevA_2026-10-19/04_KiCad/3d/pcb_3d_topo.png

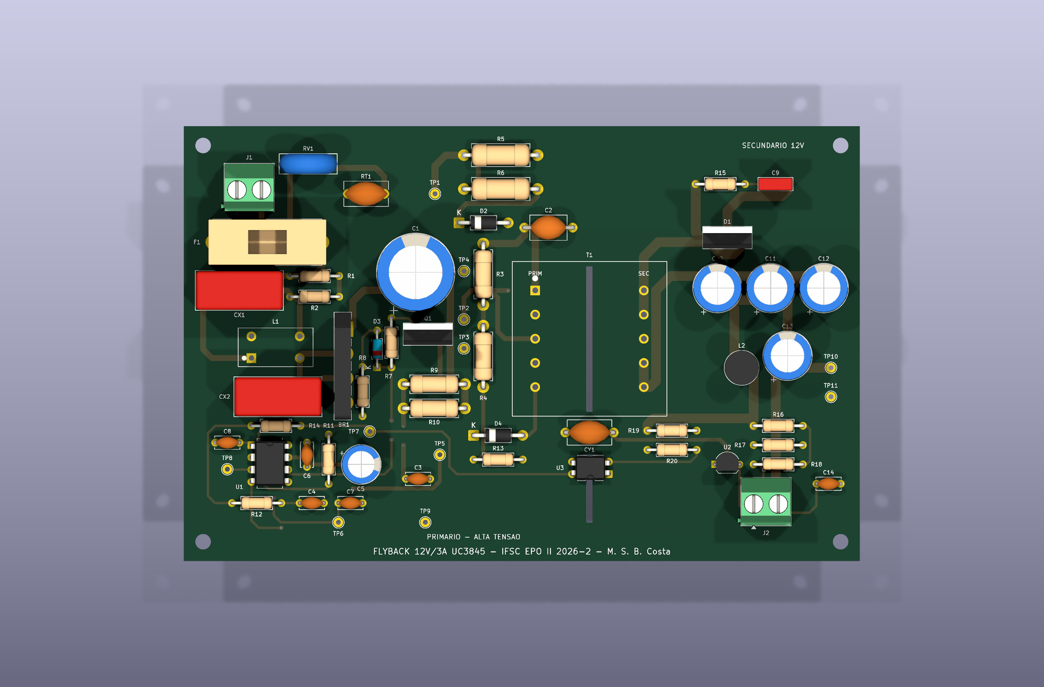
Projeto_Flyback/revisoes/RevA_2026-10-19/04_KiCad/3d/pcb_3d_topo.png
