mateusalgado/IFSC_ELP2/Projeto_Flyback/revisoes/RevA_2026-10-19/04_KiCad/imagens/pcb_completa.png

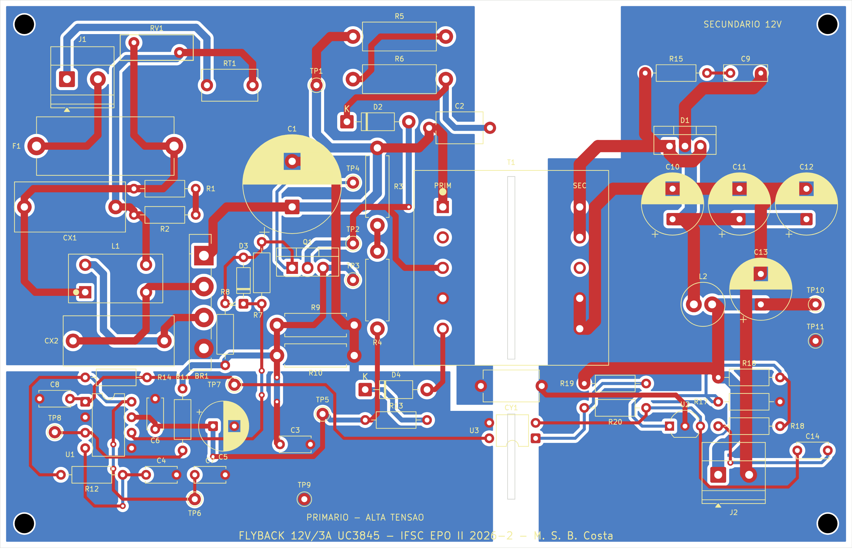
Projeto_Flyback/revisoes/RevA_2026-10-19/04_KiCad/imagens/pcb_completa.png
