mateusalgado/IFSC_ELP2/Tarefa_02_Projeto_Conversor_Estatico/assets/CI.png

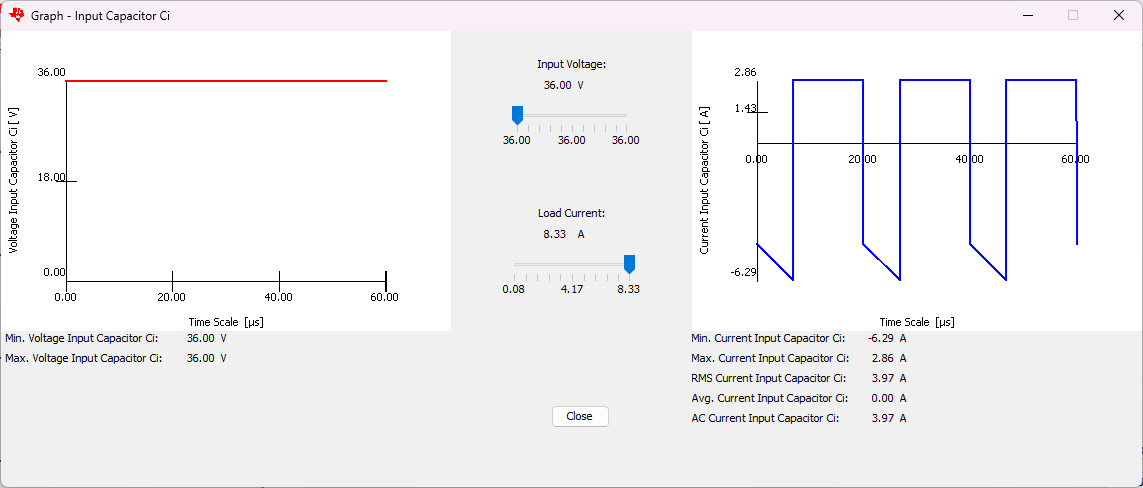
Tarefa_02_Projeto_Conversor_Estatico/assets/CI.png
