mateusalgado/IFSC_ELP2/Projeto_Flyback/05_BOM_Custo/BOM.csv

Refs | Qtd | Descricao | Valor / especificacao | Fabricante | Part number | Distribuidor / codigo | Bloco | US$ unit. (1) | US$ unit. (100) | US$ total (1 un.) | US$ total (100 un., por fonte) | Observacao
J1 | 1 | Borne a parafuso 2 vias 5,08 mm (entrada CA) | MKDS 1,5/2-5,08 | Phoenix Contact | 1715022 | Mouser 651-1715022 | Entrada e protecoes | 0.80 | 0.550 | 0.80 | 0.55
F1 | 1 | Fusível cerâmico 5 × 20 mm de ação lenta (em porta-fusível de clipes) | T 2 A / 250 VCA | Littelfuse | 0215002.MXP | Mouser 576-0215002.MXP | Entrada e protecoes | 0.60 | 0.350 | 0.60 | 0.35 | Rev. B (05/11): porta-fusível no protótipo para trocar sem dessoldar nos ensaios; em produto, fusível axial soldado 477 (US$ 2,00). Conferir Icc e curva tempo-corrente.
F1h | 2 | Clipe para fusível 5 × 20 mm, PTH (par) | Keystone 3517 (passo 23,11 mm) | Keystone | 3517 | Mouser 534-3517 | Entrada e protecoes | 0.25 | 0.150 | 0.50 | 0.30 | Rev. B (05/11): footprint Fuseholder_Clip-5x20mm_Keystone_3517; alternativa nacional: clipe 5 mm de loja
JP1,JP2 | 2 | Laço de fio para sonda de corrente (fase da rede; secundário de T1) | fio 0,8 mm nu, laço de 10 mm elevado 5 mm | diversos | - | fio de sobra (lojas BR) | Mecanica | 0.00 | 0.000 | 0.00 | 0.00 | Rev. B (05/11), Aula 08: pontos de medida de corrente no protótipo; em produto, fio curto rente à placa ou trilha
RV1 | 1 | Varistor 275 VAC disco 14 mm | S14K275 | TDK/EPCOS | B72214S0271K101 | Mouser 871-B72214S0271K101 | Entrada e protecoes | 0.45 | 0.280 | 0.45 | 0.28
RT1 | 1 | Termistor NTC de inrush 10 ohm, 2 A | 10 ohm @25 C, diam. 11 mm | Ametherm | SL10 10002 | Digi-Key 570-1024-ND | Entrada e protecoes | 0.65 | 0.400 | 0.65 | 0.40 | alternativa: Thermometrics CL-110
CX1 | 1 | Capacitor X2 220 nF 305 VAC | 220 nF X2, passo 15 mm | TDK/EPCOS | B32922C3224K | Mouser 871-B32922C3224K | Filtro EMI | 0.55 | 0.320 | 0.55 | 0.32
CX2 | 1 | Capacitor X2 100 nF 305 VAC | 100 nF X2, passo 15 mm | TDK/EPCOS | B32922C3104K | Mouser 871-B32922C3104K | Filtro EMI | 0.45 | 0.260 | 0.45 | 0.26
L1 | 1 | Choke de modo comum | 2 x 10 mH, 1,2 A a 40 °C, 300 VCA | TE / Schaffner | RN214-1.2-02-10M | Schaffner série RN | Filtro EMI | 4.50 | 3.000 | 4.50 | 3.00 | Orçamento B. Rdc 195 mΩ por enrolamento. Pinos 1-2 e 3-4; pontos em 1 e 3.
CY1 | 1 | Capacitor Y1 2,2 nF 500 VAC | 2,2 nF Y1, passo 10 mm | Vishay | VY1222M63Y5UQ63V0 | Mouser 594-VY1222M63Y5UQ63V0 | Filtro EMI | 0.45 | 0.260 | 0.45 | 0.26
R1,R2 | 2 | Resistor de descarga do X2 470 kohm 1/4 W | 470 kohm 1 % | Yageo | MFR-25FBF52-470K | Mouser 603-MFR-25FBF52-470K | Filtro EMI | 0.03 | 0.015 | 0.06 | 0.03
BR1 | 1 | Ponte retificadora 600 V / 4 A | GBU4J | Vishay | GBU4J-E3/51 | Mouser 625-GBU4J-E3 | Retificador e bulk | 0.70 | 0.450 | 0.70 | 0.45
C1 | 1 | Capacitor eletrolítico de barramento | 150 µF / 400 V, 105 °C, 18 x 40 mm | Nichicon | UCY2G151MHD | Nichicon UCY | Retificador e bulk | 3.20 | 2.100 | 3.20 | 2.10 | Orçamento B. Avaliar ondulação por frequência e temperatura.
R3,R4 | 2 | Resistor de partida 82 kohm 1 W | 82 kohm 5 % 1 W | Vishay | PR01000108209JR500 | Mouser 594-PR01000108209JR5 | Comando UC3845 | 0.12 | 0.070 | 0.24 | 0.14
D2 | 1 | Diodo ultrarrapido do snubber 1000 V / 1 A | UF4007 | Vishay | UF4007-E3/54 | Mouser 625-UF4007-E3 | Snubber RCD | 0.20 | 0.090 | 0.20 | 0.09
C2 | 1 | Capacitor de filme 22 nF / 630 V do snubber | 22 nF 630 V, passo 10 mm | TDK/EPCOS | B32652A6223J | Mouser 871-B32652A6223J | Snubber RCD | 0.45 | 0.250 | 0.45 | 0.25
R5,R6 | 2 | Resistor do snubber 18 kohm 2 W | 18 kohm 5 % 2 W | Vishay | PR02000201802JR500 | Mouser 594-PR02000201802JR5 | Snubber RCD | 0.18 | 0.100 | 0.36 | 0.20 | Paralelo: 9 kΩ, 4 W nominais no conjunto.
Q1 | 1 | MOSFET 650 V / 11 A TO-220FP (encapsulamento isolado) MDmesh M2 | STF13N65M2 | STMicroelectronics | STF13N65M2 | Mouser 511-STF13N65M2 | Potencia primaria | 2.20 | 1.500 | 2.20 | 1.50 | Rev. B: versao isolada (dissipador clip sem potencial do dreno). Mesmo die do STP13N65M2 usado no modelo LTspice. Substitutos: IPA65R400CE (TO-220FP), FCPF190N65S3
HS1 | 1 | Dissipador clip TO-220 24 C/W | 574502B00000G | Aavid/Boyd | 574502B00000G | Mouser 532-574502B00000 | Potencia primaria | 0.60 | 0.400 | 0.60 | 0.40
ISO1 | 0 | Kit isolador TO-220 (mica + bucha) - nao necessario com Q1 em TO-220FP | mica TO-220 | Aavid/Boyd | 4880G | Mouser 532-4880G | Potencia primaria | 0.30 | 0.180 | 0.00 | 0.00 | Rev. B: quantidade 0; manter so se Q1 voltar a TO-220 metalico
R9,R10 | 2 | Resistor de sensoriamento 0,68 ohm 1 W (2 em paralelo) | 0,68 ohm 5 % 1 W | TE Connectivity | ROX1SJR68 | TE ROX | Potencia primaria | 0.15 | 0.090 | 0.30 | 0.18 | 2 x 0,68 ohm em paralelo = 0,34 ohm
R7 | 1 | Resistor de gate 10 ohm 1/4 W | 10 ohm 5 % | Yageo | CFR-25JB-52-10R | Mouser 603-CFR-25JB-52-10R | Comando UC3845 | 0.02 | 0.010 | 0.02 | 0.01
D3 | 1 | Diodo de descarga do gate | 1N4148 | onsemi | 1N4148 | Mouser 512-1N4148 | Comando UC3845 | 0.05 | 0.020 | 0.05 | 0.02
R8 | 1 | Resistor gate-source 10 kohm | 10 kohm 5 % | Yageo | CFR-25JB-52-10K | Mouser 603-CFR-25JB-52-10K | Comando UC3845 | 0.02 | 0.010 | 0.02 | 0.01
T1 | 1 | Transformador flyback EE30/15/7, Lp = 294 uH, Np 42 / Ns 7 / Naux 9 | nucleo NEE-30/15/7 IP12R (2 pc) + carretel 10 pinos + 2 presilhas | Thornton (BR) | NEE-30/15/7-IP12R + CNEE-30/15/7-10P | Thornton / lojas BR (Soldafria, Bau da Eletronica) | Transformador | 3.50 | 2.400 | 3.50 | 2.40 | alt. importada: TDK B66317G0500X187 (N87, 2 pc) + carretel B66318B1010T001; fio 23 AWG esmaltado ~15 m
T1w | 1 | Fio esmaltado 23 AWG (0,573 mm) + fita Mylar/Kapton 10 mm | ~15 m | diversos | - | lojas BR | Transformador | 1.00 | 0.600 | 1.00 | 0.60
D1 | 1 | Diodo Schottky duplo 100 V / 2x10 A TO-220 | STPS20H100CT | STMicroelectronics | STPS20H100CT | Mouser 511-STPS20H100CT | Secundario | 0.95 | 0.600 | 0.95 | 0.60 | RS UK GBP 0,42
HS2 | 1 | Dissipador clip TO-220 24 C/W | 574502B00000G | Aavid/Boyd | 574502B00000G | Mouser 532-574502B00000 | Secundario | 0.60 | 0.400 | 0.60 | 0.40
R15 | 1 | Resistor RC do diodo 15 ohm 1/2 W | 15 ohm 5 % 0,5 W | Vishay | SFR25H0001509JR500 | Mouser 594-SFR25H0001509JR5 | Secundario | 0.05 | 0.030 | 0.05 | 0.03
C9 | 1 | Capacitor de filme RC do diodo 2,2 nF / 100 V | 2,2 nF 100 V | WIMA | FKP2D012201D00JSSD | Mouser 505-FKP2D012201D00JSSD | Secundario | 0.25 | 0.140 | 0.25 | 0.14 | 2,2 nF instalado e simulado
C10,C11,C12 | 3 | Capacitor eletrolitico baixo ESR 1000 uF / 25 V | Rubycon ZLH 1000 uF 25 V, 10x20 | Rubycon | 25ZLH1000MEFC10X20 | Mouser 232-25ZLH1000MEFC10X | Secundario | 0.55 | 0.320 | 1.65 | 0.96
L2 | 1 | Indutor do pos-filtro 3,3 uH / 3,6 A típ. | 3,3 uH radial, Isat típ. 11,3 A | Bourns | RLB0914-3R3ML | Mouser 652-RLB0914-3R3ML | Secundario | 0.35 | 0.220 | 0.35 | 0.22
C13 | 1 | Capacitor eletrolitico 470 uF / 25 V | Rubycon ZLH 470 uF 25 V, 10x12,5 | Rubycon | 25ZLH470MEFC10X12.5 | Mouser 232-25ZLH470MEFC10X1 | Secundario | 0.40 | 0.240 | 0.40 | 0.24
J2 | 1 | Borne a parafuso 2 vias 5,08 mm (saida 12 V) | MKDS 1,5/2-5,08 | Phoenix Contact | 1715022 | Mouser 651-1715022 | Secundario | 0.80 | 0.550 | 0.80 | 0.55
U1 | 1 | Controlador PWM modo corrente | UC3845BN DIP-8 | STMicroelectronics (ou onsemi UC3845BNG) | UC3845BN | Mouser 511-UC3845BN | Comando UC3845 | 0.85 | 0.500 | 0.85 | 0.50 | LCSC C5175 US$ 0,47
U1s | 1 | Soquete DIP-8 | DIP-8 | diversos | - | LCSC / lojas BR | Comando UC3845 | 0.15 | 0.080 | 0.15 | 0.08
R12 | 1 | Resistor RT 6,04 kohm 1 % | 6,04 kohm 1 % | Yageo | MFR-25FBF52-6K04 | Mouser 603-MFR-25FBF52-6K04 | Comando UC3845 | 0.03 | 0.015 | 0.03 | 0.01
C4 | 1 | Capacitor CT 2,2 nF C0G/NP0 | 2,2 nF 50 V C0G | TDK | FG18C0G1H222JNT06 | Mouser 810-FG18C0G1H222JNT6 | Comando UC3845 | 0.20 | 0.100 | 0.20 | 0.10
R11 | 1 | Resistor do filtro de CS 330 ohm | 330 ohm 5 % | Yageo | CFR-25JB-52-330R | Mouser 603-CFR-25JB-52-330R | Comando UC3845 | 0.02 | 0.010 | 0.02 | 0.01
C3 | 1 | Capacitor do filtro de CS 100 pF | 100 pF 50 V C0G | TDK | FG18C0G1H101JNT06 | Mouser 810-FG18C0G1H101JNT6 | Comando UC3845 | 0.15 | 0.080 | 0.15 | 0.08
C6 | 1 | Capacitor de desacoplamento 100 nF | 100 nF 50 V X7R | KEMET | C320C104K5R5TA | Mouser 80-C320C104K5R | Comando UC3845 | 0.12 | 0.060 | 0.12 | 0.06
C7 | 1 | Capacitor do VREF 1 uF | 1 uF 50 V X7R | KEMET | C330C105K5R5TA | Mouser 80-C330C105K5R | Comando UC3845 | 0.20 | 0.100 | 0.20 | 0.10
C5 | 1 | Capacitor do VCC 220 uF / 35 V | 220 uF 35 V 105 C | Panasonic | EEU-FR1V221 | Mouser 667-EEU-FR1V221 | Comando UC3845 | 0.30 | 0.160 | 0.30 | 0.16
D4 | 1 | Diodo do auxiliar 400 V / 1 A ultrarrapido | UF4004 | Vishay | UF4004-E3/54 | Mouser 625-UF4004-E3 | Comando UC3845 | 0.18 | 0.080 | 0.18 | 0.08
R13 | 1 | Resistor serie do auxiliar 100 ohm (hiccup no curto) | 100 ohm 5 % 1/4 W | Yageo | CFR-25JB-52-100R | Mouser 603-CFR-25JB-52-100R | Comando UC3845 | 0.02 | 0.010 | 0.02 | 0.01 | Rev. B: 10 -> 100 ohm para o VCC cair no curto-circuito e o UC3845 desligar por UVLO
R14 | 1 | Resistor de pull-up do COMP 4,7 kohm | 4,7 kohm 5 % | Yageo | CFR-25JB-52-4K7 | Mouser 603-CFR-25JB-52-4K7 | Realimentacao | 0.02 | 0.010 | 0.02 | 0.01
C8 | 1 | Capacitor do COMP 1 nF | 1 nF 50 V C0G | TDK | FG18C0G1H102JNT06 | Mouser 810-FG18C0G1H102JNT6 | Realimentacao | 0.15 | 0.080 | 0.15 | 0.08
U3 | 1 | Optoacoplador CTR 100-200 % | PC817X2NSZ9F | Sharp | PC817X2NSZ9F | Mouser 852-PC817X2NSZ9F | Realimentacao | 0.45 | 0.250 | 0.45 | 0.25
U2 | 1 | Referencia ajustavel 2,5 V | TL431ACLP TO-92 | Texas Instruments | TL431ACLPR | Mouser 595-TL431ACLP | Realimentacao | 0.30 | 0.120 | 0.30 | 0.12
R16 | 1 | Resistor divisor Ra 9,53 kohm 1 % | 9,53 kohm 1 % | Yageo | MFR-25FBF52-9K53 | Mouser 603-MFR-25FBF52-9K53 | Realimentacao | 0.03 | 0.015 | 0.03 | 0.01
R17 | 1 | Resistor divisor Rb 2,49 kohm 1 % | 2,49 kohm 1 % | Yageo | MFR-25FBF52-2K49 | Mouser 603-MFR-25FBF52-2K49 | Realimentacao | 0.03 | 0.015 | 0.03 | 0.01
R18 | 1 | Resistor do compensador Rz 21,5 kohm 1 % | 21,5 kohm 1 % | Yageo | MFR-25FBF52-21K5 | Mouser 603-MFR-25FBF52-21K5 | Realimentacao | 0.03 | 0.015 | 0.03 | 0.01
C14 | 1 | Capacitor do compensador Cz 270 nF | 270 nF 50 V X7R | KEMET | C322C274K5R5TA | Mouser 80-C322C274K5R | Realimentacao | 0.15 | 0.080 | 0.15 | 0.08
R19 | 1 | Resistor do LED do opto 2,74 kohm 1 % | 2,74 kohm 1 % | Yageo | MFR-25FBF52-2K74 | Mouser 603-MFR-25FBF52-2K74 | Realimentacao | 0.03 | 0.015 | 0.03 | 0.01
R20 | 1 | Resistor de polarizacao do TL431 1 kohm | 1 kohm 5 % | Yageo | CFR-25JB-52-1K | Mouser 603-CFR-25JB-52-1K | Realimentacao | 0.02 | 0.010 | 0.02 | 0.01
TP1-TP11 | 11 | Ponto de teste (terminal PTH) | Keystone 5000 ou pino de header | Keystone | 5000 | Mouser 534-5000 | Mecanica | 0.20 | 0.100 | 2.20 | 1.10 | opcional: pino de header
H1-H4 | 4 | Espacador M3 x 10 mm + parafuso e porca | M3 | diversos | - | lojas BR | Mecanica | 0.15 | 0.080 | 0.60 | 0.32
PCB | 1 | Placa de circuito impresso 2 camadas FR-4 1,6 mm, 140 x 90 mm, HASL sem chumbo | fonte_flyback_12V3A (gerbers/) | JLCPCB / PCBWay | - | cotacao on-line com os Gerbers | PCI (2 camadas, 140x90 mm, FR-4 1,6 mm) | 9.60 | 1.900 | 9.60 | 1.90 | 5 pc = US$ 48 com frete; 100 pc = US$ 190
TOTAL por fonte |  |  |  |  |  |  |  |  |  | 42.73 | 22.37 | R$ 235.02 (1 un.) / R$ 123.01 (100 un.) a US$ 1 = R$ 5.50
