mateusalgado/IFSC_ELP2/Projeto_Flyback/revisoes/RevA_2026-10-19/04_KiCad/bom_kicad.csv

Reference | Value | Footprint
BR1 | GBU4J | Diode_THT:Diode_Bridge_Vishay_GBU
C1 | 100uF 400V | Capacitor_THT:CP_Radial_D16.0mm_P7.50mm
C2 | 22nF 630V | Capacitor_THT:C_Disc_D7.5mm_W5.0mm_P10.00mm
C3 | 220p | Capacitor_THT:C_Disc_D5.0mm_W2.5mm_P5.00mm
C4 | 2.2nF | Capacitor_THT:C_Disc_D5.0mm_W2.5mm_P5.00mm
C5 | 220uF 35V | Capacitor_THT:CP_Radial_D8.0mm_P3.50mm
C6 | 100n | Capacitor_THT:C_Disc_D5.0mm_W2.5mm_P5.00mm
C7 | 1u | Capacitor_THT:C_Disc_D5.0mm_W2.5mm_P5.00mm
C8 | 1nF | Capacitor_THT:C_Disc_D5.0mm_W2.5mm_P5.00mm
C9 | 2.4nF 100V | Capacitor_THT:C_Rect_L7.0mm_W2.5mm_P5.00mm
C10-C12 | 1000u 25V | Capacitor_THT:CP_Radial_D10.0mm_P5.00mm
C13 | 470uF 25V | Capacitor_THT:CP_Radial_D10.0mm_P5.00mm
C14 | 150nF | Capacitor_THT:C_Disc_D5.0mm_W2.5mm_P5.00mm
CX1 | 220nF X2 | Capacitor_THT:C_Rect_L18.0mm_W8.0mm_P15.00mm_FKS3_FKP3
CX2 | 100nF X2 | Capacitor_THT:C_Rect_L18.0mm_W8.0mm_P15.00mm_FKS3_FKP3
CY1 | 2.2nF Y1 | Capacitor_THT:C_Disc_D9.0mm_W5.0mm_P10.00mm
D1 | STPS20H100CT | Package_TO_SOT_THT:TO-220-3_Vertical
D2 | UF4007 | Diode_THT:D_DO-41_SOD81_P10.16mm_Horizontal
D3 | 1N4148 | Diode_THT:D_DO-35_SOD27_P7.62mm_Horizontal
D4 | UF4004 | Diode_THT:D_DO-41_SOD81_P10.16mm_Horizontal
F1 | T 2A 250V | Fuse:Fuseholder_Cylinder-5x20mm_Stelvio-Kontek_PTF78_Horizontal_Open
J1 | ENTRADA CA | TerminalBlock_Phoenix:TerminalBlock_Phoenix_MKDS-1,5-2-5.08_1x02_P5.08mm_Horizontal
J2 | SAIDA 12V | TerminalBlock_Phoenix:TerminalBlock_Phoenix_MKDS-1,5-2-5.08_1x02_P5.08mm_Horizontal
L1 | 10mH CM | fonte:L_CM_WE-CMB-XS
L2 | 3.3uH | Inductor_THT:L_Radial_D7.0mm_P3.00mm
Q1 | STP13N65M2 | Package_TO_SOT_THT:TO-220-3_Vertical
R1,R2 | 470k | Resistor_THT:R_Axial_DIN0207_L6.3mm_D2.5mm_P10.16mm_Horizontal
R3,R4 | 82k 1W | Resistor_THT:R_Axial_DIN0411_L9.9mm_D3.6mm_P12.70mm_Horizontal
R5,R6 | 18.2k 2W | Resistor_THT:R_Axial_DIN0414_L11.9mm_D4.5mm_P15.24mm_Horizontal
R7 | 10 | Resistor_THT:R_Axial_DIN0207_L6.3mm_D2.5mm_P10.16mm_Horizontal
R8 | 10k | Resistor_THT:R_Axial_DIN0207_L6.3mm_D2.5mm_P10.16mm_Horizontal
R9,R10 | 660m 1W | Resistor_THT:R_Axial_DIN0411_L9.9mm_D3.6mm_P12.70mm_Horizontal
R11,R20 | 1k | Resistor_THT:R_Axial_DIN0207_L6.3mm_D2.5mm_P10.16mm_Horizontal
R12 | 6.04k | Resistor_THT:R_Axial_DIN0207_L6.3mm_D2.5mm_P10.16mm_Horizontal
R13 | 10R | Resistor_THT:R_Axial_DIN0207_L6.3mm_D2.5mm_P10.16mm_Horizontal
R14 | 4.7k | Resistor_THT:R_Axial_DIN0207_L6.3mm_D2.5mm_P10.16mm_Horizontal
R15 | 15 | Resistor_THT:R_Axial_DIN0207_L6.3mm_D2.5mm_P10.16mm_Horizontal
R16 | 9.53k | Resistor_THT:R_Axial_DIN0207_L6.3mm_D2.5mm_P10.16mm_Horizontal
R17 | 2.49k | Resistor_THT:R_Axial_DIN0207_L6.3mm_D2.5mm_P10.16mm_Horizontal
R18 | 47.5k | Resistor_THT:R_Axial_DIN0207_L6.3mm_D2.5mm_P10.16mm_Horizontal
R19 | 2.74k | Resistor_THT:R_Axial_DIN0207_L6.3mm_D2.5mm_P10.16mm_Horizontal
RT1 | NTC 10R | Capacitor_THT:C_Disc_D9.0mm_W5.0mm_P7.50mm
RV1 | S14K275 | Varistor:RV_Disc_D12mm_W4.2mm_P7.5mm
T1 | EE30/15/7 Np42 Ns7 Na9 | fonte:Trafo_EE30_10pin
U1 | UC3845 | Package_DIP:DIP-8_W7.62mm
U2 | TL431 | Package_TO_SOT_THT:TO-92_Inline_Wide
U3 | PC817 | Package_DIP:DIP-4_W7.62mm
