mateusalgado/IFSC_ELP2/Tarefa_03_Projeto_Indutor_Alta_Frequencia/Inductor Design Tool for 64bit.xlsx

Sheet: Toroid Design
 |  |  | MPP | HF | Design #1 |  |  | Design #2
Inductor Requirements |  |  |  |  | Core Selection |  |  | Core Selection |  |  | STEP 1 |  |  | STEP 2 | STEP 3 |  | STEP 4
Inductance Required (mH) |  | 0.096 |  |  | Part Number | 55930 |  | Part Number | 77351 |  | Design Input |  |  | Calculated LI^2 value | Input a Part Number |  |  | Design Output
DC or AC RMS (Amps) |  | 8.33 |  |  | Number of Cores (Stack) | 1 |  | Number of Cores (Stack) | 1 |  |  |  |  | 7.34 |  | 55930 | Inductance at Full Load |  | 0.090 | mH
RMS Ripple Current (Amps) |  | 0.2404734411 |  |  | Material | MPP |  | Material | Kool Mu | DC Current |  | 8.33 | Amps
Pk-Pk Ripple Current (Amps) |  | 0.833 |  |  | Permeability | 125 |  | Permeability | 60 |  |  |  |  | Based on the LI^2 value choose a part number to fill in STEP 3. | Input a Wire Size
PK-Pk Frequency (kHz) |  | 100 |  |  | AL (nH/T2) +/- 8% | 157 |  | AL (nH/T2) +/- 8% | 51 | Ripple Current |  | 0.833 | Amps (peak to peak) |  |  |  | Inductance at No Load |  | 0.28 | mH
Specified Current (Amps) |  | 8.33 |  |  | Specified Current Inductance MIN(mH) | 0.0962 |  | Specified Current Inductance MIN(mH) | 195.3033 |  |  |  |  |  |  | 13
Add. Lead Length/ end (mm) |  |  |  |  | Max Current L MIN (mH) | 0.0897 |  | Max Current L MIN (mH) | 215.3218 |  |  |  |  |  |  | AWG
Ambient Temperature (°C) |  | 25 |  |  | Average Current Inductance MIN (mH) | 0.0962 |  | Average Current Inductance MIN (mH) | 195.3033 | Frequency |  | 100 | KHz |  |  |  | Specified Current Inductance |  | 0.10 | mH
Number of Cores |  | 1 |  |  | Min Current L MIN (mH) | 0.1032 |  | Min Current L MIN (mH) | 176.2613
 |  |  |  |  | No Load Inductance (mH) +/- 8% | 0.2769 |  | No Load Inductance (mH) +/- 8% | 0.0555 |  |  |  |  |  | Material
 |  |  |  |  | L +/- 8% if Max Current is low f AC | 0.0566 |  | L +/- 8% if Max Current is low f AC | 455.1243 | Full Load L |  | 0.096 | mH |  | MPP |  | Core Loss (W) |  | 0.03 | W
 | Design Criteria |  | Kool Mu | XFLUX | Leakage Inductance (uH) | 1.61 |  | Leakage Inductance (uH) | 0.80 |  |  |  |  |  | Core OD (mm)
LI2 (DC + Peak Ripple) |  | 7.34 |  |  | Core Loss (W) | 0.03 |  | Core Loss (W) | 0.03 |  |  |  |  |  | 27.69 |  | Copper Loss (W) |  | 1.05 | W
DC + AC Ripple Current |  | 8.7465 |  |  | Copper Loss (W) | 1.05 |  | Copper Loss (W) | #REF! | Stack Cores |  | 1 |  |  | Core ID (mm)
DC-AC Ripple Current |  | 7.9135 |  |  | Total Loss (W) | 1.08 |  | Total Loss (W) | #REF! |  |  |  |  |  | 14.1 |  | Total Loss |  | 1.08 | W
DC or fundamental AC rms Current |  | 8.33 |  |  | Approximate Fill Factor | 76.5% |  | Approximate Fill Factor | 737.5% | Specified Current |  | 8.33 | Amps |  | Core HT (mm)
Fundamental AC, peak Current |  | 12.20 |  |  | DCR (mΩ, 20° C) | 15.05 |  | DCR (mΩ) | -2.36 |  |  |  |  |  | 12 |  | Temp Rise |  | 14.9 | °C
Specified Current |  | 8.33 |  |  | Temp Rise (C°) | 14.9 |  | Temp Rise (C°) | #REF! | Temp Rise |  | 80 | °C |  | Core Perm
Wire size |  | 6 |  |  | Operating Temperature (C°) | 39.9 |  | Operating Temperature (C°) | #REF! |  |  |  |  |  | 125 |  | Number of Turns |  | 42
 |  |  |  |  | Number of Turns | 42 |  | Number of Turns | 33 |  |  |  |  |  | Core Al
 |  |  |  |  | Number of Layers | 3 |  | Number of Layers | 1 |  |  |  |  |  | 157
 |  |  |  |  | Wire Length (mm) | 2293.5 |  | Wire Length (mm) | -12969.0288 |  |  |  |  |  |  |  | Winding Factor |  | 76.5%
 |  |  |  |  |  |  |  |  |  | INSTRUCTIONS:
 |  |  |  |  |  |  |  |  |  | 1. Enter the input parameters in STEP 1. |  |  |  |  |  |  | DC Resistance of Winding |  | 15.05 | mΩ
 |  |  |  |  | Winding Selection |  |  | Winding Selection |  | - Full Load DC Current is the full load or peak bias current. Enter zero if there is no bias current.
 |  |  |  |  | Wire AWG | 13 |  | Wire AWG | 7 | - Full Load L is the inductance required with full load bias current plus ripple current.
 |  |  |  |  | # of Strands | 1 |  | # of Strands | 3 | - Specified Current is any RMS or bias current of interest. |  |  |  |  |  |  | Total Wire Length |  | 2293.48
 |  |  |  |  | Current Skin Depth (mm) | 0.21 |  | Skin Depth (mm) | 0.21 |  |  |  |  |  |  |  |  |  |  | mm
 |  |  |  |  | Bare Wire Radius (mm) | 0.9144 |  | Wire Radius (mm) | 1.8326 | 2. LI^2 value will be calculated in STEP 2.
 |  |  |  |  | Wire Area/ Strand (cm2) | 0.0284 |  | Wire Area/ Strand (cm2) | 0.111 |  |  |  |  |  |  |  | Finished OD |  | 40.2 | mm
 |  |  |  |  | Wire Area/ All Strands | 0.0284 |  | Wire Area/ All Strands | 0.333 | 3. Use calculated LI^2 value to select a part number from "Toroid LI^2 Chart" by different materials.
 |  |  |  |  | Circ Mills/strand | 5184 |  | Circ Mills/strand | 20820 |  |  |  |  |  |  |  | Finished HT |  | 24.6 | mm
 |  |  |  |  | Resistance (Ω/m) (@20 °C) all strands | 0.006563898727 |  | Resistance/m (20 °C) | 0.0005447846782 | 4. Enter a Part Number you selected into STEP 3 and press "Enter". Then enter a wire size by selecting from wire table and press "Enter".
 |  |  |  |  | Resistance (Ω/mm) (@20 °C) | 6.563898727e-06 |  | Resistance/mm (20 °C) | 5.447846782e-07 | Default strand is 1. |  |  |  |  |  |  | Adjust Turns |  | 42
 |  |  |  |  | MLT (mm) | 54.60668594 |  | MLT (mm) | -131.0002909 | 5. Adjust turns or strand if desired by entering new numbers in the input box in STEP 4, and press "Enter".
 |  |  |  |  | DCR (mΩ, @ 20° C) | 15.05 |  | DCR (mΩ, @ 20° C) | -2.36 |  |  |  |  |  |  |  | Adjust Strand |  | 1
 |  |  |  |  | ACR (mΩ, @ 20° C) | 37.64 |  |  |  | 6. To return to STEP 3, clear the "Adjust Turns" box, enter a new part number, and press "Enter".
 |  |  |  |  | Wound Surface Area (cm2) | 42.095 |  | Wound Surface Area (cm2) | 172.7785235
 |  |  |  |  | Adjust Turns | 42 |  | Adjust Turns | 33
 |  |  |  |  | AL (nH/T2) MIN | 144.44 |  | AL (nH/T2) MIN | 46.92
 |  |  |  |  | Window Area (cm2) | 1.56 |  | Window Area (cm2) | 1.49
 |  |  |  |  | Path Length (cm) | 6.35 |  | Path Length (cm) | 5.88
 |  |  |  |  | Volume (cm3) | 4.15 |  | Volume (cm3) | 2.28144
 |  |  |  |  | No Load Turns | 42 |  | No Load Turns | 33
 |  |  |  |  | % Initial Perm at AVG Current | 37.74% |  | % Initial Perm at AVG Current | 382229.07%
 |  |  |  |  | Adjusted Turns | 42 |  | Adjusted Turns | 33
 |  |  |  |  | % Initial Perm Adj. Turns AVG | 37.74% |  | % Initial Perm Adj. Turns AVG | 382229.07%
 |  |  |  |  | % Initial Perm Max Rip Current | 35.20% |  | % Initial Perm Max Rip Current | 421407.45%
 |  |  |  |  | % Initial Perm Min Rip Current | 40.49% |  | % Initial Perm Min Rip Current | 344961.84%
 |  |  |  |  | % Intial Perm MAX Current AC low f | 20.43% |  | % Intial Perm MAX Current AC low f | 819467.91%
 |  |  |  |  | % Intial Perm Spec. Current | 37.74% |  | % Intial Perm Spec. Current | 382229.07%
 |  |  |  |  | Core Loss |  |  | Core Loss
 |  |  |  |  | HAC MAX | 57.85086614 |  | HAC MAX | 49.0875
 |  |  |  |  | HAC MIN | 52.34125984 |  | HAC MIN | 44.4125
 |  |  |  |  | ABS HAC MIN | 52.34125984 |  | ABS HAC MIN | 44.4125
 |  |  |  |  | BAC MAX | 0.5591112076 |  | BAC MAX | 0.3512332137
 |  |  |  |  | BAC MIN | 0.5361514615 |  | BAC MIN | 0.3240828475
 |  |  |  |  | B Peak (DeltaB/2) | 0.0115 |  | B Peak (DeltaB/2) | 0.0136
 |  |  |  |  | Core Loss (mW/cm3) | 7.049458915 |  | Core Loss (mW/cm3) | 12.95317272
 |  |  |  |  | Core Info
 |  |  |  |  | OD MAX (mm) | 27.69 |  | OD MAX (mm) | 24.4
 |  |  |  |  | ID MIN (mm) | 14.1 |  | ID MIN (mm) | 13.7
 |  |  |  |  | Stacked HT MAX (mm) | 12 |  | HT MAX (mm) | 9.66
 |  |  |  |  | Window Area (mm2) | 156 |  | Window Area (mm2) | 149
 |  |  |  |  | Core Winding Circumference (mm) | 37.59 |  | Core Winding Circumference (mm) | 30.02
 |  |  |  |  | First Layer Circumference (mm) | 38.32247177 |  | First Layer Circumference (mm) | 22.58352102
 |  |  |  |  | Wire OD (mm) | 1.901578373 |  | Wire OD (mm) | 6.511441994
 |  |  |  |  | # of Turns possible on layer 1 | 20 |  | # of Turns possible on layer 1 | 3
 |  |  |  |  | Turns on Layer 1 | 20 |  | Turns on Layer 1 | 3
 |  |  |  |  | Turns on Layer 2 | 14 |  | Turns on Layer 2 | -3
 |  |  |  |  | Turns on Layer 3 | 8 |  | Turns on Layer 3 | -9
 |  |  |  |  | Turns on Layer 4 | 0 |  | Turns on Layer 4 | -15
 |  |  |  |  | Length per turn Layer 1 (mm) | 45.19631349 |  | Length per turn Layer 1 (mm) | 56.06576798
 |  |  |  |  | Length per turn Layer 2 | 58.37083491 |  | Length per turn Layer 2 | 101.1783614
 |  |  |  |  | Length per turn Layer 3 | 71.54535634 |  | Length per turn Layer 3 | 146.2909549
 |  |  |  |  | Length per turn Layer 4 | 84.71987776 |  | Length per turn Layer 4 | 191.4035483
 |  |  |  |  | Total wire length (mm) | 2293.480809 |  | Total wire length (mm) | -4323.009599
 |  |  |  |  | MLT (mm) | 54.60668594 |  | MLT (mm) | -131.0002909
 |  |  |  |  | Feet/Pound | 62.9 |  | Feet/Pound | 15.75
 |  |  |  |  | Pounds of Wire | 0.1196270801 |  | Pounds of Wire | -2.701543307
 |  |  |  |  | Surface Area |  |  | Surface Area
 |  |  |  |  | Base Part Number | 930 |  | Base Part Number | 350
 |  |  |  |  | Single Toroid Surface Area | 4209.5 |  | Single Toroid Surface Area | 17277.85235
 |  |  |  |  | Stacking Surface Area | 1575.445884 |  | Stacking Surface Area | 1156.25061
 |  |  |  |  | Core Ht for SA | 12 |  | Core Ht for SA | 9.66
 |  |  |  |  | Total Surface Area | 4209.5 |  | Total Surface Area | 17277.85235
 |  |  |  |  | Part Number | C055930A2 |  | Part Number | 0077351A7
 |  |  |  |  | Cross Section (cm2) | 0.654 |  | Cross Section (cm2) | 0.388
 |  |  |  |  | Equations |  |  | Equations
 |  |  |  |  | DC A | 0.01 |  | DC A | 0.01
 |  |  |  |  | DC B | 1.967112606e-06 |  | DC B | 5.193377436e-06
 |  |  |  |  | DC C | 2.253456962 |  | DC C | 1.748877226
 |  |  |  |  | DC D |  |  | DC D | 0
 |  |  |  |  | DC E |  |  | DC E | 0
 |  |  |  |  | NM A | 0.000642 |  | NM A | 0.0001658
 |  |  |  |  | NM B | -0.0006271 |  | NM B | 2.301e-05
 |  |  |  |  | NM C | 0.0003253 |  | NM C | 7.297e-05
 |  |  |  |  | NM D | 0.009901 |  | NM D | 0.005906
 |  |  |  |  | NM E | 0.0005366 |  | NM E | 6.053e-05
 |  |  |  |  | NM X | 0.5 |  | NM X | 0.5
 |  |  |  |  | CL A | 53.05 | 0 | CL A | 193
 |  |  |  |  | CL B | 2.06 | 0 | CL B | 2.01
 |  |  |  |  | CL C | 1.56 | 0 | CL C | 1.29
 |  |  |  |  | DC + AC Ripple Drive | 57.85086614 |  | DC + AC Ripple Drive | 49.0875
 |  |  |  |  | DC-AC Ripple Drive | 52.34125984 |  | DC-AC Ripple Drive | 44.4125
 |  |  |  |  | DC or low f AC RMS Drive Init | 55.09606299 |  | DC or low f AC RMS Drive Init | 46.75
 |  |  |  |  | If low f AC Drive | 80.67240267 |  | If low f AC Drive | 68.45198404
 |  |  |  |  | DC or low f AC RMS Drive 2nd | 55.09606299 |  | DC or low f AC RMS Drive 2nd | 46.75
 |  |  |  |  | Specified Current Drive | 55.09606299 |  | Specified Current Drive | 46.75
 |  |  |  |  | Finished OD(mm) | 40.24041726
 |  |  |  |  | Finished HT(mm) | 24.55041726

Sheet: E Core Design
Select your Inductor Type |  | DC w/ ripple | Kool Mu E | Xflux E | Design #1
Inductor Requirements |  |  |  |  | Core Selection |  |  | STEP 1 |  |  | STEP 2 |  | STEP 3 |  | STEP 4
Inductance Required (mH) |  | 1 |  |  | Part Number | 00K3515E026 |  | Design Input |  |  | Calculated LI^2 value |  | Input a Part Number
DC Amps |  | 1 |  |  | Number of Cores (Stack-per set) | 1 |  |  |  |  |  |  |  | 00K3515E026 | Inductance at Full Load | 0.108 | mH
RMS Ripple Current (Amps) |  | 0.2886836028 |  |  | Material | Kool Mu |  |  |  |  |  | 2.25
Pk-Pk Ripple Current (Amps) |  | 1 |  |  | Permeability | 26 | DC Current |  | 1 | Amps |  |  | Input a Wire Size
Specified Current |  | 1 |  |  | AL (nH/T2) +/- 8% | 56 |  |  |  |  | Based on the LI^2 value choose a part number to fill in STEP 3. |  |  |  | Inductance at No Load | 0.12 | mH
PK-Pk Frequency (kHz) |  | 1 |  |  | Specified Current Inductance MIN(mH) | 0.1087 | Ripple Current |  | 1 | Amps (peak to peak) |  |  |  | 25
Add. Lead Length/ end (mm) |  |  |  |  | Max Current L MIN (mH) | 0.1085 |  |  |  |  |  |  |  | AWG
Ambient Temperature(°C) |  | 25 |  |  | Average Current Inductance MIN (mH) | 0.1087 |  |  |  |  |  |  | Material |  | Specified Current Inductance | 0.11 | mH
Type of Wire |  | copper |  |  | Min Current L MIN (mH) | 0.1089 | Frequency |  | 1 | KHz |  |  | Kool Mu
Number of cores |  | 1 |  |  | No Load Inductance (mH) +/- 8% | 0.118496 |  |  |  |  |  |  | Core A Dimension (mm)
 |  |  |  |  | L +/- 8% if Max Current is low f AC | #VALUE! |  |  |  |  |  |  | 34.54 |  | Core Loss (W) | 5.522742024e-05 | W
 |  |  |  |  | Core Loss (W) | 5.522742024e-05 | Full Load L |  | 1 | mH |  |  | Core B Dimension (mm)
 |  |  |  |  | Copper Loss (W) | 0.04 |  |  |  |  |  |  | 14.2 |  | Copper Loss (W) | 0.04 | W
 |  |  |  |  | Total Loss (W) | 0.04 |  |  |  |  |  |  | Core C Dimension (mm)
 |  |  |  |  | Approximate Fill Factor | 87.3% | Stack Cores |  | 1 |  |  |  | 9.35 |  | Total Loss | 0.04 | W
 |  |  |  |  | DCR(mΩ, 20° C) | 36.2298 |  |  |  |  |  |  | Core Perm
 |  |  |  |  | Temp Rise (C°) | 1.3 | Specified Current |  | 1 | Amps |  |  | 26 |  | Temp Rise | 1.3 | °C
 |  |  |  |  | Operating Temperature (C°) | 26.3 |  |  |  |  |  |  | Core Al
Wire Size |  |  |  |  | Number of Turns | 46 | Temp Rise |  | 1 | °C |  |  | 56 |  | Number of Turns | 46
 |  |  |  |  | Number of Layers Possible | 11
 |  |  |  |  | Layers Needed | 6 |  |  |  |  |  |  |  |  | Winding Factor | 87.3%
 |  |  |  |  | Wire Length (mm) | 27632.3
 |  |  |  |  | Wire Cost |  |  |  |  |  |  |  |  |  | DC Resistance of Winding | 36.23 | mΩ
 |  |  |  |  | Per Core Cost |  | INSTRUCTIONS:
 |  |  |  |  | Total Cost |  | 1. Enter the input parameters in STEP 1.
 |  |  |  |  |  |  | - Full Load DC Current is the full load or peak bias current. Enter zero if there is no bias current. |  |  |  |  |  |  |  | Total Wire Length | 27632.30
 |  |  |  |  |  |  | - Full Load L is the inductance required with full load bias current plus ripple current. |  |  |  |  |  |  |  |  |  | mm
Design Criteria |  |  |  |  | Winding Selection |  | - Specified Current is any RMS or bias current of interest.
LI2 (Peak Current) |  | 2.25 |  |  | Wire AWG | 25 |  |  |  |  |  |  |  |  | Finished A | 34.5 | mm
DC + AC Ripple Current |  | 1.5 |  |  | # of Strands | 9 | 2. LI^2 value will be calculated in STEP 2.
DC - AC Ripple Current |  | 0.5 |  |  | Current Skin Depth(mm) | 2.096590089 |  |  |  |  |  |  |  |  | Finished HT | 29.3 | mm
DC or fundamental AC rms Current |  | 1 |  |  | Bare Wire Radius (mm) | 0.2273 | 3. Use calculated LI^2 value to select a part number from "E Core LI^2 Chart" by Kool Mu material. A smaller size Xflux core may work vs. Kool
Fundamental AC, peak Current |  |  |  |  | Wire Area/ Strand (cm2) | 0.002 | Mu core. |  |  |  |  |  |  |  | Adjust Turns | 46
Specified Current |  | 1 |  |  | Wire Area/ All Strands | 0.018 | 4. Select a Part Number you STEP 3 and press "Enter". Then enter a wire size by selecting from wire table and press "Enter".
 |  |  |  |  | Circ Mils/ All Strands | 320.4 | Default strand is 1. |  |  |  |  |  |  |  | Adjust Wire Strand | 9
 |  |  |  |  | Resistivity(Ω-Circ Mills/FT) | 10.371 | 5. Adjust turns or strand if desired by entering new numbers in the input box in STEP 4, and press "Enter".
 |  |  |  |  | Resistance (Ω/m) (@20 °C) all strands | 0.01180026737
 |  |  |  |  | Resistance/mm | 1.180026737e-05 | 6. To return to STEP 3, clear the "Adjust Turns" box, enter a new part number, and press "Enter".
 |  |  |  |  | MLT (mm) | 66.74469296
 |  |  |  |  | DCR (mΩ, @ 20° C) | 36.23
 |  |  |  |  | ACR (mΩ, @ 20° C) | 90.57
 |  |  |  |  | Wound Surface Area (cm2) | 31.3885
 | Leave Blank When starting new design -------------------> |  |  |  | Adjust Turns | 46
 |  |  |  |  | AL (nH/T2) MIN | 51.52
 |  |  |  |  | Bobbin Window Area(cm2) | 0.948
 |  |  |  |  | Path Length (cm) | 6.94
 |  |  |  |  | Volume (cm3) | 5.8296
 |  |  |  |  | Cross Section (cm2) | 0.84
 |  |  |  |  | No Load Turns | 46
 |  |  |  |  | % Initial Perm at AVG Current | 99.75%
 |  |  |  |  | Adjusted Turns | 46
 |  |  |  |  | % Initial Perm Adj. Turns AVG | 99.75%
 |  |  |  |  | % Initial Perm Max Rip Current | 99.48%
 |  |  |  |  | % Initial Perm Min Rip Current | 99.93%
 |  |  |  |  | % Intial Perm MAX Current AC low f | #VALUE!
 |  |  |  |  | % Intial Perm Spec. Current | 99.75%
 |  |  |  |  | Core Loss
 |  |  |  |  | HAC MAX | 9.942363112
 |  |  |  |  | HAC MIN | 3.314121037
 |  |  |  |  | BAC MAX | 0.04342233012
 |  |  |  |  | BAC MIN | 0.02164361417
 |  |  |  |  | B Peak (DeltaB/2) | 0.0109
 |  |  |  |  | Core Loss (mW/cm3) | 0.009473620872
 |  |  |  |  | Core Info
 |  |  |  |  | A (mm) | 34.54
 |  |  |  |  | B (mm) | 14.2
 |  |  |  |  | C (mm) | 9.35
 |  |  |  |  | D (mm) | 9.6
 |  |  |  |  | E (mm) | 25.2
 |  |  |  |  | F (mm) | 9.32
 |  |  |  |  | L (mm) | 4.45
 |  |  |  |  | M (mm) | 7.87
 |  |  |  |  | Bobbin Thickness (mm) | 0.89
 |  |  |  |  | C +F+4Bob | 22.23
 |  |  |  |  | Bobbin Width (mm) | 16.59
 |  |  |  |  | Wire OD (mm) | 1.513879513
 |  |  |  |  | # of Turns possible per layer | 9
 |  |  |  |  | Turns on Layer 1 | 9
 |  |  |  |  | Turns on Layer 2 | 9
 |  |  |  |  | Turns on Layer 3 | 9
 |  |  |  |  | Turns on Layer 4 | 9
 |  |  |  |  | Turns on Layer 5 | 9
 |  |  |  |  | Turns on Layer 6 | 1
 |  |  |  |  | Turns on Layer 7 | 0
 |  |  |  |  | Turns on Layer 8 | 0
 |  |  |  |  | Turns on Layer 9 | 0
 |  |  |  |  | Length per turn Layer 1 (mm) | 49.21358167
 |  |  |  |  | Length per turn Layer 2 (mm) | 58.72074501
 |  |  |  |  | Length per turn Layer 3 | 68.22790836
 |  |  |  |  | Length per turn Layer 4 | 77.7350717
 |  |  |  |  | Length per turn Layer 5 | 87.24223504
 |  |  |  |  | Total wire length (mm) | 3070.255876
 |  |  |  |  | MLT (mm) | 66.74469296
 |  |  |  |  | Feet/Pound | #N/A
 |  |  |  |  | Pounds of Wire | #N/A
 |  |  |  |  | Wire Price Per Pound | #N/A
 |  |  |  |  | Kgs of Wire | #N/A
 |  |  |  |  | Equations
 |  |  |  |  | DC A | 0.01
 |  |  |  |  | DC B | 7.993291791e-07
 |  |  |  |  | DC C | 1.818949624
 |  |  |  |  | DC D
 |  |  |  |  | DC E
 |  |  |  |  | NM A | 5.868e-05
 |  |  |  |  | NM B | 9.362e-05
 |  |  |  |  | NM C | 9.011e-06
 |  |  |  |  | NM D | -0.0003682
 |  |  |  |  | NM E | 8.747e-06
 |  |  |  |  | NM X | 0.5
 |  |  |  |  | CL A | 120
 |  |  |  |  | CL B | 2.09
 |  |  |  |  | CL C | 1.46
 |  |  |  |  | DC + AC Ripple Drive | 9.942363112
 |  |  |  |  | DC-AC Ripple Drive | 3.314121037
 |  |  |  |  | DC or low f AC RMS Drive Init | 6.628242075
 |  |  |  |  | If low f AC Drive | #VALUE!
 |  |  |  |  | DC or low f AC RMS Drive 2nd | 6.628242075
 |  |  |  |  | Specified Current Drive | 6.628242075
 |  |  |  |  | Finished A(mm) | 34.540
 |  |  |  |  | Finished W (mm) | 28.400
 |  |  |  |  | Finished HT (mm) | 29.333
 |  |  |  |  | Single Core Weight(KG) | 0.016
 |  |  |  |  | Total Core Weight(KG) | 0.031
 |  |  |  |  | Finished Weight(kG) | #N/A
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
