mateusalgado/IFSC_ELP2/Projeto_Flyback/revisoes/RevA_2026-10-19/04_KiCad/VERIFICACAO_LAYOUT.md

# Verificação do layout da PCI contra a Aula 08 (Técnicas de layout de PCI com DFM) e IPC-2221

Placa: `fonte_flyback_12V3A.kicad_pcb` — 140 × 90 mm, dupla face, FR-4 1,6 mm, cobre 35 µm, furos metalizados, 69 footprints (todos PTH), 34 redes.
Resultado final do DRC (`kicad-cli pcb drc --severity-all --schematic-parity`): **0 erros, 0 itens não conectados, 0 divergências com o esquemático**; 4 avisos de serigrafia (2 do opto U3, cujo corpo cruza a fenda de isolação de propósito; 1 marca "K" do D3 sobre pad do R8; 1 círculo da serigrafia do L1 sobre o próprio pad).

| # | Item da Aula 08 | Como foi atendido nesta placa | Evidência |
|---|---|---|---|
| 1 | Planejamento: área, inserção PTH viável, face dupla, furo metalizado, fixação | 140 × 90 mm, todos os componentes PTH (montagem manual), 2 camadas, 4 furos M3 nos cantos (H1–H4); dissipadores clip previstos no MOSFET (Q1) e no diodo de saída (D1); conectores a parafuso J1 (rede) e J2 (saída) nas bordas opostas | `placement.py`, render 3D |
| 2 | Disposição: começar pelos maiores; componentes quentes afastados | Transformador no centro (sobre a fenda), bulk C1 e choke L1 posicionados primeiro; Q1 (dissipador) a 14,5 mm da ponte BR1 e a 25 mm dos resistores de 2 W do snubber; D1 (dissipador) no lado oposto da placa | `placement.py` regiões A–F |
| 3 | Fluxo de potência linear (entrada num lado, saída no outro) | Rede entra pela esquerda (J1 → F1 → RV1/RT1 → CX1/L1/CX2 → BR1 → C1 → Q1/T1) e a saída sai pela direita (T1 → D1 → C10–C12 → L2/C13 → J2) | imagem `imagens/pcb_completa.svg` |
| 4 | Agrupar por função; trilhas de cada grupo na sua área | Regiões: entrada/EMI (A), potência primária (B), controle UC3845 (C), auxiliar/opto/Y (D), secundário (E), realimentação TL431 (F). O roteador só permite redes do secundário à direita da barreira (x ≥ 86,5 mm) e redes do primário à esquerda (x ≤ 81,5 mm) | `router.py` (`PRIM_XMAX`, `SEC_XMIN`) |
| 5 | Magnéticos de alta frequência afastados entre si | L1 (choke de modo comum, 50/60 Hz + MC) a 70 mm de T1; L2 (pós-filtro) a 30 mm de T1 e fora do eixo do entreferro | `placement.py` |
| 6 | Sensores de corrente/tensão longe de magnéticos; analógicos junto ao CI | Rsense (R9/R10) a 38 mm de T1; RT/CT (R12, C4), filtro do CS (R11, C3), VREF (C7), compensação (C8) e 100 nF (C6) ao redor do UC3845 (U1) | `placement.py` região C |
| 7 | **Evitar trilhas a 90°** (chaveados) | Roteador substitui cada canto reto por dois cantos de 45° (função `chamfer`) quando a diagonal respeita o isolamento. Resultado: 222 cantos a 45°; dos 17 ângulos retos restantes, 15 são saídas de duas trilhas de um mesmo pad (não são dobras de trilha) e 2 são dobras onde a diagonal violaria o isolamento | `router.py`, script de contagem no relatório |
| 8 | Trilhas comutadas o mais curtas possível | Laço MOSFET–trafo–Rsense: Q1 a 11 mm do pino 3 de T1 e 10 mm do R9; laço secundário D1–T1–C10 com trilha de 2,0 mm; snubber D2/C2/R3/R4 junto ao pino do primário | `router.py` larguras e `route_zone_loops` |
| 9 | Largura e distância conforme corrente e tensão (IPC-2221) | Classes de rede no `.kicad_pro` + regras `.kicad_dru`: HV (até 507 V no dreno) isolamento ≥ 1,0 mm (IPC-2221 B4: 0,8 mm para 301–500 V com máscara) e largura ≥ 1,0 mm; secundário de potência (Is,rms = 5,45 A) largura 2,0 mm (IPC-2221 externa 35 µm, ΔT 10 °C: ≥ 1,6 mm); bulk 1,5 mm (Irms ≈ 1 A); sinais 0,5 mm; borda 0,5 mm | `fonte_flyback_12V3A.kicad_dru`, DRC |
| 10 | Isolação primário/secundário (norma do produto) | ≥ 6,0 mm entre qualquer item do secundário e do primário (regra `isolacao_prim_sec`, verificada pelo DRC), duas fendas de 1,2 mm sob o transformador e sob o opto; capacitor Y1 com passo 10 mm (8 mm entre pads); opto PC817 (7,62 mm entre fileiras) sobre fenda | DRC, `gera_pcb.py` `slot()` |
| 11 | Separar GND de sinal do GND de potência, uma única ligação, sem laço | Plano PGND de potência (face inferior, y < 60 mm) e **ilha** PGND de sinal (y > 61 mm, sob o UC3845, opto e auxiliares) são zonas separadas, unidas por **uma única trilha-estrela** de 1,5 mm no lado frio do Rsense (R10.2). O roteador proíbe trilhas longas na face inferior dentro da ilha e verifica por flood-fill que a ilha ficou contínua ("ilha de terra de sinal contínua: sim") | `gera_pcb.py` zonas, `router.py` `ilha_continua()` |
| 12 | Driver junto ao transistor; PWM em trilhas paralelas e próximas | O UC3845 comanda o MOSFET diretamente (driver interno 1 A); Rg (R7), diodo de descarga (D3) e R gate-source (R8) ficam junto ao gate de Q1; a trilha DRV (31 mm) corre sobre a ilha de terra e é roteada antes das demais para ficar inteira na face superior | `router.py` ORDER |
| 13 | Sinais de medida paralelos e próximos da referência, longe de magnéticos/capacitores chaveados | CS: Rsense → R11/C3 → pino 3 sobre a ilha de terra contínua (retorno imediatamente abaixo); realimentação (TL431/opto) na região F, oposta ao transformador, com o plano SGND por baixo (datasheet UC3845 §8.4.1.1) | layout |
| 14 | 100 nF entre VCC e GND o mais próximo possível do CI | C6 (100 nF) a 4,3 mm do pino 7 (VCC) do U1, com retorno pela ilha de terra; C5 (220 µF) ao lado | `placement.py` |
| 15 | Observar a seção "Layout" do datasheet do CI | UC3845 (TI SLUS223H §8.4): realimentação longe do indutor e sobre plano de terra (✔ região F), bypass junto ao VCC (✔ C6), compensação junto ao CI (✔ C8, R14), trilhas de potência curtas e largas ≥ 0,381 mm/A (✔ 2,0 mm para 5,45 A rms), terras ligados ao plano (✔) | datasheet |
| 16 | Priorizar correntes de modo diferencial; filtro de modo comum | Filtro de EMI CX1–L1(MC)–CX2 na entrada e CY1 entre PGND e SGND para fechar o caminho de modo comum; trilhas de ida e volta do secundário lado a lado | esquemático |
| 17 | Malha de referência (plano de terra) | Planos PGND e SGND na face inferior (preenchimento com `connect_pads yes` para baixa impedância nas trilhas de potência; relevo térmico nos demais) | `gera_pcb.py` |
| 18 | Pontos de medida de corrente e tensão em protótipos | 11 pontos de teste PTH: TP1 BULK, TP2 DRAIN, TP3 SW (Rsense), TP4 GATE, TP5 VCC, TP6 VREF, TP7 COMP, TP8 CS, TP9 PGND, TP10 VO, TP11 SGND; corrente do primário e do secundário medidas no Rsense e com laço de fio nos pinos do trafo (guia de montagem) | esquemático |
| 19 | DFM: espaçamento entre terminais (2,5 mm), serigrafia entre terminais, ladrões de solda | Todos PTH com solda manual (não há solda por onda nem SMD: ladrões de solda não se aplicam). Menor distância borda-borda entre pads de componentes diferentes: 0,95 mm (U1–C8, sinal), 31 pares abaixo de 2,5 mm — todos ≥ 0,95 mm e acima do isolamento IPC; referências de serigrafia posicionadas automaticamente fora dos cortejos (0 sobreposições de referência no DRC) | script no relatório |
| 20 | Prever dissipador, fixação e inserção | Q1 e D1 em TO-220 vertical com clip Aavid 574502B00000G; furos M3; componentes altos (C1, T1, L1) afastados das bordas | render 3D |

Fluxo de geração (reprodutível): `gera_sch.py` → `kicad-cli sch erc / export netlist` → `fp_info.py` → `placement.py` (verifica sobreposição de cortejos) → `router.py` (roteia, chanfra a 45°, verifica ilha) → `gera_pcb.py` (pcbnew) → `kicad-cli pcb drc --refill-zones --schematic-parity` → `kicad-cli pcb export gerbers/drill/svg/pdf` e `pcb render`.
