mateusalgado/IFSC_ELP2/Projeto_Flyback/04_KiCad/fonte_flyback_12V3A_esquematico.pdf

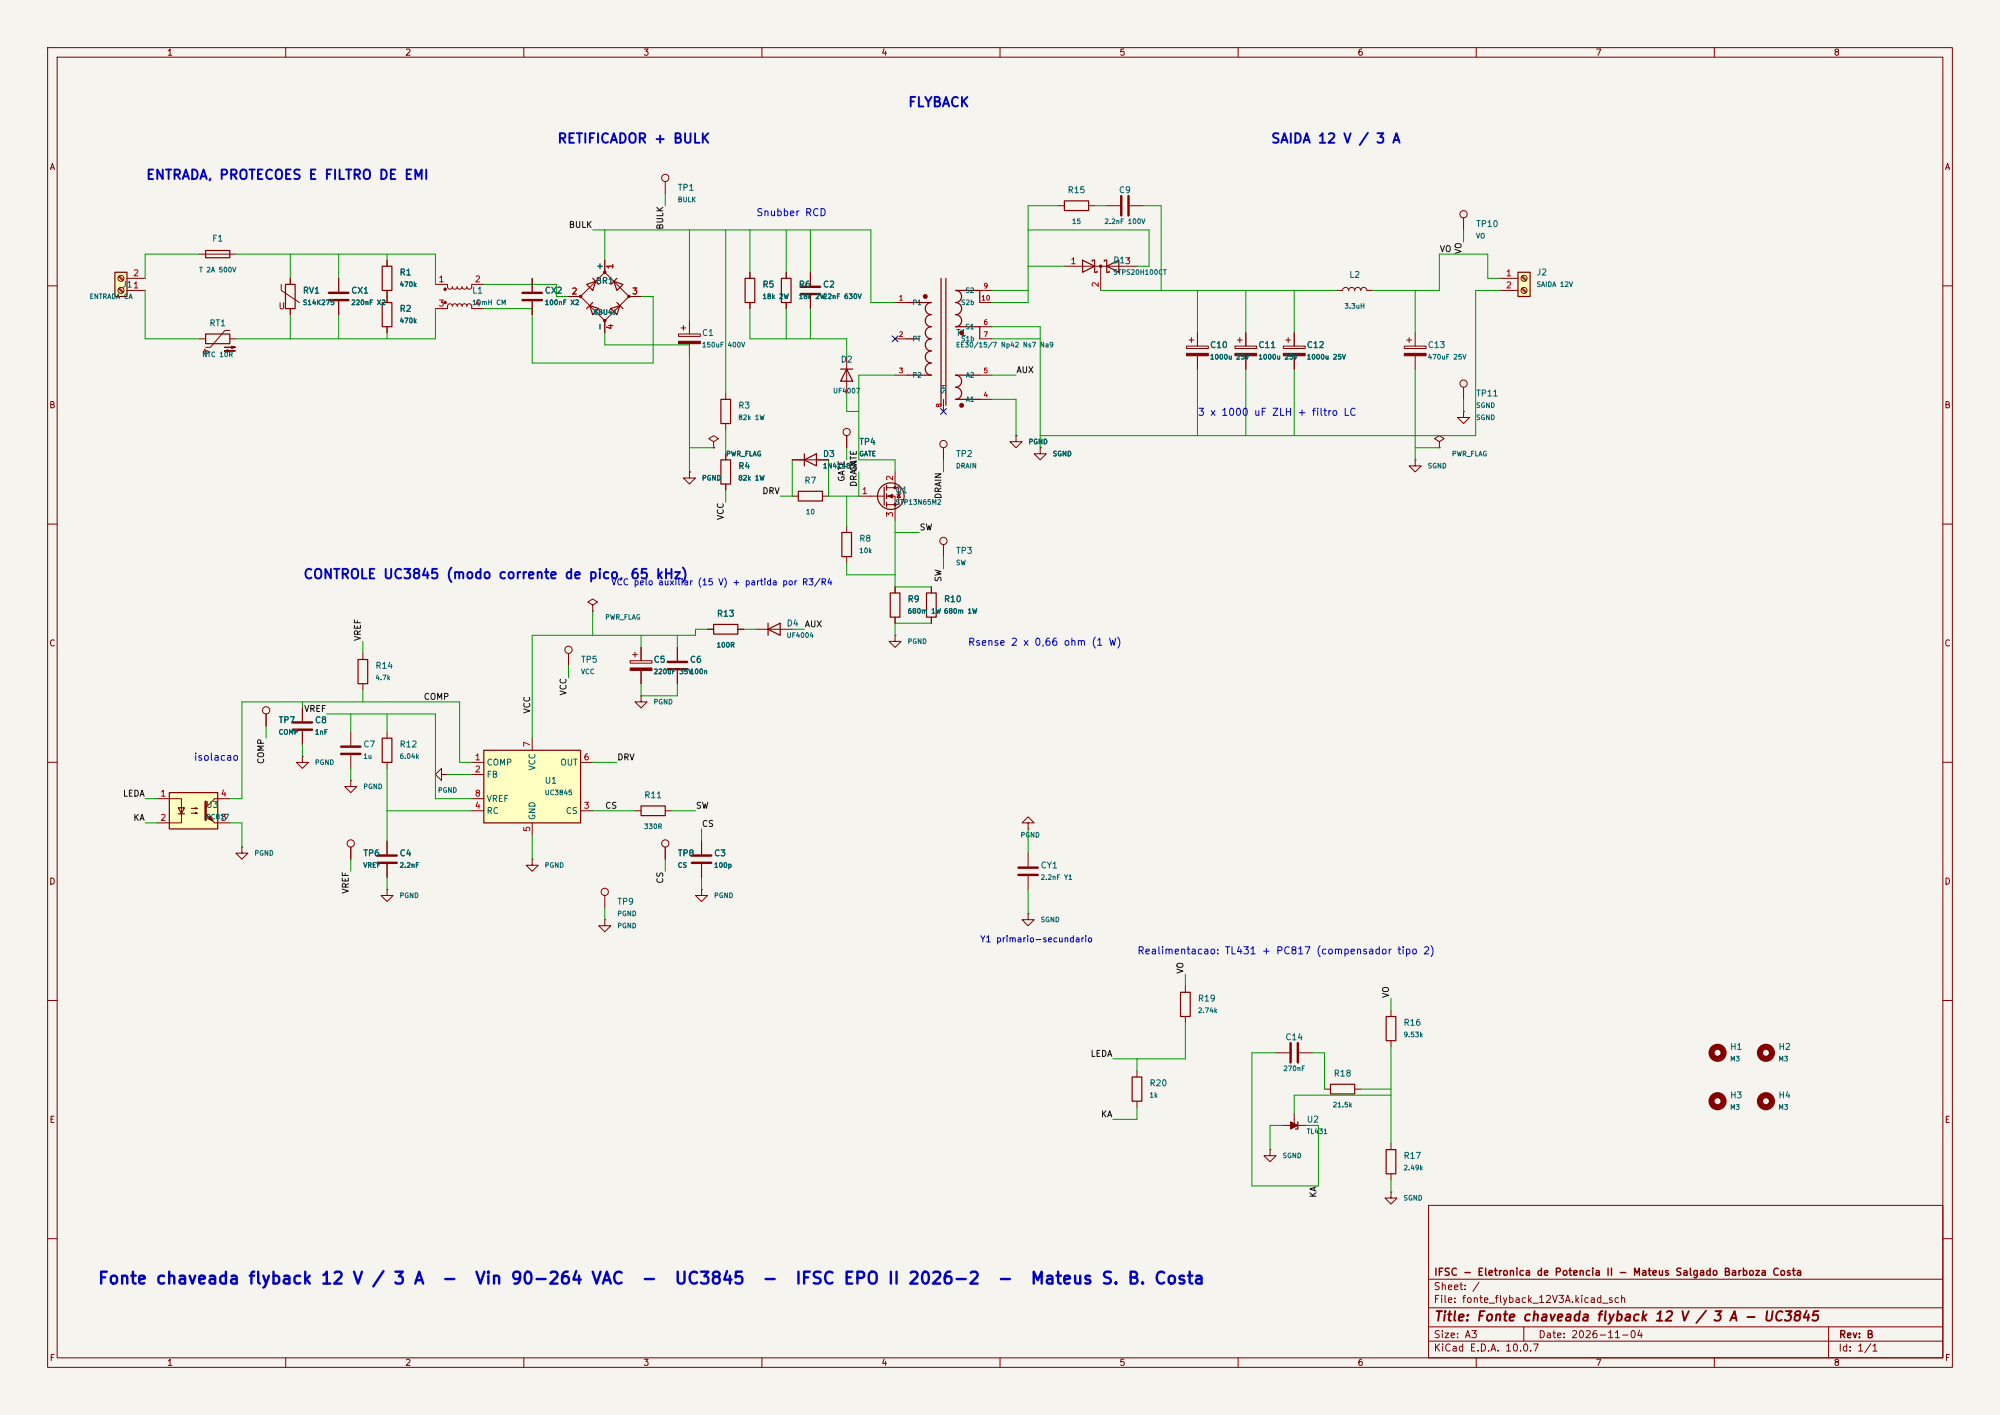
[picture p295: page 1]

ENTRADA, PROTECOES E FILTRO DE EMI

CONTROLE UC3845 (modo corrente de pico, 65 kHz)

VCC pelo auxiliar (15 V) + partida por R3/R4

Fonte chaveada flyback 12 V / 3 A - Vin 90-264 VAC - UC3845 - IFSC EPO II 2026-2 - Mateus S. B. Costa

IFSC - Eletronica de Potencia II - Mateus Salgado Barboza Costa
Sheet: /
File: fonte_flyback_12V3A.kicad_sch
Title: Fonte chaveada flyback 12 V / 3 A - UC3845

Size: A3 | Rev: B | F Date: 2026-11-04
KiCad E.D.A. 10.0.7 | Id: 1/1
