mateusalgado/IFSC_ELP2/Projeto_Flyback/04_KiCad/imagens/pcb_camadas.pdf

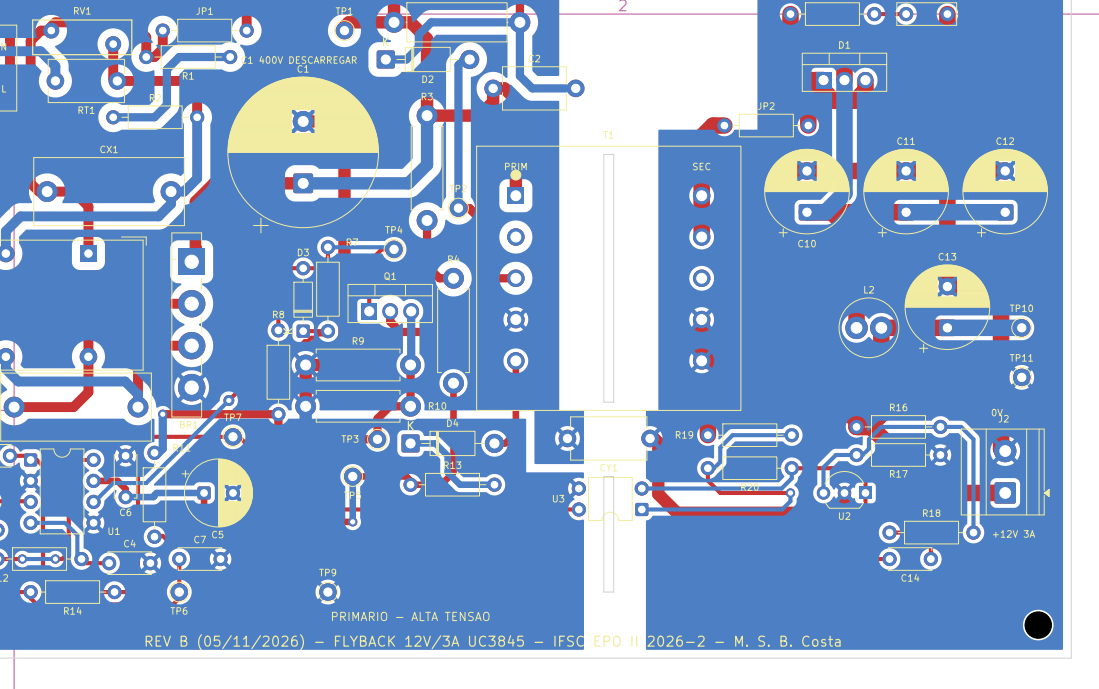
[picture p296: page 1]

SECUNDARIO 12V REV B (05/11/2026) - FLYBACK 12V/3A UC3845 - IFSC EPO II 2026-2 - M. S. B. Costa

Size: A4 | Rev: B
KiCad E.D.A. 10.0.7 | Id: 1/1
