mateusalgado/IFSC_ELP2/Projeto_Flyback/revisoes/RevA_2026-10-19/04_KiCad/imagens/pcb_camadas.pdf

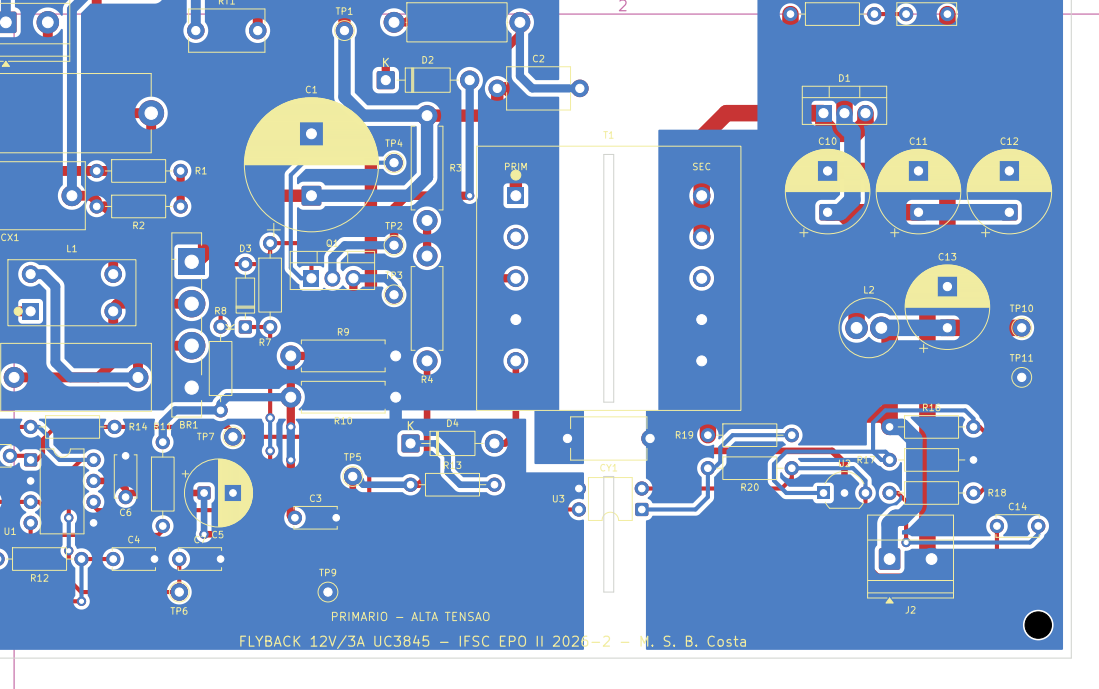
[picture p297: page 1]

SECUNDARIO 12V FLYBACK 12V/3A UC3845 - IFSC EPO II 2026-2 - M. S. B. Costa

Size: A4 | Rev:
KiCad E.D.A. 10.0.7 | Id: 1/1
