mateusalgado/IFSC_ELP2/Tarefa_01_Calculo_Termico_Dissipador/RELATORIO_MATEUS_SALGADO_TAREFA1.pdf

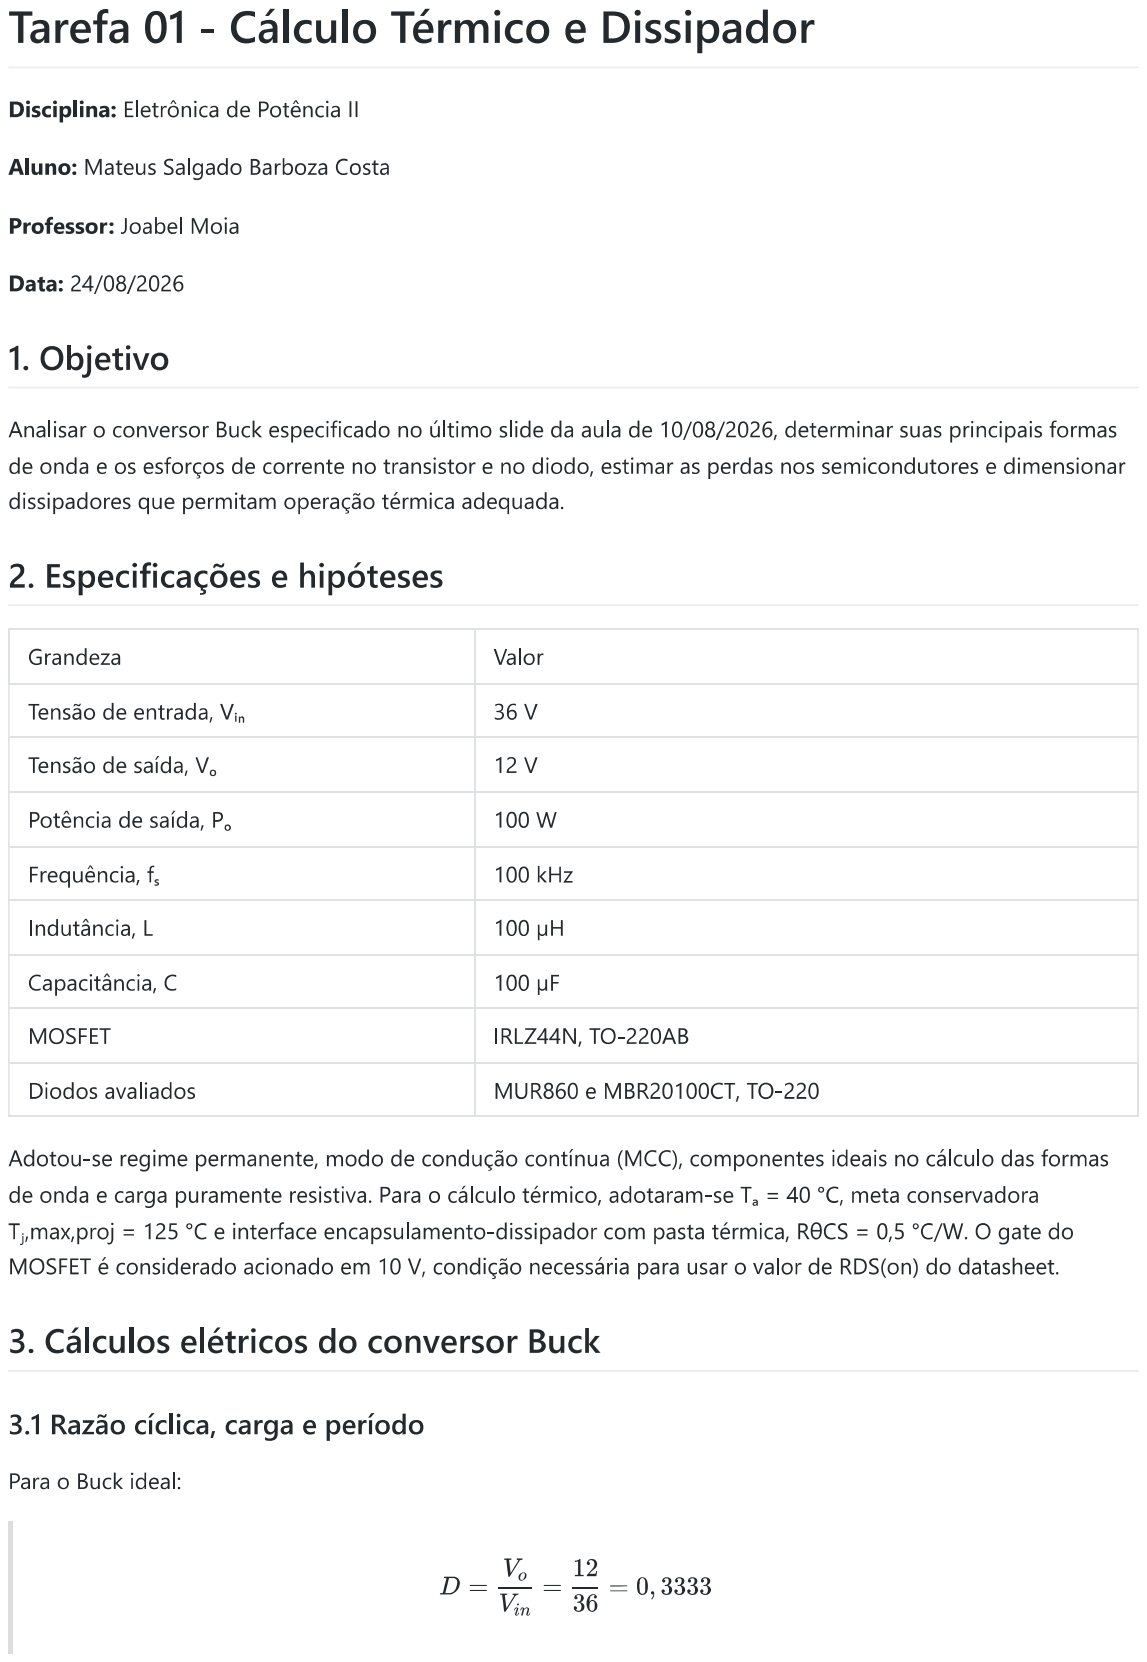
[picture p298: page 1]

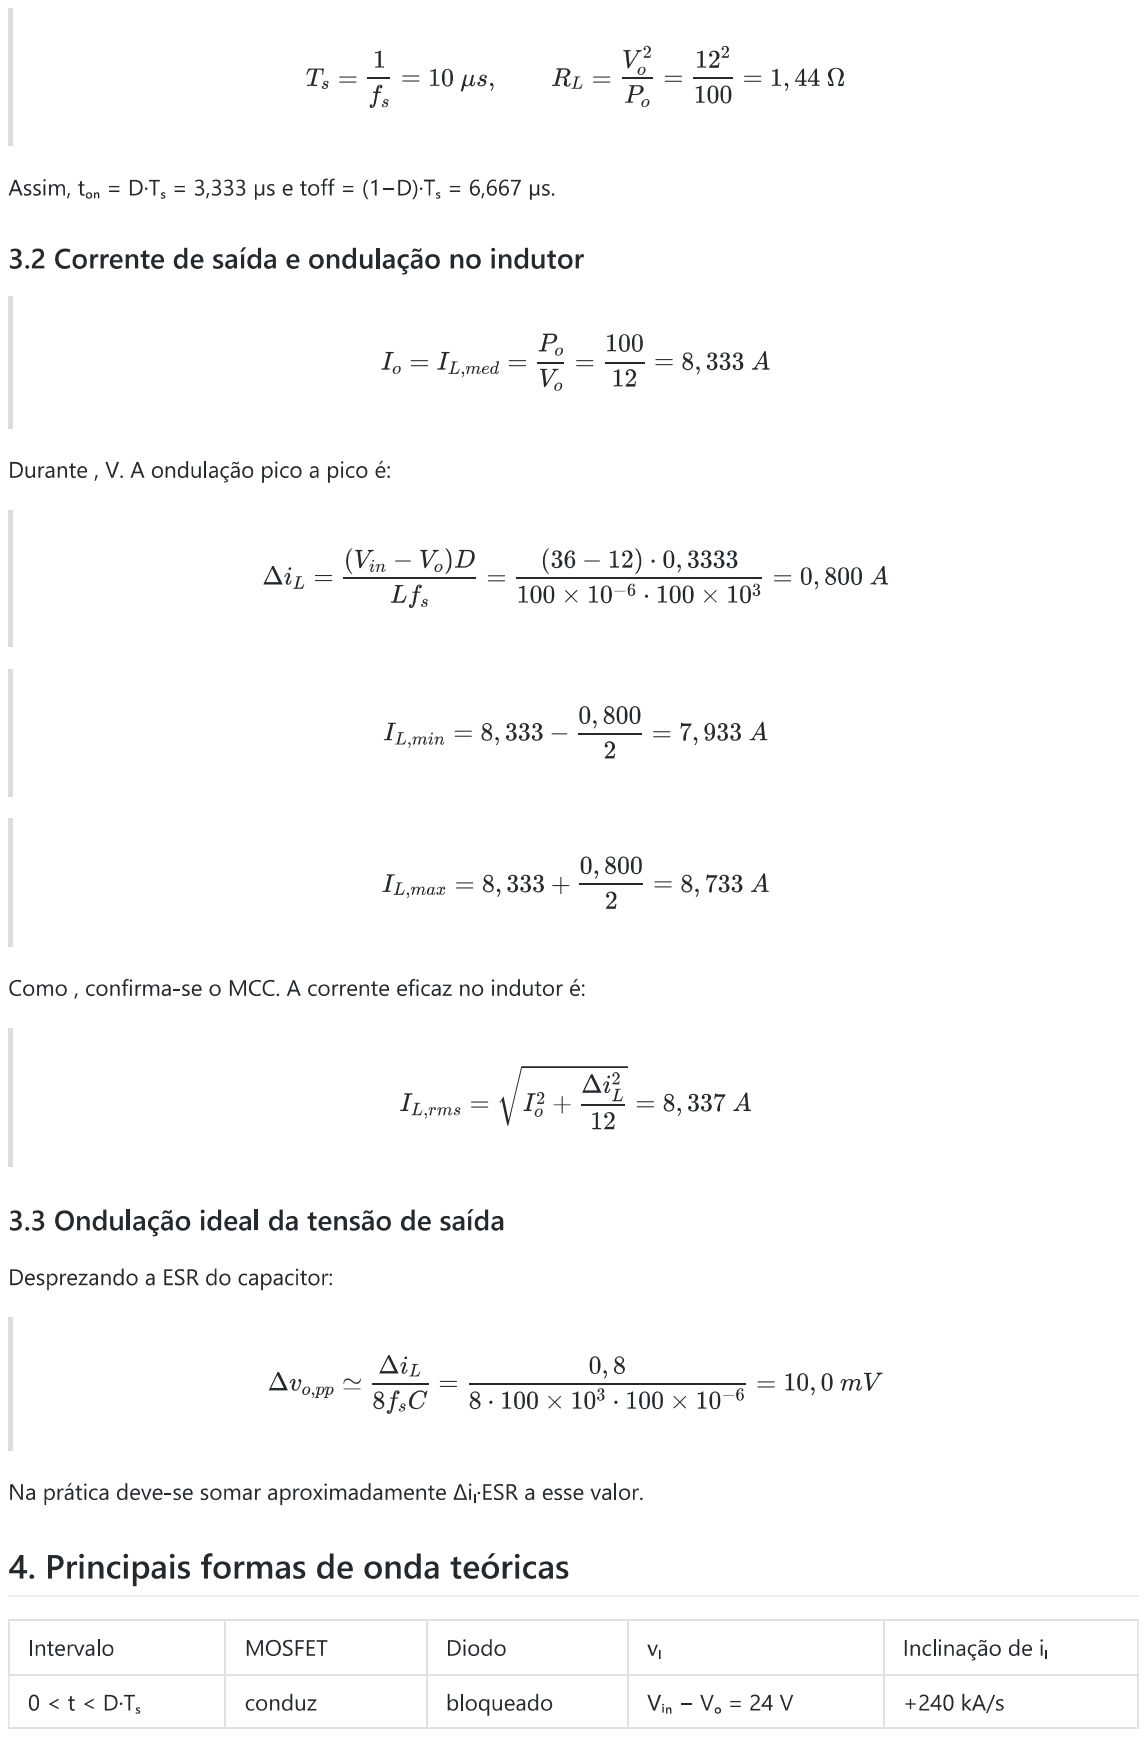
[picture p299: page 2]

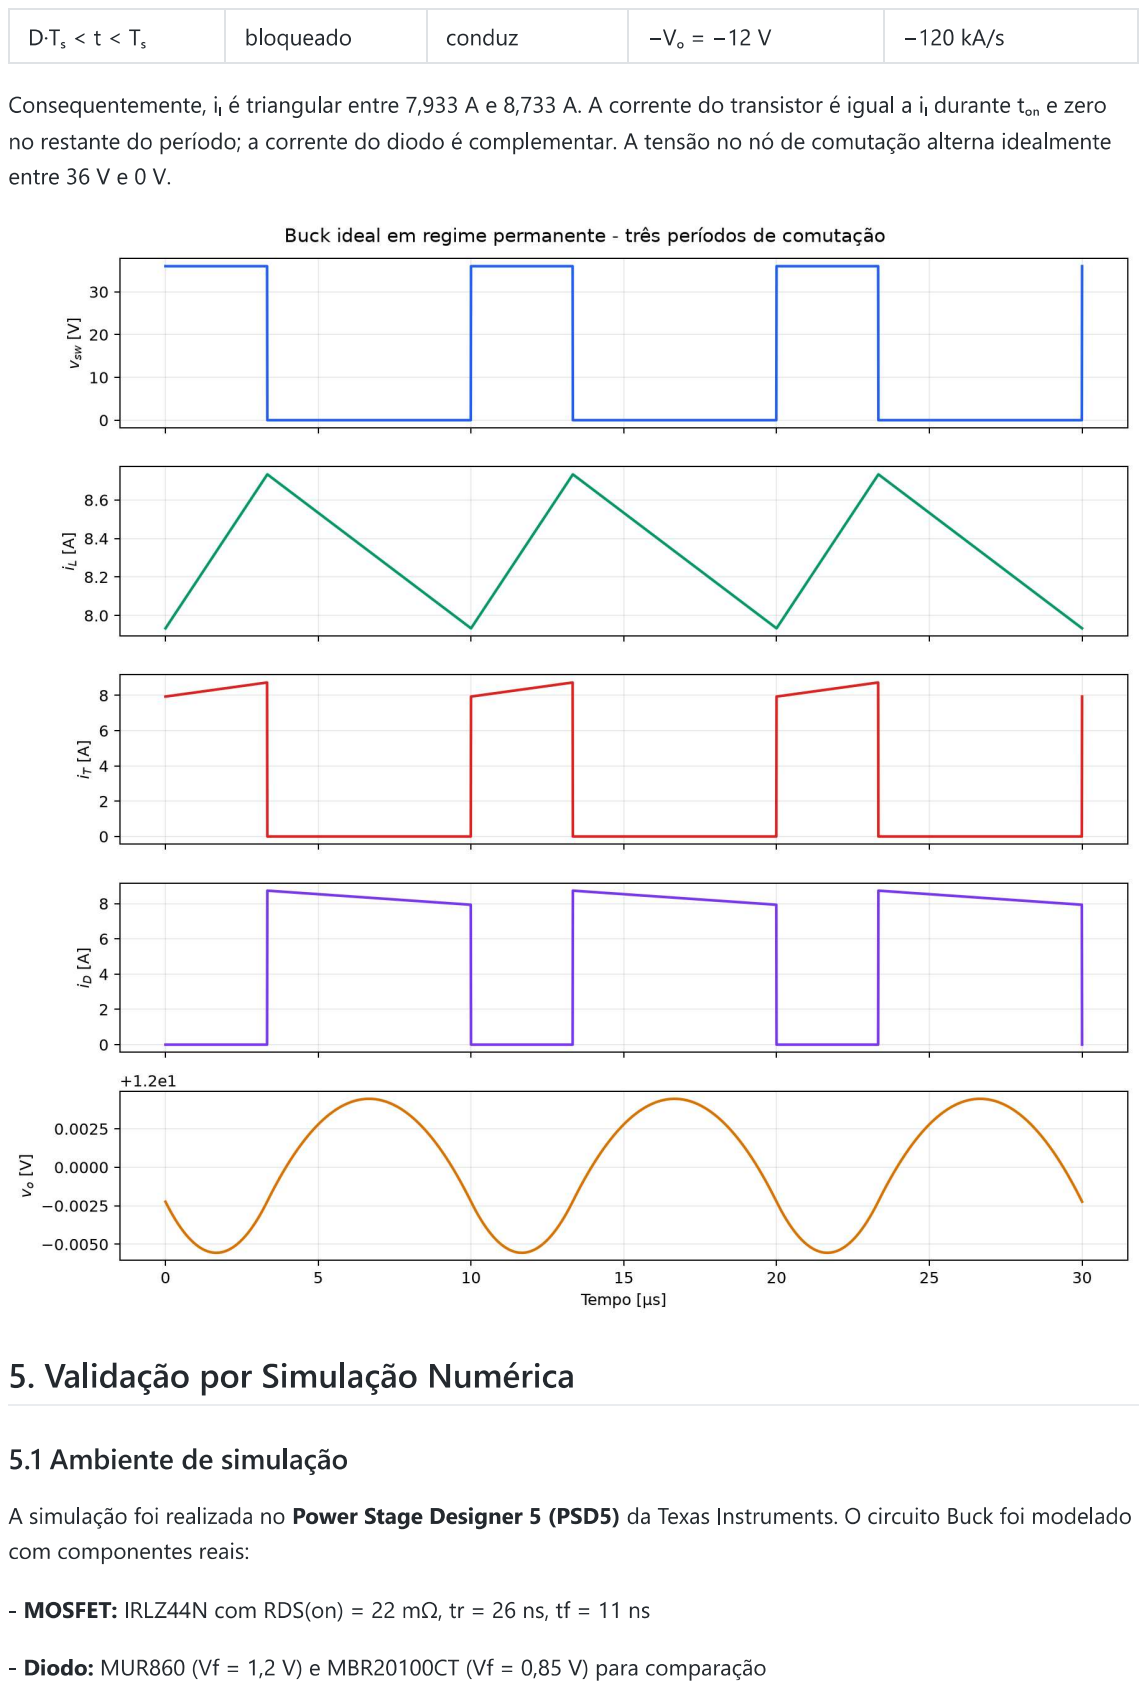
[picture p300: page 3]

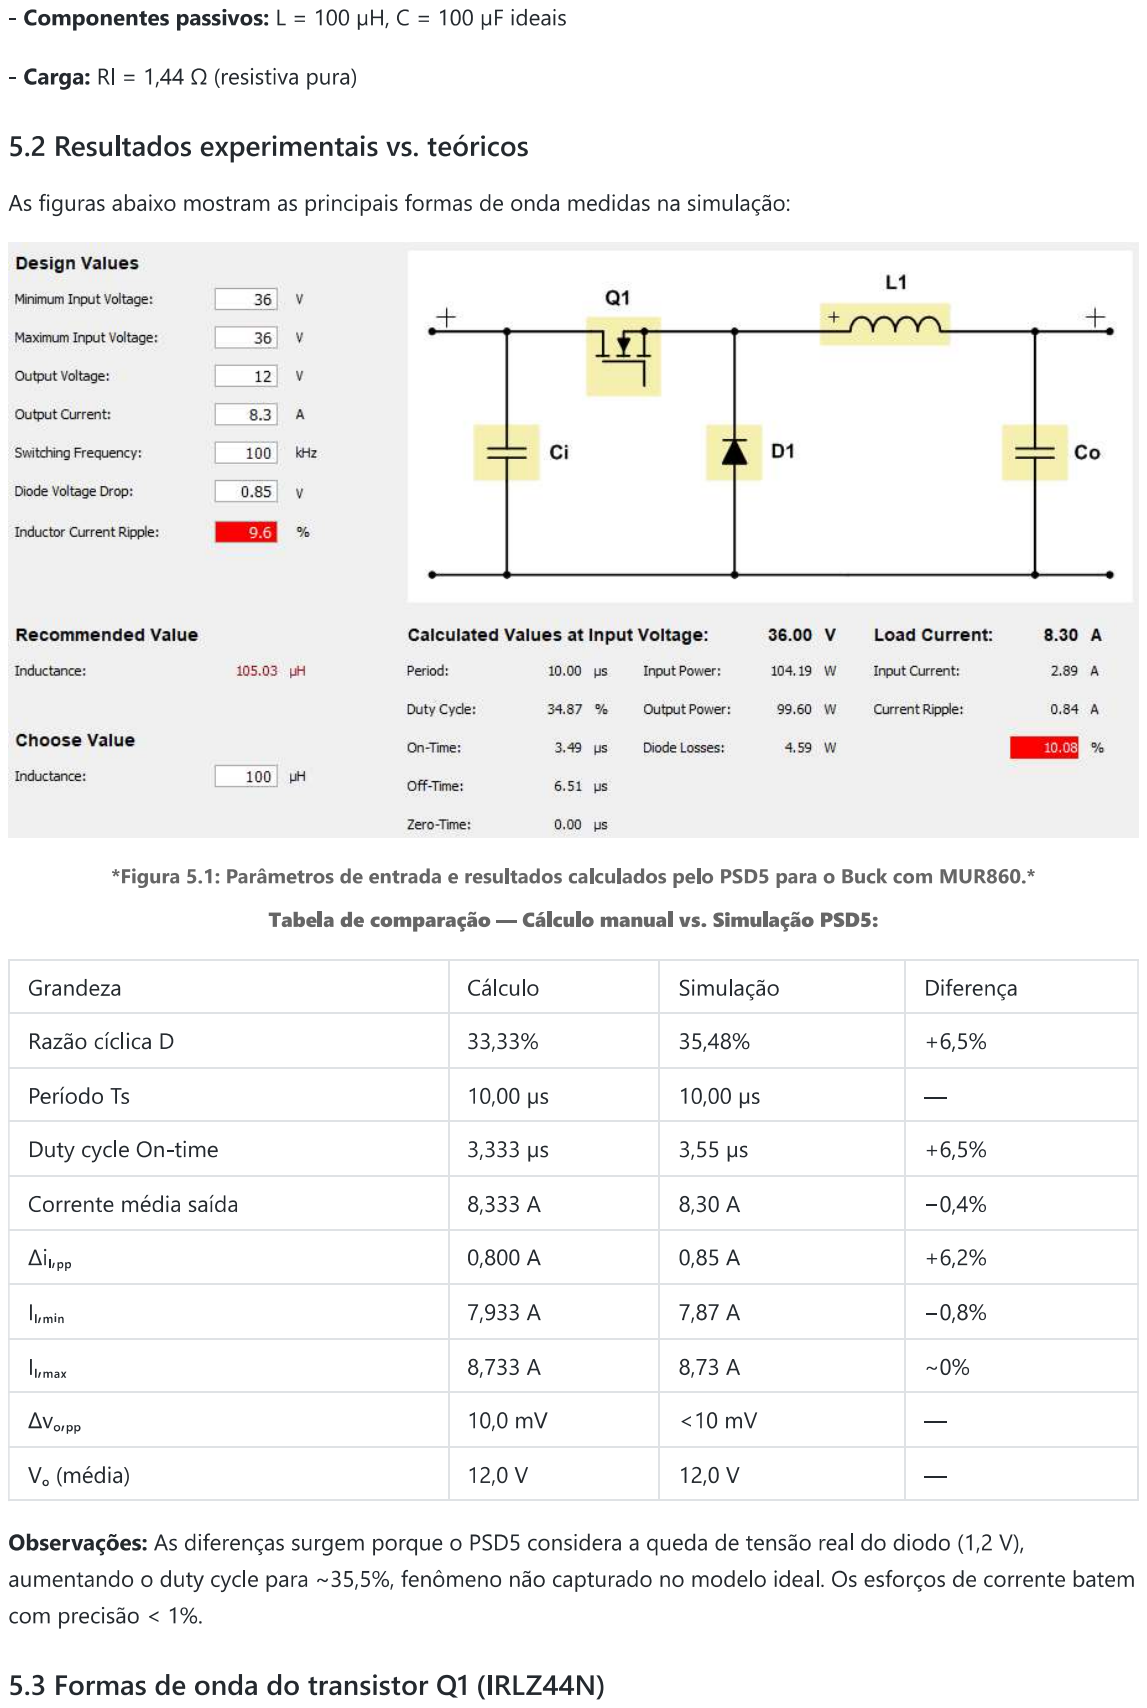
[picture p301: page 4]

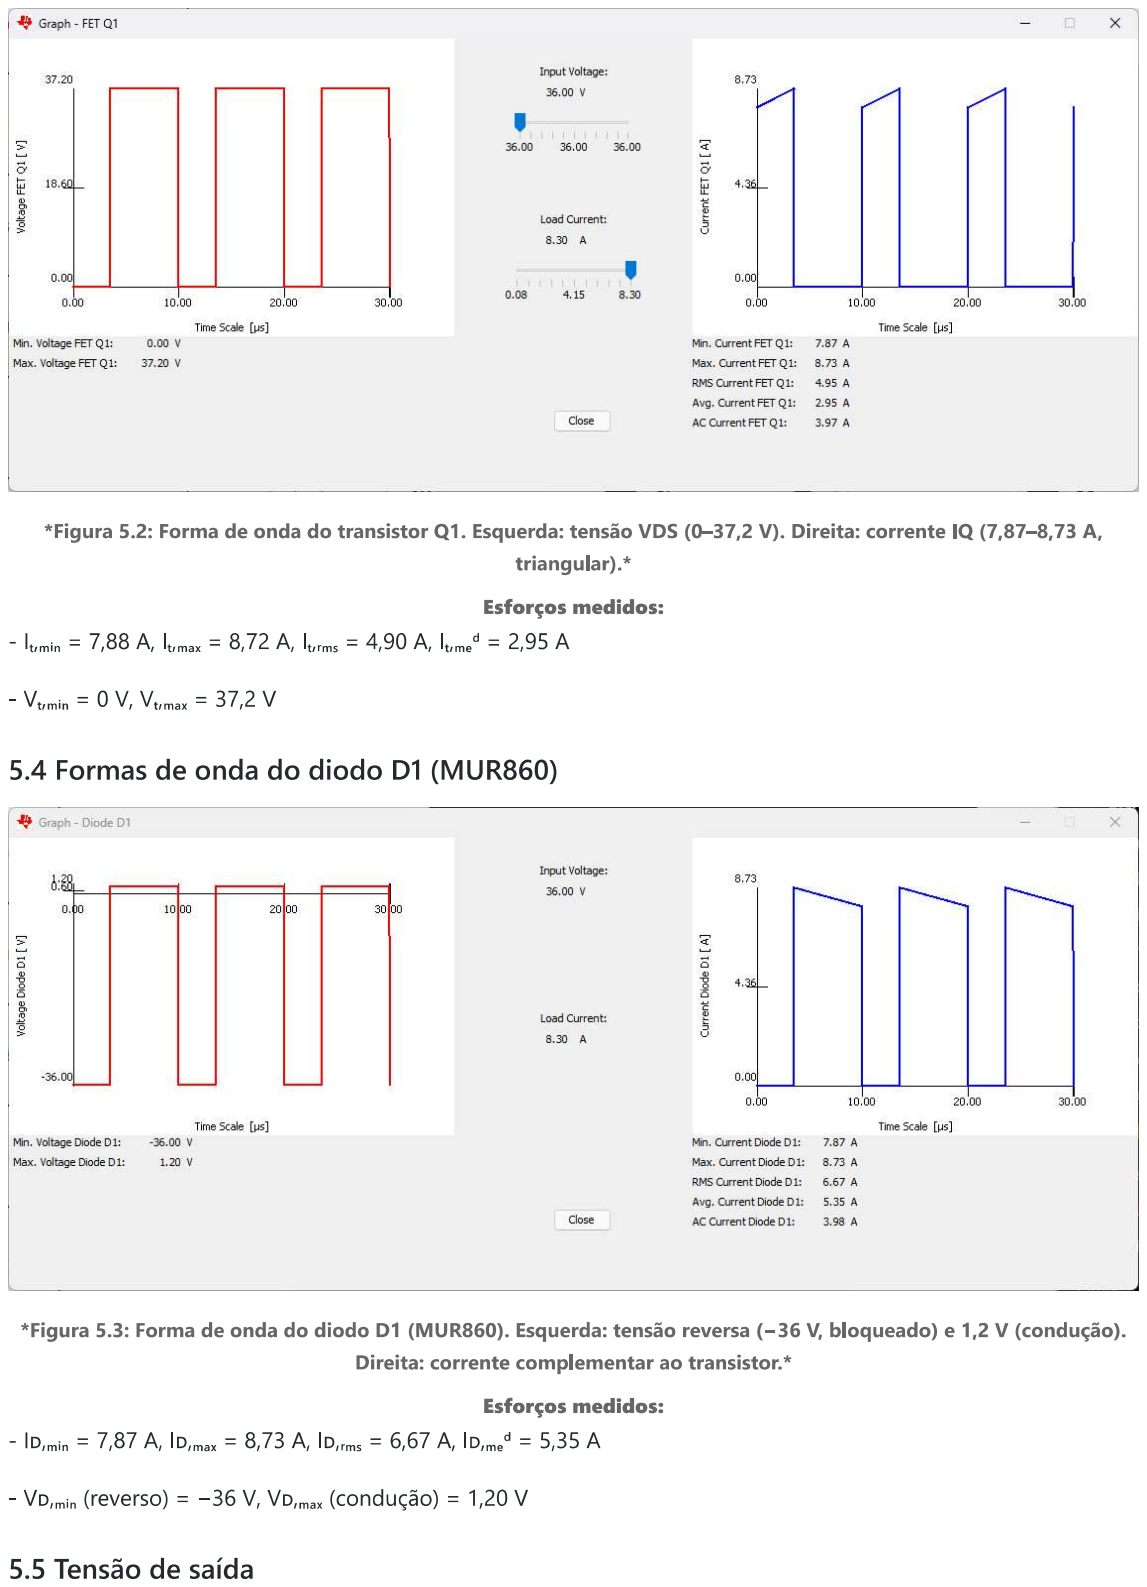
[picture p302: page 5]

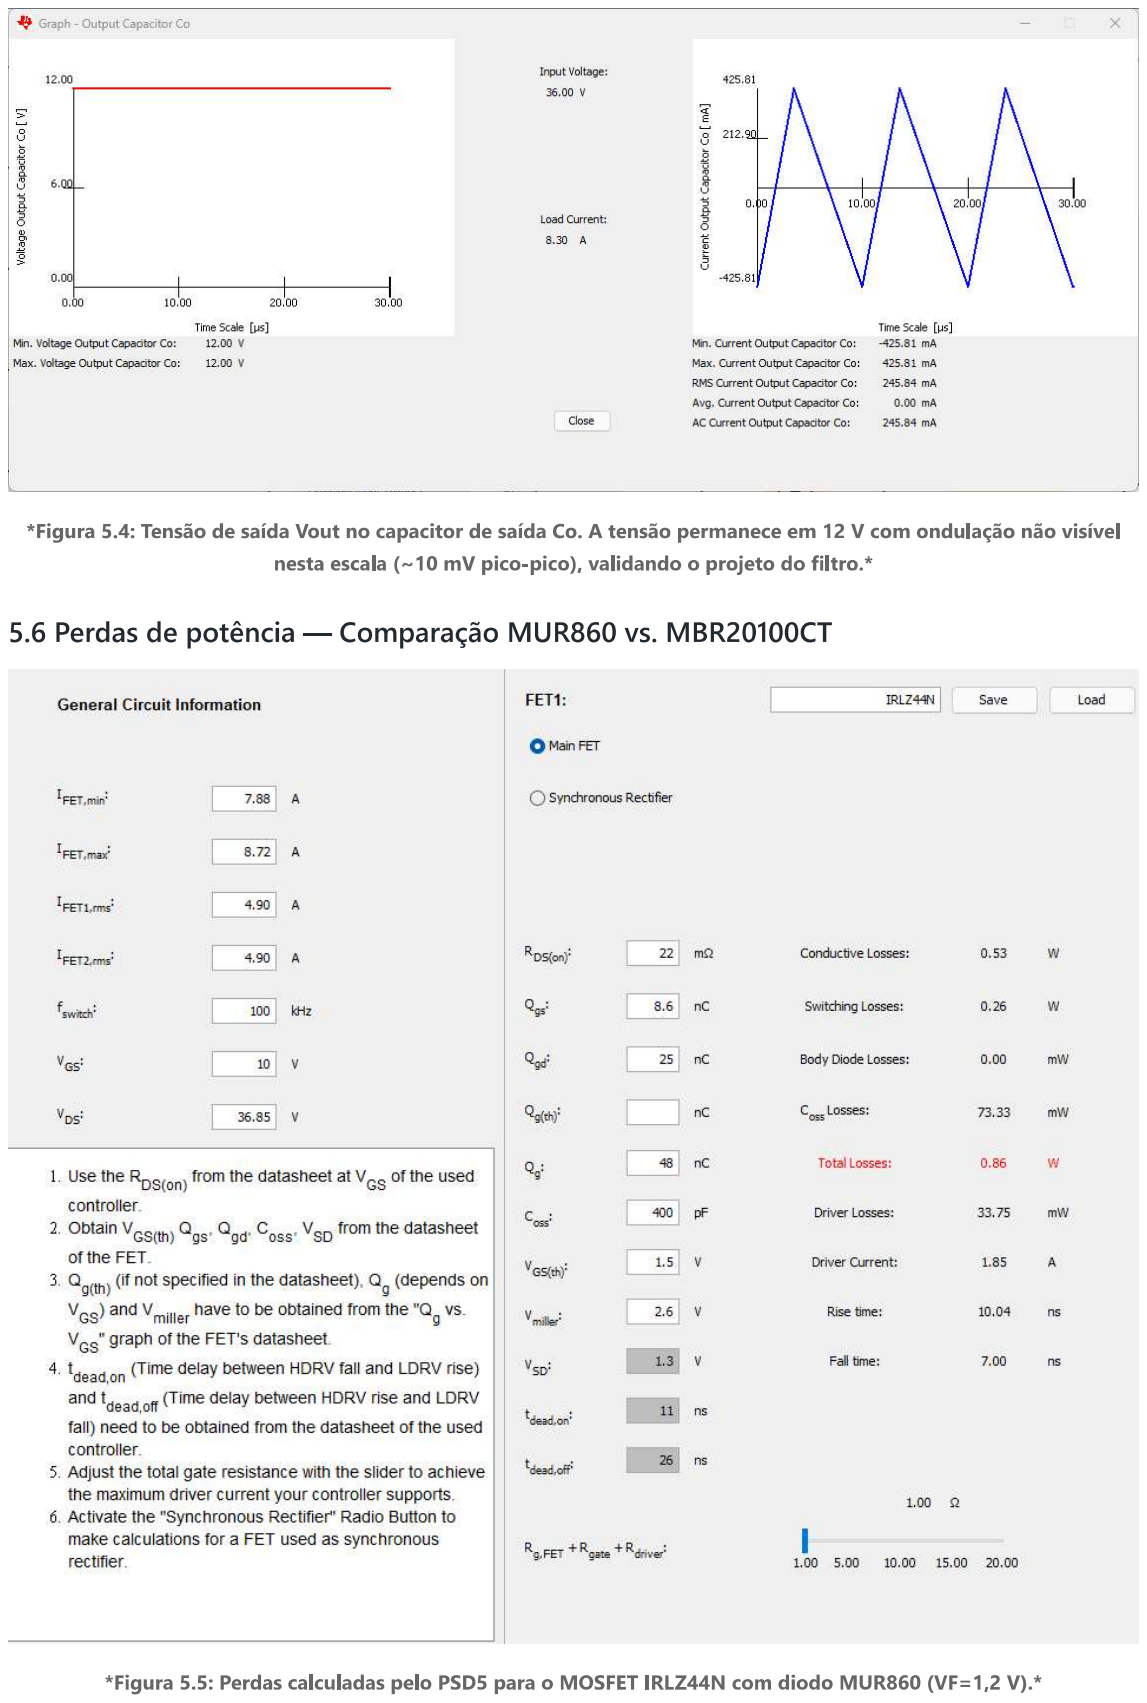
[picture p303: page 6]

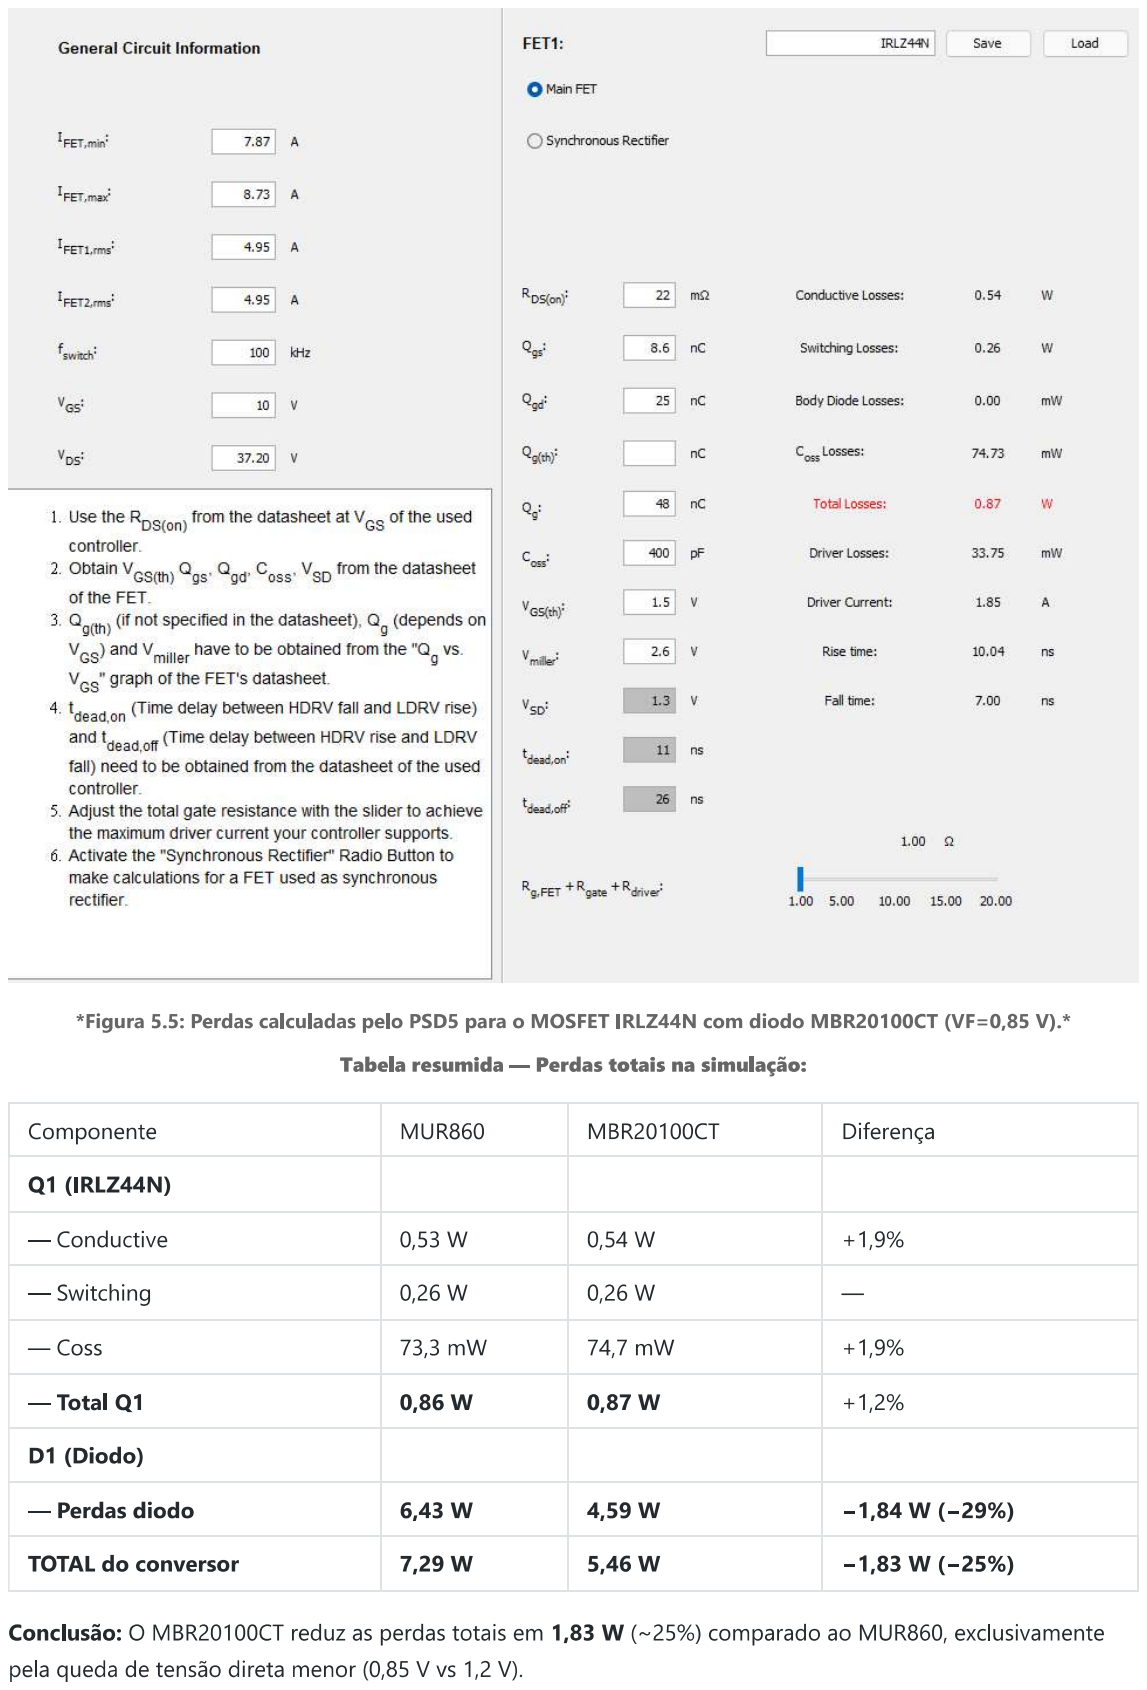
[picture p304: page 7]

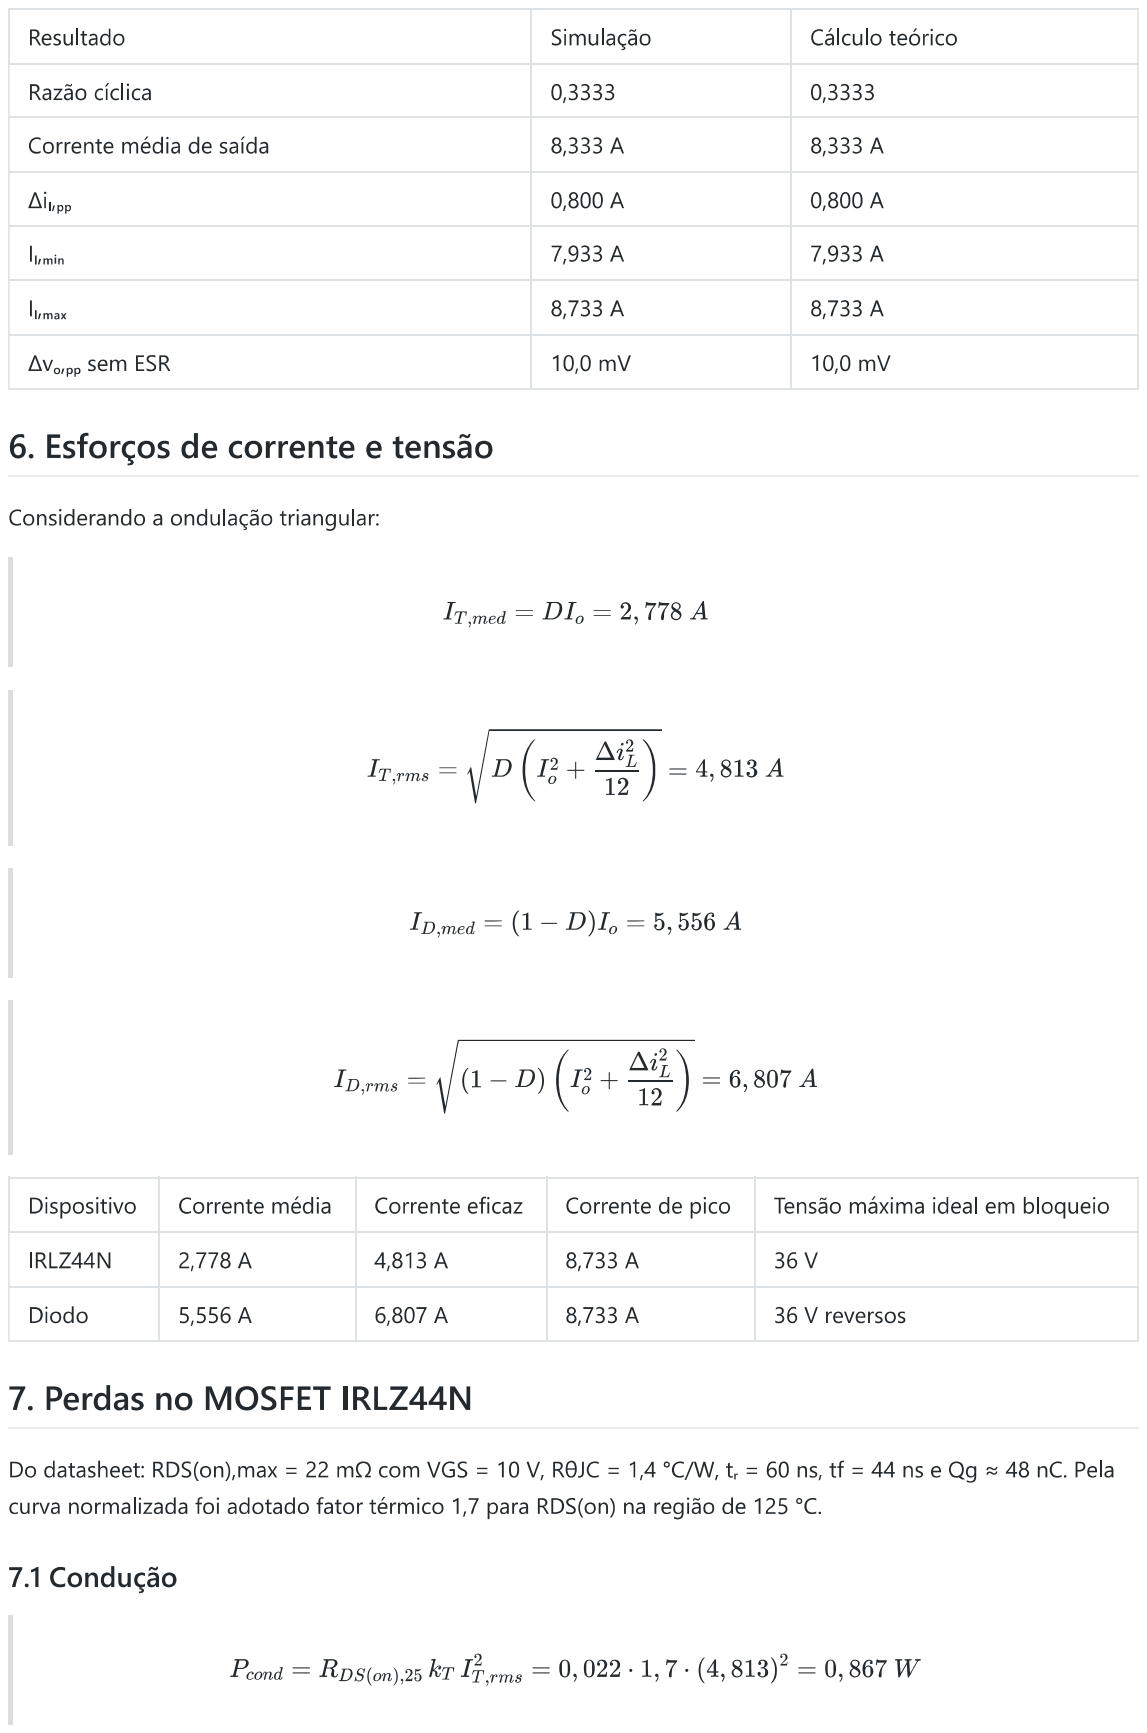
[picture p305: page 8]

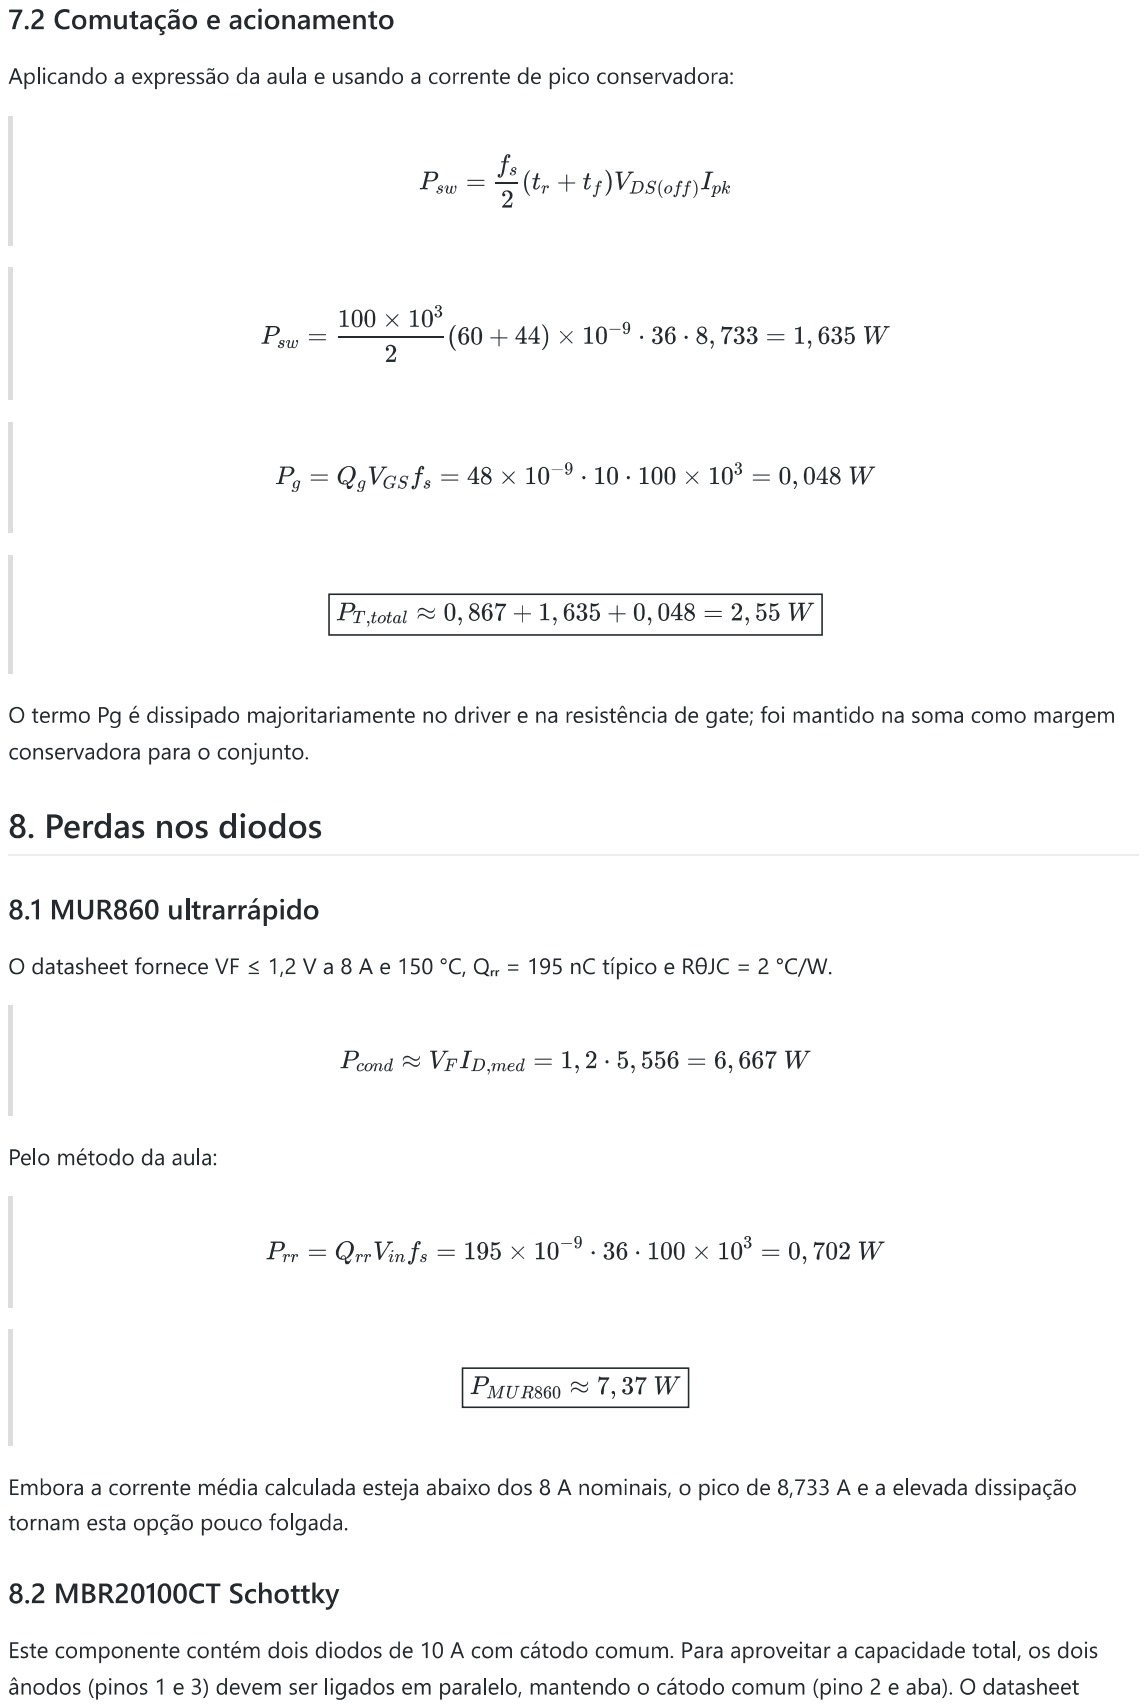
[picture p306: page 9]

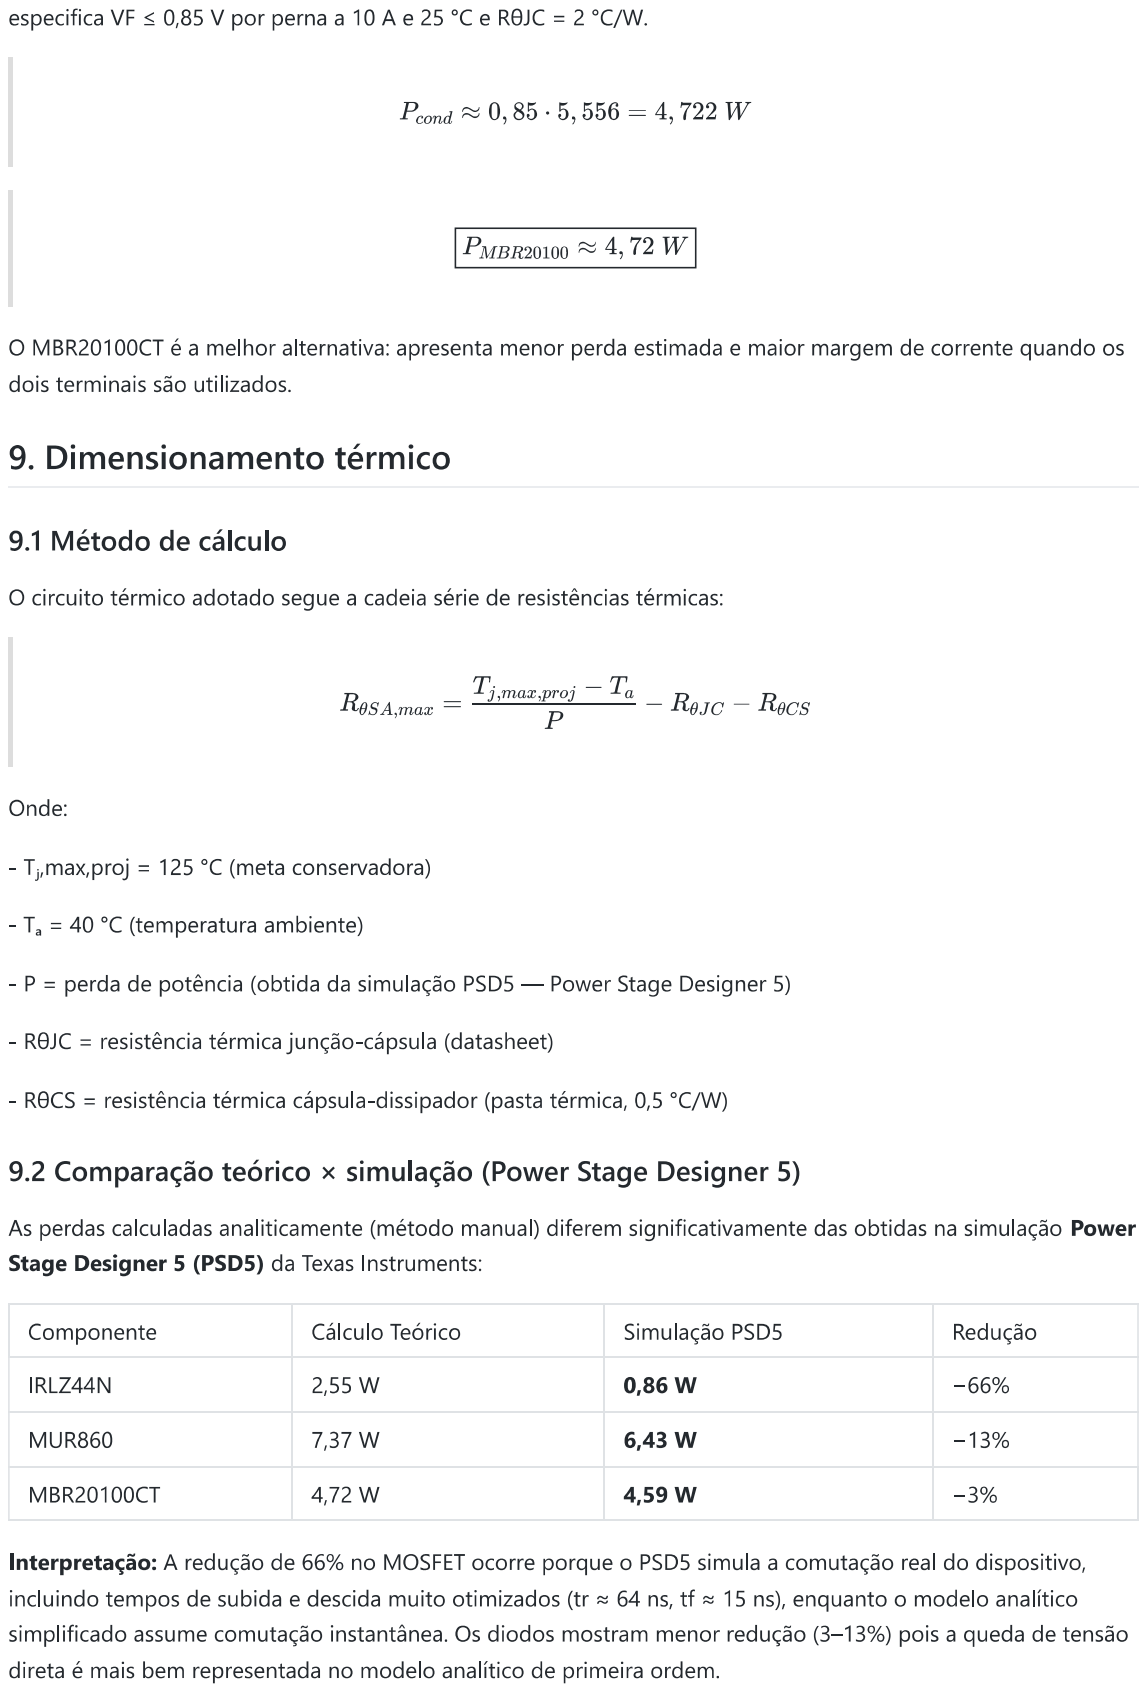
[picture p307: page 10]

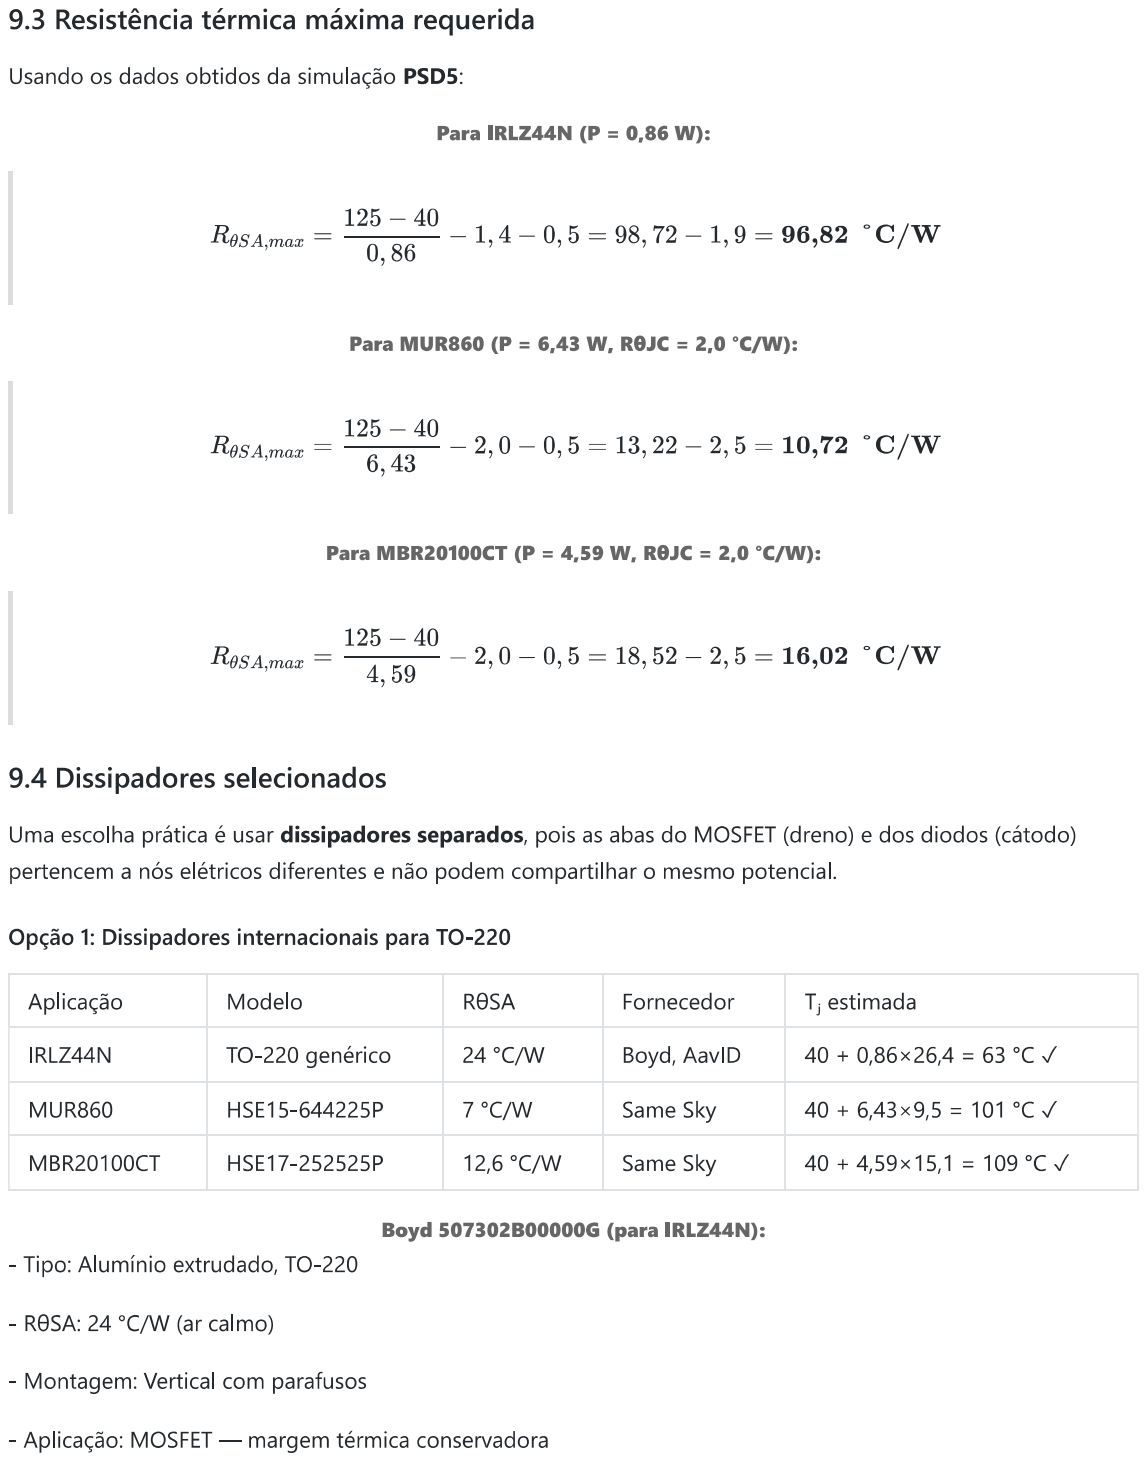
[picture p308: page 11]

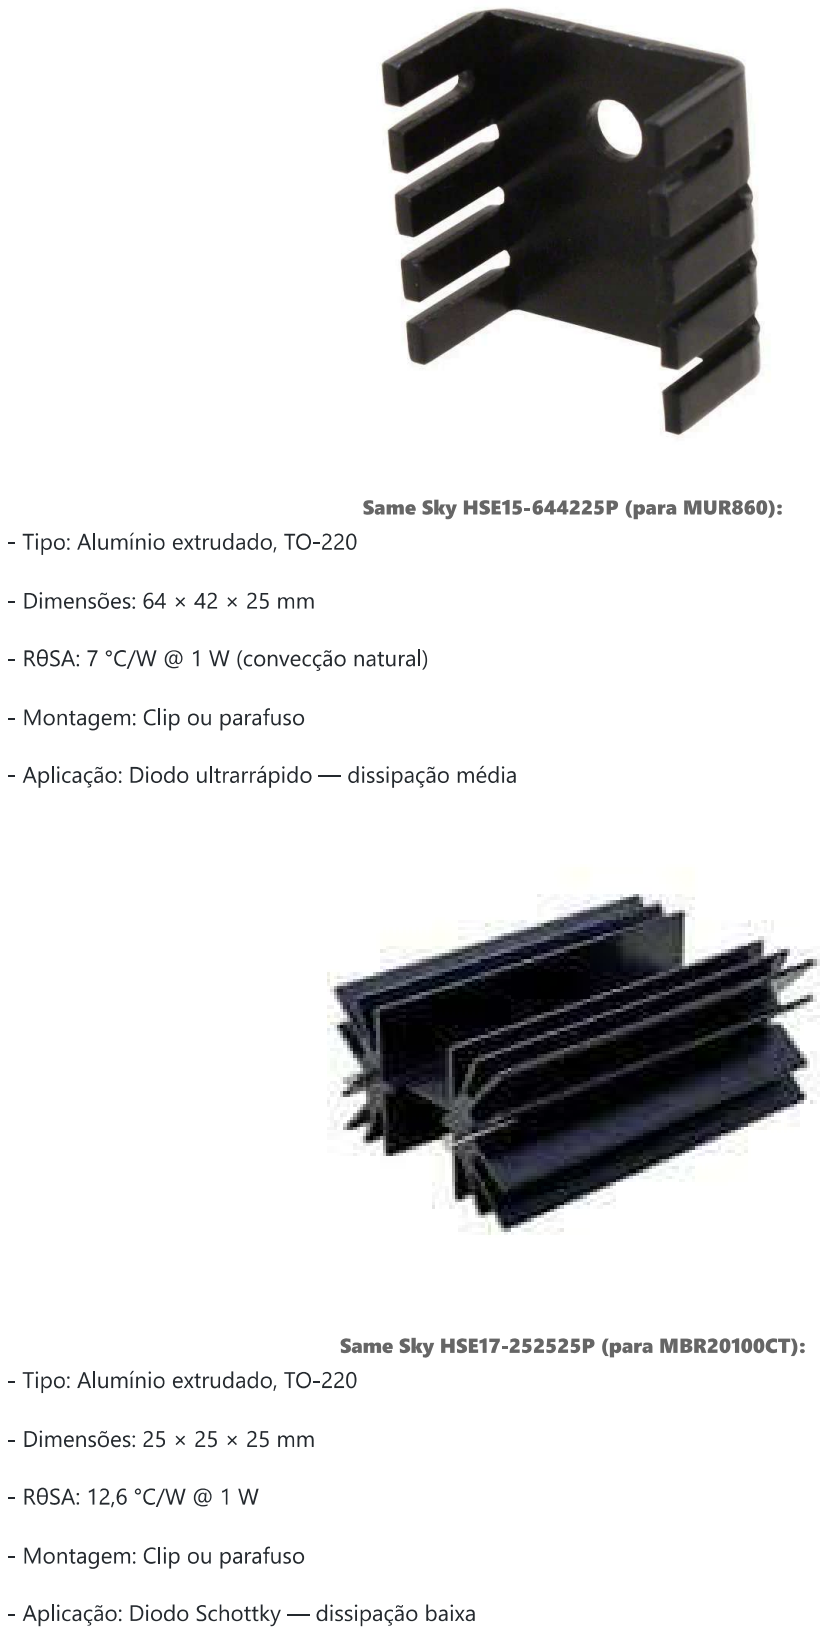
[picture p309: page 12]

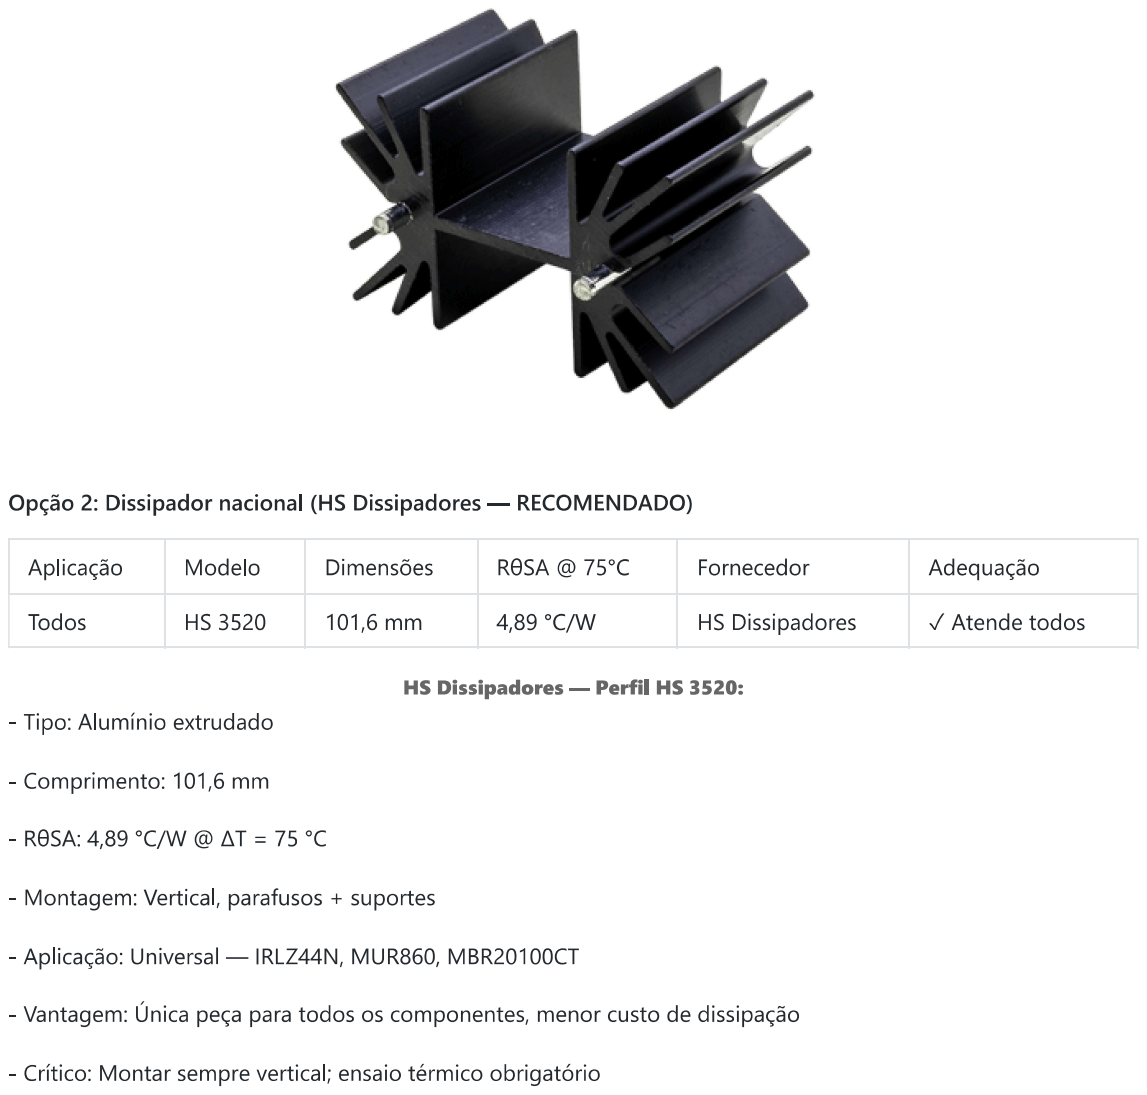
[picture p310: page 13]

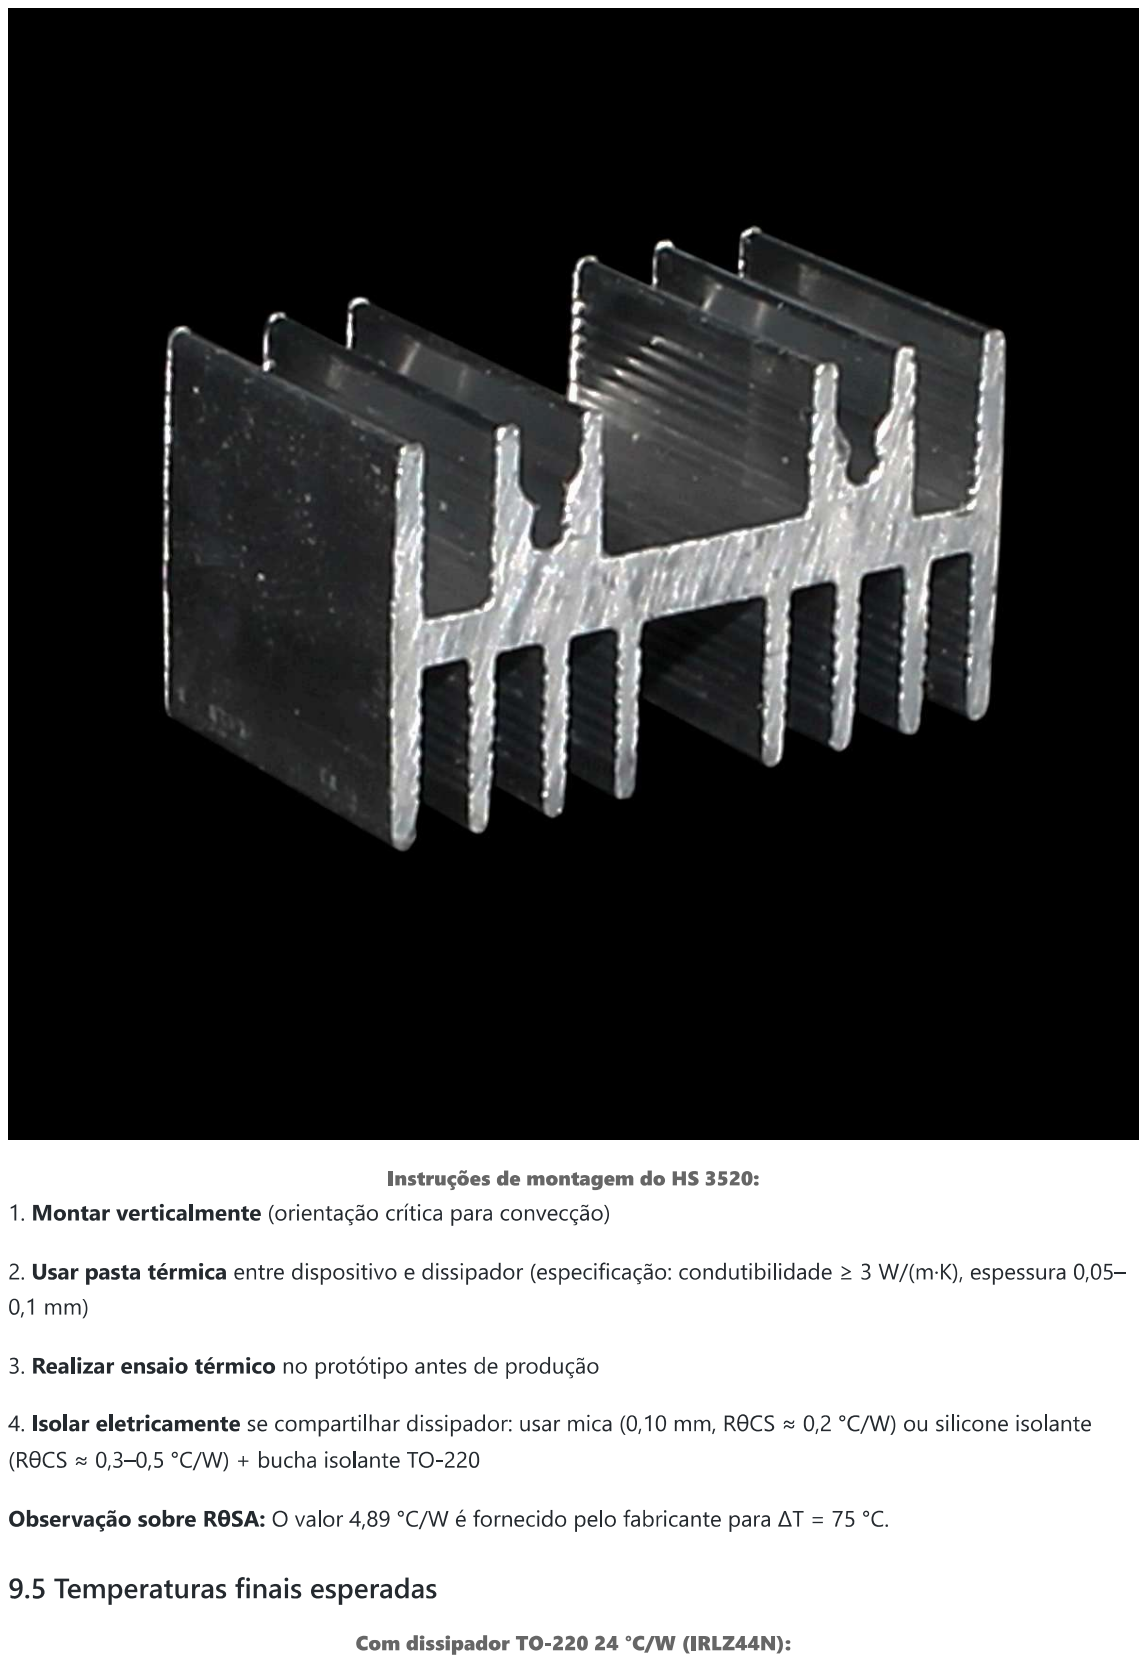
[picture p311: page 14]

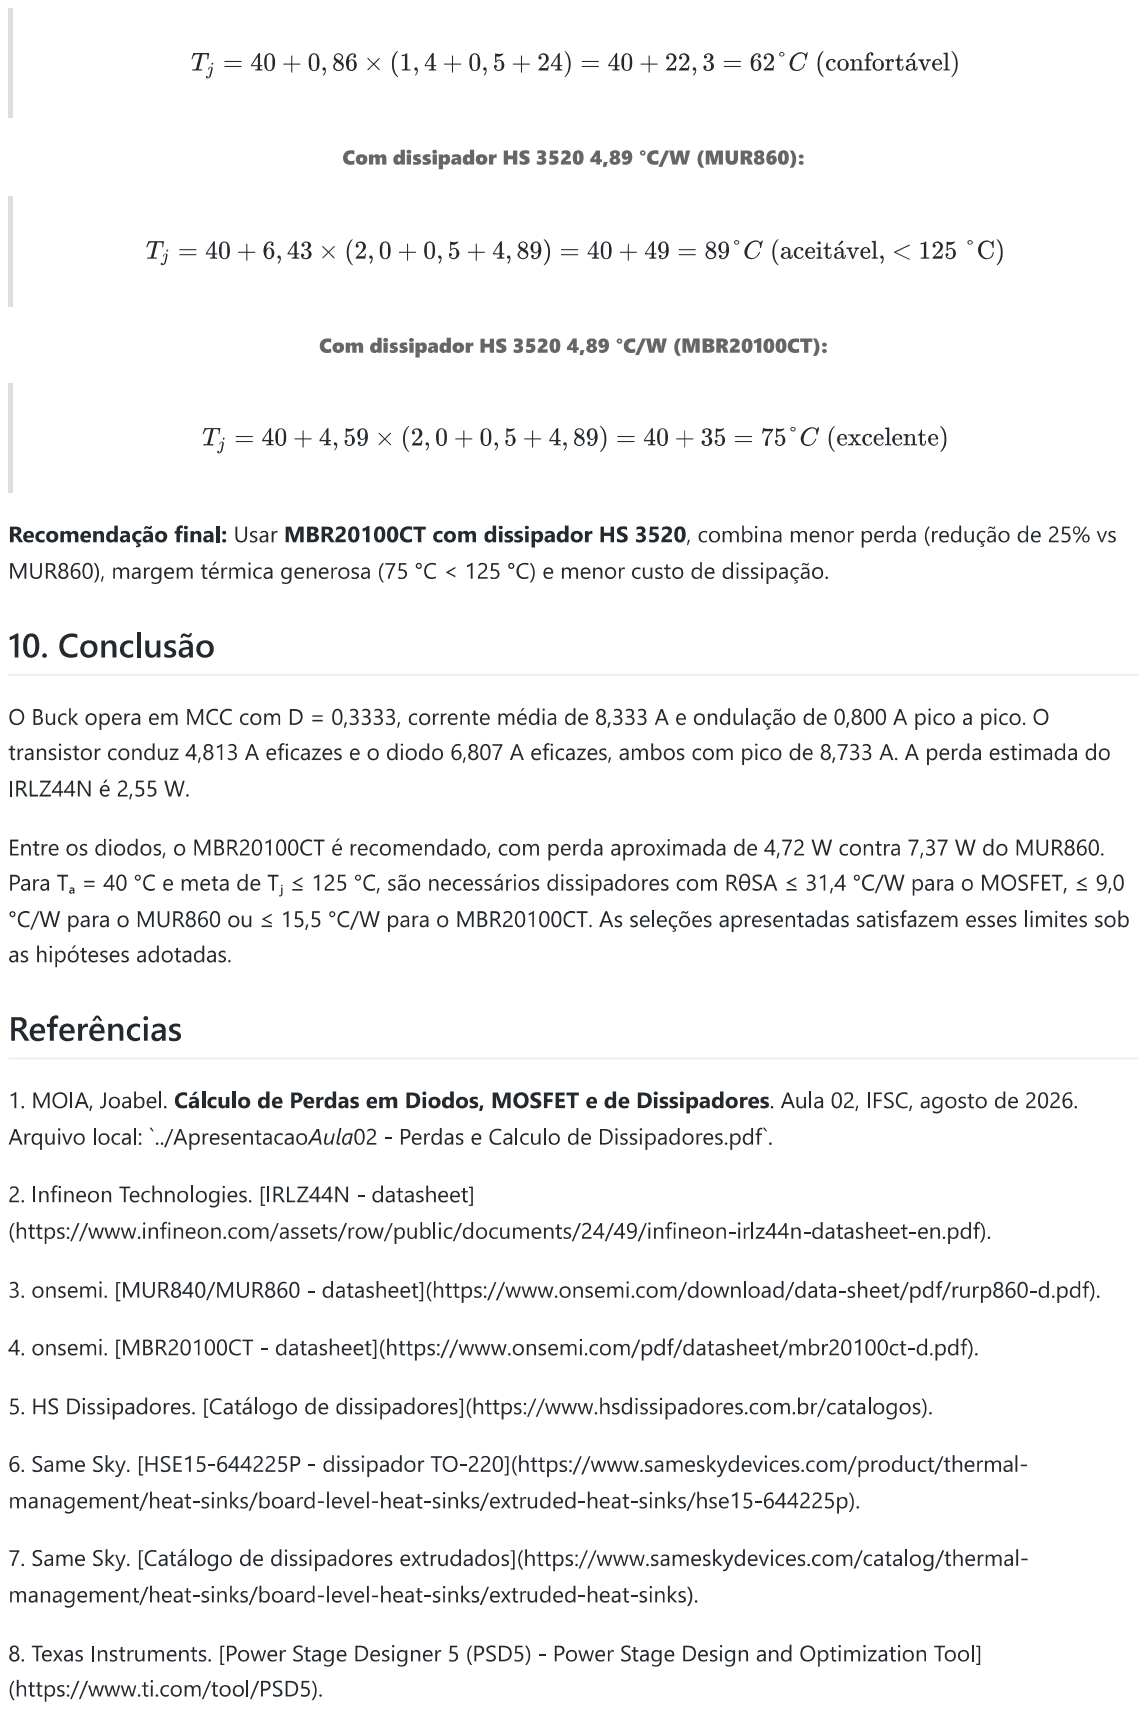
[picture p312: page 15]
