mateusalgado/IFSC_ELP2/Projeto_Flyback/revisoes/RevA_2026-10-19/04_KiCad/fonte_flyback_12V3A.kicad_pcb

## KiCad design Projeto_Flyback/revisoes/RevA_2026-10-19/04_KiCad/fonte_flyback_12V3A.kicad_pcb (2026-11-09)

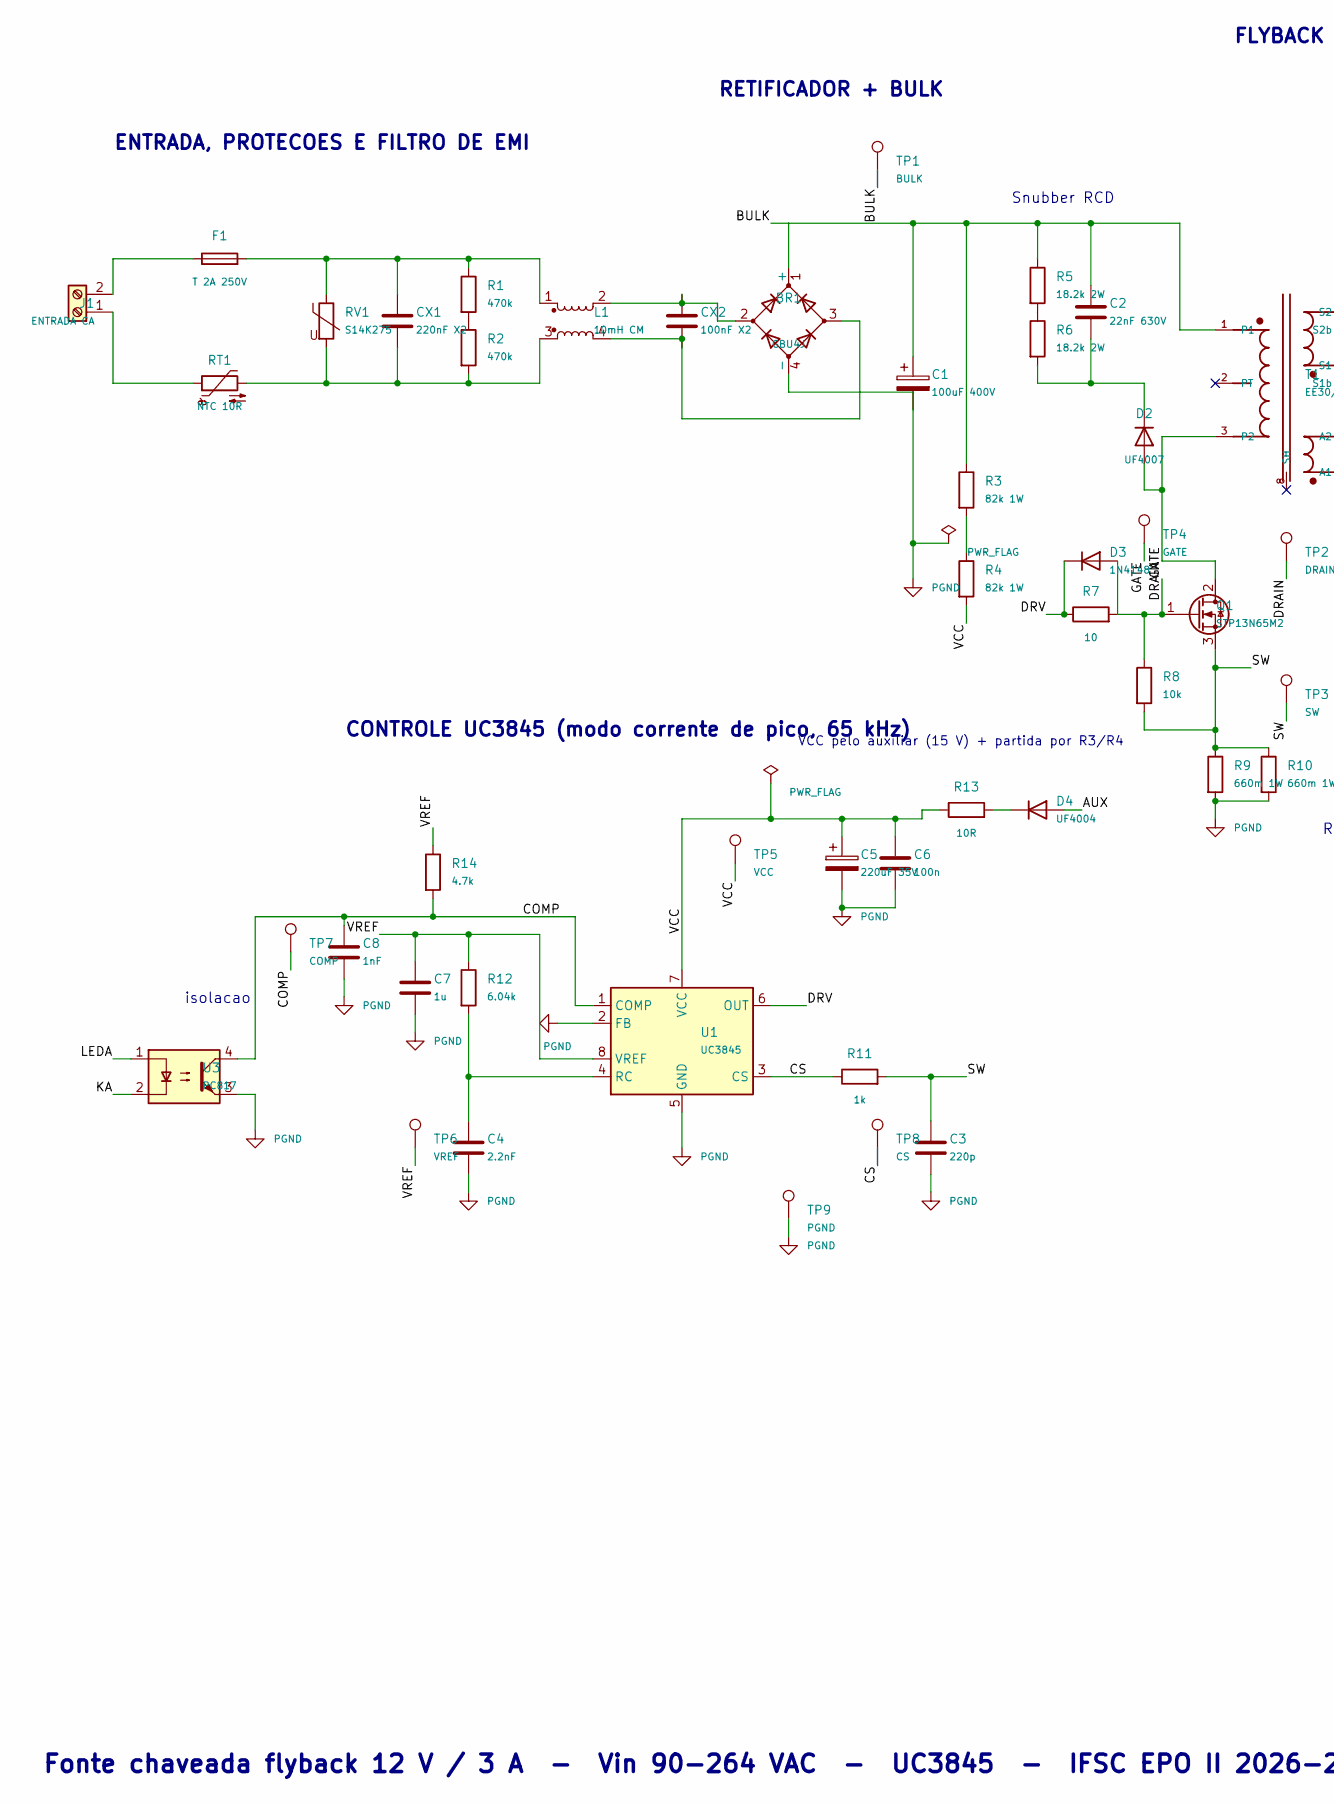
[picture p313: schematic fonte_flyback_12V3A.kicad_sch, Fonte chaveada flyback 12 V / 3 A - UC3845, part in row 1, column 1]

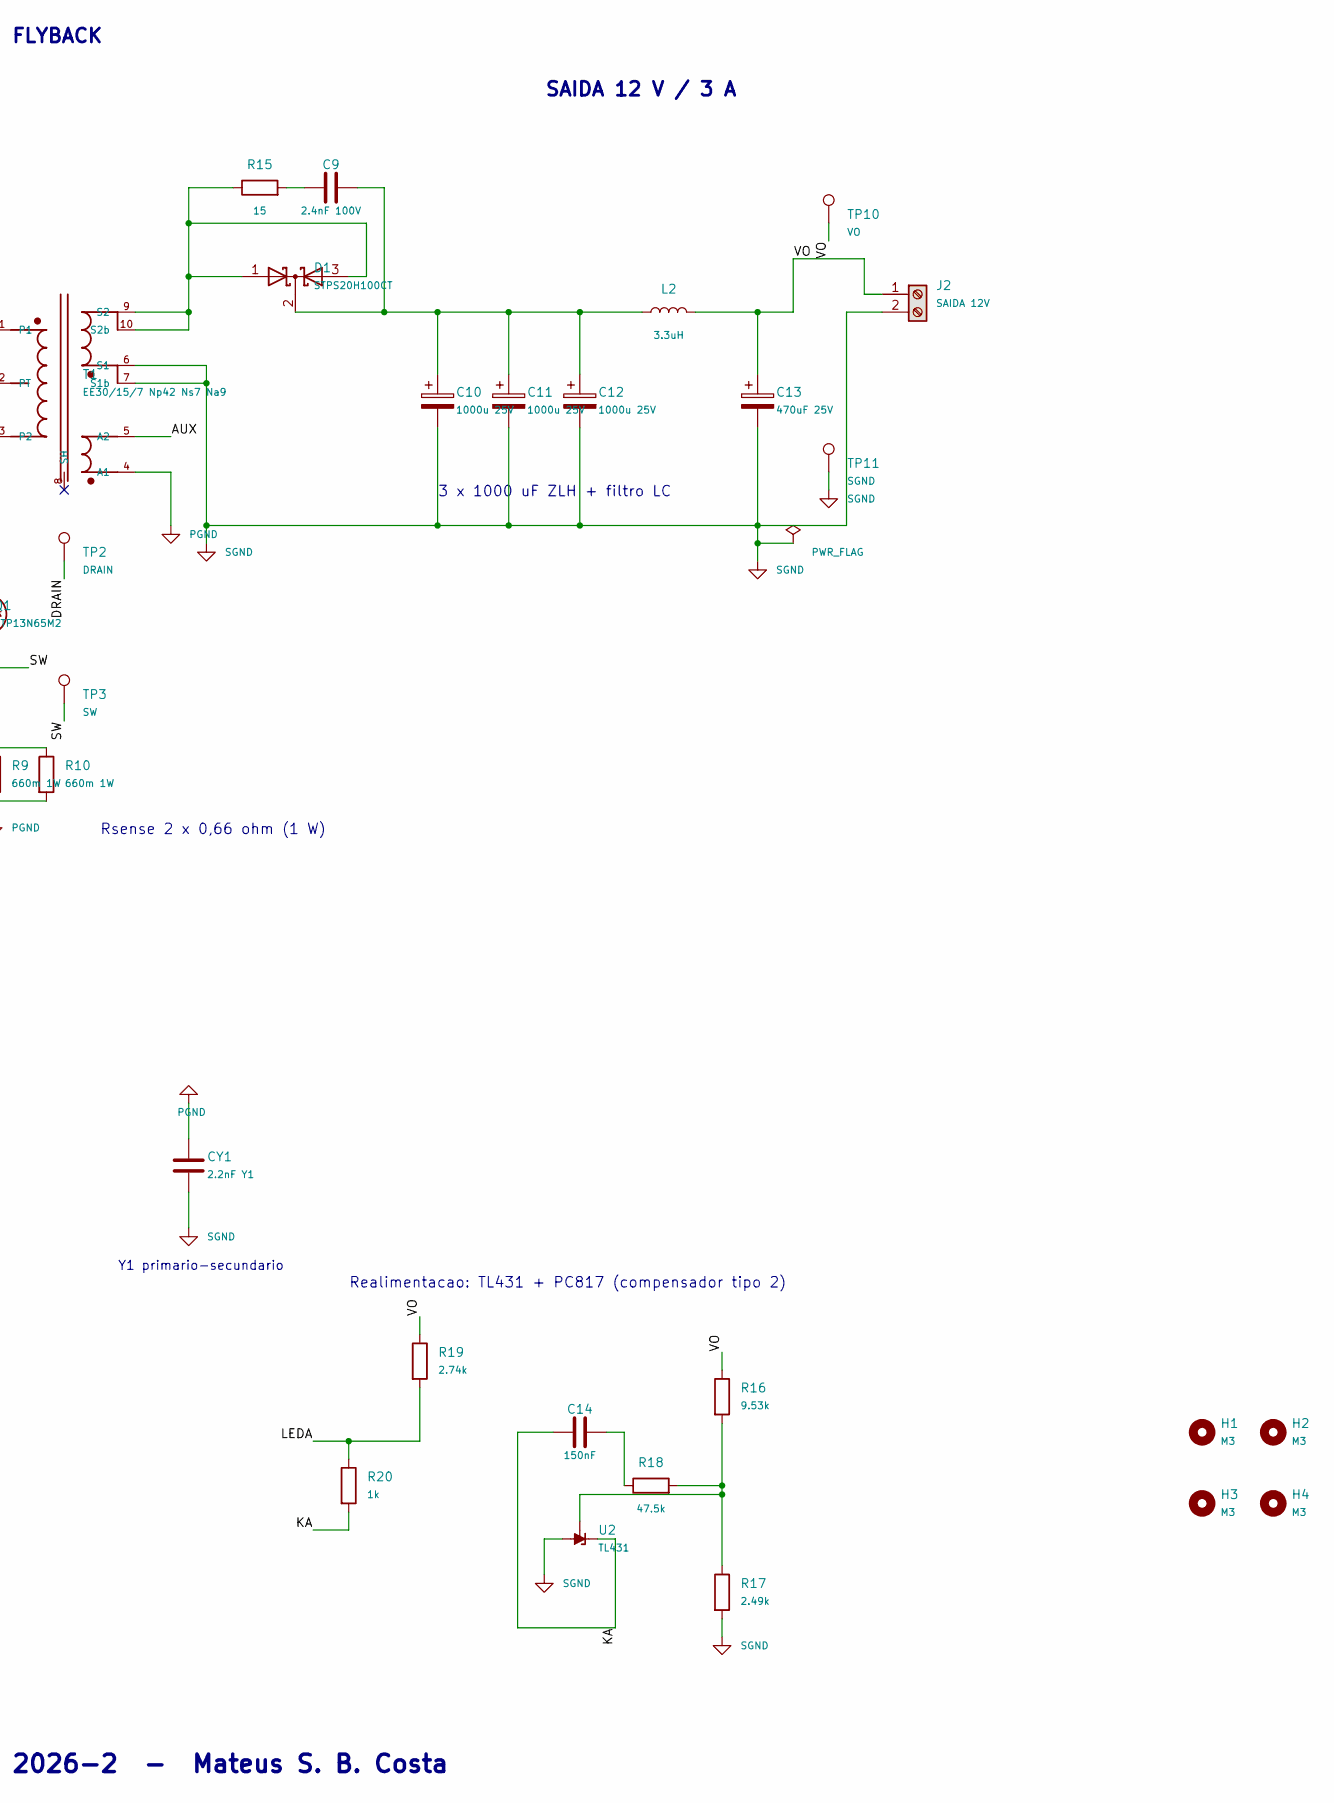
[picture p314: schematic fonte_flyback_12V3A.kicad_sch, Fonte chaveada flyback 12 V / 3 A - UC3845, part in row 1, column 2]

Parts:
BR1: GBU4J; Diode_Bridge_Vishay_GBU
C1: 100uF 400V; CP_Radial_D16.0mm_P7.50mm
C2: 22nF 630V; C_Disc_D7.5mm_W5.0mm_P10.00mm
C3: 220p; C_Disc_D5.0mm_W2.5mm_P5.00mm
C4: 2.2nF; C_Disc_D5.0mm_W2.5mm_P5.00mm
C5: 220uF 35V; CP_Radial_D8.0mm_P3.50mm
C6: 100n; C_Disc_D5.0mm_W2.5mm_P5.00mm
C7: 1u; C_Disc_D5.0mm_W2.5mm_P5.00mm
C8: 1nF; C_Disc_D5.0mm_W2.5mm_P5.00mm
C9: 2.4nF 100V; C_Rect_L7.0mm_W2.5mm_P5.00mm
C10, C11, C12: 1000u 25V; CP_Radial_D10.0mm_P5.00mm
C13: 470uF 25V; CP_Radial_D10.0mm_P5.00mm
C14: 150nF; C_Disc_D5.0mm_W2.5mm_P5.00mm
CX1: 220nF X2; C_Rect_L18.0mm_W8.0mm_P15.00mm_FKS3_FKP3
CX2: 100nF X2; C_Rect_L18.0mm_W8.0mm_P15.00mm_FKS3_FKP3
CY1: 2.2nF Y1; C_Disc_D9.0mm_W5.0mm_P10.00mm
D1: STPS20H100CT; TO-220-3_Vertical
D2: UF4007; D_DO-41_SOD81_P10.16mm_Horizontal
D3: 1N4148; D_DO-35_SOD27_P7.62mm_Horizontal
D4: UF4004; D_DO-41_SOD81_P10.16mm_Horizontal
F1: T 2A 250V; Fuseholder_Cylinder-5x20mm_Stelvio-Kontek_PTF78_Horizontal_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
H1, H2, H3, H4: M3; MountingHole_3.2mm_M3
J1: ENTRADA CA; TerminalBlock_Phoenix_MKDS-1,5-2-5.08_1x02_P5.08mm_Horizont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
J2: SAIDA 12V; TerminalBlock_Phoenix_MKDS-1,5-2-5.08_1x02_P5.08mm_Horizont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
L1: 10mH CM; L_CM_WE-CMB-XS
L2: 3.3uH; L_Radial_D7.0mm_P3.00mm
Q1: STP13N65M2; TO-220-3_Vertical
R1, R2: 470k; R_Axial_DIN0207_L6.3mm_D2.5mm_P10.16mm_Horizontal
R3, R4: 82k 1W; R_Axial_DIN0411_L9.9mm_D3.6mm_P12.70mm_Horizontal
R5, R6: 18.2k 2W; R_Axial_DIN0414_L11.9mm_D4.5mm_P15.24mm_Horizontal
R7: 10; R_Axial_DIN0207_L6.3mm_D2.5mm_P10.16mm_Horizontal
R8: 10k; R_Axial_DIN0207_L6.3mm_D2.5mm_P10.16mm_Horizontal
R9, R10: 660m 1W; R_Axial_DIN0411_L9.9mm_D3.6mm_P12.70mm_Horizontal
R11, R20: 1k; R_Axial_DIN0207_L6.3mm_D2.5mm_P10.16mm_Horizontal
R12: 6.04k; R_Axial_DIN0207_L6.3mm_D2.5mm_P10.16mm_Horizontal
R13: 10R; R_Axial_DIN0207_L6.3mm_D2.5mm_P10.16mm_Horizontal
R14: 4.7k; R_Axial_DIN0207_L6.3mm_D2.5mm_P10.16mm_Horizontal
R15: 15; R_Axial_DIN0207_L6.3mm_D2.5mm_P10.16mm_Horizontal
R16: 9.53k; R_Axial_DIN0207_L6.3mm_D2.5mm_P10.16mm_Horizontal
R17: 2.49k; R_Axial_DIN0207_L6.3mm_D2.5mm_P10.16mm_Horizontal
R18: 47.5k; R_Axial_DIN0207_L6.3mm_D2.5mm_P10.16mm_Horizontal
R19: 2.74k; R_Axial_DIN0207_L6.3mm_D2.5mm_P10.16mm_Horizontal
RT1: NTC 10R; C_Disc_D9.0mm_W5.0mm_P7.50mm
RV1: S14K275; RV_Disc_D12mm_W4.2mm_P7.5mm
T1: EE30/15/7 Np42 Ns7 Na9; Trafo_EE30_10pin
TP1: BULK; TestPoint_THTPad_D2.0mm_Drill1.0mm
TP2: DRAIN; TestPoint_THTPad_D2.0mm_Drill1.0mm
TP3: SW; TestPoint_THTPad_D2.0mm_Drill1.0mm
TP4: GATE; TestPoint_THTPad_D2.0mm_Drill1.0mm
TP5: VCC; TestPoint_THTPad_D2.0mm_Drill1.0mm
TP6: VREF; TestPoint_THTPad_D2.0mm_Drill1.0mm
TP7: COMP; TestPoint_THTPad_D2.0mm_Drill1.0mm
TP8: CS; TestPoint_THTPad_D2.0mm_Drill1.0mm
TP9: PGND; TestPoint_THTPad_D2.0mm_Drill1.0mm
TP10: VO; TestPoint_THTPad_D2.0mm_Drill1.0mm
TP11: SGND; TestPoint_THTPad_D2.0mm_Drill1.0mm
U1: UC3845; DIP-8_W7.62mm
U2: TL431; TO-92_Inline_Wide
U3: PC817; DIP-4_W7.62mm

Connections:
/AUX: D4.2 (A), T1.5 (A2)
/BULK: BR1.1 (+), C1.1, C2.1, R3.1, R5.1, T1.1, TP1.1
/COMP: C8.1, R14.2, TP7.1, U1.1 (COMP), U3.4
/CS: R11.1, TP8.1, U1.3 (CS)
/DRAIN: D2.2 (A), Q1.2 (D), T1.3 (P2), TP2.1
/DRV: D3.1 (K), R7.1, U1.6 (OUT)
/GATE: D3.2 (A), Q1.1 (G), R7.2, R8.1, TP4.1
/KA: C14.1, R20.2, U2.3 (K), U3.2
/LEDA: R19.2, R20.1, U3.1
/SW: C3.1, Q1.3 (S), R8.2, R9.1, R10.1, R11.2, TP3.1
/VCC: C5.1, C6.1, R4.2, R13.1, TP5.1, U1.7 (VCC)
/VO: C13.1, J2.1, L2.2, R16.1, R19.1, TP10.1
/VREF: C7.1, R12.1, R14.1, TP6.1, U1.8 (VREF)
unnamed: BR1.2, CX2.1, L1.2
unnamed: BR1.3, CX2.2, L1.4
unnamed: C9.1, R15.2
unnamed: C14.2, R18.1
unnamed: CX1.1, F1.2, L1.1, R1.1, RV1.1
unnamed: CX1.2, L1.3, R2.2, RT1.2, RV1.2
unnamed: C9.2, C10.1, C11.1, C12.1, D1.2 (K), L2.1
unnamed: C2.2, D2.1 (K), R6.2
unnamed: D4.1 (K), R13.2
unnamed: J1.1, RT1.1
unnamed: F1.1, J1.2
unnamed: R1.2, R2.1
unnamed: R3.2, R4.1
unnamed: R5.2, R6.1
unnamed: D1.1 (A), D1.3 (A), R15.1, T1.9 (S2), T1.10 (S2b)
unnamed: C4.1, R12.2, U1.4 (RC)
unnamed: R16.2, R17.1, R18.2, U2.1 (REF)
PGND: BR1.4 (-), C1.2, C3.2, C4.2, C5.2, C6.2, C7.2, C8.2, CY1.1, R9.2, R10.2, T1.4 (A1), TP9.1, U1.2 (FB), U1.5 (GND), U3.3
SGND: C10.2, C11.2, C12.2, C13.2, CY1.2, J2.2, R17.2, T1.6 (S1), T1.7 (S1b), TP11.1, U2.2 (A)

Notes on the sheet:
Snubber RCD
Rsense 2 x 0,66 ohm (1 W)
3 x 1000 uF ZLH + filtro LC
isolacao
VCC pelo auxiliar (15 V) + partida por R3/R4
Realimentacao: TL431 + PC817 (compensador tipo 2)
Y1 primario-secundario
ENTRADA, PROTECOES E FILTRO DE EMI
RETIFICADOR + BULK
FLYBACK
SAIDA 12 V / 3 A
CONTROLE UC3845 (modo corrente de pico, 65 kHz)
Fonte chaveada flyback 12 V / 3 A - Vin 90-264 VAC - UC3845 - IFSC EPO II 2026-2 - Mateus S. B. Costa

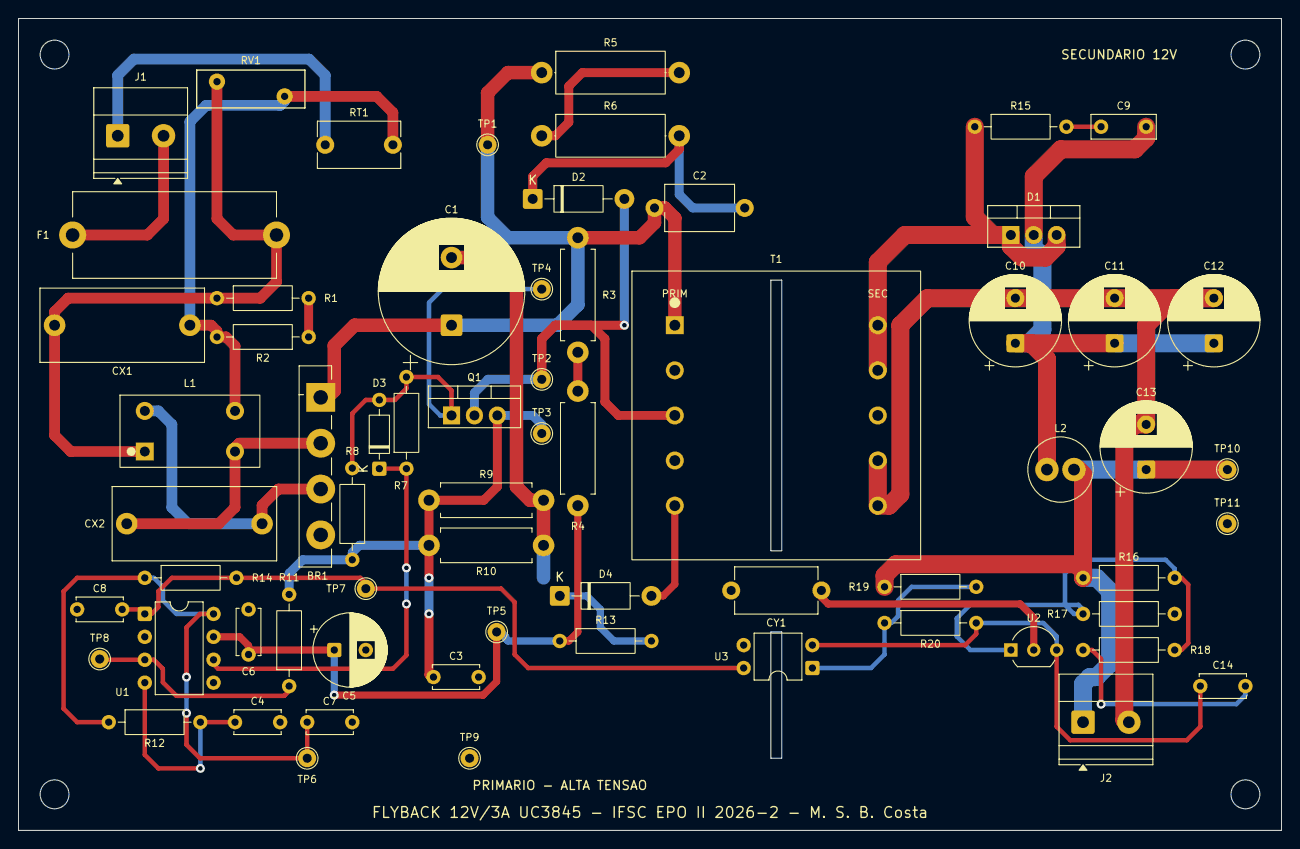
[picture p315: board fonte_flyback_12V3A.kicad_pcb from above]

Board: 2 copper layers, 140.0 x 90.0 mm, 69 parts (0 on the bottom side), 32 nets.
