mateusalgado/IFSC_ELP2/(commit log)

2026-11-09 Projeto semestral EPO II 2026-2: flyback 12 V/3 A UC3845 (revisões A e B) e tarefas 1-3
    Revisão A (PROJETO/, 19/10/2026) preservada e revisão B (PROJETO_REV_B/) com
    placement da placa revisto em 05/11/2026 antes do pedido da PCI: DRC 0 erros,
    isolação 6,4 mm, porta-fusível, laços JP1/JP2, BOM 58 itens, relatório,
    slides, guia de montagem e pedido de compra da Possibilidade II.
    Arquivos .raw do LTspice e material de aula ficam fora do repositório (.gitignore).
    [BOM.csv, BOM.xlsx, Inductor Design Tool for 64bit.xlsx, PEDIDO_COMPRA.csv, bom_kicad.csv, custo.csv, custo.xlsx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]
2026-11-09 Reorganiza a pasta ELP2: projeto único, revisão A em revisoes/, material da disciplina separado
    - PROJETO_REV_B -> Projeto_Flyback (revisão vigente); PROJETO -> Projeto_Flyback/revisoes/RevA_2026-10-19
    (completa, sem os .raw/.db regeneráveis)
    - enunciados e aulas em 00_Disciplina/ (aulas e plano de ensino continuam fora do git)
    - Tarefa_03 sem acento no nome; Tarefa_01 sem os HTML/PDF intermediários
    - 04_KiCad: remendos únicos, imagens antigas e logs vazios removidos; utilitários em utils/ (caminhos ajustados)
    - PDFs finais na convenção das tarefas: RELATORIO_MATEUS_SALGADO_PROJETO.pdf e APRESENTACAO_MATEUS_SALGADO_PROJETO.pdf
    - cópias dos .raw publicados removidas do OneDrive (o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
    [BOM.csv, BOM.xlsx, Inductor Design Tool for 64bit.xlsx, PEDIDO_COMPRA.csv, bom_kicad.csv, custo.csv, custo.xlsx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]
2026-11-09 Reorganização: README da raiz, .gitignore, nome do PDF do relatório na convenção das tarefas
    [fonte_flyback_12V3A.kicad_pcb]
2026-11-09 Relatório B reescrito em formato didático e institucional
    - capa institucional (IFSC, disciplina, professor, aluno), resumo, painel de indicadores e legenda das etiquetas de origem [C]/[S]/[CAD]/[M]
    - 12 memórias de cálculo (equação, substituição, resultado e justificativa), tabela de requisitos × verificação, tabela de hipóteses, cadeia de ferramentas
    - simulação organizada por grupos de casos (tabela 14) com figuras lado a lado; layout resumido em tabela regra × verificação
    - diagrama de blocos em SVG gerado por script; HTML autossuficiente (imagens embutidas) - corrige imagens que não apareciam fora da pasta
    - numeração nova das seções refletida no README e no guia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
2026-11-09 README: comando do diagrama de blocos na regeneração do relatório
2026-11-09 Relatório: capa em Markdown puro, visual preto e cinza, contagem de casos corrigida
    - capa, identificação e indicadores escritos em Markdown (o .md abre limpo no GitHub/VS Code); o build.py monta o cartão e o painel a partir das tabelas
    - azul substituído por preto e cinzas no CSS, nas etiquetas de cálculo e no diagrama de blocos
    - resumo e KPIs: 23 casos (21 medidos + 2 pré-cargas), coerente com a tabela 14
2026-11-09 Relatório: quebra de página em todos os títulos de nível 1, nota sobre os marcadores no template, núcleo E de ferrite explícito
2026-11-09 Relatório: bloco de identificação da capa de volta em duas colunas compactas
2026-11-09 Simulação B rerodada com os modelos conferidos contra os datasheets
    - netlist: UVLO 8,4/7,6 V, RDS(on) do MOSFET na Tj prevista (0,36 Ω × 1,47), atraso do comparador 150 ns, polo de 10 kHz do PC817
    - 23 casos rerodados (lote 4), curto/hiccup/transitórios relidos, figuras regeradas
    - resultados: η 220 V 85,2 %, Vds 482 V, hiccup 163/130/20 ms (13,5 %), curto 8,0 A / 560 V, partida 7,3 s em 90 V
    - relatório, guia, slides, registro de medições e README com os números novos
2026-11-09 Relatório regerado após a última correção de números
